Alksndr55/mesh-repeater/audit/s4_12_user_refinements_20261010/README.txt

Результаты финальных проверок S4.12, выполненных в KiCad 10.0.6.
Электрические связи, координаты, измерения и SHA256 сохранены. Абсолютные
пути рабочей машины заменены относительными; путь candidate указывает
на опубликованный идентичный CAD. Историческая baseline S4.11 не входит
в этот пакет. Эти проверки CAD не подтверждают стендовые характеристики.
