Alksndr55/mesh-repeater/docs/WORKFLOW_RU.md

# Единый процесс разработки и выпуска

Ведущая разводка — **v1**. Общая схема содержит электрическую часть обоих
исполнений. Профили сохраняют разъёмы, кнопки, крепёж, распределение по платам
и межплатный интерфейс v2. Геометрия каждой PCB редактируется в её проекте KiCad.

Версии хранятся строками в `project.json`: текущие выпуски —
`v1.26` и `v2.10` от 06.11.2026, следующие номера — `v1.27` и `v2.11`.
Предыдущие опубликованные страницы GitHub: [v1.25](https://github.com/Alksndr55/mesh-repeater/releases/tag/v1.25) и
[v2.09](https://github.com/Alksndr55/mesh-repeater-2.0/releases/tag/v2.09).
Предыдущие v1.22/v2.06 соответствовали S4.22/A6. Следующий выпуск увеличивает число после точки на единицу.
Номера исполнений независимы; общий схемный граф и SHA256 связывают их по содержанию.
Существующие теги S4/A сохраняют историю.

## Изменения

1. Изменить общую схему и ведущую v1, проверить их соответствие.
2. Перенести электрическое изменение в POWER/LOGIC, сохранив UUID существующих
   компонентов. Адаптировать затронутую разводку v2.
3. Согласовать варианты сборки в моделях и нативных полях, сформировать BOM.
   Схемы исполнений сохраняют связь с PCB; синхронизация контролируется проверкой,
   а не скрытой перегенерацией принятых плат.
4. Увеличить версии затронутых исполнений в `project.json`, применить метки,
   повторить проверки и экспорт. PDF/BOM и производственные файлы привязаны к версии.

Разводку изменять по [ROUTING_RULES_RU.md](ROUTING_RULES_RU.md): сначала удалить
все GND-переходы, затем исправить дорожки и убрать дубли, после этого добавить
сетку GND 5 мм с записанными электрическими причинами для исключений.
Расстановку компонентов и критические силовые, Kelvin- и RF-цепи сохранять.

Из корня рабочей папки в PowerShell:

```powershell
$python = 'C:/Program Files/KiCad/10.0/bin/python.exe'
& $python tools/project/set_versions.py --apply
& $python tools/project/build_bom.py
& $python tools/project/verify_circuit.py --out shared/verification
& $python tools/project/release.py build
```

Параметры доступны через `--help`. `set_versions.py` изменяет только метаданные
и надписи версии, включая версию платы и связанный хеш протокола в копиях watchdog.
Без `--apply` команда показывает изменения без записи.
Для `export` и `build` нужен Python из установки KiCad с модулем `pcbnew`,
как в команде выше: он читает исходные площадки для проверки boardview.
`build_bom.py` берёт комплектацию из моделей и координаты из PCB.
`verify_circuit.py` экспортирует свежие netlist и сравнивает их с общей схемой
с учётом явных физических различий. R71 и NT2 не замыкаются ради сравнения.

`release.py` проверяет версии, ERC/DRC, общий граф, BOM, комплект watchdog и разводку,
экспортирует PDF/SVG и два boardview CAD для каждой физической платы, затем собирает
архив с контрольными суммами.
Для watchdog v1.00 проверяются исходник, HEX, версия, fuse-профиль и сохранённый
программный протокол; ISP-профиль плат — 100 мкс, LFUSE=0x73, HFUSE=0xFB.
Эта проверка не программирует устройство и не заменяет стендовые испытания.
Нарушения, неподключения и расхождения схемы с PCB
останавливают выпуск. Для SHIELD проверяется PCB, электросхема неприменима.

## Приёмка разводки

После изменения дорог проверяют целые пути и параллельные группы на обеих
сторонах платы: лишние обходы, возвраты, ступеньки, равномерность зазоров,
сигнальные и земляные дубли, местные возвраты и исключения сетки GND.
Нулевой DRC и уменьшение числа сегментов не подтверждают выполнение этих условий.

В каталоге каждой PCB хранится `routing_review.json`: результат проверки обеих
сторон, текущая версия, SHA256 точного PCB и индивидуальный журнал внесеточных
GND-переходов. Сначала применяют окончательные метки версии, затем фиксируют
результат проверки. После изменения файла старое подтверждение недействительно.
`set_versions.py` не переносит одобрение автоматически на изменённую плату.

Проверка выпуска независимо пересчитывает углы, коллинеарные наложения,
повторные переходы и позиции относительно сетки, сверяет весь журнал и
подтверждение. Эти геометрические нарушения не разрешаются записью PASS.
Полные пути и зазоры групп оцениваются отдельно; геометрическая проверка
не объявляется автоматическим доказательством эстетики или RF/EMI.
Регрессионные проверки: `python -m unittest discover -s tools/project/tests -v`.

В протоколе отдельно подтверждаются заходы на площадки и стыки трасс,
подключения к GND-полигону и фактические термобарьеры. Массив
`retained_ground_tracks` перечисляет все оставшиеся GND-дорожки с точной
геометрией и индивидуальной причиной; `solid_ground_connections` — все
явные сплошные подключения площадок и зон GND. Проверка выпуска сверяет
эти списки с PCB. Настройка thermal сама по себе не доказывает наличие
термобарьера: при визуальной приёмке включают заполненные полигоны.

## Файлы выпуска

- `v1/output/current/`, `v2/output/current/` — актуальные экспорты.
- `v1/audit/current/`, `v2/audit/current/` — проверки с хешами исходников.
- `releases/v1.26/`, `releases/v2.10/` — ZIP текущих выпусков и SHA256 после сборки.
- `history/` — ограниченный снимок до объединения, происхождение и журнал уборки.

Архив включает редактируемые проекты, нужные локальные библиотеки и модели,
общую схему, BOM, инструкции, лицензии и проверки. Gerber/Excellon создаются
отдельно по текущему CAD и требованиям выбранного заказа.

Все 3D-модели, включая используемые стандартные модели KiCad, находятся внутри
нативных проектов. Пути в PCB и используемых посадках относительные, от
`${KIPRJMOD}`. Непоставленная модель или внешний путь `${KICAD...}` блокируют
сборку архива. После распаковки модели должны разрешаться без глобальной
библиотеки 3D на компьютере получателя; исходные лицензии и атрибуция сохраняются.

По решению владельца от 06.11.2026 в каждую следующую сборку v1/v2 входят
по два boardview `.cad` каждой физической платы: MAIN, либо POWER/LOGIC/SHIELD.
Варианты — `NaIon_COLD` (натрий, основная сборка с COLD-защитой) и `LTO_2S`.
Файлы находятся в `<версия>/output/current/<плата>/Mesh_Repeater_<номер>_<плата>_<вариант>.cad`,
рядом — `<плата>_<вариант>_boardview.json` с хешами PCB, модели комплектации, CAD
и результатами проверки.
Путь `<версия>` означает каталог `v1` или `v2`, `<номер>` — например `v1.26`.

Формат — GenCAD, единицы THOU: дюймовая запись INCH некорректно отображается
в NexusBV 0.9. Сохраняются реальные координаты, стороны, повторяющиеся номера
контактов и цепи из текущей PCB. Номиналы/маркировки и признаки установки берутся
из соответствующего варианта `model.json`, сверенного с BOM в проверке выпуска.
Неустановленные детали помечаются `DNP`; их контактные площадки не удаляются.
SHIELD — общая механическая плата, поэтому его геометрия одинакова в обоих вариантах.
Объекты только паяльной пасты не становятся электрическими контактами.
Экспорт проверяется по исходной PCB; ошибка или отсутствие CAD/протокола
останавливает упаковку. При изменении экспортёра или просмотрщика дополнительно
проверяют обе стороны в программе: численная проверка не доказывает отображение.

Для просмотра: NexusBV → File → Open. Номинал виден в Info при наведении
и в карточке выбранного компонента; Top / Bottom переключают стороны.
Для перекрёстного поиска нажмите PDF в NexusBV и откройте `<плата>_schematic.pdf`
из того же каталога. Двойной щелчок по телу символа, позиционному обозначению
или имени цепи в PDF находит объект на плате. Надписи внутри символа сохраняют
собственный поиск: для выбора детали нажимайте по свободной области её тела.
PDF содержит общую схему; номиналы/FIT конкретной
химии берутся из соответствующего CAD и BOM. У механического SHIELD схемы нет.
Обновление процесса не изменяет уже опубликованные архивы и теги.

В комплект v1/v2 также входит portable NexusBV 0.9 для Windows 10/11 x64.
После полной распаковки ZIP запустите корневой `START.cmd` и выберите плату
и химию. Файлы `START_<плата>_<вариант>.cmd` открывают выбранный CAD и PDF
напрямую; у SHIELD открывается только CAD. Установка просмотрщика и KiCad
для этого не нужна. Исходные авторские readme и сведения о программе сохранены.
Программа хранится в `third_party/NexusBV/0.9`, состав зафиксирован в
`bundle_manifest.json`: размер и SHA256 каждого файла проверяются до выпуска.
В поставку не переносятся пользовательские настройки, история, базы и
неиспользуемые для GenCAD/PDF конвертеры Cadence. Все файлы программы и запуска
также входят в общий `RELEASE_MANIFEST.json`.

При экспорте схем `release_pdf.py` добавляет невидимые области выбора по геометрии
символов исходной схемы. Пины и провода в область тела не включаются. Каждый PDF
до и после сравнивается постранично при 144 dpi через PDFium из комплекта NexusBV;
изображение должно совпадать. Проверяются координаты и текст каждого обозначения.
Отчёт `<плата>_pdf_clickmap.json` привязан к хешам PDF и всех листов схемы;
без свежего успешного отчёта архив не собирается. Неизвестная геометрия или
пересечение областей останавливает экспорт. Для сборки этого комплекта требуется
Windows x64; чистая Python-зависимость pypdf поставляется с её лицензией в
`tools/project/vendor`, дополнительная установка библиотек не требуется.

Два Git-репозитория находятся непосредственно в `v1/` и `v2/`; история и адреса
сохранены. Отдельная публикационная копия v1 устранена. Публикация на GitHub —
отдельное явное действие. Обычная сборка не делает push и не размещает заказ.
Стендовые проверки питания, LC, RF, нагрева и конкретных модулей ведутся отдельно.
