Alksndr55/mesh-repeater/design/Meshcore_NaIon/3dmodels/README_RU.txt

АКТУАЛЬНО ДЛЯ S4.15 — 11.10.2026
Добавлена ориентировочная модель TDK_B57861S_Vertical_Approx.step для TH1.
Тело NTC диаметром до 2,41 мм и длиной до 6,5 мм находится внутри SH1.
Высота над платой — до 12,5 мм, внутренняя высота крышки — 14 мм.
Формованные гибкие выводы: шаг площадок 2,54 мм; не менее 4,5 мм прямого
вывода от тела до первого изгиба; радиус изгиба не менее 0,75 мм.
Нижние изгибы модели упрощены; STEP не служит шаблоном формовки выводов.
Проверить высоту и механическую фиксацию реального датчика перед сборкой.
Устанавливать один датчик: на плату ИЛИ выносной на проводах в те же площадки.
Общий отчёт: output/S4_15_COLD_CHARGE_RU.html.

ИСТОРИЯ МОДЕЛЕЙ (сведения о числе деталей ниже относятся к старым ревизиям)
АКТУАЛЬНО ДЛЯ S4.5
В S4.5 добавлены четыре резервных места C52–C55 с библиотечными моделями
1206. Эти позиции DNP: в основной сборке не устанавливаются. Актуальный
вид с пустыми резервами: output/pcb/S4_5_3D_components.png. Всего 110
привязок моделей, включая четыре необязательных конденсатора.
Отчёт: output/S4_5_RESERVE_AND_SCHEMATIC_RU.html.

СВЕДЕНИЯ О ПРЕДЫДУЩЕЙ РЕДАКЦИИ S4.4
Модели, созданные для S4.3, сохранены в S4.4 без изменения корпусов
и положения компонентов. В S4.4 исправлены BUSY/GPS_EN и надписи.
Новые виды: output/pcb/S4_4_3D_components.png, S4_4_3D_frame.png,
S4_4_3D_covered.png. STEP-сборки: output/3d/Meshcore_S4_4_components.step
и Meshcore_S4_4_covered.step. Отчёт: output/S4_4_FAKETEC_COMPATIBILITY_RU.html.
Пути указаны относительно корня рабочей папки Meshcore.

Ниже сохранено описание создания моделей в S4.3 и их допущений.

MESHCORE S4.3 — МОДЕЛИ СОБРАННОЙ ПЛАТЫ
09.10.2026

Созданы и подключены 12 файлов STEP. Модели есть у всех 103 позиций,
имеющих физический корпус. Всего 106 подключений моделей: у держателя
есть батарейка, у J11 — съёмный шунт, у экрана — отдельная крышка.
Отверстия H1–H4 и шесть плоских тестовых площадок дополнительных
корпусов не требуют: они уже отображаются как геометрия самой платы.

Добавлены Nice!Nano-клон, HT-RA62, L1–L4, TPS63802, R40/R41, SW1/SW2,
рама и крышка экрана. Также добавлены CR2032 и шунт J11.
Модели находятся в design/Meshcore_NaIon/3dmodels; ссылки относительные
через KIPRJMOD. Стандартные детали используют установленную библиотеку
KiCad 10. Сохраняйте и переносите папку проекта целиком.

ОТКРЫТИЕ
Откройте актуальную Meshcore_NaIon.kicad_pcb и нажмите Alt+3.
Если она уже была открыта, загрузите файл с диска заново.
По умолчанию рама видна, крышка скрыта. Для показа крышки откройте
свойства SH1 → 3D-модели и включите Shield_Lid_76x43.step.
Для просмотра силовых компонентов можно скрыть обе модели SH1.

ТОЧНОСТЬ И ДОПУЩЕНИЯ
Это упрощённые инженерные модели для визуализации, не сертифицированные
модели производителей. Размеры стандартных недостающих корпусов взяты
из чертежей; мелкие скругления, маркировка и внутренняя конструкция
упрощены. Имеющиеся типовые библиотечные модели также не подтверждают
точную геометрию каждого закупаемого MPN.

Nice!Nano: использован похожий клон ICBbuy 17,78 × 33 мм с 26 выводами.
Точный модуль по ссылке Ozon не измерен. Приняты толщина PCB 1 мм,
высота нижней стороны модуля над основной платой 6,5 мм и условная
геометрия разъёмов. В этой модели USB направлен к краю, но его передняя
плоскость примерно на 1 мм внутри контура основной платы. Доступ кабеля
и размер отверстия корпуса требуют проверки на вашем модуле.

HT-RA62: подтверждены PCB 16 × 17 × 0,8 мм и шаг выводов 2 мм.
Высоты и положение установленных деталей/IPEX приблизительны, взяты
по изображению производителя. Собственного металлического экрана нет.

Экран: проектная рама с расстояниями между средними линиями стенок
76 × 43 мм, стенка 0,2 мм, наружный размер 76,2 × 43,2 мм.
Нижняя поверхность крышки находится на высоте 14 мм; крышка 0,2 мм.
Фиксаторы и технологические допуски пока не разработаны.

Батарейка CR2032 показана плюсом вверх, нижняя плоскость на Z=1,2 мм.
Посадка выбрана по геометрии библиотечного держателя: над пластиковым
дном остаётся 0,1 мм. Небольшое пересечение с недеформированными
пружинными контактами допустимо для этого условного вида. Размер
посадки из даташита не подтверждён. Шунт J11 условный, с открытым верхом.
J11 показана установленной для питания от батареи/солнца. Снять ДО USB.

ПРОВЕРКИ
Все 12 сгенерированных STEP повторно открыты и проверены на корректность
геометрии. Все ссылки на 3D-модели разрешаются. Сравнение CAD до и после
подтвердило совпадение дорожек, переходных отверстий, площадок, цепей,
положений компонентов, контура, надписей и заливок. Кроме узлов model,
содержимое платы не менялось. Изменение контрольной суммы связано с 3D.
Это дополнение не закрывает оставшиеся испытания и замечания аудита.

ФАЙЛЫ
Актуальная плата: design/Meshcore_NaIon/Meshcore_NaIon.kicad_pcb
Модели: design/Meshcore_NaIon/3dmodels/
Вид без экрана: output/pcb/S4_3_3D_components.png
Вид с рамой без крышки: output/pcb/S4_3_3D_frame.png
Вид с экраном: output/pcb/S4_3_3D_covered.png
STEP без экрана: output/3d/Meshcore_S4_3_components.step
STEP с экраном: output/3d/Meshcore_S4_3_covered.step
Подробные источники и допущения: design/Meshcore_NaIon/3dmodels/manifest.json
Доказательства проверки: audit/s4_3_3d_20261009/

SHA256 актуальной платы: c08b333a8556d93baddc21c304ab620b61b488c69631327ef87d604eef049b0f
