Alksndr55/mesh-repeater/docs/LIMITATIONS_RU.md

# Ограничения Mesh Repeater v1.25 / v2.09

Редакция 30.10.2026 для текущих локальных выпусков. Общая электрическая схема находится в
[`shared/schematic`](../shared/schematic/MeshRepeater.kicad_pro); ведущая схема и
разводка - v1. Различия корпусов, крепежа и межплатных соединений заданы в
[`shared/variants.json`](../shared/variants.json). Номиналы и порядок сборки:
[`ASSEMBLY_COMMON_RU.md`](ASSEMBLY_COMMON_RU.md).

Этот документ сохраняет аппаратные ограничения при объединении документации.
Он не сообщает о новых испытаниях. ERC, DRC и сравнение схем подтверждают только
проверенные CAD-файлы с их SHA-256. Устойчивость питания, восстановление после
разряда, температурные режимы, реальные разъёмы, RF/EMI и конкретные модули
требуют проверки собранного образца. Приёмка ограничений не означает их устранение.

## Питание, заряд и аккумуляторы

| Узел | Сохранённое состояние и граница подтверждения |
|---|---|
| CN3722 | R3/R4: 60,4/100 кОм для Na-ion, 118/100 кОм для LTO, 1%. Типовые CV 3,878/5,273 В; верхние расчётные оценки 3,982/5,452 В при принятых допусках CN3722, резисторах 1%, ТКС ±100 ppm/°C и ΔT=65°C. Это установившийся режим; выбросы, старение и отказы в эти оценки не входят. |
| LTO и TPS63802 | Рабочий верхний предел входа TPS63802 - 5,5 В. Независимой OVP нет. Работа LTO без батареи, при её горячем отключении и снятии нагрузки не квалифицирована; расчёт делителя CN3722 не гарантирует ограничение всех этих режимов. |
| Балансиры LTO | LMV431A с R47/R51=2 Ом сохранены. Допустимый ток LMV431A не гарантирован на всех углах напряжений, допусков и температуры. Усилитель балансира и независимая защита ячеек не добавлены. При равномерном заряде до нового CV оба балансира не обязаны включаться; их работа при перекосе требует проверки. |
| Разряд и EN | EN измеряет BAT до R71 и напряжение всего пакета. Типовые пары OFF/ON: около 1,806/1,986 В для Na-ion и 3,606/3,966 В для LTO. Это номиналы, а не гарантированные пределы при 1%. Общий порог LTO не защищает каждую ячейку независимо. |
| Возврат после разряда | R71 снижает BAT_SYS на входе преобразователя; ESR аккумулятора/проводов влияет также на BAT и EN. Однократный пуск с заряженными и разряженными LC-банками, TX/GPS-нагрузкой и холодной батареей не доказан. Возможность циклов EN/UVLO проверяют по фактическим ячейкам, их ESR и пусковому току. |
| Солнечная панель | R7/R8=100/10 кОм, типовая настройка MPPT около 11,44 В при 25°C. Обозначение «панель 12 В» не задаёт её холодный Voc, Vmp и выбросы. Нужны паспорт конкретной панели, проверка полярности и допустимых напряжений входного узла. |
| COLD | Схема снижения тока сохранена. NTC на плате измеряет местную температуру; она может отличаться от температуры ячейки. Нужны фактические пороги, токи и разрешённые изготовителем аккумулятора условия заряда. Один TH1 на плате либо один выносной датчик, а не два параллельных NTC. |

J8 и J12 имеют общую BAT; они не являются двумя независимыми входами батарей.
Фактические пределы заряда/разряда, токи, разбаланс и температуры выбирают по
паспорту конкретных ячеек. Сохранённая схема LTO не является полноценной BMS.

## USB и распределение питания

J11 - единственное съёмное соединение FILTER_OUT с нагрузками. Снять шунт
**до подключения USB**, вернуть **после отключения USB**. Автоматического
переключения источников нет. Клон Nice!Nano должен быть доработан для прямого
питания 3V3/VCC, с отключённой штатной USB-зарядкой; основной аккумулятор к его
RAW/BAT не подключают. Название клона в BOM само по себе не подтверждает доработку.

При снятой J11 USB питает SYS, INA219 и модем через медную звезду NT2; это полная
нагрузка устройства, включая возможные TX/GPS. Выход преобразователя изолирован,
но его вход остаётся связан с зарядником через BAT_SYS. Требуются проверка
реального USB/LDO клона, обратных токов, нагрева, токового бюджета и напряжений
MCU/модема. CR2032 при отсутствии основного питания и USB резервирует только RTC.

Раздельные ветви SYS_3V3 и RADIO_3V3, FB1 и локальные C23/C24 являются мерами
развязки, а не гарантией отсутствия общей просадки. Проверять одновременно VCC
MCU и модема при TX, GPS и USB. Рабочий возврат в v2 обеспечивают земляные контакты
J101/J201; работоспособность не должна зависеть от проводимости стоек.

## LC-фильтр, измерения и программная часть

- C15/C16: по одному Panasonic EEEFK1E471P, 470 мкФ / 25 В / ±20%.
  Начальный минимум по допуску при 20°C - 376 мкФ. Это не гарантирует такую
  ёмкость на морозе или после старения. Паспортный импеданс 80 мОм при 100 кГц
  не равен точному ESR. R40/R41=22 мОм остаются в конденсаторных ветвях.
  Пуск, PFM/PWM, импульсы TX, звон, холодный ESR, нагрев и EMI требуют измерений.
- BAT_ADC: R27/R28=2,2 МОм, C25=100 нФ, деление 1:2, номинальная τ≈0,11 с.
  Нужны время установления, оценка утечек/входа ADC и калибровка конкретного клона;
  у v2 дополнительно влияет падение GND межплатных контактов. Требование 1%
  заменило прежние 0,1%; старые оценки точности ADC/EN/балансиров не являются
  гарантированными пределами текущей схемы.
- INA219AIDR имеет адрес 0x40 и питается от SYS после J11, включая USB-режим.
  Паспортная оценка непрерывного потребления - около 0,7 мА типично, до 1 мА;
  это дополнительная постоянная нагрузка. Управление его питанием и программный
  режим экономии этим аппаратным проектом не подтверждены.
- R71=0,1 Ом ±1%, 1 Вт, 2512, RL2512FK-070R1L выбран для штатной калибровки.
  При 0,8 А расчётные падение/мощность - 80 мВ/64 мВт; при принятой оценке
  1,25 А - 125 мВ/156 мВт. ТКС выбранного шунта ±600 ppm/°C, пайка и Kelvin-отводы
  влияют на точность. Диапазон INA ±320 мВ соответствует примерно ±3,2 А;
  длительные 4 А дали бы 1,6 Вт и не квалифицированы для этого шунта.
- IN+ измеряет BAT_SYS через R72, IN− - BAT через R73: заряд положительный,
  разряд отрицательный. Регистр мощности не даёт подписанную мощность
  заряда/разряда. Балансиры LTO, делитель EN и BAT_ADC подключены до R71;
  INA219 не измеряет полный расход отдельных ячеек и все малые утечки.
  Калибровку и отображение конкретной прошивки проверяют на образце.
- Watchdog ATtiny13A v1.00 считает 1350 периодов настройки WDT «8 s»;
  по типовым графикам при 3,3 В и комнатной температуре это около 3,53 ч,
  импульс настройки «1 s» — около 1,18 с. Сохранён согласованный допуск
  3 ч ±30%; эти ориентиры не являются измерением или гарантией генератора.
  Новый TXEN перезапускает счётчик и фазу WDT; постоянный HIGH без новых
  изменений входа не продлевает отсчёт. Исправлена потеря события после
  отпускания сброса. Штатное молчание MeshCore также может вызвать сброс.
  LFUSE=0x73/HFUSE=0xFB включает постоянный BOD 2,7 В, в том числе во сне;
  он контролирует SYS_3V3 и сбрасывает ATtiny, отпуская PB0, а не удерживая MCU
  в reset. Входной RC-конденсатор 10 нФ из отдельного проекта не установлен;
  C33 — развязка питания. Программный протокол 19/19 относится к совпадающим
  исходнику и HEX, но не подтверждает реальные короткие TXEN, времена,
  восстановление MCU/модема, пуск, просадки и ток сна. WDT работает в режиме
  прерываний и не гарантирует восстановление самого зависшего ATtiny.
- Для GPS сохраняется порядок платы: J4.6=SYS_3V3 для резерва,
  J4.7=управляемое GPS_3V3; RX/TX и направление нумерации сверять по схеме.
  Это не подтверждение распиновки любого аксессуара T114: необходимы точный GPS,
  кабель, ответный PicoBlade и проверка обоих питающих контактов 6/7.
- FL1=S869M000S003 - опция 868–870 МГц с ограничением TX≤+13 dBm; штатно DNP,
  NT1 целая. Установка требует разрезания NT1, проверки обхода и измерения потерь.
  Диапазон HT-RA62, антенна и прошивка должны соответствовать друг другу.
  NT2 - другая, постоянная медная звезда питания; её не разрезают.
- Точная диапазонная версия HT-RA62 и MPN C58/C59=47 нФ X7R 16 В остаются
  не выбранными в исходных полях. Требования к сопротивлению, допуску, ТКС,
  мощности и корпусу нельзя заменять старой ценой или неподтверждённым остатком.

## Механические ограничения v2

Эти условия относятся к POWER/LOGIC/SHIELD, а не к одноплатной v1.

- Рабочие платы и экран - 90×60 мм; LOGIC повёрнута компонентами вниз.
  J201 имеет зеркальную сетку для сопряжения 1:1. Обычная незеркальная розетка
  не является её взаимозаменяемой заменой.
- Выбраны E-SIMPO L35mm A3C6 и MTJ H8.5 2×6P, шаг 2,54 мм. Номинальный ввод
  штырей - 4,48 мм. Сечение/покрытие штыря, допуски розетки и рабочая глубина
  сопряжения требуют контроля купленных деталей. Расчётный бюджет 0,5 А не
  является измеренным профилем; каждый основной контакт должен выдерживать
  соответствующий ток. Рейтинг 3 А одной розетки и параллельные контакты не
  квалифицируют соединение целиком.
- Окно экрана под общую пластиковую планку - 17,2×6,8 мм, R0,6;
  минимальный проектный отступ меди - 0,50 мм. Максимальный габарит реального
  пластика документально не подтверждён. Проверить проход, прямолинейность
  штырей и изоляцию от фольги; не стягивать несовпадающие платы винтами.
- Номинальная цепочка: стойки 18/15 мм, металлические шайбы DIN 433
  3,2×6×0,5 мм; в исходном согласованном стеке 20 шайб. Внутренние промежутки
  18,5/16,0 мм, между рабочими поверхностями 36,02 мм, между наружными
  поверхностями рабочих PCB 39,06 мм без головки винта и нижней гайки.
  Глубина резьбы верхней стойки и часть размеров нижней требуют входного
  контроля: зацепление верхнего соединения ≥3 мм, полное зацепление нижней
  гайки и отсутствие упора в дно резьбы проверяют на фактическом крепеже.
- Для электролитов высотой 10,2 мм требуется 12,8 мм с допусками и местом над
  клапаном; при доступных 18,5 мм номинальный запас 5,7 мм. Для сформованного
  TH1 высотой ≤12,5 мм нижний запас 6,0 мм. Это расчёт номинальных размеров;
  реальная посадка, клапан, пайка, модули и доступ к USB/шунту проверяются на образце.
  У v1 собственный корпус также должен обеспечивать место над электролитами.
- SHIELD имеет медь F.Cu к POWER и единую GND-плоскость вокруг окна;
  буквы в стеклотекстолите не вырезают. SH1 и прежняя крышка отсутствуют.
  Измеренная эквивалентность экранирования после удаления стенок не заявляется.
  J10 сохраняет прежнюю позицию; обслуживание ISP после разборки принято намеренно.

## Какие доказательства относятся к текущей версии

Для нового выпуска используются только свежие ERC/DRC/паритет и отчёт сравнения
общей схемы с соответствующими хешами исходников. Нулевые пересечения старых
сборочных STEP A3/A4 не доказывают геометрию нынешних электролитов. В исторических
STEP фиксировались предупреждения self-interference меди; STEP не заменяет
проверку электрических соединений по native KiCad. Исторические pass-счётчики,
количество деталей и результаты старых ревизий сюда не перенесены.

Старые отчёты сохранены как история в Git/резервном снимке перед объединением;
они не являются протоколами нынешних измерений. Включение, холод, переходные
процессы, RF/EMI, фактическое сопряжение и автономное восстановление считаются
неподтверждёнными до отдельного протокола испытаний конкретной сборки.
