Alksndr55/mesh-repeater/docs/ROUTING_RULES_RU.md

# Правила дорожек и земляных переходов

Приняты владельцем 29 октября 2026 для v1 и v2. Ведущая разводка — v1.
Рабочая основа — текущие нативные платы Meshcore. Перед изменением сохраняются
исходные файлы и контрольные суммы; отдельные локальные правки владелец исключил
из текущего задания.

Порядок обязателен:

1. Удалить все GND-переходы, сохранить промежуточный PCB и подтвердить нулевой счётчик.
2. Обработать дорожки при свободном от земляных переходов пространстве.
   Применять прямые участки и направления 0/45/90 градусов. Убирать лишние
   ступеньки, возвраты, короткие изломы и лишнее дробление связной трассы.
   Параллельные участки одной группы вести с равномерным зазором по правилам
   платы; учитывать неизбежные сужения у выводов и геометрию площадок.
3. Устранить дубли, наложенные коллинеарные сегменты и лишние параллельные
   пути как сигналов, так и GND. Убирать потерявшие назначение подводы к
   удалённым переходам. Целенаправленные силовые пути и локальные возвратные
   токи оцениваются отдельно: сплошная земля не отменяет требований к ним.
4. Перезалить полигоны и разместить GND-переходы по сетке **5×5 мм** с началом
   в координатах **0,0 платы**. Точка сетки используется, если переход допустим
   по зазорам и связывает нужную медь. Недопустимая точка пропускается.
5. Сдвиг от сетки разрешён только по электрической необходимости: подключение
   изолированного участка, короткий возврат быстрого узла, RF-ограждение или
   близкий возврат развязывающего конденсатора. Для каждого такого перехода
   фиксируются координаты, назначение и причина. Простое совпадение со старой
   позицией причиной не является.

Сохраняются расстановка, стороны и повороты деталей, UUID, площадки, контур,
отверстия, маркировка, маска, ширины силовых трасс и действующие правила.
Сохраняются RF CPW и его зазор, Kelvin-подводы R71/R72/R73, обход NT1,
звезда NT2 и раздельные SYS/RADIO, короткие коммутационные контуры преобразователей.
Компоненты не перемещаются ради облегчения маршрутизации.

Приёмка: свежий DRC с перезаливкой, всеми ошибками дорожек и сопоставлением
со схемой; ноль нарушений, неподключений, расхождений и скрытых проверок.
Дополнительно проверяются геометрия и дубли, сетка и её исключения, сохранность
деталей и графики, общая схема, BOM и состав watchdog. Проверка углов допускает
только округление до 1 нм в координатах KiCad. Изображения меди до и после
сохраняются вместе с отчётом.

SHIELD остаётся однослойным экраном без электронной разводки и без новых GND-vias.
Его механика и итоговый DRC также проверяются.

Полные параллельные группы проверяются по перпендикулярному зазору с учётом
ширины дорожек, включая повороты. Короткие выводы от фиксированных площадок
и обходы реальных препятствий фиксируются отдельно от регулярной магистрали.

При сведении дублирующих соседних силовых подводов к одной площадке в один
не уменьшается их суммарное сечение; основные силовые магистрали не сужаются.
Точки и геометрия измерительных Kelvin-подводов сохраняются независимо.

В модели земли учитываются реальные контакты полигон–полигон разных GND-зон.
Причина «соединение островка» проверяется нативной связностью и, где необходимо,
удалением перехода с повторным DRC. Один только транзитивный GetConnected или
пропуск пересечений полигонов не доказывает наличие островка.

Проверяются не только направления отдельных сегментов, но и угол их стыка:
две дорожки с направлениями 0/45/90 могут образовывать острый разворот.
Заходы на площадки делают прямыми и понятными; удаляют короткие возвраты,
выступы за точкой подключения и несколько перекрывающихся подходов.

Обычные GND-контакты подключают к полигону через термобарьеры. Проверяют
фактическую заполненную медь: дорожка поверх зазора может шунтировать
термобарьер даже при правильной настройке зоны. Сплошные подключения RF,
механического экрана или критического силового возврата обосновывают отдельно
для каждой площадки/зоны. Общая пометка «локальный возврат» не является
достаточным обоснованием всех земляных дорожек.

Каждая сохранённая GND-дорожка и каждое явно сплошное подключение записываются
в `routing_review.json` с UUID и индивидуальной причиной. Перед принятием
проверяют контакты площадка–полигон, отсутствие лишних обходов, фактические
термобарьеры и непрерывность необходимых возвратов после перезаливки.
