Alksndr55/mesh-repeater/output/pcb/S4_16_shield_detail.png

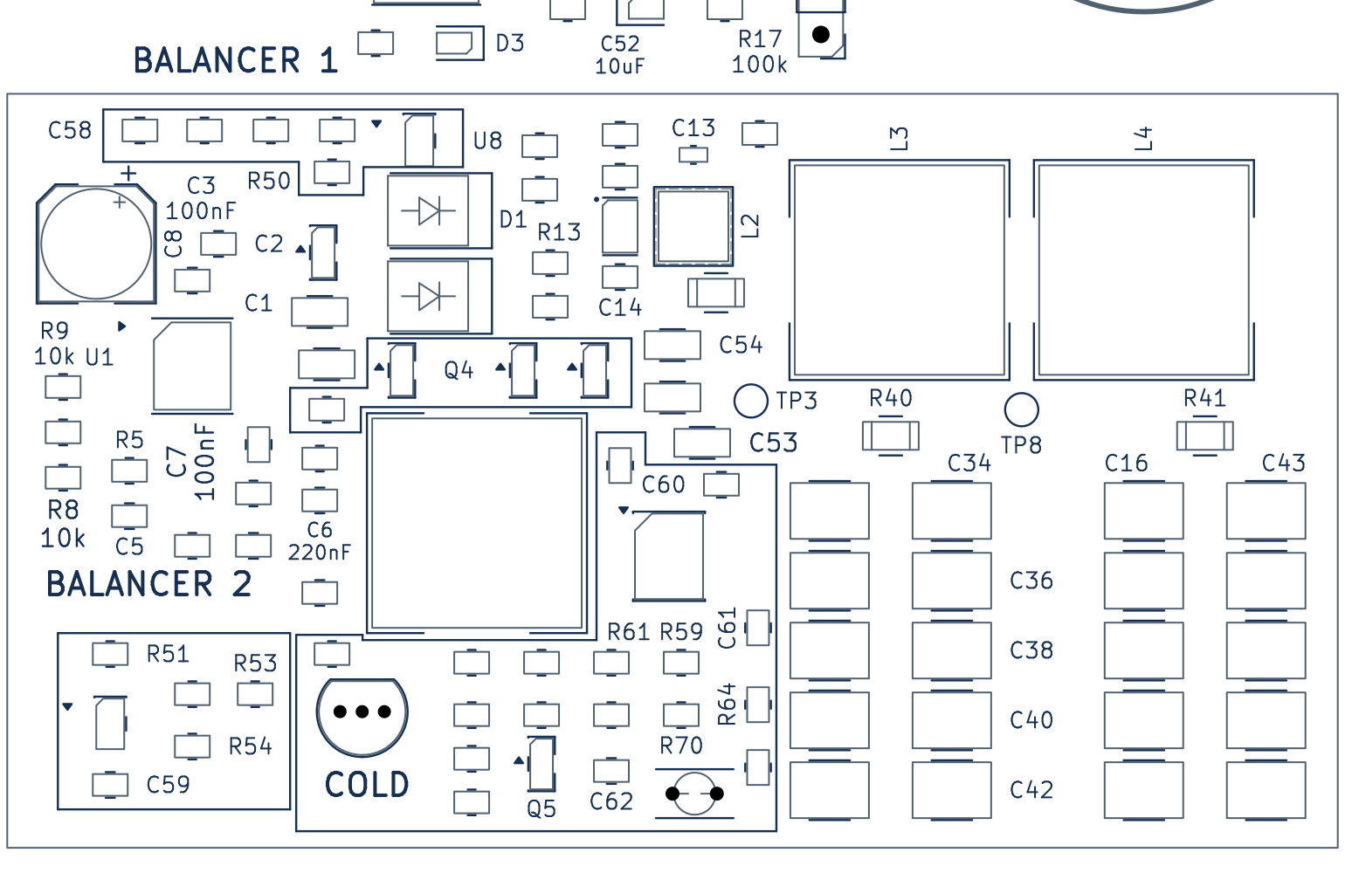
output/pcb/S4_16_shield_detail.png
