Alksndr55/mesh-repeater/output/pcb/S4_16_top_copper.png

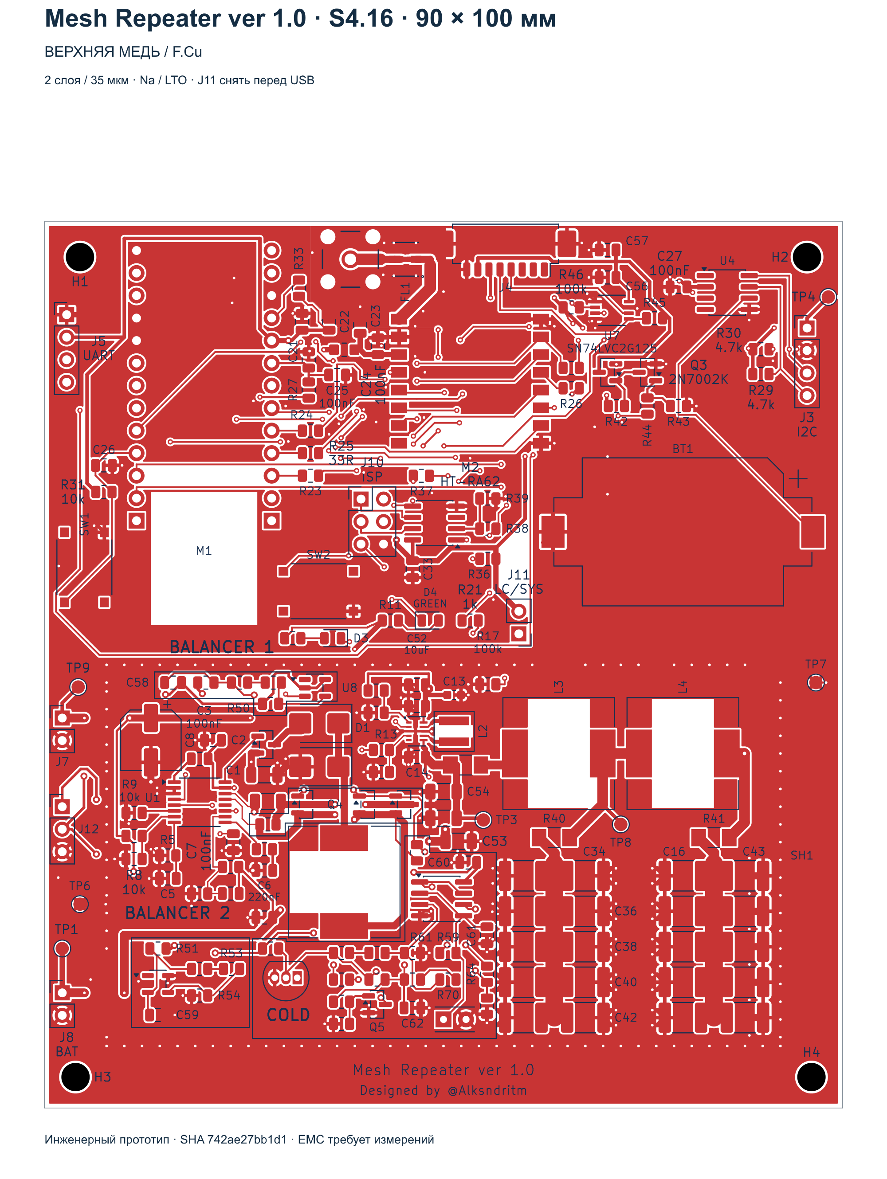
output/pcb/S4_16_top_copper.png
