Alksndr55/mesh-repeater/docs/S4_21_REZONIT_ORDER_RU.txt

Mesh Repeater ver 1.0 — PCB S4.21
Данные для заказа голых плат в «Резонит», 18.10.2026

Загружать файл: Mesh_Repeater_S4_21_Rezonit_Gerber.zip.
Внутри только 9 файлов в корне, без вложенных папок:
  F.Cu / GTL — верхняя медь
  B.Cu / GBL — нижняя медь
  F.Mask / GTS — верхняя паяльная маска
  B.Mask / GBS — нижняя паяльная маска
  F.SilkS / GTO — верхняя маркировка
  B.SilkS / GBO — нижняя маркировка
  Edge.Cuts / GKO — замкнутый контур платы
  PTH.drl — металлизированные отверстия
  NPTH.drl — неметаллизированные отверстия

Формат Gerber: RS-274X. Сверловка: Excellon, миллиметры, десятичный формат.
Оба экспорта используют общий абсолютный ноль (0;0), без зеркалирования Y.
Нижние производственные слои отдельно зеркалировать не нужно.
В заказ не загружать PDF, проект KiCad, чертежи, изображения или Gerber Job.

Ранее согласованные параметры заказа:
  Количество: 5 шт.
  Размер одной платы: 90 x 100 мм, прямоугольник.
  Проводящих слоёв: 2.
  Материал и стандартная готовая толщина: FR4, 1,5 мм.
  Медь: 35 мкм с каждой стороны.
  Паяльная маска и маркировка: с обеих сторон.
  Изготовление: только платы, без монтажа компонентов и трафарета.
  Контур: одиночная плата, без пользовательской панели и V-cut.
  Цвет маски/маркировки и покрытие площадок: выбрать при оформлении заказа.

Исходная плата SHA-256:
  be14cae202912ebb00e5dc758b2eae04cbe6733d4cb73df00044fdb03670fab3
Gerber ZIP SHA-256:
  66ff10019797c06d933701a87469de96b19dc2ca4b960956b7c474ea98466e93

SH1 и TP6 отсутствуют по согласованной редакции S4.21.
Gerber S4.20 и более старые файлы не использовать для этой платы.
Архив сформирован из сохранённого проекта; проект экспортером не изменён.
Заказ и оплата в личном кабинете этим выпуском не выполняются.

Инструкция производителя (проверена в Firefox 18.10.2026):
https://www.rezonit.ru/directory/v-pomoshch-konstruktoru/instrukcii-po-eksportu-gerber-dannyh/eksport-iz-kicad/

Проверки ERC/DRC и геометрии CAM не заменяют измерения прототипа под
нагрузкой, проверку аккумулятора, теплового режима и EMI.

Лицензия и разрешение на изготовление:
Собственные материалы проекта: CC BY-NC-SA 4.0. Правообладатель дополнительно
разрешает заказ и платное изготовление этих плат для личной некоммерческой
сборки, включая оплату услуг изготовителя и передачу заказных плат заказчику.
Коммерческий выпуск и продажа плат, наборов или готовых устройств с использованием наших
лицензируемых материалов — только с предварительного письменного разрешения
Alksndr55. Сторонние лицензии сохраняются. Полный охват и условия: ../LICENSE.md
https://github.com/Alksndr55/mesh-repeater/blob/main/LICENSE.md
Производственный ZIP остаётся прежним: только 9 файлов, без добавления лицензий.
