Alksndr55/mesh-repeater/bom/shopping.csv

Reference | Value_NaIon | Value_LTO_2S | Fit_NaIon | Fit_LTO_2S | MPN_NaIon | MPN_LTO_2S | Value_NaIon_NoCold | Fit_NaIon_NoCold | MPN_NaIon_NoCold | Footprint | Assembly | Vendor_URL | Package | PreferredSource | ProcurementNote
U1 | CN3722 | CN3722 | yes | yes | CN3722 | CN3722 | CN3722 | yes | CN3722 | Meshcore:TSSOP-16_4.4x5mm_P0.65mm | Na-ion: FIT; LTO 2S: FIT |  | TSSOP-16_4.4x5mm_P0.65mm | Supplier not selected; stock not refreshed
Q1 | AO3401A | AO3401A | yes | yes | AO3401A | AO3401A | AO3401A | yes | AO3401A | Meshcore:SOT-23 | Na-ion: FIT; LTO 2S: FIT | https://www.danomsk.ru/shop/4-tranzistory/126-tranzistory-importnye/168774-ao3401a-sot23-p-kanal-30v-4a-1-4vt-a-o/ | SOT-23 | Danomsk | Only AOS-qualified part, not an unreviewed same-name substitute. Cold panel Voc<=24V. Danomsk S4.6 approved substitution. Выбрана именно карточка AOS/A&O, соответствующая исходной детали.
D1 | SS24 | SS24 | yes | yes | SS24 | SS24 | SS24 | yes | SS24 | Meshcore:D_SMB | Na-ion: FIT; LTO 2S: FIT | https://www.danomsk.ru/shop/3-diody-i-tiristory/451-diody-shottki/113168-ss24-smb-do-214aa-diod-shottki-40v-2-a-0-7v-mic/ | D_SMB | Danomsk | Series reverse blocking diode Danomsk S4.6 approved substitution. Доступный местный Schottky 40 В / 2 А. Отличие SMB от текущего SMA не препятствует будущей замене с переразводкой.
D2 | SS24 | SS24 | yes | yes | SS24 | SS24 | SS24 | yes | SS24 | Meshcore:D_SMB | Na-ion: FIT; LTO 2S: FIT | https://www.danomsk.ru/shop/3-diody-i-tiristory/451-diody-shottki/113168-ss24-smb-do-214aa-diod-shottki-40v-2-a-0-7v-mic/ | D_SMB | Danomsk | Danomsk S4.6 approved substitution. Доступный местный Schottky 40 В / 2 А. Отличие SMB от текущего SMA не препятствует будущей замене с переразводкой.
L1 | 100uH | 100uH | yes | yes | CDRH127/LDNP-101MC | CDRH127/LDNP-101MC | 100uH | yes | CDRH127/LDNP-101MC | Meshcore:L_Sumida_CDRH127_LDNP_101MC | Na-ion: FIT; LTO 2S: FIT | https://www.danomsk.ru/shop/8-ustanovochnye/97-induktivnye-komponenty/281-drosseli-induktivnosti/138307-cdrh127-ldnp-101mc-100-mkgn-20-2-1-a-sumida/ | L_Sumida_CDRH127_LDNP_101MC | Danomsk | Sumida CDRH127/LDNP-101MC, shielded100uH +/-20%. Maximum body12.3x12.3x8mm. DCRmax151mohm; table Isat2.1A at25% inductance drop. Verify temperature rise under shield. Approved Danomsk S4.6 substitution.
R1 | 0.28R 1% | 0.28R 1% | yes | yes | PT1206FR-7W0R28L | PT1206FR-7W0R28L | 0.28R 1% | yes | PT1206FR-7W0R28L | Meshcore:R_1206_3216Metric | Na-ion: FIT; LTO 2S: FIT |  | R_1206_3216Metric | Supplier not selected; stock not refreshed | Base 0.28 ohm 1% 0.5W current shunt, unchanged for both batteries. Thermal option adds R56 upstream. CN3722 CSP senses upstream of R56, BAT downstream of R1; Kelvin connections. Cold ~96mA; warm ~665mA with three parallel AO3401A; bypass/no thermal nominal 714mA.
C1 | 10uF 50V X7R | 10uF 50V X7R | yes | yes | CL31B106KBHNNNE | CL31B106KBHNNNE | 10uF 50V X7R | yes | CL31B106KBHNNNE | Meshcore:C_1206_3216Metric | Na-ion: FIT; LTO 2S: FIT | https://www.danomsk.ru/shop/5-kondensatory/89-kondensatory-keramicheskie/733-kondensatory-smd-1206/202927-chip-kond-1206-x7r-10uf-10-50v-cl31b106kbhnnne-cc120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 | C_1206_3216Metric | Danomsk | Danomsk S4.6 approved substitution. Точный текущий MPN найден в местном каталоге; входной керамический конденсатор SOLAR.
C2 | 100nF 50V X7R | 100nF 50V X7R | yes | yes | CL21B104KBCNNNC | CL21B104KBCNNNC | 100nF 50V X7R | yes | CL21B104KBCNNNC | Meshcore:C_0805_2012Metric | Na-ion: FIT; LTO 2S: FIT | https://www.danomsk.ru/shop/5-kondensatory/89-kondensatory-keramicheskie/732-kondensatory-smd-0805/196705-chip-kond-0805-x7r-0-10uf-10-50v-cl21b104kbcnnnc-cc0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 | C_0805_2012Metric | Danomsk | Danomsk S4.6 approved substitution. Точный текущий MPN. C3 остаётся между SOLAR и VG; C25 остаётся в фильтре BAT_ADC.
C3 | 100nF 50V X7R | 100nF 50V X7R | yes | yes | CL21B104KBCNNNC | CL21B104KBCNNNC | 100nF 50V X7R | yes | CL21B104KBCNNNC | Meshcore:C_0805_2012Metric | Na-ion: FIT; LTO 2S: FIT | https://www.danomsk.ru/shop/5-kondensatory/89-kondensatory-keramicheskie/732-kondensatory-smd-0805/196705-chip-kond-0805-x7r-0-10uf-10-50v-cl21b104kbcnnnc-cc0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 | C_0805_2012Metric | Danomsk | VG capacitor returns to VCC, not ground Danomsk S4.6 approved substitution. Точный текущий MPN. C3 остаётся между SOLAR и VG; C25 остаётся в фильтре BAT_ADC.
C4 | 22uF 25V X5R | 22uF 25V X5R | yes | yes | CL21A226MAQNNNE | CL21A226MAQNNNE | 22uF 25V X5R | yes | CL21A226MAQNNNE | Meshcore:C_0805_2012Metric | Na-ion: FIT; LTO 2S: FIT | https://www.danomsk.ru/shop/5-kondensatory/89-kondensatory-keramicheskie/732-kondensatory-smd-0805/196759-chip-kond-0805-x5r-22uf-10-25v-cl21a226maqnnne-cc080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 | C_0805_2012Metric | Danomsk | Danomsk S4.6 approved substitution. Местный кандидат с достаточным типовым запасом: C14 при3,3V около14,90µF, инженерная оценка10,13µF против7µF минимума TPS63802. C4 при4,0V типично12,97µF, оценка8,82µF. Необходимы измерение и согласование снижения верхней температуры.
R3 | 61.9k 0.1% <=25ppm/C | 121k 0.1% <=25ppm/C | yes | yes | RT0805BRD0761K9L | RT0805BRD07121KL | 61.9k 0.1% <=25ppm/C | yes | RT0805BRD0761K9L | Meshcore:R_0805_2012Metric | Na-ion: FIT; LTO 2S: FIT | https://www.digikey.com/en/products/detail/yageo/RT0805BRD0761K9L/1075991 | R_0805_2012Metric | Yageo / distributor | High-impedance CN3722 CV divider. Na-ion: 61.9k; LTO 2S: 121k. Use 0.1%, <=25ppm/C.
R4 | 100k 0.1% <=25ppm/C | 100k 0.1% <=25ppm/C | yes | yes | RT0805BRD07100KL | RT0805BRD07100KL | 100k 0.1% <=25ppm/C | yes | RT0805BRD07100KL | Meshcore:R_0805_2012Metric | Na-ion: FIT; LTO 2S: FIT | https://www.chipdip.ru/product/0.125vt-0805-100-kom-0.1-rt0805brd07100kl-chip-yageo-9000237585 | R_0805_2012Metric | ChipDip / Yageo | 100k lower CN3722 CV resistor for both assembly variants, 0.1%, <=25ppm/C.
C5 | 470pF 50V C0G | 470pF 50V C0G | yes | yes | CC0805JRNPO9BN471 | CC0805JRNPO9BN471 | 470pF 50V C0G | yes | CC0805JRNPO9BN471 | Meshcore:C_0805_2012Metric | Na-ion: FIT; LTO 2S: FIT | https://www.danomsk.ru/shop/5-kondensatory/89-kondensatory-keramicheskie/732-kondensatory-smd-0805/142082-chip-kond-0805-np0-470pf-5-50v-cc0805jrnpo9bn471-cc0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 | C_0805_2012Metric | Danomsk | Danomsk S4.6 approved substitution. Сохраняются ёмкость, допуск, стабильный диэлектрик и напряжение конденсатора компенсации CN3722.
R5 | 1M 0.1% | 1M 0.1% | yes | yes | RT0805BRD071ML | RT0805BRD071ML | 1M 0.1% | yes | RT0805BRD071ML | Meshcore:R_0805_2012Metric | Na-ion: FIT; LTO 2S: FIT | https://www.danomsk.ru/shop/6-rezistory/86-rezistory-postoyannye/268-rezistory-chip-0805/211665-chip-0805-1-0m-0-1-rt0805brd071ml-yageo/ | R_0805_2012Metric | Danomsk | Danomsk S4.6 approved substitution. Точный RT0805BRD071ML для R27/R28: 1 МОм/0.1%/±25 ppm/°C. Такой же ставим в R5 вместо 1%: корпус/номинал сохраняются, отдельный лот обычных 1 МОм покупать не требуется. Из обязательного лота 10 шт. используется 3.
R6 | 120R | 120R | yes | yes | RC0805FR-07120RL | RC0805FR-07120RL | 120R | yes | RC0805FR-07120RL | Meshcore:R_0805_2012Metric | Na-ion: FIT; LTO 2S: FIT | https://www.danomsk.ru/shop/6-rezistory/86-rezistory-postoyannye/268-rezistory-chip-0805/134728-chip-0805-120-1-rc0805fr-07120r-yageo/ | R_0805_2012Metric | Danomsk | Danomsk S4.6 approved substitution. 120Ω, 0805, 1%; Yageo вместо Uni-Ohm. Покупка кратно 10 шт.
C6 | 220nF 50V X7R | 220nF 50V X7R | yes | yes | CC0805KKX7R9BB224 | CC0805KKX7R9BB224 | 220nF 50V X7R | yes | CC0805KKX7R9BB224 | Meshcore:C_0805_2012Metric | Na-ion: FIT; LTO 2S: FIT | https://www.danomsk.ru/shop/5-kondensatory/89-kondensatory-keramicheskie/732-kondensatory-smd-0805/119579-chip-kond-0805-x7r-0-22uf-10-50v-cc0805kkx7r9bb224-c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 | C_0805_2012Metric | Danomsk | Danomsk S4.6 approved substitution. Та же ёмкость и класс X7R, тот же корпус; замена по документу производителя в карточке.
C7 | 100nF 50V X7R | 100nF 50V X7R | yes | yes | CL21B104KBCNNNC | CL21B104KBCNNNC | 100nF 50V X7R | yes | CL21B104KBCNNNC | Meshcore:C_0805_2012Metric | Na-ion: FIT; LTO 2S: FIT | https://www.danomsk.ru/shop/5-kondensatory/89-kondensatory-keramicheskie/732-kondensatory-smd-0805/196705-chip-kond-0805-x7r-0-10uf-10-50v-cl21b104kbcnnnc-cc0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 | C_0805_2012Metric | Danomsk | Danomsk S4.6 approved substitution. Точный текущий MPN. C3 остаётся между SOLAR и VG; C25 остаётся в фильтре BAT_ADC.
R7 | 105k 0.1% | 105k 0.1% | yes | yes | AT0805BRD07105KL | AT0805BRD07105KL | 105k 0.1% | yes | AT0805BRD07105KL | Meshcore:R_0805_2012Metric | Na-ion: FIT; LTO 2S: FIT |  | R_0805_2012Metric | Supplier not selected; stock not refreshed | Provisional Vmp11.96V at25C; populated value must match measured panel Vmp
R8 | 10k 0.1% | 10k 0.1% | yes | yes | RT0805BRE0710KL | RT0805BRE0710KL | 10k 0.1% | yes | RT0805BRE0710KL | Meshcore:R_0805_2012Metric | Na-ion: FIT; LTO 2S: FIT | https://www.danomsk.ru/shop/6-rezistory/86-rezistory-postoyannye/268-rezistory-chip-0805/145796-chip-0805-10-0k-0-1-50ppm-c-rt0805bre0710kl-tonkoplenochnyy-ya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 | R_0805_2012Metric | Danomsk | Danomsk S4.6 approved substitution. Предлагается только для R8 (MPPT) и R14 (обратная связь TPS). Те же 10 кОм/0.1%/0805, TCR ±50 вместо ±25 ppm/°C. При ΔT=65°C расчёт PWM-выхода 3.248…3.358 В вместо 3.252…3.354 В. Вклад допусков и TCR резисторов в MPPT при фиксированном Vref: 11.885…12.035 В; сам Vref/панель сюда не включены. R4 в зарядном делителе сохраняется ±25 ppm/°C: запас до 4.0 В мал.
R9 | 10k | 10k | yes | yes | RC0805FR-0710KL | RC0805FR-0710KL | 10k | yes | RC0805FR-0710KL | Meshcore:R_0805_2012Metric | Na-ion: FIT; LTO 2S: FIT | https://www.danomsk.ru/shop/6-rezistory/86-rezistory-postoyannye/268-rezistory-chip-0805/140222-chip-0805-10k-1-rc0805fr-0710kl-yageo/ | R_0805_2012Metric | Danomsk | Battery temperature monitoring disabled at explicit user request Danomsk S4.6 approved substitution. 10kΩ, 0805, 1%; только непрецизионные позиции, не заменять этим R4/R8/R14. Покупка кратно 10 шт.
C8 | 47uF 35V | 47uF 35V | yes | yes | EEEFK1V470P | EEEFK1V470P | 47uF 35V | yes | EEEFK1V470P | Meshcore:CP_Elec_Panasonic_FK_D_6.3x5.8 | Na-ion: FIT; LTO 2S: FIT | https://www.danomsk.ru/shop/5-kondensatory/88-kondensatory-elektroliticheskie/737-kondensatory-elektroliticheskie-smd/197287-chip-el-lit-eeefk1v470p-35v-47uf-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 | CP_Elec_Panasonic_FK_D_6.3x5.8 | Danomsk | Panasonic FK D, 47uF35V, diameter6.3mm, height5.8mm. Exact recommended pads3.2x1.6mm, gap1.8mm. 240mArms@100kHz105C, Zmax0.36ohm@100kHz20C. Maximum105C; verify C1+C8 ripple sharing and temperature under shield. Danomsk S4.6 approved substitution. Ближайшая качественная местная замена: 240mArms@100kHz/+105°C, Zmax0,36Ω@100kHz/+20°C. Сохраняются47µF/35V/диаметр6,3мм, но это не точный температурный аналог Nichicon.
R10 | 10k | 10k | yes | yes | RC0805FR-0710KL | RC0805FR-0710KL | 10k | yes | RC0805FR-0710KL | Meshcore:R_0805_2012Metric | Na-ion: FIT; LTO 2S: FIT | https://www.danomsk.ru/shop/6-rezistory/86-rezistory-postoyannye/268-rezistory-chip-0805/140222-chip-0805-10k-1-rc0805fr-0710kl-yageo/ | R_0805_2012Metric | Danomsk | Danomsk S4.6 approved substitution. 10kΩ, 0805, 1%; только непрецизионные позиции, не заменять этим R4/R8/R14. Покупка кратно 10 шт.
D3 | RED | RED | yes | yes | FYLS-0805BURC | FYLS-0805BURC | RED | yes | FYLS-0805BURC | Meshcore:LED_0805_2012Metric | Na-ion: FIT; LTO 2S: FIT | https://www.danomsk.ru/shop/20-svetodiodnye-izdeliya-optoelektronika/115-svetodiody/198855-fyls-0805burc-smd-2kh1-25mm-krasnyy-631nm-80mkd-prozrachnyy-130-for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 | LED_0805_2012Metric | Danomsk | Danomsk S4.6 approved substitution. Функциональная замена индикатора: красный, тот же типоразмер. Равная яркость не гарантируется.
R11 | 10k | 10k | yes | yes | RC0805FR-0710KL | RC0805FR-0710KL | 10k | yes | RC0805FR-0710KL | Meshcore:R_0805_2012Metric | Na-ion: FIT; LTO 2S: FIT | https://www.danomsk.ru/shop/6-rezistory/86-rezistory-postoyannye/268-rezistory-chip-0805/140222-chip-0805-10k-1-rc0805fr-0710kl-yageo/ | R_0805_2012Metric | Danomsk | Danomsk S4.6 approved substitution. 10kΩ, 0805, 1%; только непрецизионные позиции, не заменять этим R4/R8/R14. Покупка кратно 10 шт.
D4 | GREEN | GREEN | yes | yes | FYLS-0805BUGC | FYLS-0805BUGC | GREEN | yes | FYLS-0805BUGC | Meshcore:LED_0805_2012Metric | Na-ion: FIT; LTO 2S: FIT | https://www.danomsk.ru/shop/20-svetodiodnye-izdeliya-optoelektronika/115-svetodiody/198856-fyls-0805bugc-smd-2kh1-25mm-zelenyy-570nm-40mkd-prozrachnyy-130-for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 | LED_0805_2012Metric | Danomsk | Danomsk S4.6 approved substitution. Функциональная замена индикатора: зелёный, тот же типоразмер. Равная яркость не гарантируется.
U2 | TPS63802DLAR | TPS63802DLAR | yes | yes | TPS63802DLAR | TPS63802DLAR | TPS63802DLAR | yes | TPS63802DLAR | Meshcore:TPS63802_DLA0010A | Na-ion: FIT; LTO 2S: FIT |  | TPS63802_DLA0010A | Supplier not selected; stock not refreshed
L2 | 0.47uH | 0.47uH | yes | yes | XGL4020-471MEC | XGL4020-471MEC | 0.47uH | yes | XGL4020-471MEC | Meshcore:L_Coilcraft_XGL4020_471MEC | Na-ion: FIT; LTO 2S: FIT |  | L_Coilcraft_XGL4020_471MEC | Supplier not selected; stock not refreshed | Shielded 0.47uH power inductor; body 4.0+/-0.3mm square, maximum height 2.10mm. Official Coilcraft recommended copper lands; mask, paste and F.Cu under-coil keepout are engineering choices.
C12 | 10uF 16V X7R | 10uF 16V X7R | yes | yes | CL21B106KOQNNNE | CL21B106KOQNNNE | 10uF 16V X7R | yes | CL21B106KOQNNNE | Meshcore:C_0805_2012Metric | Na-ion: FIT; LTO 2S: FIT | https://www.danomsk.ru/shop/5-kondensatory/89-kondensatory-keramicheskie/732-kondensatory-smd-0805/194763-chip-kond-0805-x7r-10uf-10-16v-cl21b106koqnnne-cc080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 | C_0805_2012Metric | Danomsk | Danomsk S4.6 approved substitution. Предлагается местный 16V Samsung, но Cin TPS63802 должен быть не менее 4µF эффективных при максимальном BAT=4,0V. Типовая кривая даёт около6,20µF; оценка с допуском/температурой около4,74µF. Это кандидат для квалификации, не гарантированное доказательство запаса.
C13 | 100nF 50V X7R | 100nF 50V X7R | yes | yes | CL10B104KB8NNNC | CL10B104KB8NNNC | 100nF 50V X7R | yes | CL10B104KB8NNNC | Meshcore:C_0603_1608Metric | Na-ion: FIT; LTO 2S: FIT | https://www.danomsk.ru/shop/5-kondensatory/89-kondensatory-keramicheskie/731-kondensatory-smd-0603/142040-chip-kond-0603-x7r-0-1uf-10-50v-cl10b104kb8nnnc-cc06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 | C_0603_1608Metric | Danomsk | Danomsk S4.6 approved substitution. Точный MPN местного каталога; высокочастотная развязка TPS63802.
C14 | 22uF 25V X5R | 22uF 25V X5R | yes | yes | CL21A226MAQNNNE | CL21A226MAQNNNE | 22uF 25V X5R | yes | CL21A226MAQNNNE | Meshcore:C_0805_2012Metric | Na-ion: FIT; LTO 2S: FIT | https://www.danomsk.ru/shop/5-kondensatory/89-kondensatory-keramicheskie/732-kondensatory-smd-0805/196759-chip-kond-0805-x5r-22uf-10-25v-cl21a226maqnnne-cc080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 | C_0805_2012Metric | Danomsk | Local COUT before additional LC filter Danomsk S4.6 approved substitution. Местный кандидат с достаточным типовым запасом: C14 при3,3V около14,90µF, инженерная оценка10,13µF против7µF минимума TPS63802. C4 при4,0V типично12,97µF, оценка8,82µF. Необходимы измерение и согласование снижения верхней температуры.
C52 | 10uF 16V X7R | 10uF 16V X7R | yes | yes | CL21B106KOQNNNE | CL21B106KOQNNNE | 10uF 16V X7R | yes | CL21B106KOQNNNE | Meshcore:C_0805_2012Metric | Na-ion: FIT; LTO 2S: FIT | https://www.danomsk.ru/shop/5-kondensatory/89-kondensatory-keramicheskie/732-kondensatory-smd-0805/194763-chip-kond-0805-x7r-10uf-10-16v-cl21b106koqnnne-cc080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 | C_0805_2012Metric | Danomsk | Second populated10uF16V0805 local input bypass, exactsamepartasC12. C53 remains DNP reserve. DC-bias engineering budget; qualify actual capacitance.
C53 | DNP | DNP | no | no |  |  | DNP | no |  | Meshcore:C_1206_3216Metric | Na-ion: DNP; LTO 2S: DNP |  | C_1206_3216Metric | Supplier not selected; stock not refreshed | DNP reserve 1206 capacitor site directly in parallel with C12, BAT to GND. Capacitance and MPN are not selected; populate only after TPS63802 input transient qualification.
C54 | DNP | DNP | no | no |  |  | DNP | no |  | Meshcore:C_1206_3216Metric | Na-ion: DNP; LTO 2S: DNP |  | C_1206_3216Metric | Supplier not selected; stock not refreshed | DNP reserve 1206 capacitor site directly in parallel with C14, SYS_PRE to GND before L3. Capacitance and MPN are not selected; populate only after TPS63802 output stability qualification.
C55 | DNP | DNP | no | no |  |  | DNP | no |  | Meshcore:C_1206_3216Metric | Na-ion: DNP; LTO 2S: DNP |  | C_1206_3216Metric | Supplier not selected; stock not refreshed | DNP reserve 1206 capacitor site directly in parallel with C14, SYS_PRE to GND before L3. Capacitance and MPN are not selected; populate only after TPS63802 output stability qualification.
R13 | 56k 0.1% | 56k 0.1% | yes | yes | RNCF0805BKE56K0 | RNCF0805BKE56K0 | 56k 0.1% | yes | RNCF0805BKE56K0 | Meshcore:R_0805_2012Metric | Na-ion: FIT; LTO 2S: FIT |  | R_0805_2012Metric | Supplier not selected; stock not refreshed
R14 | 10k 0.1% | 10k 0.1% | yes | yes | RT0805BRE0710KL | RT0805BRE0710KL | 10k 0.1% | yes | RT0805BRE0710KL | Meshcore:R_0805_2012Metric | Na-ion: FIT; LTO 2S: FIT | https://www.danomsk.ru/shop/6-rezistory/86-rezistory-postoyannye/268-rezistory-chip-0805/145796-chip-0805-10-0k-0-1-50ppm-c-rt0805bre0710kl-tonkoplenochnyy-ya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 | R_0805_2012Metric | Danomsk | Danomsk S4.6 approved substitution. Предлагается только для R8 (MPPT) и R14 (обратная связь TPS). Те же 10 кОм/0.1%/0805, TCR ±50 вместо ±25 ppm/°C. При ΔT=65°C расчёт PWM-выхода 3.248…3.358 В вместо 3.252…3.354 В. Вклад допусков и TCR резисторов в MPPT при фиксированном Vref: 11.885…12.035 В; сам Vref/панель сюда не включены. R4 в зарядном делителе сохраняется ±25 ppm/°C: запас до 4.0 В мал.
R15 | 40.2k 0.1% | 130k 0.1% | yes | yes | RT0805BRD0740K2L | MPN not selected | 40.2k 0.1% | yes | RT0805BRD0740K2L | Meshcore:R_0805_2012Metric | Na-ion: FIT; LTO 2S: FIT |  | R_0805_2012Metric | Supplier not selected; stock not refreshed | Na-ion: 40.2k top / 49.9k bottom, OFF typ 1.806V. LTO 2S: 130k top / 49.9k bottom, OFF typ 3.605V; ON typ 3.966V. EN thresholds are not precision per-cell protection.
R16 | 49.9k 0.1% | 49.9k 0.1% | yes | yes | RT0805BRD0749K9L | RT0805BRD0749K9L | 49.9k 0.1% | yes | RT0805BRD0749K9L | Meshcore:R_0805_2012Metric | Na-ion: FIT; LTO 2S: FIT |  | R_0805_2012Metric | Supplier not selected; stock not refreshed
R17 | 100k | 100k | yes | yes | RC0805FR-07100KL | RC0805FR-07100KL | 100k | yes | RC0805FR-07100KL | Meshcore:R_0805_2012Metric | Na-ion: FIT; LTO 2S: FIT | https://www.danomsk.ru/shop/6-rezistory/86-rezistory-postoyannye/268-rezistory-chip-0805/134751-chip-0805-100k-1-rc0805fr-07100k-yageo/ | R_0805_2012Metric | Danomsk | Danomsk S4.6 approved substitution. 100kΩ, 0805, 1%; Yageo вместо Uni-Ohm. Покупка кратно 10 шт.
L3 | 2.4uH | 2.4uH | yes | yes | CDRH127/LDNP-2R4NC | CDRH127/LDNP-2R4NC | 2.4uH | yes | CDRH127/LDNP-2R4NC | Meshcore:L_Sumida_CDRH127_LD | Na-ion: FIT; LTO 2S: FIT |  | L_Sumida_CDRH127_LD | Supplier not selected; stock not refreshed | Requested Sumida CDRH127/LD. Procurement and transient qualification remain open.
L4 | 2.4uH | 2.4uH | yes | yes | CDRH127/LDNP-2R4NC | CDRH127/LDNP-2R4NC | 2.4uH | yes | CDRH127/LDNP-2R4NC | Meshcore:L_Sumida_CDRH127_LD | Na-ion: FIT; LTO 2S: FIT |  | L_Sumida_CDRH127_LD | Supplier not selected; stock not refreshed | Requested Sumida CDRH127/LD. Procurement and transient qualification remain open.
C15 | 100uF | 100uF | yes | yes | C4532X5R1A107M280KC | C4532X5R1A107M280KC | 100uF | yes | C4532X5R1A107M280KC | Meshcore:C_1812_4532Metric | Na-ion: FIT; LTO 2S: FIT |  | C_1812_4532Metric | Supplier not selected; stock not refreshed | TDK100uF10V X5R +/-20%,1812. Ten parallel parts per stage provide1000uF nominal. Ceff>=330uF at3.3V is an acceptance requirement, not verified by a guaranteed bias limit. Procurement through China authorized distribution; no confirmed JLC stock.
C34 | 100uF | 100uF | yes | yes | C4532X5R1A107M280KC | C4532X5R1A107M280KC | 100uF | yes | C4532X5R1A107M280KC | Meshcore:C_1812_4532Metric | Na-ion: FIT; LTO 2S: FIT |  | C_1812_4532Metric | Supplier not selected; stock not refreshed | TDK100uF10V X5R +/-20%,1812. Ten parallel parts per stage provide1000uF nominal. Ceff>=330uF at3.3V is an acceptance requirement, not verified by a guaranteed bias limit. Procurement through China authorized distribution; no confirmed JLC stock.
C35 | 100uF | 100uF | yes | yes | C4532X5R1A107M280KC | C4532X5R1A107M280KC | 100uF | yes | C4532X5R1A107M280KC | Meshcore:C_1812_4532Metric | Na-ion: FIT; LTO 2S: FIT |  | C_1812_4532Metric | Supplier not selected; stock not refreshed | TDK100uF10V X5R +/-20%,1812. Ten parallel parts per stage provide1000uF nominal. Ceff>=330uF at3.3V is an acceptance requirement, not verified by a guaranteed bias limit. Procurement through China authorized distribution; no confirmed JLC stock.
C36 | 100uF | 100uF | yes | yes | C4532X5R1A107M280KC | C4532X5R1A107M280KC | 100uF | yes | C4532X5R1A107M280KC | Meshcore:C_1812_4532Metric | Na-ion: FIT; LTO 2S: FIT |  | C_1812_4532Metric | Supplier not selected; stock not refreshed | TDK100uF10V X5R +/-20%,1812. Ten parallel parts per stage provide1000uF nominal. Ceff>=330uF at3.3V is an acceptance requirement, not verified by a guaranteed bias limit. Procurement through China authorized distribution; no confirmed JLC stock.
C37 | 100uF | 100uF | yes | yes | C4532X5R1A107M280KC | C4532X5R1A107M280KC | 100uF | yes | C4532X5R1A107M280KC | Meshcore:C_1812_4532Metric | Na-ion: FIT; LTO 2S: FIT |  | C_1812_4532Metric | Supplier not selected; stock not refreshed | TDK100uF10V X5R +/-20%,1812. Ten parallel parts per stage provide1000uF nominal. Ceff>=330uF at3.3V is an acceptance requirement, not verified by a guaranteed bias limit. Procurement through China authorized distribution; no confirmed JLC stock.
C38 | 100uF | 100uF | yes | yes | C4532X5R1A107M280KC | C4532X5R1A107M280KC | 100uF | yes | C4532X5R1A107M280KC | Meshcore:C_1812_4532Metric | Na-ion: FIT; LTO 2S: FIT |  | C_1812_4532Metric | Supplier not selected; stock not refreshed | TDK100uF10V X5R +/-20%,1812. Ten parallel parts per stage provide1000uF nominal. Ceff>=330uF at3.3V is an acceptance requirement, not verified by a guaranteed bias limit. Procurement through China authorized distribution; no confirmed JLC stock.
C39 | 100uF | 100uF | yes | yes | C4532X5R1A107M280KC | C4532X5R1A107M280KC | 100uF | yes | C4532X5R1A107M280KC | Meshcore:C_1812_4532Metric | Na-ion: FIT; LTO 2S: FIT |  | C_1812_4532Metric | Supplier not selected; stock not refreshed | TDK100uF10V X5R +/-20%,1812. Ten parallel parts per stage provide1000uF nominal. Ceff>=330uF at3.3V is an acceptance requirement, not verified by a guaranteed bias limit. Procurement through China authorized distribution; no confirmed JLC stock.
C40 | 100uF | 100uF | yes | yes | C4532X5R1A107M280KC | C4532X5R1A107M280KC | 100uF | yes | C4532X5R1A107M280KC | Meshcore:C_1812_4532Metric | Na-ion: FIT; LTO 2S: FIT |  | C_1812_4532Metric | Supplier not selected; stock not refreshed | TDK100uF10V X5R +/-20%,1812. Ten parallel parts per stage provide1000uF nominal. Ceff>=330uF at3.3V is an acceptance requirement, not verified by a guaranteed bias limit. Procurement through China authorized distribution; no confirmed JLC stock.
C41 | 100uF | 100uF | yes | yes | C4532X5R1A107M280KC | C4532X5R1A107M280KC | 100uF | yes | C4532X5R1A107M280KC | Meshcore:C_1812_4532Metric | Na-ion: FIT; LTO 2S: FIT |  | C_1812_4532Metric | Supplier not selected; stock not refreshed | TDK100uF10V X5R +/-20%,1812. Ten parallel parts per stage provide1000uF nominal. Ceff>=330uF at3.3V is an acceptance requirement, not verified by a guaranteed bias limit. Procurement through China authorized distribution; no confirmed JLC stock.
C42 | 100uF | 100uF | yes | yes | C4532X5R1A107M280KC | C4532X5R1A107M280KC | 100uF | yes | C4532X5R1A107M280KC | Meshcore:C_1812_4532Metric | Na-ion: FIT; LTO 2S: FIT |  | C_1812_4532Metric | Supplier not selected; stock not refreshed | TDK100uF10V X5R +/-20%,1812. Ten parallel parts per stage provide1000uF nominal. Ceff>=330uF at3.3V is an acceptance requirement, not verified by a guaranteed bias limit. Procurement through China authorized distribution; no confirmed JLC stock.
C16 | 100uF | 100uF | yes | yes | C4532X5R1A107M280KC | C4532X5R1A107M280KC | 100uF | yes | C4532X5R1A107M280KC | Meshcore:C_1812_4532Metric | Na-ion: FIT; LTO 2S: FIT |  | C_1812_4532Metric | Supplier not selected; stock not refreshed | TDK100uF10V X5R +/-20%,1812. Ten parallel parts per stage provide1000uF nominal. Ceff>=330uF at3.3V is an acceptance requirement, not verified by a guaranteed bias limit. Procurement through China authorized distribution; no confirmed JLC stock.
C43 | 100uF | 100uF | yes | yes | C4532X5R1A107M280KC | C4532X5R1A107M280KC | 100uF | yes | C4532X5R1A107M280KC | Meshcore:C_1812_4532Metric | Na-ion: FIT; LTO 2S: FIT |  | C_1812_4532Metric | Supplier not selected; stock not refreshed | TDK100uF10V X5R +/-20%,1812. Ten parallel parts per stage provide1000uF nominal. Ceff>=330uF at3.3V is an acceptance requirement, not verified by a guaranteed bias limit. Procurement through China authorized distribution; no confirmed JLC stock.
C44 | 100uF | 100uF | yes | yes | C4532X5R1A107M280KC | C4532X5R1A107M280KC | 100uF | yes | C4532X5R1A107M280KC | Meshcore:C_1812_4532Metric | Na-ion: FIT; LTO 2S: FIT |  | C_1812_4532Metric | Supplier not selected; stock not refreshed | TDK100uF10V X5R +/-20%,1812. Ten parallel parts per stage provide1000uF nominal. Ceff>=330uF at3.3V is an acceptance requirement, not verified by a guaranteed bias limit. Procurement through China authorized distribution; no confirmed JLC stock.
C45 | 100uF | 100uF | yes | yes | C4532X5R1A107M280KC | C4532X5R1A107M280KC | 100uF | yes | C4532X5R1A107M280KC | Meshcore:C_1812_4532Metric | Na-ion: FIT; LTO 2S: FIT |  | C_1812_4532Metric | Supplier not selected; stock not refreshed | TDK100uF10V X5R +/-20%,1812. Ten parallel parts per stage provide1000uF nominal. Ceff>=330uF at3.3V is an acceptance requirement, not verified by a guaranteed bias limit. Procurement through China authorized distribution; no confirmed JLC stock.
C46 | 100uF | 100uF | yes | yes | C4532X5R1A107M280KC | C4532X5R1A107M280KC | 100uF | yes | C4532X5R1A107M280KC | Meshcore:C_1812_4532Metric | Na-ion: FIT; LTO 2S: FIT |  | C_1812_4532Metric | Supplier not selected; stock not refreshed | TDK100uF10V X5R +/-20%,1812. Ten parallel parts per stage provide1000uF nominal. Ceff>=330uF at3.3V is an acceptance requirement, not verified by a guaranteed bias limit. Procurement through China authorized distribution; no confirmed JLC stock.
C47 | 100uF | 100uF | yes | yes | C4532X5R1A107M280KC | C4532X5R1A107M280KC | 100uF | yes | C4532X5R1A107M280KC | Meshcore:C_1812_4532Metric | Na-ion: FIT; LTO 2S: FIT |  | C_1812_4532Metric | Supplier not selected; stock not refreshed | TDK100uF10V X5R +/-20%,1812. Ten parallel parts per stage provide1000uF nominal. Ceff>=330uF at3.3V is an acceptance requirement, not verified by a guaranteed bias limit. Procurement through China authorized distribution; no confirmed JLC stock.
C48 | 100uF | 100uF | yes | yes | C4532X5R1A107M280KC | C4532X5R1A107M280KC | 100uF | yes | C4532X5R1A107M280KC | Meshcore:C_1812_4532Metric | Na-ion: FIT; LTO 2S: FIT |  | C_1812_4532Metric | Supplier not selected; stock not refreshed | TDK100uF10V X5R +/-20%,1812. Ten parallel parts per stage provide1000uF nominal. Ceff>=330uF at3.3V is an acceptance requirement, not verified by a guaranteed bias limit. Procurement through China authorized distribution; no confirmed JLC stock.
C49 | 100uF | 100uF | yes | yes | C4532X5R1A107M280KC | C4532X5R1A107M280KC | 100uF | yes | C4532X5R1A107M280KC | Meshcore:C_1812_4532Metric | Na-ion: FIT; LTO 2S: FIT |  | C_1812_4532Metric | Supplier not selected; stock not refreshed | TDK100uF10V X5R +/-20%,1812. Ten parallel parts per stage provide1000uF nominal. Ceff>=330uF at3.3V is an acceptance requirement, not verified by a guaranteed bias limit. Procurement through China authorized distribution; no confirmed JLC stock.
C50 | 100uF | 100uF | yes | yes | C4532X5R1A107M280KC | C4532X5R1A107M280KC | 100uF | yes | C4532X5R1A107M280KC | Meshcore:C_1812_4532Metric | Na-ion: FIT; LTO 2S: FIT |  | C_1812_4532Metric | Supplier not selected; stock not refreshed | TDK100uF10V X5R +/-20%,1812. Ten parallel parts per stage provide1000uF nominal. Ceff>=330uF at3.3V is an acceptance requirement, not verified by a guaranteed bias limit. Procurement through China authorized distribution; no confirmed JLC stock.
C51 | 100uF | 100uF | yes | yes | C4532X5R1A107M280KC | C4532X5R1A107M280KC | 100uF | yes | C4532X5R1A107M280KC | Meshcore:C_1812_4532Metric | Na-ion: FIT; LTO 2S: FIT |  | C_1812_4532Metric | Supplier not selected; stock not refreshed | TDK100uF10V X5R +/-20%,1812. Ten parallel parts per stage provide1000uF nominal. Ceff>=330uF at3.3V is an acceptance requirement, not verified by a guaranteed bias limit. Procurement through China authorized distribution; no confirmed JLC stock.
R40 | 22mR 1% | 22mR 1% | yes | yes | WSL1206R0220FEA | WSL1206R0220FEA | 22mR 1% | yes | WSL1206R0220FEA | Meshcore:R_Vishay_WSL1206_18 | Na-ion: FIT; LTO 2S: FIT |  | R_Vishay_WSL1206_18 | Supplier not selected; stock not refreshed | 22mOhm series with the whole capacitor bank, not with load current.
R41 | 22mR 1% | 22mR 1% | yes | yes | WSL1206R0220FEA | WSL1206R0220FEA | 22mR 1% | yes | WSL1206R0220FEA | Meshcore:R_Vishay_WSL1206_18 | Na-ion: FIT; LTO 2S: FIT |  | R_Vishay_WSL1206_18 | Supplier not selected; stock not refreshed | 22mOhm series with the whole capacitor bank, not with load current.
J11 | LC OUT - SYS 3V3 | LC OUT - SYS 3V3 | yes | yes | DS1021-1X40SF11-B | DS1021-1X40SF11-B | LC OUT - SYS 3V3 | yes | DS1021-1X40SF11-B | Meshcore:PinHeader_1x02_P2.54mm_Vertical | Na-ion: FIT; LTO 2S: FIT | https://www.danomsk.ru/shop/7-kommutatsiya/121-razemy/306-soediniteli-pryamougolnye/195992-pls-40-ds1021-1x40sf11-b-vilka-na-platu-shag-2-54mm-maks-dopust-tok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 | PinHeader_1x02_P2.54mm_Vertical | Danomsk | Pin1=LC FILTER_OUT; pin2=SYS_3V3 for all loads including NiceNano. Shunt fitted for battery/solar operation. Remove BEFORE connecting USB; reinstall only after USB is disconnected. Danomsk S4.6 approved substitution. Одна заготовка на все восемь разъёмов: три отрезка по 4 и пять по 2 контакта, всего 22. Штырь 0,64 мм, 3 A/контакт. J1/J2 в S4.5 отсутствуют.
R21 | 1k | 1k | yes | yes | RC0805FR-071KL | RC0805FR-071KL | 1k | yes | RC0805FR-071KL | Meshcore:R_0805_2012Metric | Na-ion: FIT; LTO 2S: FIT | https://www.danomsk.ru/shop/6-rezistory/86-rezistory-postoyannye/268-rezistory-chip-0805/140165-chip-0805-1-00k-1-rc0805fr-071kl-yageo/ | R_0805_2012Metric | Danomsk | Danomsk S4.6 approved substitution. 1kΩ, 0805, 1%; Yageo вместо Uni-Ohm. Покупка кратно 10 шт.
M1 | NiceNano_CLONE_MODIFIED | NiceNano_CLONE_MODIFIED | yes | yes | User supplied NiceNano clone | User supplied NiceNano clone | NiceNano_CLONE_MODIFIED | yes | User supplied NiceNano clone | Meshcore:NiceNano_13x2_Socket | Na-ion: FIT; LTO 2S: FIT |  | NiceNano_13x2_Socket | Supplier not selected; stock not refreshed | Filtered3.3V through removable J11 shunt directly to VCC, accepted based on user test of actual clone. Remove J11 BEFORE USB; all SYS_3V3 loads remain on the USB-fed side. Battery never connects to RAW/BAT; disable USB charger.
C21 | 10uF 16V X7R | 10uF 16V X7R | yes | yes | CL21B106KOQNNNE | CL21B106KOQNNNE | 10uF 16V X7R | yes | CL21B106KOQNNNE | Meshcore:C_0805_2012Metric | Na-ion: FIT; LTO 2S: FIT | https://www.danomsk.ru/shop/5-kondensatory/89-kondensatory-keramicheskie/732-kondensatory-smd-0805/194763-chip-kond-0805-x7r-10uf-10-16v-cl21b106koqnnne-cc080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 | C_0805_2012Metric | Danomsk | Danomsk S4.6 approved substitution. Объёмная развязка питания модулей при 3,3V; повышение номинального напряжения и сохранение X7R.
C22 | 100nF 50V X7R | 100nF 50V X7R | yes | yes | CL21B104KBCNNNC | CL21B104KBCNNNC | 100nF 50V X7R | yes | CL21B104KBCNNNC | Meshcore:C_0805_2012Metric | Na-ion: FIT; LTO 2S: FIT | https://www.danomsk.ru/shop/5-kondensatory/89-kondensatory-keramicheskie/732-kondensatory-smd-0805/196705-chip-kond-0805-x7r-0-10uf-10-50v-cl21b104kbcnnnc-cc0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 | C_0805_2012Metric | Danomsk | Danomsk S4.6 approved substitution. Точный текущий MPN. C3 остаётся между SOLAR и VG; C25 остаётся в фильтре BAT_ADC.
M2 | HT-RA62 | HT-RA62 | yes | yes | HT-RA62 band variant TBD | HT-RA62 band variant TBD | HT-RA62 | yes | HT-RA62 band variant TBD | Meshcore:HT_RA62 | Na-ion: FIT; LTO 2S: FIT |  | HT_RA62 | Supplier not selected; stock not refreshed | HT-RA62 antenna through pin 1 ANT to J13 SMA. Module RF selector: fit R1=0 ohm for ANT; remove/do not fit R2 for IPEX. HF/LF band variant must match the antenna and firmware.
R23 | 33R | 33R | yes | yes | RC0805FR-0733RL | RC0805FR-0733RL | 33R | yes | RC0805FR-0733RL | Meshcore:R_0805_2012Metric | Na-ion: FIT; LTO 2S: FIT | https://www.danomsk.ru/shop/6-rezistory/86-rezistory-postoyannye/268-rezistory-chip-0805/140098-chip-0805-33-1-rc0805fr-0733rl-yageo/ | R_0805_2012Metric | Danomsk | SPI series resistor near signaldriver; confirm signalintegrity atfirmwareclock Danomsk S4.6 approved substitution. 33 Ом, 0805, ±1%; меняется производитель/серия, допуск исходного 0805W8F330JT5E тоже ±1%. Покупка по 10 шт.
R24 | 33R | 33R | yes | yes | RC0805FR-0733RL | RC0805FR-0733RL | 33R | yes | RC0805FR-0733RL | Meshcore:R_0805_2012Metric | Na-ion: FIT; LTO 2S: FIT | https://www.danomsk.ru/shop/6-rezistory/86-rezistory-postoyannye/268-rezistory-chip-0805/140098-chip-0805-33-1-rc0805fr-0733rl-yageo/ | R_0805_2012Metric | Danomsk | SPI series resistor near signaldriver; confirm signalintegrity atfirmwareclock Danomsk S4.6 approved substitution. 33 Ом, 0805, ±1%; меняется производитель/серия, допуск исходного 0805W8F330JT5E тоже ±1%. Покупка по 10 шт.
R25 | 33R | 33R | yes | yes | RC0805FR-0733RL | RC0805FR-0733RL | 33R | yes | RC0805FR-0733RL | Meshcore:R_0805_2012Metric | Na-ion: FIT; LTO 2S: FIT | https://www.danomsk.ru/shop/6-rezistory/86-rezistory-postoyannye/268-rezistory-chip-0805/140098-chip-0805-33-1-rc0805fr-0733rl-yageo/ | R_0805_2012Metric | Danomsk | SPI series resistor near signaldriver; confirm signalintegrity atfirmwareclock Danomsk S4.6 approved substitution. 33 Ом, 0805, ±1%; меняется производитель/серия, допуск исходного 0805W8F330JT5E тоже ±1%. Покупка по 10 шт.
R26 | 33R | 33R | yes | yes | RC0805FR-0733RL | RC0805FR-0733RL | 33R | yes | RC0805FR-0733RL | Meshcore:R_0805_2012Metric | Na-ion: FIT; LTO 2S: FIT | https://www.danomsk.ru/shop/6-rezistory/86-rezistory-postoyannye/268-rezistory-chip-0805/140098-chip-0805-33-1-rc0805fr-0733rl-yageo/ | R_0805_2012Metric | Danomsk | SPI series resistor near signaldriver; confirm signalintegrity atfirmwareclock Danomsk S4.6 approved substitution. 33 Ом, 0805, ±1%; меняется производитель/серия, допуск исходного 0805W8F330JT5E тоже ±1%. Покупка по 10 шт.
C23 | 22uF 25V X5R | 22uF 25V X5R | yes | yes | CL21A226MAQNNNE | CL21A226MAQNNNE | 22uF 25V X5R | yes | CL21A226MAQNNNE | Meshcore:C_0805_2012Metric | Na-ion: FIT; LTO 2S: FIT | https://www.danomsk.ru/shop/5-kondensatory/89-kondensatory-keramicheskie/732-kondensatory-smd-0805/196759-chip-kond-0805-x5r-22uf-10-25v-cl21a226maqnnne-cc080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 | C_0805_2012Metric | Danomsk | Local22uF25V0805 radio bypass afterFB1; exactsameDanomskpartasC14. DC-biased effective capacitance requires prototype qualification.
C24 | 100nF 50V X7R | 100nF 50V X7R | yes | yes | CL21B104KBCNNNC | CL21B104KBCNNNC | 100nF 50V X7R | yes | CL21B104KBCNNNC | Meshcore:C_0805_2012Metric | Na-ion: FIT; LTO 2S: FIT | https://www.danomsk.ru/shop/5-kondensatory/89-kondensatory-keramicheskie/732-kondensatory-smd-0805/196705-chip-kond-0805-x7r-0-10uf-10-50v-cl21b104kbcnnnc-cc0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 | C_0805_2012Metric | Danomsk | Local100nF radio bypass directly between M2 VCC/GND, afterFB1.
R27 | 2.2M 0.1% | 2.2M 0.1% | yes | yes | RG2012P-225-B-T5 | RG2012P-225-B-T5 | 2.2M 0.1% | yes | RG2012P-225-B-T5 | Meshcore:R_0805_2012Metric | Na-ion: FIT; LTO 2S: FIT | https://www.chipdip.ru/product/rg2012p-225-b-t5-susumu-8003822701 | R_0805_2012Metric | ChipDip / Susumu | BAT/2 divider, 2.2Mohm 0.1%, 25ppm/C, 0805. C25=100nF retained; nominal tau110ms. Stock FakeTec ADC ratio and GPIO retained. Higher impedance requires actual-clone ADC calibration.
R28 | 2.2M 0.1% | 2.2M 0.1% | yes | yes | RG2012P-225-B-T5 | RG2012P-225-B-T5 | 2.2M 0.1% | yes | RG2012P-225-B-T5 | Meshcore:R_0805_2012Metric | Na-ion: FIT; LTO 2S: FIT | https://www.chipdip.ru/product/rg2012p-225-b-t5-susumu-8003822701 | R_0805_2012Metric | ChipDip / Susumu | BAT/2 divider, 2.2Mohm 0.1%, 25ppm/C, 0805. C25=100nF retained; nominal tau110ms. Stock FakeTec ADC ratio and GPIO retained. Higher impedance requires actual-clone ADC calibration.
C25 | 100nF 50V X7R | 100nF 50V X7R | yes | yes | CL21B104KBCNNNC | CL21B104KBCNNNC | 100nF 50V X7R | yes | CL21B104KBCNNNC | Meshcore:C_0805_2012Metric | Na-ion: FIT; LTO 2S: FIT | https://www.danomsk.ru/shop/5-kondensatory/89-kondensatory-keramicheskie/732-kondensatory-smd-0805/196705-chip-kond-0805-x7r-0-10uf-10-50v-cl21b104kbcnnnc-cc0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 | C_0805_2012Metric | Danomsk | 50ms nominalADC RC; firmware must allowsettling and use correct divider2 Danomsk S4.6 approved substitution. Точный текущий MPN. C3 остаётся между SOLAR и VG; C25 остаётся в фильтре BAT_ADC.
R29 | 4.7k | 4.7k | yes | yes | RC0805FR-074K7L | RC0805FR-074K7L | 4.7k | yes | RC0805FR-074K7L | Meshcore:R_0805_2012Metric | Na-ion: FIT; LTO 2S: FIT | https://www.danomsk.ru/shop/6-rezistory/86-rezistory-postoyannye/268-rezistory-chip-0805/140203-chip-0805-4-70k-1-rc0805fr-074k7l-yageo/ | R_0805_2012Metric | Danomsk | Danomsk S4.6 approved substitution. 4.7kΩ, 0805, 1%; Yageo вместо Uni-Ohm. Покупка кратно 10 шт.
R30 | 4.7k | 4.7k | yes | yes | RC0805FR-074K7L | RC0805FR-074K7L | 4.7k | yes | RC0805FR-074K7L | Meshcore:R_0805_2012Metric | Na-ion: FIT; LTO 2S: FIT | https://www.danomsk.ru/shop/6-rezistory/86-rezistory-postoyannye/268-rezistory-chip-0805/140203-chip-0805-4-70k-1-rc0805fr-074k7l-yageo/ | R_0805_2012Metric | Danomsk | Danomsk S4.6 approved substitution. 4.7kΩ, 0805, 1%; Yageo вместо Uni-Ohm. Покупка кратно 10 шт.
J3 | I2C3V3 | I2C3V3 | yes | yes | DS1021-1X40SF11-B | DS1021-1X40SF11-B | I2C3V3 | yes | DS1021-1X40SF11-B | Meshcore:PinHeader_1x04_P2.54mm_Vertical | Na-ion: FIT; LTO 2S: FIT | https://www.danomsk.ru/shop/7-kommutatsiya/121-razemy/306-soediniteli-pryamougolnye/195992-pls-40-ds1021-1x40sf11-b-vilka-na-platu-shag-2-54mm-maks-dopust-tok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 | PinHeader_1x04_P2.54mm_Vertical | Danomsk | I2C header: 1 VIN/SYS_3V3, 2 GND, 3 SCL, 4 SDA; swapped at user request in S4.8.
J4 | GPS / T114 P3 | GPS / T114 P3 | yes | yes | 53261-0871 | 53261-0871 | GPS / T114 P3 | yes | 53261-0871 | Meshcore:Molex_PicoBlade_53261-0871_1x08-1MP_P1.25mm_Horizontal | Na-ion: FIT; LTO 2S: FIT | https://www.molex.com/en-us/products/part-detail/532610871 | Molex_PicoBlade_53261-0871_1x08-1MP_P1.25mm_Horizontal | Other supplier | Heltec T114 V2.1 P3 order: 1 RESET_N, 2 PPS, 3 WAKE_UP, 4 GPS RXD, 5 GPS TXD, 6 backup 3.3V always on, 7 main 3.3V switched, 8 GND. RESET_N/WAKE_UP use L76K internal pullups; PPS unused. Electrical pin order verified; cable housing mating requires actual Heltec cable sample.
J5 | UART3V3 | UART3V3 | yes | yes | DS1021-1X40SF11-B | DS1021-1X40SF11-B | UART3V3 | yes | DS1021-1X40SF11-B | Meshcore:PinHeader_1x04_P2.54mm_Vertical | Na-ion: FIT; LTO 2S: FIT | https://www.danomsk.ru/shop/7-kommutatsiya/121-razemy/306-soediniteli-pryamougolnye/195992-pls-40-ds1021-1x40sf11-b-vilka-na-platu-shag-2-54mm-maks-dopust-tok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 | PinHeader_1x04_P2.54mm_Vertical | Danomsk | Danomsk S4.6 approved substitution. Одна заготовка на все восемь разъёмов: три отрезка по 4 и пять по 2 контакта, всего 22. Штырь 0,64 мм, 3 A/контакт. J1/J2 в S4.5 отсутствуют.
SW1 | USER | USER | yes | yes | KLS7-TS6604-4.3-180 | KLS7-TS6604-4.3-180 | USER | yes | KLS7-TS6604-4.3-180 | Meshcore:SW_Push_KLS7_TS6604_4_3_180 | Na-ion: FIT; LTO 2S: FIT | https://www.danomsk.ru/shop/7-kommutatsiya/120-pereklyuchateli/587-mikroknopki/204565-mikroknopka-it-1102s-kls7-ts6604-4-3-180-smd-taktovaya-6-6-4-3mm-spst-18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 | SW_Push_KLS7_TS6604_4_3_180 | Danomsk | KLS7-TS6604-4.3-180 SPST-NO. Use two diagonal electrical terminals1/2; remaining two isolated mechanical SMT pads. Before assembly verify incoming switch is open released and closed pressed; side-pair commoning is not assumed. Danomsk S4.6 approved substitution. Функциональная местная замена двух нормально разомкнутых кнопок; НЕ прямая замена XKB. Крупнее посадочное место; нужна локальная переразводка. В наличии 49 штук, на плату две.
SW2 | RESET | RESET | yes | yes | KLS7-TS6604-4.3-180 | KLS7-TS6604-4.3-180 | RESET | yes | KLS7-TS6604-4.3-180 | Meshcore:SW_Push_KLS7_TS6604_4_3_180 | Na-ion: FIT; LTO 2S: FIT | https://www.danomsk.ru/shop/7-kommutatsiya/120-pereklyuchateli/587-mikroknopki/204565-mikroknopka-it-1102s-kls7-ts6604-4-3-180-smd-taktovaya-6-6-4-3mm-spst-18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 | SW_Push_KLS7_TS6604_4_3_180 | Danomsk | KLS7-TS6604-4.3-180 SPST-NO. Use two diagonal electrical terminals1/2; remaining two isolated mechanical SMT pads. Before assembly verify incoming switch is open released and closed pressed; side-pair commoning is not assumed. Danomsk S4.6 approved substitution. Функциональная местная замена двух нормально разомкнутых кнопок; НЕ прямая замена XKB. Крупнее посадочное место; нужна локальная переразводка. В наличии 49 штук, на плату две.
R31 | 10k | 10k | yes | yes | RC0805FR-0710KL | RC0805FR-0710KL | 10k | yes | RC0805FR-0710KL | Meshcore:R_0805_2012Metric | Na-ion: FIT; LTO 2S: FIT | https://www.danomsk.ru/shop/6-rezistory/86-rezistory-postoyannye/268-rezistory-chip-0805/140222-chip-0805-10k-1-rc0805fr-0710kl-yageo/ | R_0805_2012Metric | Danomsk | Danomsk S4.6 approved substitution. 10kΩ, 0805, 1%; только непрецизионные позиции, не заменять этим R4/R8/R14. Покупка кратно 10 шт.
C26 | 100nF 50V X7R | 100nF 50V X7R | yes | yes | CL21B104KBCNNNC | CL21B104KBCNNNC | 100nF 50V X7R | yes | CL21B104KBCNNNC | Meshcore:C_0805_2012Metric | Na-ion: FIT; LTO 2S: FIT | https://www.danomsk.ru/shop/5-kondensatory/89-kondensatory-keramicheskie/732-kondensatory-smd-0805/196705-chip-kond-0805-x7r-0-10uf-10-50v-cl21b104kbcnnnc-cc0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 | C_0805_2012Metric | Danomsk | Danomsk S4.6 approved substitution. Точный текущий MPN. C3 остаётся между SOLAR и VG; C25 остаётся в фильтре BAT_ADC.
J7 | SOLAR 12V | SOLAR 12V | yes | yes | DS1021-1X40SF11-B | DS1021-1X40SF11-B | SOLAR 12V | yes | DS1021-1X40SF11-B | Meshcore:PinHeader_1x02_P2.54mm_Vertical | Na-ion: FIT; LTO 2S: FIT | https://www.danomsk.ru/shop/7-kommutatsiya/121-razemy/306-soediniteli-pryamougolnye/195992-pls-40-ds1021-1x40sf11-b-vilka-na-platu-shag-2-54mm-maks-dopust-tok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 | PinHeader_1x02_P2.54mm_Vertical | Danomsk | Danomsk S4.6 approved substitution. Одна заготовка на все восемь разъёмов: три отрезка по 4 и пять по 2 контакта, всего 22. Штырь 0,64 мм, 3 A/контакт. J1/J2 в S4.5 отсутствуют.
J8 | Na-ion 1S | Na-ion 1S | yes | yes | DS1021-1X40SF11-B | DS1021-1X40SF11-B | Na-ion 1S | yes | DS1021-1X40SF11-B | Meshcore:PinHeader_1x02_P2.54mm_Vertical | Na-ion: FIT; LTO 2S: FIT | https://www.danomsk.ru/shop/7-kommutatsiya/121-razemy/306-soediniteli-pryamougolnye/195992-pls-40-ds1021-1x40sf11-b-vilka-na-platu-shag-2-54mm-maks-dopust-tok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 | PinHeader_1x02_P2.54mm_Vertical | Danomsk | Danomsk S4.6 approved substitution. Одна заготовка на все восемь разъёмов: три отрезка по 4 и пять по 2 контакта, всего 22. Штырь 0,64 мм, 3 A/контакт. J1/J2 в S4.5 отсутствуют.
TP1 | BAT | BAT | yes | yes |  |  | BAT | yes |  | Meshcore:TestPoint_Pad_D1.5mm | Na-ion: FIT; LTO 2S: FIT |  | TestPoint_Pad_D1.5mm | Supplier not selected; stock not refreshed | No assemblycomponent
TP3 | SYS_PRE | SYS_PRE | yes | yes |  |  | SYS_PRE | yes |  | Meshcore:TestPoint_Pad_D1.5mm | Na-ion: FIT; LTO 2S: FIT |  | TestPoint_Pad_D1.5mm | Supplier not selected; stock not refreshed | No assemblycomponent
TP4 | SYS_3V3 | SYS_3V3 | yes | yes |  |  | SYS_3V3 | yes |  | Meshcore:TestPoint_Pad_D1.5mm | Na-ion: FIT; LTO 2S: FIT |  | TestPoint_Pad_D1.5mm | Supplier not selected; stock not refreshed | No assemblycomponent
TP6 | GND | GND | yes | yes |  |  | GND | yes |  | Meshcore:TestPoint_Pad_D1.5mm | Na-ion: FIT; LTO 2S: FIT |  | TestPoint_Pad_D1.5mm | Supplier not selected; stock not refreshed | No assemblycomponent
TP7 | GND | GND | yes | yes |  |  | GND | yes |  | Meshcore:TestPoint_Pad_D1.5mm | Na-ion: FIT; LTO 2S: FIT |  | TestPoint_Pad_D1.5mm | Supplier not selected; stock not refreshed | No assemblycomponent
U4 | DS3231MZ+TRL | DS3231MZ+TRL | yes | yes | DS3231MZ+TRL | DS3231MZ+TRL | DS3231MZ+TRL | yes | DS3231MZ+TRL | Meshcore:SOIC-8_3.9x4.9mm_P1.27mm | Na-ion: FIT; LTO 2S: FIT | https://www.danomsk.ru/shop/2-mikroskhemy/754-taymery-taktovye-generatory/176264-ds3231mz-trl-so-8-max-ad/ | SOIC-8_3.9x4.9mm_P1.27mm | Danomsk | DS3231MZ+TRL, SO-8. I2C0x68, timekeeping +/-5ppm. Pin1 32kHz and pin4 RST not connected; pin5 GND,6 VBAT,7 SDA,8 SCL. No battery charging. MEMS variant: SQW1Hz only; 32kHz not precision. Check RTC firmware support; stock radio GPIO unchanged. Approved Danomsk S4.6 substitution, including reduced timekeeping accuracy.
BT1 | CR2032 / holder | CR2032 / holder | yes | yes | 1060 | 1060 | CR2032 / holder | yes | 1060 | Meshcore:BatteryHolder_Keystone_1060_1x2032 | Na-ion: FIT; LTO 2S: FIT |  | BatteryHolder_Keystone_1060_1x2032 | Supplier not selected; stock not refreshed | Primary CR2032; no charging circuit. Holder pad1=positive; confirm assembly polarity.
C27 | 100nF 50V X7R | 100nF 50V X7R | yes | yes | CL21B104KBCNNNC | CL21B104KBCNNNC | 100nF 50V X7R | yes | CL21B104KBCNNNC | Meshcore:C_0805_2012Metric | Na-ion: FIT; LTO 2S: FIT | https://www.danomsk.ru/shop/5-kondensatory/89-kondensatory-keramicheskie/732-kondensatory-smd-0805/196705-chip-kond-0805-x7r-0-10uf-10-50v-cl21b104kbcnnnc-cc0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 | C_0805_2012Metric | Danomsk | Danomsk S4.6 approved substitution. Точный текущий MPN. C3 остаётся между SOLAR и VG; C25 остаётся в фильтре BAT_ADC.
R33 | 10k | 10k | yes | yes | RC0805FR-0710KL | RC0805FR-0710KL | 10k | yes | RC0805FR-0710KL | Meshcore:R_0805_2012Metric | Na-ion: FIT; LTO 2S: FIT | https://www.danomsk.ru/shop/6-rezistory/86-rezistory-postoyannye/268-rezistory-chip-0805/140222-chip-0805-10k-1-rc0805fr-0710kl-yageo/ | R_0805_2012Metric | Danomsk | External reset pullup; ATtiny output is open-drain in firmware. Danomsk S4.6 approved substitution. 10kΩ, 0805, 1%; только непрецизионные позиции, не заменять этим R4/R8/R14. Покупка кратно 10 шт.
C30 | 12pF 50V C0G | 6.8pF 50V C0G | yes | yes | CC0805JRNPO9BN120 | MPN not selected | 12pF 50V C0G | yes | CC0805JRNPO9BN120 | Meshcore:C_0805_2012Metric | Na-ion: FIT; LTO 2S: FIT | https://www.danomsk.ru/shop/5-kondensatory/89-kondensatory-keramicheskie/732-kondensatory-smd-0805/142068-chip-kond-0805-np0-12pf-5-50v-cc0805jrnpo9bn120-cc08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 | C_0805_2012Metric | Danomsk | CN3722 feed-forward capacitor across upperCV resistor, about8*(10k/6.34k)pF. Danomsk S4.6 approved substitution. Сохраняет 12pF в цепи BAT–FB_CN3722; C0G/NP0 без существенной DC-bias потери.
R35 | 100k | 100k | yes | yes | RC0805FR-07100KL | RC0805FR-07100KL | 100k | yes | RC0805FR-07100KL | Meshcore:R_0805_2012Metric | Na-ion: FIT; LTO 2S: FIT | https://www.danomsk.ru/shop/6-rezistory/86-rezistory-postoyannye/268-rezistory-chip-0805/134751-chip-0805-100k-1-rc0805fr-07100k-yageo/ | R_0805_2012Metric | Danomsk | Hold radio NSS high while MCU resets; placed after R25 on radio side. Danomsk S4.6 approved substitution. 100kΩ, 0805, 1%; Yageo вместо Uni-Ohm. Покупка кратно 10 шт.
U6 | ATtiny13A-SSU | ATtiny13A-SSU | yes | yes | ATTINY13A-SSU | ATTINY13A-SSU | ATtiny13A-SSU | yes | ATTINY13A-SSU | Meshcore:SOIC-8_3.9x4.9mm_P1.27mm | Na-ion: FIT; LTO 2S: FIT | https://www.danomsk.ru/shop/2-mikroskhemy/746-mikrokontrollery/155038-attiny13a-ssu-so-8-atmel-mcrch/ | SOIC-8_3.9x4.9mm_P1.27mm | Danomsk | User project watchdog/main.c: PB3 rising-edge heartbeat, PB0 open-drain reset. 1350 WDT ticks (~3h) then1s reset; source firmware unchanged. Danomsk S4.6 approved substitution. Совпадает точный MPN; в наличии две детали.
C33 | 100nF 50V X7R | 100nF 50V X7R | yes | yes | CL21B104KBCNNNC | CL21B104KBCNNNC | 100nF 50V X7R | yes | CL21B104KBCNNNC | Meshcore:C_0805_2012Metric | Na-ion: FIT; LTO 2S: FIT | https://www.danomsk.ru/shop/5-kondensatory/89-kondensatory-keramicheskie/732-kondensatory-smd-0805/196705-chip-kond-0805-x7r-0-10uf-10-50v-cl21b104kbcnnnc-cc0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 | C_0805_2012Metric | Danomsk | Danomsk S4.6 approved substitution. Замена развязки ATtiny на доступный Samsung с теми же ёмкостью, допуском, диэлектриком и напряжением.
R36 | 10k | 10k | yes | yes | RC0805FR-0710KL | RC0805FR-0710KL | 10k | yes | RC0805FR-0710KL | Meshcore:R_0805_2012Metric | Na-ion: FIT; LTO 2S: FIT | https://www.danomsk.ru/shop/6-rezistory/86-rezistory-postoyannye/268-rezistory-chip-0805/140222-chip-0805-10k-1-rc0805fr-0710kl-yageo/ | R_0805_2012Metric | Danomsk | Danomsk S4.6 approved substitution. 10kΩ, 0805, 1%; только непрецизионные позиции, не заменять этим R4/R8/R14. Покупка кратно 10 шт.
R37 | 0R | 0R | yes | yes | RC0805FR-070RL | RC0805FR-070RL | 0R | yes | RC0805FR-070RL | Meshcore:R_0805_2012Metric | Na-ion: FIT; LTO 2S: FIT | https://www.danomsk.ru/shop/6-rezistory/86-rezistory-postoyannye/268-rezistory-chip-0805/89890-chip-0805-0-1-rc0805fr-070rl-yageo/ | R_0805_2012Metric | Danomsk | Removable reset link: remove before ISP, restore after programming. PB0 must only sink or float in normal use. Danomsk S4.6 approved substitution. 0Ω, 0805; замена обычной перемычки по назначению. Покупка кратно 10 шт.
R38 | 1k | 1k | yes | yes | RC0805FR-071KL | RC0805FR-071KL | 1k | yes | RC0805FR-071KL | Meshcore:R_0805_2012Metric | Na-ion: FIT; LTO 2S: FIT | https://www.danomsk.ru/shop/6-rezistory/86-rezistory-postoyannye/268-rezistory-chip-0805/140165-chip-0805-1-00k-1-rc0805fr-071kl-yageo/ | R_0805_2012Metric | Danomsk | Watchdog monitors modem TXEN at user request; no MCU heartbeat GPIO. Danomsk S4.6 approved substitution. 1kΩ, 0805, 1%; Yageo вместо Uni-Ohm. Покупка кратно 10 шт.
R39 | 100k | 100k | yes | yes | RC0805FR-07100KL | RC0805FR-07100KL | 100k | yes | RC0805FR-07100KL | Meshcore:R_0805_2012Metric | Na-ion: FIT; LTO 2S: FIT | https://www.danomsk.ru/shop/6-rezistory/86-rezistory-postoyannye/268-rezistory-chip-0805/134751-chip-0805-100k-1-rc0805fr-07100k-yageo/ | R_0805_2012Metric | Danomsk | Required pulldown from the source watchdog project; idle input is low. Danomsk S4.6 approved substitution. 100kΩ, 0805, 1%; Yageo вместо Uni-Ohm. Покупка кратно 10 шт.
J10 | AVR ISP 3V3 | AVR ISP 3V3 | yes | yes | DS1021-2X5SF11-B | DS1021-2X5SF11-B | AVR ISP 3V3 | yes | DS1021-2X5SF11-B | Meshcore:PinHeader_2x03_P2.54mm_Vertical | Na-ion: FIT; LTO 2S: FIT | https://www.danomsk.ru/shop/7-kommutatsiya/121-razemy/306-soediniteli-pryamougolnye/114059-pld-10-2kh5-ds1021-2x5sf11-b-vilka-na-platu-shag-2-54mm-maks-dopust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 | PinHeader_2x03_P2.54mm_Vertical | Danomsk | Standard AVR ISP;3.3V levels only. Board self-powered: disable programmer target power. PB0=MOSI also asserts MCU reset while programming. Danomsk S4.6 approved substitution. Отрезать три пары от двухрядной гребёнки; электрически и по шагу соответствует ISP.
H1 | M3 NPTH | M3 NPTH | yes | yes |  |  | M3 NPTH | yes |  | Meshcore:MountingHole_3.2mm_M3 | Na-ion: FIT; LTO 2S: FIT |  | MountingHole_3.2mm_M3 | Supplier not selected; stock not refreshed | Non-plated3.2mm hole; use nonconductivewashers ifcase clearance requires
H2 | M3 NPTH | M3 NPTH | yes | yes |  |  | M3 NPTH | yes |  | Meshcore:MountingHole_3.2mm_M3 | Na-ion: FIT; LTO 2S: FIT |  | MountingHole_3.2mm_M3 | Supplier not selected; stock not refreshed | Non-plated3.2mm hole; use nonconductivewashers ifcase clearance requires
H3 | M3 NPTH | M3 NPTH | yes | yes |  |  | M3 NPTH | yes |  | Meshcore:MountingHole_3.2mm_M3 | Na-ion: FIT; LTO 2S: FIT |  | MountingHole_3.2mm_M3 | Supplier not selected; stock not refreshed | Non-plated3.2mm hole; use nonconductivewashers ifcase clearance requires
H4 | M3 NPTH | M3 NPTH | yes | yes |  |  | M3 NPTH | yes |  | Meshcore:MountingHole_3.2mm_M3 | Na-ion: FIT; LTO 2S: FIT |  | MountingHole_3.2mm_M3 | Supplier not selected; stock not refreshed | Non-plated3.2mm hole; use nonconductivewashers ifcase clearance requires
SH1 | CUSTOM_SHIELD_FRAME | CUSTOM_SHIELD_FRAME | yes | yes | CUSTOM76x43x14mm | CUSTOM76x43x14mm | CUSTOM_SHIELD_FRAME | yes | CUSTOM76x43x14mm | Meshcore:Shield_Frame_76x43 | Na-ion: FIT; LTO 2S: FIT |  | Shield_Frame_76x43 | Supplier not selected; stock not refreshed | Grounded solderframe and removable lid. 76x43mm wall centerlines, target14mm internal height,0.2mm wall. No antennas under lid. No F.Paste: separate manual frame assembly. Supplier mechanical drawing and qualification required.
Q2 | AO3401A | AO3401A | yes | yes | AO3401A | AO3401A | AO3401A | yes | AO3401A | Meshcore:SOT-23 | Na-ion: FIT; LTO 2S: FIT | https://www.danomsk.ru/shop/4-tranzistory/126-tranzistory-importnye/168774-ao3401a-sot23-p-kanal-30v-4a-1-4vt-a-o/ | SOT-23 | Danomsk | GPS high-side switch; AO3401A AOS, G1 S2 D3. Default off through R42; driven low by Q3.
Q3 | 2N7002K | 2N7002K | yes | yes | 2N7002K | 2N7002K | 2N7002K | yes | 2N7002K | Meshcore:SOT-23 | Na-ion: FIT; LTO 2S: FIT | https://www.danomsk.ru/shop/4-tranzistory/ | SOT-23 | Danomsk | CJ 2N7002K SOT23, G1 S2 D3. Sink only 33uA from R42. P0.24 HIGH enables GPS.
R42 | 100k | 100k | yes | yes | RC0805FR-07100KL | RC0805FR-07100KL | 100k | yes | RC0805FR-07100KL | Meshcore:R_0805_2012Metric | Na-ion: FIT; LTO 2S: FIT | https://www.danomsk.ru/shop/6-rezistory/86-rezistory-postoyannye/268-rezistory-chip-0805/134751-chip-0805-100k-1-rc0805fr-07100k-yageo/ | R_0805_2012Metric | Danomsk | GPS switch bias / UART input defined when module disconnected.
R43 | 100k | 100k | yes | yes | RC0805FR-07100KL | RC0805FR-07100KL | 100k | yes | RC0805FR-07100KL | Meshcore:R_0805_2012Metric | Na-ion: FIT; LTO 2S: FIT | https://www.danomsk.ru/shop/6-rezistory/86-rezistory-postoyannye/268-rezistory-chip-0805/134751-chip-0805-100k-1-rc0805fr-07100k-yageo/ | R_0805_2012Metric | Danomsk | GPS switch bias / UART input defined when module disconnected.
R44 | 1k | 1k | yes | yes | RC0805FR-071KL | RC0805FR-071KL | 1k | yes | RC0805FR-071KL | Meshcore:R_0805_2012Metric | Na-ion: FIT; LTO 2S: FIT | https://www.danomsk.ru/shop/6-rezistory/86-rezistory-postoyannye/268-rezistory-chip-0805/140165-chip-0805-1-00k-1-rc0805fr-071kl-yageo/ | R_0805_2012Metric | Danomsk | GPS switch bias / UART input defined when module disconnected.
R45 | 100k | 100k | yes | yes | RC0805FR-07100KL | RC0805FR-07100KL | 100k | yes | RC0805FR-07100KL | Meshcore:R_0805_2012Metric | Na-ion: FIT; LTO 2S: FIT | https://www.danomsk.ru/shop/6-rezistory/86-rezistory-postoyannye/268-rezistory-chip-0805/134751-chip-0805-100k-1-rc0805fr-07100k-yageo/ | R_0805_2012Metric | Danomsk | GPS switch bias / UART input defined when module disconnected.
R46 | 100k | 100k | yes | yes | RC0805FR-07100KL | RC0805FR-07100KL | 100k | yes | RC0805FR-07100KL | Meshcore:R_0805_2012Metric | Na-ion: FIT; LTO 2S: FIT | https://www.danomsk.ru/shop/6-rezistory/86-rezistory-postoyannye/268-rezistory-chip-0805/134751-chip-0805-100k-1-rc0805fr-07100k-yageo/ | R_0805_2012Metric | Danomsk | GPS switch bias / UART input defined when module disconnected.
U7 | SN74LVC2G125 | SN74LVC2G125 | yes | yes | SN74LVC2G125DCTR | SN74LVC2G125DCTR | SN74LVC2G125 | yes | SN74LVC2G125DCTR | Meshcore:TI_DCT0008A | Na-ion: FIT; LTO 2S: FIT | https://www.ti.com/product/SN74LVC2G125 | TI_DCT0008A | Other supplier | Both UART directions buffered from switched GPS supply. TI Ioff partial-power-down protection prevents UART back-power; DCT pinout: 1 OE1, 2 A1, 3 Y2, 4 GND, 5 A2, 6 Y1, 7 OE2, 8 VCC.
C56 | 100nF 50V X7R | 100nF 50V X7R | yes | yes | CL21B104KBCNNNC | CL21B104KBCNNNC | 100nF 50V X7R | yes | CL21B104KBCNNNC | Meshcore:C_0805_2012Metric | Na-ion: FIT; LTO 2S: FIT | https://www.danomsk.ru/shop/5-kondensatory/89-kondensatory-keramicheskie/732-kondensatory-smd-0805/196705-chip-kond-0805-x7r-0-10uf-10-50v-cl21b104kbcnnnc-cc0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 | C_0805_2012Metric | Danomsk | Local U7 bypass.
C57 | 10uF 16V X7R | 10uF 16V X7R | yes | yes | CL21B106KOQNNNE | CL21B106KOQNNNE | 10uF 16V X7R | yes | CL21B106KOQNNNE | Meshcore:C_0805_2012Metric | Na-ion: FIT; LTO 2S: FIT | https://www.danomsk.ru/shop/5-kondensatory/89-kondensatory-keramicheskie/732-kondensatory-smd-0805/194763-chip-kond-0805-x7r-10uf-10-16v-cl21b106koqnnne-cc080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 | C_0805_2012Metric | Danomsk | GPS switched rail decoupling; module carries its own local bypass.
R47 | 2R 1% | 2R 1% | no | yes | RC0805FR-072RL | RC0805FR-072RL | 2R 1% | no | RC0805FR-072RL | Meshcore:R_0805_2012Metric | Na-ion: DNP; LTO 2S: FIT |  | R_0805_2012Metric | Danomsk priority; stock not checked | LTO ONLY. User selected2ohm after audit; LMV431A current is not bounded to15mA over full tolerance/temperature corners. Not individual cell protection.
R48 | 120k 0.1% | 120k 0.1% | no | yes | MPN TBD / 120k 0.1% | MPN TBD / 120k 0.1% | 120k 0.1% | no | MPN TBD / 120k 0.1% | Meshcore:R_0805_2012Metric | Na-ion: DNP; LTO 2S: FIT |  | R_0805_2012Metric | Danomsk priority; stock not checked | LTO ONLY; not fitted for Na-ion. User-selected divider 120k+2.49k / 100k, 0.1%.
R49 | 2.49k 0.1% | 2.49k 0.1% | no | yes | MPN TBD / 2.49k 0.1% | MPN TBD / 2.49k 0.1% | 2.49k 0.1% | no | MPN TBD / 2.49k 0.1% | Meshcore:R_0805_2012Metric | Na-ion: DNP; LTO 2S: FIT |  | R_0805_2012Metric | Danomsk priority; stock not checked | LTO ONLY; not fitted for Na-ion. User-selected divider 120k+2.49k / 100k, 0.1%.
R50 | 100k 0.1% | 100k 0.1% | no | yes | MPN TBD / 100k 0.1% | MPN TBD / 100k 0.1% | 100k 0.1% | no | MPN TBD / 100k 0.1% | Meshcore:R_0805_2012Metric | Na-ion: DNP; LTO 2S: FIT |  | R_0805_2012Metric | Danomsk priority; stock not checked | LTO ONLY; not fitted for Na-ion. User-selected divider 120k+2.49k / 100k, 0.1%.
U8 | LMV431A | LMV431A | no | yes | LMV431AIM5/NOPB | LMV431AIM5/NOPB | LMV431A | no | LMV431AIM5/NOPB | Meshcore:SOT-23-5 | Na-ion: DNP; LTO 2S: FIT | https://www.ti.com/product/LMV431 | SOT-23-5 | Other supplier | LTO ONLY; TI M5: 1 NC, 2 A, 3 K, 4 REF, 5 A. Upper channel anodes go to LTO_MID, not GND. Divider changed at user request to 120k+2.49k / 100k, 0.1%.
C58 | 47nF 16V X7R | 47nF 16V X7R | no | yes | MPN TBD / 47nF X7R 16V | MPN TBD / 47nF X7R 16V | 47nF 16V X7R | no | MPN TBD / 47nF X7R 16V | Meshcore:C_0805_2012Metric | Na-ion: DNP; LTO 2S: FIT |  | C_0805_2012Metric | Danomsk priority; stock not checked | LTO ONLY; 47nF across cathode-anode, as supplied.
R51 | 2R 1% | 2R 1% | no | yes | RC0805FR-072RL | RC0805FR-072RL | 2R 1% | no | RC0805FR-072RL | Meshcore:R_0805_2012Metric | Na-ion: DNP; LTO 2S: FIT |  | R_0805_2012Metric | Danomsk priority; stock not checked | LTO ONLY. User selected2ohm after audit; LMV431A current is not bounded to15mA over full tolerance/temperature corners. Not individual cell protection.
R52 | 120k 0.1% | 120k 0.1% | no | yes | MPN TBD / 120k 0.1% | MPN TBD / 120k 0.1% | 120k 0.1% | no | MPN TBD / 120k 0.1% | Meshcore:R_0805_2012Metric | Na-ion: DNP; LTO 2S: FIT |  | R_0805_2012Metric | Danomsk priority; stock not checked | LTO ONLY; not fitted for Na-ion. User-selected divider 120k+2.49k / 100k, 0.1%.
R53 | 2.49k 0.1% | 2.49k 0.1% | no | yes | MPN TBD / 2.49k 0.1% | MPN TBD / 2.49k 0.1% | 2.49k 0.1% | no | MPN TBD / 2.49k 0.1% | Meshcore:R_0805_2012Metric | Na-ion: DNP; LTO 2S: FIT |  | R_0805_2012Metric | Danomsk priority; stock not checked | LTO ONLY; not fitted for Na-ion. User-selected divider 120k+2.49k / 100k, 0.1%.
R54 | 100k 0.1% | 100k 0.1% | no | yes | MPN TBD / 100k 0.1% | MPN TBD / 100k 0.1% | 100k 0.1% | no | MPN TBD / 100k 0.1% | Meshcore:R_0805_2012Metric | Na-ion: DNP; LTO 2S: FIT |  | R_0805_2012Metric | Danomsk priority; stock not checked | LTO ONLY; not fitted for Na-ion. User-selected divider 120k+2.49k / 100k, 0.1%.
U9 | LMV431A | LMV431A | no | yes | LMV431AIM5/NOPB | LMV431AIM5/NOPB | LMV431A | no | LMV431AIM5/NOPB | Meshcore:SOT-23-5 | Na-ion: DNP; LTO 2S: FIT | https://www.ti.com/product/LMV431 | SOT-23-5 | Other supplier | LTO ONLY; TI M5: 1 NC, 2 A, 3 K, 4 REF, 5 A. Upper channel anodes go to LTO_MID, not GND. Divider changed at user request to 120k+2.49k / 100k, 0.1%.
C59 | 47nF 16V X7R | 47nF 16V X7R | no | yes | MPN TBD / 47nF X7R 16V | MPN TBD / 47nF X7R 16V | 47nF 16V X7R | no | MPN TBD / 47nF X7R 16V | Meshcore:C_0805_2012Metric | Na-ion: DNP; LTO 2S: FIT |  | C_0805_2012Metric | Danomsk priority; stock not checked | LTO ONLY; 47nF across cathode-anode, as supplied.
J12 | LTO 2S + MID - | LTO 2S + MID - | no | yes | DS1021-1X40SF11-B | DS1021-1X40SF11-B | LTO 2S + MID - | no | DS1021-1X40SF11-B | Meshcore:PinHeader_1x03_P2.54mm_Vertical | Na-ion: DNP; LTO 2S: FIT | https://www.danomsk.ru/shop/7-kommutatsiya/121-razemy/306-soediniteli-pryamougolnye/195992-pls-40-ds1021-1x40sf11-b-vilka-na-platu-shag-2-54mm-maks-dopust-tok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 | PinHeader_1x03_P2.54mm_Vertical | Danomsk | LTO ONLY. 1 PACK+, 2 CELL MIDPOINT, 3 PACK-. Na-ion uses J8; do not bridge midpoint to ground.
FB1 | 60R@100MHz / 3A | 60R@100MHz / 3A | yes | yes | BLM21PG600SN1D | BLM21PG600SN1D | 60R@100MHz / 3A | yes | BLM21PG600SN1D | Meshcore:Ferrite_Murata_BLM21PG | Na-ion: FIT; LTO 2S: FIT | https://www.murata.com/en-eu/products/productdetail?partno=BLM21PG600SN1%23 | Ferrite_Murata_BLM21PG | Other supplier; Danomsk exact stock not confirmed | Separate radio supply branch. Ferrite60ohm at100MHz, conservative3A rating, DCRmax20mohm specifiedbyMurata. Nominal3mVdropat150mA. CustomCu lands per archivedMurataC31E6; mask/paste engineering choices. Prototype load-step/noise/resonance qualification required.
J13 | SMA 50Ohm | SMA 50Ohm | yes | yes | L-KLS1-SMA002-B | L-KLS1-SMA002-B | SMA 50Ohm | yes | L-KLS1-SMA002-B | Meshcore:SMA_KLS1_SMA002_B_Horizontal | Na-ion: FIT; LTO 2S: FIT | https://www.danomsk.ru/shop/7-kommutatsiya/121-razemy/308-soediniteli-vch/206542-sma-gnezdo-sma-jr-l-kls1-sma002-b-uglovoe-gold-plating-kls/ | SMA / right angle / through hole | Danomsk | Four shield anchors to GND; center contact to ANT_SMA through optional FL1 / permanent NT1 bypass. KLS official drawing V0 2025-07-28, page 1: 5.08 x 5.08 mm anchor centers, RF drill 1.30 mm and four GND drills 1.70 mm. Not the -1.27 variant.
FL1 | S869M000S003 | S869M000S003 | no | no | S869M000S003 | S869M000S003 | S869M000S003 | no | S869M000S003 | Meshcore:SAW_AEL_DCC6C_S869M000S003 | Na-ion: DNP / RF option; LTO 2S: DNP / RF option | https://www.farnell.com/datasheets/1881554.pdf | DCC6C / 3 x 3 x 1.3 mm | AEL / optional | OPTION, not fitted by default. Cut NT1 copper under the filter BEFORE fitting. 868-870MHz, maximum RF input +13dBm: reduce modem transmit power when fitted. Pins2 input,5 output,1/3/4/6 ground. Engineering land pattern from package drawing.
NT1 | Cu link / cut for FL1 | Cu link / cut for FL1 | yes | yes | PCB copper / not purchased | PCB copper / not purchased | Cu link / cut for FL1 | yes | PCB copper / not purchased | Meshcore:RF_Cut_Link_0p6 | Na-ion: PCB copper; LTO 2S: PCB copper |  | PCB copper |  | Permanent RF copper bypass under optional FL1. Not a purchased component. Leave continuous when FL1 is absent; cut central bar before fitting FL1. Inspect complete isolation before soldering the filter.
TP8 | FILTER_MID | FILTER_MID | yes | yes | PCB test pad / not purchased | PCB test pad / not purchased | FILTER_MID | yes | PCB test pad / not purchased | Meshcore:TestPoint_Pad_D1.5mm | Na-ion: PCB copper; LTO 2S: PCB copper |  | PCB test pad |  | Test point between L3/L4.
TP9 | SOLAR | SOLAR | yes | yes | PCB test pad / not purchased | PCB test pad / not purchased | SOLAR | yes | PCB test pad / not purchased | Meshcore:TestPoint_Pad_D1.5mm | Na-ion: PCB copper; LTO 2S: PCB copper |  | PCB test pad |  | Solar VIN test point after J7, before Q1.
R55 | 47mR 1% | 47mR 1% | yes | yes | WSL1206R0470FEA | WSL1206R0470FEA | 47mR 1% | yes | WSL1206R0470FEA | Meshcore:R_Vishay_WSL1206_18 | Na-ion: FIT; LTO 2S: FIT | https://www.chipdip.ru/product/wsl1206r0470fea-current-sense-resistors-smd-1-4watt-vishay-8005236780 | 1206 / 0.25 W | ChipDip / Vishay | 47mOhm series resistor after local TPS63802 C14/FB sense, before L3. Voltage loss I*0.047 ohm, dissipated power I^2*0.047 ohm.
R56 | 1.8 ohm 1% 0.125W | 0R jumper | yes | yes | RC0805FR-071R8L | RC0805JR-070RL | 0R jumper | yes | RC0805JR-070RL | Meshcore:R_0805_2012Metric | Na-ion cold option: FIT; LTO 2S: 0R JUMPER | https://www.danomsk.ru/shop/6-rezistory/86-rezistory-postoyannye/268-rezistory-chip-0805/140061-chip-0805-1-8-1-rc0805fr-071r8l-yageo/ | R_0805_2012Metric | Danomsk / Yageo | Optional cold-current series shunt 1.8 ohm 1%, in series with R1 0.28 ohm. Cold CC approximately96mA, dissipation approximately16.6mW. LTO or no-thermal build: fit0R jumper here; R1 stays0.28ohm.
Q4 | AO3401A | AO3401A | yes | no | AO3401A | AO3401A | AO3401A | no | AO3401A | Meshcore:SOT-23 | Na-ion cold option: FIT; LTO 2S: DNP | https://www.danomsk.ru/shop/4-tranzistory/126-tranzistory-importnye/168774-ao3401a-sot23-p-kanal-30v-4a-1-4vt-a-o/ | SOT-23 | Danomsk / Alpha & Omega Semiconductor | AOS AO3401A parallel warm bypass of R56. G1 common gate, S2 upstream CS_P, D3 intermediate CHG_CS_M. Body diode blocks forward-charge bypass when OFF. Three devices share current; retain symmetric short power branches.
Q6 | AO3401A | AO3401A | yes | no | AO3401A | AO3401A | AO3401A | no | AO3401A | Meshcore:SOT-23 | Na-ion cold option: FIT; LTO 2S: DNP | https://www.danomsk.ru/shop/4-tranzistory/126-tranzistory-importnye/168774-ao3401a-sot23-p-kanal-30v-4a-1-4vt-a-o/ | SOT-23 | Danomsk / Alpha & Omega Semiconductor | AOS AO3401A parallel warm bypass of R56. G1 common gate, S2 upstream CS_P, D3 intermediate CHG_CS_M. Body diode blocks forward-charge bypass when OFF. Three devices share current; retain symmetric short power branches.
Q7 | AO3401A | AO3401A | yes | no | AO3401A | AO3401A | AO3401A | no | AO3401A | Meshcore:SOT-23 | Na-ion cold option: FIT; LTO 2S: DNP | https://www.danomsk.ru/shop/4-tranzistory/126-tranzistory-importnye/168774-ao3401a-sot23-p-kanal-30v-4a-1-4vt-a-o/ | SOT-23 | Danomsk / Alpha & Omega Semiconductor | AOS AO3401A parallel warm bypass of R56. G1 common gate, S2 upstream CS_P, D3 intermediate CHG_CS_M. Body diode blocks forward-charge bypass when OFF. Three devices share current; retain symmetric short power branches.
R58 | 100k 1% | 100k 1% | yes | no | RC0805FR-07100KL | RC0805FR-07100KL | 100k 1% | no | RC0805FR-07100KL | Meshcore:R_0805_2012Metric | Na-ion cold option: FIT; LTO 2S: DNP | https://www.danomsk.ru/shop/6-rezistory/86-rezistory-postoyannye/268-rezistory-chip-0805/134751-chip-0805-100k-1-rc0805fr-07100k-yageo/ | R_0805_2012Metric | Danomsk / Yageo | 100k gate-to-source pullup for Q4/Q6/Q7; selects cold current with gate driver inactive.
U10 | LM393XK | LM393XK | yes | no | LM393XK | LM393XK | LM393XK | no | LM393XK | Meshcore:SOIC-8_3.9x4.9mm_P1.27mm | Na-ion cold option: FIT; LTO 2S: DNP | https://www.danomsk.ru/shop/2-mikroskhemy/756-usiliteli-i-komparatory/122914-lm393xk-so-8-runic/ | SOIC-8_3.9x4.9mm_P1.27mm | Danomsk / Runic | Runic LM393XK dual open-collector comparator, selected Rev A.2 datasheet. Both outputs tied; cold or shorted NTC pulls WARM low. Pin8 SOLAR, pin4 GND.
U11 | LM285Z-2.5G | LM285Z-2.5G | yes | no | LM285Z-2.5G | LM285Z-2.5G | LM285Z-2.5G | no | LM285Z-2.5G | Meshcore:TO-92_Inline | Na-ion cold option: FIT; LTO 2S: DNP | https://www.danomsk.ru/shop/2-mikroskhemy/757-mikroskhemy-upravleniya-pitaniem/760-istochniki-opornogo-napryazheniya-i-toka/75628-lm285z-2-5g-to-92-ons/ | TO-92_Inline | Danomsk / ON Semiconductor | ON LM285Z-2.5G fixed shunt reference. TO-92 pins:1NC,2K,3A. Minimum operating reference current30uA; original T2 conservative worst-case budget35.857uA.
Q5 | BSS138 | BSS138 | yes | no | BSS138 | BSS138 | BSS138 | no | BSS138 | Meshcore:SOT-23 | Na-ion cold option: FIT; LTO 2S: DNP | https://www.danomsk.ru/shop/4-tranzistory/126-tranzistory-importnye/79502-bss138-sot23-n-kanal-50v-0-22a-6om-hottech/ | SOT-23 | Danomsk / Hottech | Hottech BSS138 G1/S2/D3, gate pulldown driver. Original T2 uses a Diodes surrogate model; physical startup to verify.
R57 | 47k 1% 0.125W | 47k 1% 0.125W | yes | no | RC0805FR-0747KL | RC0805FR-0747KL | 47k 1% 0.125W | no | RC0805FR-0747KL | Meshcore:R_0805_2012Metric | Na-ion cold option: FIT; LTO 2S: DNP | https://www.danomsk.ru/shop/6-rezistory/86-rezistory-postoyannye/268-rezistory-chip-0805/140256-chip-0805-47-0k-1-rc0805fr-0747kl-yageo/ | R_0805_2012Metric | Danomsk / Yageo | 47k reference feed from SOLAR. LM285 current budget verified in original T2 at7.5V input, including all reference loads.
R59 | 100k 1% | 100k 1% | yes | no | RC0805FR-07100KL | RC0805FR-07100KL | 100k 1% | no | RC0805FR-07100KL | Meshcore:R_0805_2012Metric | Na-ion cold option: FIT; LTO 2S: DNP | https://www.danomsk.ru/shop/6-rezistory/86-rezistory-postoyannye/268-rezistory-chip-0805/134751-chip-0805-100k-1-rc0805fr-07100k-yageo/ | R_0805_2012Metric | Danomsk / Yageo | 100k pullup of NTC sense node to2.5V reference.
R60 | 100k 1% | 100k 1% | yes | no | RC0805FR-07100KL | RC0805FR-07100KL | 100k 1% | no | RC0805FR-07100KL | Meshcore:R_0805_2012Metric | Na-ion cold option: FIT; LTO 2S: DNP | https://www.danomsk.ru/shop/6-rezistory/86-rezistory-postoyannye/268-rezistory-chip-0805/134751-chip-0805-100k-1-rc0805fr-07100k-yageo/ | R_0805_2012Metric | Danomsk / Yageo | 100k upper threshold leg in series with R69 30k; total130k.
R69 | 30k 1% | 30k 1% | yes | no | RC0805FR-0730KL | RC0805FR-0730KL | 30k 1% | no | RC0805FR-0730KL | Meshcore:R_0805_2012Metric | Na-ion cold option: FIT; LTO 2S: DNP | https://www.danomsk.ru/shop/6-rezistory/86-rezistory-postoyannye/268-rezistory-chip-0805/140246-chip-0805-30-0k-1-rc0805fr-0730kl-yageo/ | R_0805_2012Metric | Danomsk / Yageo | 30k series trim of upper threshold leg R60. Original T2 nominal cold-entry -17.4C at sensor.
R61 | 100k 1% | 100k 1% | yes | no | RC0805FR-07100KL | RC0805FR-07100KL | 100k 1% | no | RC0805FR-07100KL | Meshcore:R_0805_2012Metric | Na-ion cold option: FIT; LTO 2S: DNP | https://www.danomsk.ru/shop/6-rezistory/86-rezistory-postoyannye/268-rezistory-chip-0805/134751-chip-0805-100k-1-rc0805fr-07100k-yageo/ | R_0805_2012Metric | Danomsk / Yageo | 100k lower threshold leg toGND.
R62 | 1M 1% | 1M 1% | yes | no | RC0805FR-071ML | RC0805FR-071ML | 1M 1% | no | RC0805FR-071ML | Meshcore:R_0805_2012Metric | Na-ion cold option: FIT; LTO 2S: DNP | https://www.danomsk.ru/shop/6-rezistory/86-rezistory-postoyannye/268-rezistory-chip-0805/136361-chip-0805-1-0m-1-rc0805fr-071ml-yageo/ | R_0805_2012Metric | Danomsk / Yageo | 1M hysteresis feedback in series with R70 150k; total1.15M.
R70 | 150k 1% | 150k 1% | yes | no | RC0805FR-07150KL | RC0805FR-07150KL | 150k 1% | no | RC0805FR-07150KL | Meshcore:R_0805_2012Metric | Na-ion cold option: FIT; LTO 2S: DNP | https://www.danomsk.ru/shop/6-rezistory/86-rezistory-postoyannye/268-rezistory-chip-0805/134752-chip-0805-150k-1-rc0805fr-07150k-yageo/ | R_0805_2012Metric | Danomsk / Yageo | 150k series trim of hysteresis leg R62. Original T2 nominal warm-return -14.5C at sensor.
R63 | 100k 1% | 100k 1% | yes | no | RC0805FR-07100KL | RC0805FR-07100KL | 100k 1% | no | RC0805FR-07100KL | Meshcore:R_0805_2012Metric | Na-ion cold option: FIT; LTO 2S: DNP | https://www.danomsk.ru/shop/6-rezistory/86-rezistory-postoyannye/268-rezistory-chip-0805/134751-chip-0805-100k-1-rc0805fr-07100k-yageo/ | R_0805_2012Metric | Danomsk / Yageo | 100k pullup of wired open-collector comparator outputs toVREF.
R64 | 1.2M 1% | 1.2M 1% | yes | no | RC0805FR-071M2L | RC0805FR-071M2L | 1.2M 1% | no | RC0805FR-071M2L | Meshcore:R_0805_2012Metric | Na-ion cold option: FIT; LTO 2S: DNP | https://www.danomsk.ru/shop/6-rezistory/86-rezistory-postoyannye/268-rezistory-chip-0805/136362-chip-0805-1-2m-1-rc0805fr-071m2l-yageo/ | R_0805_2012Metric | Danomsk / Yageo | 1.2M upper leg of NTC-short detection threshold.
R65 | 10k 1% | 10k 1% | yes | no | RC0805FR-0710KL | RC0805FR-0710KL | 10k 1% | no | RC0805FR-0710KL | Meshcore:R_0805_2012Metric | Na-ion cold option: FIT; LTO 2S: DNP | https://www.danomsk.ru/shop/6-rezistory/86-rezistory-postoyannye/268-rezistory-chip-0805/140222-chip-0805-10k-1-rc0805fr-0710kl-yageo/ | R_0805_2012Metric | Danomsk / Yageo | 10k lower leg of NTC-short detection threshold.
R66 | 1k 1% | 1k 1% | yes | no | RC0805FR-071KL | RC0805FR-071KL | 1k 1% | no | RC0805FR-071KL | Meshcore:R_0805_2012Metric | Na-ion cold option: FIT; LTO 2S: DNP | https://www.danomsk.ru/shop/6-rezistory/86-rezistory-postoyannye/268-rezistory-chip-0805/140165-chip-0805-1-00k-1-rc0805fr-071kl-yageo/ | R_0805_2012Metric | Danomsk / Yageo | 1k series resistor between comparator WARM output and Q5 gate.
R67 | 1M 1% | 1M 1% | yes | no | RC0805FR-071ML | RC0805FR-071ML | 1M 1% | no | RC0805FR-071ML | Meshcore:R_0805_2012Metric | Na-ion cold option: FIT; LTO 2S: DNP | https://www.danomsk.ru/shop/6-rezistory/86-rezistory-postoyannye/268-rezistory-chip-0805/136361-chip-0805-1-0m-1-rc0805fr-071ml-yageo/ | R_0805_2012Metric | Danomsk / Yageo | 1M gate-to-source pulldown at Q5.
R68 | 1k 1% | 1k 1% | yes | no | RC0805FR-071KL | RC0805FR-071KL | 1k 1% | no | RC0805FR-071KL | Meshcore:R_0805_2012Metric | Na-ion cold option: FIT; LTO 2S: DNP | https://www.danomsk.ru/shop/6-rezistory/86-rezistory-postoyannye/268-rezistory-chip-0805/140165-chip-0805-1-00k-1-rc0805fr-071kl-yageo/ | R_0805_2012Metric | Danomsk / Yageo | 1k series resistor between Q5 drain and common PMOS gate.
C60 | 100nF 100V X7R | 100nF 100V X7R | yes | no | CC0805KKX7R0BB104 | CC0805KKX7R0BB104 | 100nF 100V X7R | no | CC0805KKX7R0BB104 | Meshcore:C_0805_2012Metric | Na-ion cold option: FIT; LTO 2S: DNP | https://www.danomsk.ru/shop/5-kondensatory/89-kondensatory-keramicheskie/732-kondensatory-smd-0805/168995-chip-kond-0805-x7r-0-1uf-10-100v-cc0805kkx7r0bb104-c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 | C_0805_2012Metric | Danomsk / Yageo | Local100nF bypass from U10 SOLAR supply toGND.
C61 | 1nF 100V C0G | 1nF 100V C0G | yes | no | CC0805JRNPO0BN102 | CC0805JRNPO0BN102 | 1nF 100V C0G | no | CC0805JRNPO0BN102 | Meshcore:C_0805_2012Metric | Na-ion cold option: FIT; LTO 2S: DNP | https://www.danomsk.ru/shop/5-kondensatory/89-kondensatory-keramicheskie/732-kondensatory-smd-0805/181581-chip-kond-0805-np0-1000pf-5-100v-cc0805jrnpo0bn102-c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 | C_0805_2012Metric | Danomsk / Yageo | 1nF NTC sense filter toGND, unchanged from original T2 startup analysis.
C62 | 100nF 100V X7R | 100nF 100V X7R | yes | no | CC0805KKX7R0BB104 | CC0805KKX7R0BB104 | 100nF 100V X7R | no | CC0805KKX7R0BB104 | Meshcore:C_0805_2012Metric | Na-ion cold option: FIT; LTO 2S: DNP | https://www.danomsk.ru/shop/5-kondensatory/89-kondensatory-keramicheskie/732-kondensatory-smd-0805/168995-chip-kond-0805-x7r-0-1uf-10-100v-cc0805kkx7r0bb104-c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 | C_0805_2012Metric | Danomsk / Yageo | 100nF comparator-output filter toGND, unchanged from T2.
TH1 | 10k NTC 1% B3988 | 10k NTC 1% B3988 | yes | no | B57861S0103F040 | B57861S0103F040 | 10k NTC 1% B3988 | no | B57861S0103F040 | Meshcore:NTC_TDK_B57861S_Onboard_or_Remote_P2.54mm | Na-ion cold option: FIT; LTO 2S: DNP | https://www.danomsk.ru/shop/6-rezistory/87-rezistory-nelineynye/272-termorezistory/153655-b57861s0103f040-ntc-termistor-10kom-0-06vt-1-2-41mm-epcos/ | NTC_TDK_B57861S_Onboard_or_Remote_P2.54mm | Danomsk / TDK/EPCOS | Fit ONE B57861S0103F040 onboard under SH1 or ONE remote sensor at the cell to these pads. No parallel sensors. Body diameter<=2.41mm and length<=6.5mm. Form/cut flexible leads toP2.54; keep>=4.5mm straight near body and bend radius>=0.75mm. Vertical assembly height<=12.5mm, check formed sample against14mm cover. Onboard measures shield interior, not cell temperature.
