Alksndr55/mesh-repeater/bom/NOTES_RU.txt

Mesh Repeater ver 1.0 — BOM S4.21, 18.10.2026

Текущий список: S4_21_COMPONENT_BOM.csv, 172 позиции.
Выбрать один вариант NaIon / NaIon_NoCold / LTO_2S и совместно использовать
столбцы Fit_*, Value_* и MPN_* этого варианта. Значения и партномера перенесены
из проверенного проекта без автоматических замен.

SH1 и TP6 удалены. Рамка/крышка экрана не входят в текущую сборку.
Старые shopping.csv и таблицы S4.16 больше не являются текущим списком закупки.
Сохранённые ссылки поставщиков не подтверждают текущие наличие и цену.
Пустой MPN, «MPN not selected» и иные пометки неопределённости остаются
невыбранными позициями; необходимо выбрать точную деталь перед покупкой.
Nice!Nano и HT-RA62 заказываются как модули. NT1/NT2 и монтажные позиции
не следует автоматически считать отдельными покупными электронными деталями.

Перед сборкой прочитать ../docs/S4_21_ASSEMBLY_GUIDE_RU.md и
../docs/S4_21_ASSEMBLY_DELTA_RU.txt. J11 снимается перед подключением USB.
