Alksndr55/mesh-repeater/design/Meshcore_NaIon/3dmodels/Shield_Frame_76x49_3_Chamfer.step

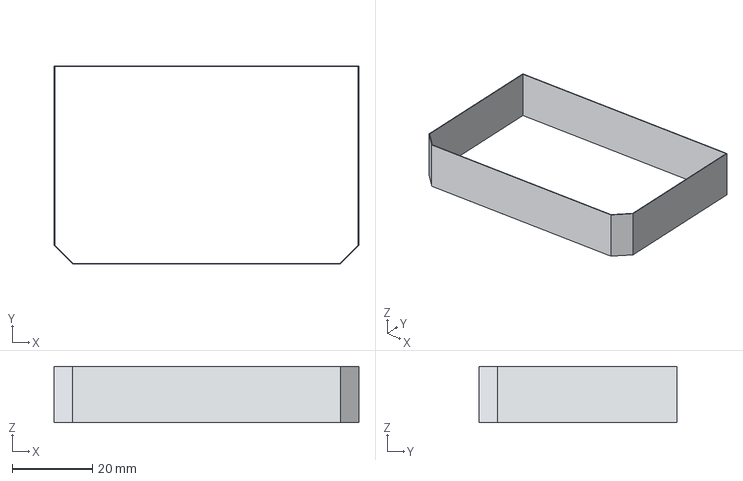
[picture p5: CAD file, 2026-10-18]
design/Meshcore_NaIon/3dmodels/Shield_Frame_76x49_3_Chamfer.step
76.2 x 49.5 x 14.0 mm
