Alksndr55/mesh-repeater/shared/schematic/3dmodels/Heltec_HT_RA62_Approx.step

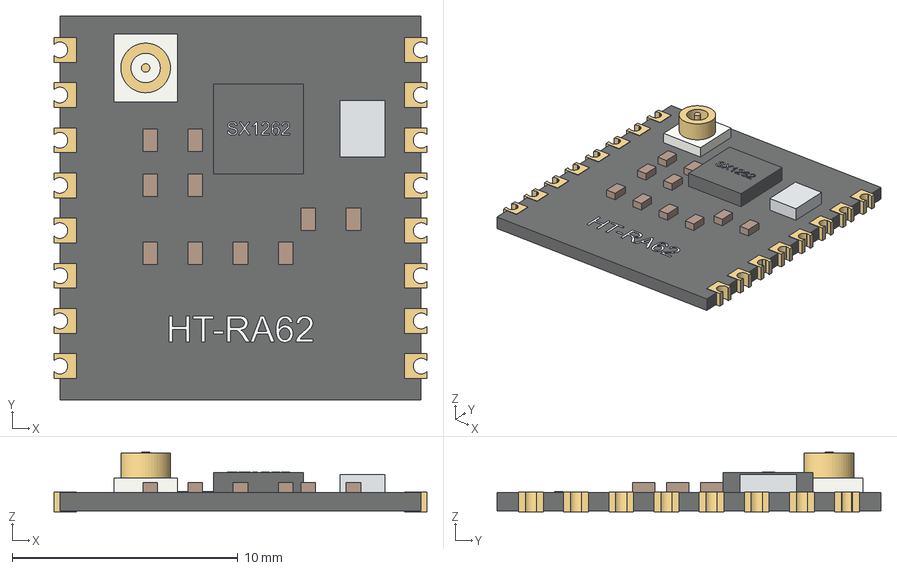
[picture p6: CAD file, 2026-10-24]
shared/schematic/3dmodels/Heltec_HT_RA62_Approx.step
16.5 x 17.0 x 2.65 mm
PCB
castellation0_0
castellation0_1
castellation0_2
castellation0_3
castellation0_4
castellation0_5
castellation0_6
castellation0_7
castellation1_0
castellation1_1
castellation1_2
castellation1_3
castellation1_4
castellation1_5
castellation1_6
castellation1_7
SX1262
mark_18
crystal
IPEX_base
IPEX_shell
IPEX_contact
passive0
passive1
passive2
passive3
passive4
passive5
passive6
passive7
passive8
passive9
mark_33
