Alksndr55/mesh-repeater/design/Meshcore_NaIon/3dmodels/Jumper_2p54_Shunt.step

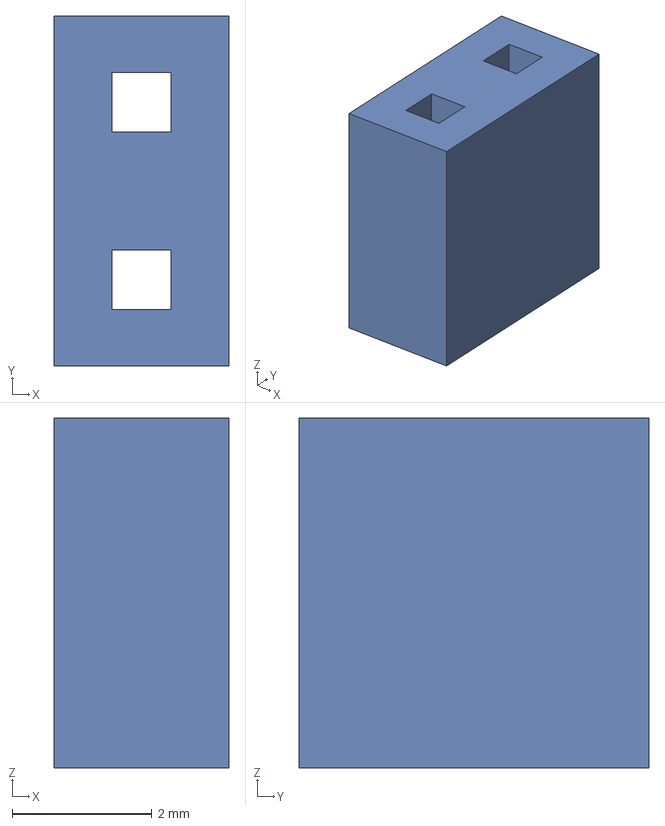
[picture p7: CAD file, 2026-10-18]
design/Meshcore_NaIon/3dmodels/Jumper_2p54_Shunt.step
2.50 x 5.00 x 5.00 mm
