Alksndr55/mesh-repeater/shared/schematic/3dmodels/Panasonic_EEEFK1E471P.step

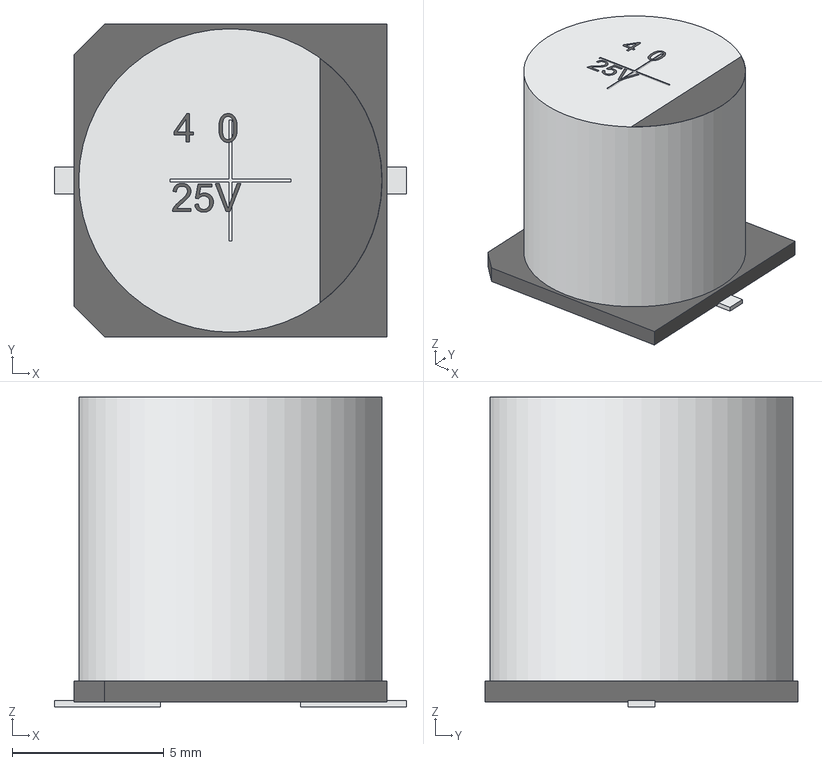
[picture p8: CAD file, 2026-10-24]
shared/schematic/3dmodels/Panasonic_EEEFK1E471P.step
11.6 x 10.3 x 10.2 mm
insulating_base
terminal_1
terminal_2
aluminum_can
negative_polarity_mark
mark_470
mark_25V
