Alksndr55/mesh-repeater/design/Meshcore_NaIon/3dmodels/XKB_TS1187A.step

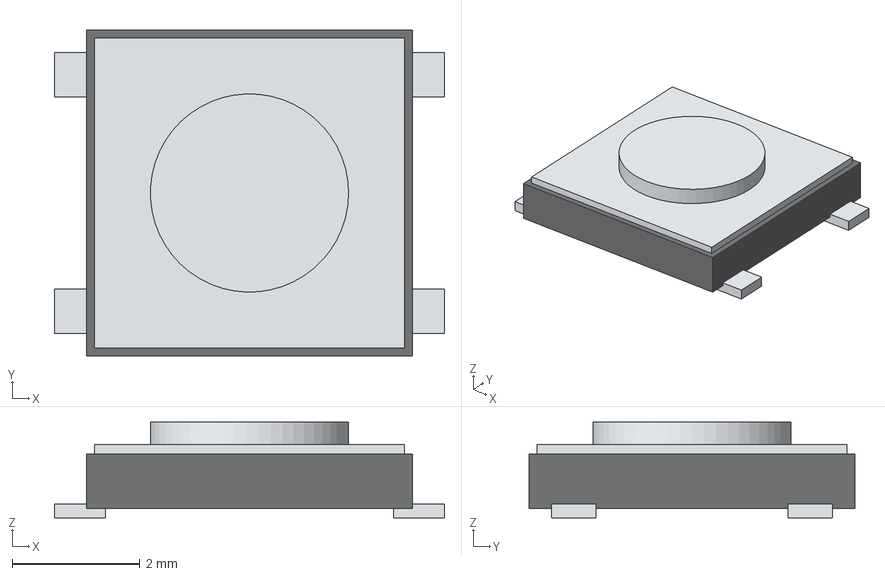
[picture p9: CAD file, 2026-10-18]
design/Meshcore_NaIon/3dmodels/XKB_TS1187A.step
6.10 x 5.10 x 1.50 mm
base
cap
actuator
lead00
lead01
lead10
lead11
