Alksndr55/mesh-repeater/shared/schematic/3dmodels/TI_DCT0008A.step

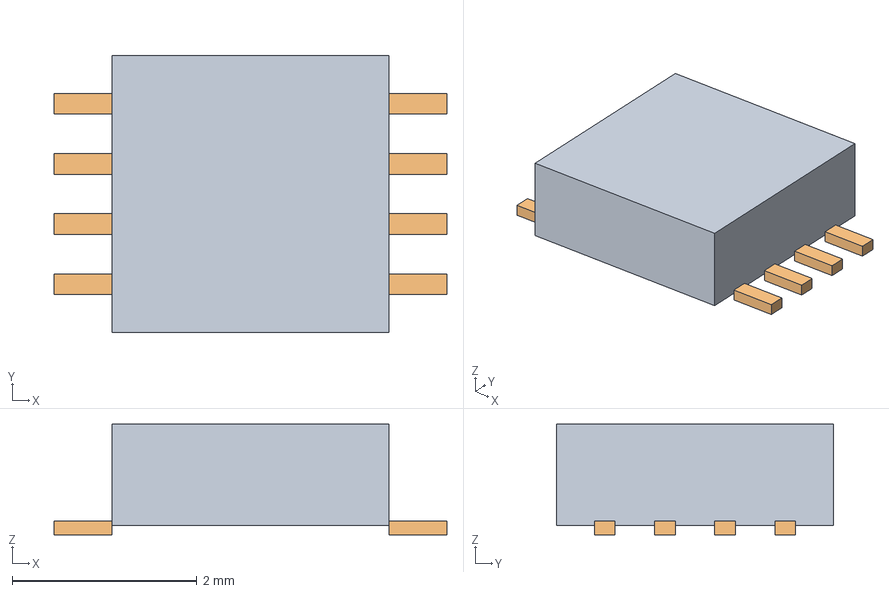
[picture p10: CAD file, 2026-10-24]
shared/schematic/3dmodels/TI_DCT0008A.step
4.25 x 3.00 x 1.20 mm
