Alksndr55/mesh-repeater/design/Meshcore_NaIon/3dmodels/Shield_Lid_76x49_3_Chamfer.step

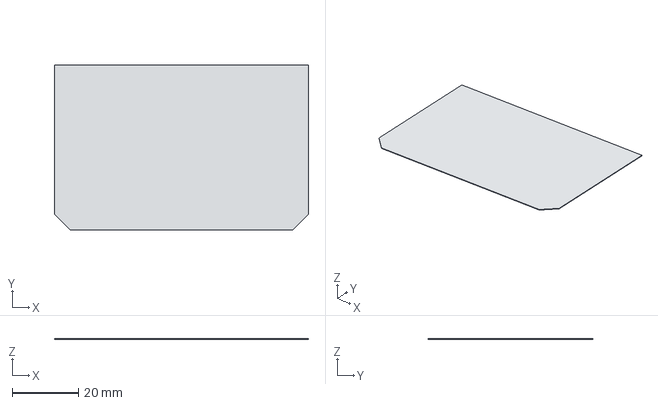
[picture p11: CAD file, 2026-10-18]
design/Meshcore_NaIon/3dmodels/Shield_Lid_76x49_3_Chamfer.step
76.4 x 49.7 x 0.2 mm
