Alksndr55/mesh-repeater/design/Meshcore_NaIon/3dmodels/Sunltech_SLW8040S.step

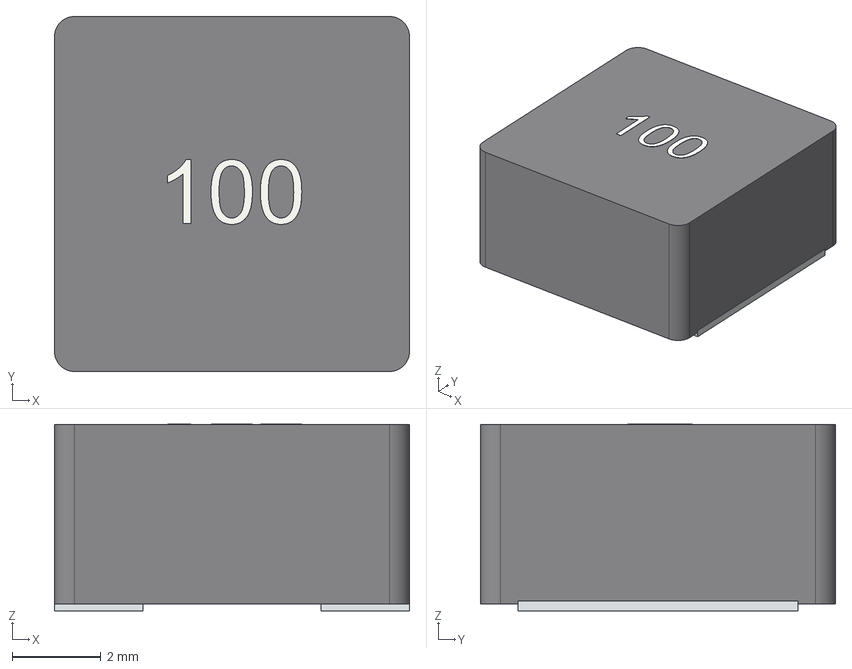
[picture p12: CAD file, 2026-10-18]
design/Meshcore_NaIon/3dmodels/Sunltech_SLW8040S.step
8.00 x 8.00 x 4.21 mm
ferrite
terminal0
terminal1
mark_3
