Alksndr55/mesh-repeater/design/Meshcore_NaIon/3dmodels/Coilcraft_XGL4020.step

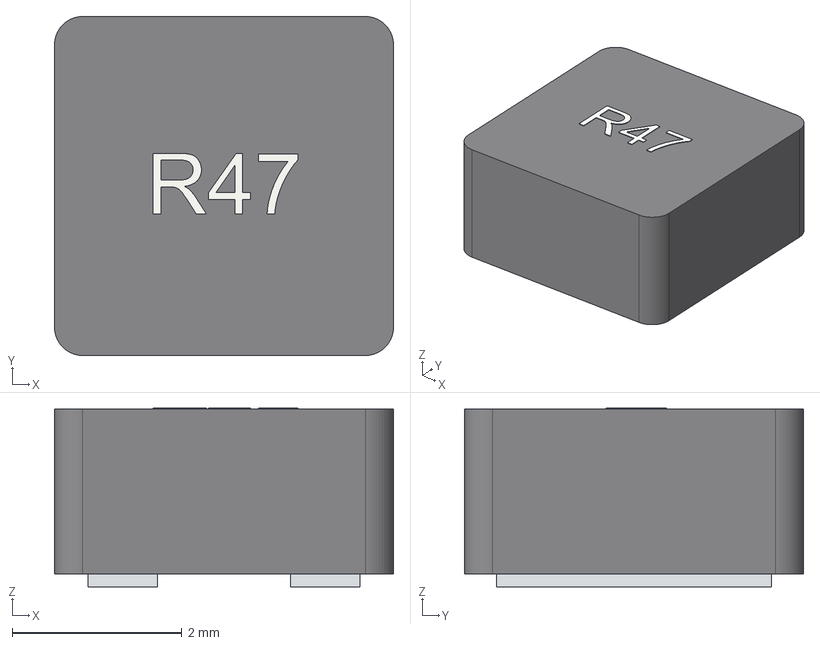
[picture p13: CAD file, 2026-10-10]
design/Meshcore_NaIon/3dmodels/Coilcraft_XGL4020.step
4.00 x 4.00 x 2.11 mm
ferrite
terminal0
terminal1
mark_3
