Alksndr55/mesh-repeater/design/Meshcore_NaIon/3dmodels/CR2032_Cell.step

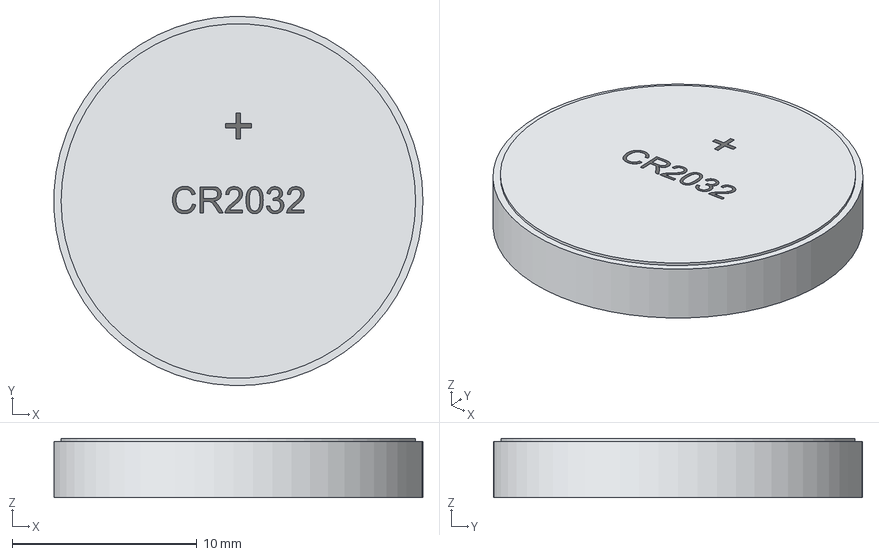
[picture p14: CAD file, 2026-10-10]
design/Meshcore_NaIon/3dmodels/CR2032_Cell.step
20.0 x 20.0 x 3.21 mm
case
positivecap
mark_2
mark_3
