Alksndr55/mesh-repeater/docs/S4_21_ASSEMBLY_DELTA_RU.txt

Mesh Repeater ver 1.0 — S4.21, 18.10.2026

Текущие исходники: design/Meshcore_NaIon.
Использовать BOM S4_21_COMPONENT_BOM.csv и её три варианта NaIon / NaIon_NoCold / LTO_2S. Электрические номиналы и выбор вариантов не менялись.
SH1 и TP6 исключены; рамки и крышки в текущей плате нет. Прежние инструкции S4.19 по установке рамки больше не действуют.
Маркировка компонентов остаётся лицевой, а где она не помещается — в точной проекции сзади.
TH1: один датчик, на плате либо выносной у ячейки; датчик на плате измеряет её локальную температуру. Не подключать два датчика параллельно.
Перед подключением USB снять шунт J11. Доработка Nice!Nano для прямого питания 3,3 В остаётся обязательной по выбранному варианту модуля.
Использовать только output/Mesh_Repeater_S4_21_Rezonit_Gerber.zip и docs/S4_21_REZONIT_ORDER_RU.txt. Gerber S4.20 не соответствует текущей плате.
Статические CAD-проверки не заменяют проверку прототипа под нагрузкой и измерение EMI.
