Alksndr55/mesh-repeater/v1/docs/ASSEMBLY_RU.md

# Mesh Repeater v1.22 — одноплатное исполнение

Ведущая разводка. Одна плата 90×100 мм, два слоя, толщина в CAD 1,52 мм.
Прежнее обозначение — S4.22. Компоненты спереди; NT2 сзади — медь PCB.
SH1 и TP6 исключены. Крепёж H1–H4 — NPTH M3.

[Общие номиналы, сборка и ограничения](../../docs/ASSEMBLY_COMMON_RU.md) ·
[BOM](../bom/COMPONENT_BOM.csv).

| Разъём | Контакты |
|---|---|
| J7 SOLAR | 1 SOLAR+, 2 GND |
| J8 Na-ion | 1 BAT+, 2 GND |
| J12 LTO | 1 BAT/PACK+, 2 LTO_MID, 3 GND/PACK− |
| J3 I²C | 1 SYS_3V3, 2 GND, 3 SCL, 4 SDA |
| J5 UART | 1 GND, 2 SYS_3V3, 3 TX платы, 4 RX платы |
| J10 ISP | 1 MISO, 2 SYS_3V3, 3 SCK, 4 MOSI, 5 RESET, 6 GND |
| J11 | 1 FILTER_OUT, 2 SYS_3V3; съёмная перемычка |
| J13 SMA | 1 RF, 2 GND |

J4 GPS: 1/2/3 NC, 4 RX GPS, 5 TX GPS, 6 резервное SYS_3V3,
7 управляемое GPS_3V3, 8 GND. Вид снизу зеркален; сверять номера площадок.
J12 трёхконтактный. Межплатных J101/J201 и отдельного экрана нет.
Корпуса разъёмов/кнопок задаются своей PCB и BOM. Над C15/C16 оставить ≥12,8 мм.

Watchdog U6 использует каноническую прошивку v1.00: PB3/вывод 2 — TXEN
через R38 с подтяжкой R39 к GND; PB0/вывод 5 — MCU_RESET через R37.
Перед ISP J10 снять R37, после вернуть; LFUSE=0x73, HFUSE=0xFB, SCK 100 мкс.
C33 развязывает питание; входной конденсатор 10 нФ на PB3 не установлен.
[Подключение, обновлённый алгоритм и программная проверка](../design/watchdog_reference/INTEGRATION_RU.txt).
