Alksndr55/mesh-repeater/docs/ASSEMBLY_COMMON_RU.md

# Общая электрическая часть Mesh Repeater

Основа обоих исполнений — ведущая v1 и общая схема
`shared/schematic/MeshRepeater.kicad_pro`: 150 функциональных позиций.
Состав выбирается по текущей BOM исполнения; механические детали различаются.

| Позиция/узел | Na-ion с COLD | Na-ion без COLD | LTO 2S |
|---|---|---|---|
| R3 | 60,4 кОм, 1% | 60,4 кОм, 1% | 118 кОм, 1% |
| R4 | 100 кОм, 1% | 100 кОм, 1% | 100 кОм, 1% |
| C30 | 12 пФ | 12 пФ | 6,8 пФ |
| R15 | 40,2 кОм | 40,2 кОм | 130 кОм |
| R56 | 1,8 Ом / 2512 | 0 Ом / 2512 | 0 Ом / 2512 |
| COLD A/B | Установить | DNP | DNP |
| BAL1/BAL2 | DNP | DNP | Установить |
| INA219 и R71–R73/C63–C64 | Установить | Установить | Установить |

R56 обязателен во всех вариантах. Для остальных деталей действуют поля Fit в BOM.
N/L означают Na-ion/LTO. TH1 — один NTC на плате либо один выносной датчик.
J8 и J12 относятся к общей BAT; независимые батареи одновременно не подключаются.

В ревизиях v1.26/v2.10 R31 унифицирован до 100 кОм. Это подтяжка USER,
а не цепь задания напряжения: с C26=100 нФ постоянная времени составляет
10 мс вместо 1 мс. Проверить отпускание кнопки и debounce на используемой прошивке;
внутренняя подтяжка MCU меняет эту постоянную времени. Номиналы точных делителей,
токозадающих резисторов, силовых шунтов и входных R72/R73 INA219 не унифицировались.
R72/R73 остаются по 10 Ом: увеличение до 1 кОм меняет фильтр и ошибки измерения.

Все обычные резисторы — 0805. C13 также переведён на 0805; C13/C60/C62 используют
общий CL21B104KBCNNNC, 100 нФ / 50 В / X7R. Силовые 2512, C1 1206,
электролиты и специальные посадки сохраняются. Число уникальных артикулов R/C
во всех вариантах сборки уменьшено с 44 до 42; комплектация каждого варианта
остаётся заданной BOM, включая DNP.

L2 должен иметь 0,47 мкГн; исходная модель — Coilcraft XGL4020-471MEC.
В новой посадке наружные края площадок расширены на 0,5 мм каждый, суммарно
на 1 мм. Внутренний зазор и исходные окна пасты сохранены. Это дополнительное
место для ручной пайки, а не подтверждение совместимости неизвестного дросселя:
для детали с донорской платы ещё нужны индуктивность, допустимый ток и DCR.
У U7 (SN74LVC2G125DCTR, SSOP DCT, 8 выводов) ключ первого вывода обозначен
треугольником на верхней шелкографии. R37 выделен рамкой и надписью W_RESET;
на время ISP его по-прежнему снимают.

R7=100 кОм, R8=10 кОм; типовая настройка MPPT около 11,44 В при 25°C.
R1=0,28 Ом. INA219AIDR: адрес 0x40, R71=0,1 Ом / 1% / 1 Вт;
заряд положительный, разряд отрицательный. BAT относится к аккумулятору,
BAT_SYS — к заряднику/преобразователю. Kelvin-подключения и отсутствие обхода
R71 сохраняются. Токи балансиров, EN и BAT_ADC обходят главный шунт R71.

Фильтр: SYS_PRE → R55=47 мОм → L3=2,4 мкГн → FILTER_MID → L4=2,4 мкГн
→ FILTER_OUT → J11 → звезда NT2. R40/R41=22 мОм остаются в ветвях C15/C16.
C15/C16 — по одному Panasonic EEEFK1E471P, 470 мкФ / 25 В / ±20%.
Площадка 1 — плюс, 2 — минус/GND. C34–C51 отсутствуют. Обратная связь TPS63802
и C14 остаются до внешнего фильтра. Номинальная высота электролита 10,2 мм;
до крышки или экрана требуется не менее 12,8 мм с учётом клапана и допуска.

SYS_3V3 питает Nice!Nano, периферию и INA219. RADIO_3V3 идёт через FB1 к
RADIO_LOCAL_3V3 модема. NT2 — медь PCB: деталь не устанавливается, связь не разрезается.
Перед USB снять J11; вернуть после отключения USB. При снятой J11 USB питает
процессор, INA219 и модем, FILTER_OUT изолирован. Сохраняется доработка клона:
основной аккумулятор не подключать к RAW/BAT, штатная USB-зарядка отключена,
питание платы поступает на 3V3/VCC.

FL1 по умолчанию DNP, RF проходит через NT1. При установке FL1 разрезается
предусмотренная связь NT1 и проверяется отсутствие обхода. Звезду NT2 не разрезают.
HT-RA62 подключается к SMA J13 через ANT: внутренний R1=0 Ом, R2 снят.
Это обозначения резисторов внутри модуля. CR2032 резервирует RTC.

Оба исполнения используют watchdog **v1.00**: одинаковые `main.c` и `watchdog.hex`
из канонического проекта `watchdog/`. Подключение U6: PB3/вывод 2 принимает TXEN
через R38=1 кОм, R39=100 кОм задаёт ноль; PB0/вывод 5 сбрасывает MCU через
R37=0 Ом в режиме LOW/Hi-Z. C33=100 нФ — развязка VCC/GND; рекомендованный
для отдельного watchdog входной конденсатор 10 нФ на PB3 в этих платах не установлен.
Перед ISP снять R37, после вернуть. Flash и fuse записываются отдельно:
**LFUSE=0x73, HFUSE=0xFB**, BOD 2,7 В постоянно включён, включая сон.
Профиль плат сохраняет ISP SCK 100 мкс; он отличается только этой настройкой
от канонических 50 мкс. Проверить поддержку скорости программатором и прочитать
fuse обратно. Обновление файлов не означает, что микроконтроллер уже прошит.
Подробности, исходники и программный протокол находятся в каталоге
`design/watchdog_reference/` выбранного исполнения; начните с `INTEGRATION_RU.txt`.

Расчётные типовые CV: Na-ion 3,878 В, LTO 5,273 В. Верхние оценки с принятыми
допусками CN3722, резисторов 1%, ТКС ±100 ppm/°C и ΔT=65°C — 3,982/5,452 В.
Это установившийся режим, без переходных выбросов и отказов. Балансиры сохраняют
LMV431A и R47/R51=2 Ом; дополнительная OVP и усилитель балансира не вводились.
Устойчивость LC, холод, переходные процессы TX и конкретный клон проверяют на образце.

[Полный перечень принятых ограничений](LIMITATIONS_RU.md).
