Alksndr55/mesh-repeater/docs/ROUTING_RESULT_RU.md

# Разводка и монтаж — v1.26 / v2.10

Редакция от 06.11.2026 сохраняет принятую основу и добавляет монтажные правки
в MAIN, POWER и LOGIC. GPS J4 перенесён внутрь на 2 мм и вправо на 0,5 мм;
RF-проводник и его геометрия сохранены. Подводы GPS и SYS_3V3 адаптированы,
подключение возле U7 выполнено обычным T-стыком. L4 сдвинут вправо на 1,5 мм.
Изменённые цепи проверены целиком с обеих сторон, включая заходы на площадки.

При независимом просмотре найдены и исправлены ещё пять острых стыков ветвей
на сигнальных переходах: SYS_3V3, SOLAR и BAT_SYS у MAIN; SOLAR и CHG_G_SHUNT
у POWER. Ширины силовых проводников сохранены. Земляные переходы перед этими
изменениями удалялись полностью, затем возвращались по правилам сетки и
электрических исключений. Точки сетки, ставшие недопустимыми после изменения
посадки L2, сдвига L4 и исправления подводов, пропущены.

У C22/C23 MAIN и LOGIC явные локальные термобарьеры имеют приоритет над
сплошной RF-зоной. Фактическая медь C59 и C1 также проверена: термоспицы есть,
земляного дублирующего подвода нет. Три коротких GND-сегмента TPS63802 на
MAIN/POWER сохраняют индивидуальные электрические обоснования.

Кнопки USER/RESET получили внешние подписи увеличенной толщины; маркировка
R9/R7/R8, R4, R10, J12 и верхнего балансира переставлена к деталям.
У R37 добавлена рамка W_RESET, у U7 — видимый ключ первого вывода. R56 имеет
отдельные значения под тремя вариантами сборки; общая расшифровка N/L сохранена.
Изменения номиналов и корпусов описаны в [общей инструкции сборки](ASSEMBLY_COMMON_RU.md).

Точные результаты относятся к PCB из соответствующего `routing_review.json`
и свежим отчётам `audit/current/`. Старые данные ниже сохранены как описание
предыдущей редакции; они не заменяют проверку новых файлов.

## Предыдущая редакция v1.25 / v2.09

Редакция от 30.10.2026. Основание — конкретные замечания владельца к v1.24/v2.08 и повторный просмотр всех плат с обеих сторон. Предыдущий вывод о завершённости стиля был слишком широким: нулевой DRC не обнаруживал неудачные подводы, лишнюю землю поверх заливки и шунтирование термобарьеров. Старые отчёты сохраняются как история, но не являются приёмкой этой редакции.

Три электронные платы исправлялись в отдельных копиях Astra 6 Ultra. Основной агент независимо сравнил геометрию, проанализировал стыки и зазоры, просмотрел обе стороны и крупные фрагменты нативной заливки. MAIN и POWER дополнительно прошли перекрёстную проверку другого агента. Ведущая разводка — v1; v2 сохраняет собственную трассировку.

## Указанные замечания

| Плата / узел | Выполненное изменение |
|---|---|
| MAIN, R36 → via | Лишний прямоугольный поворот WDT_RESET заменён переходом 45°. |
| MAIN, питание модема | У C24 и M2.9 удалены земляные накладки; питание и связь с заливкой сохранены. |
| MAIN, CN3722.2/.3 | Удалены отдельные GND-дорожки поверх полигона. Оставшаяся медь формируется заливкой и её термоспицами. |
| MAIN, R1 ↔ R56 | Сделан нормальный выход из площадки R1 и последовательный подвод 45°. |
| MAIN, Net-(M2-NSS) | Острый разворот устранён. Обход соседних GPS_TX_MCU и MOSI сохранён: прямые варианты пересекают их дорожки/vias; препятствия проверены нативной геометрией. |
| v2, земляные площадки | На LOGIC включены термобарьеры общих зон; сняты необоснованные прямые подключения обычных деталей. На POWER исправлены местные overrides и vias в зазорах термобарьеров. RF и механические контакты имеют отдельные причины сохранения. |
| LOGIC, SYS_3V3 около M1 | Путь сокращён с 38,507 до 32,180 мм при ширине 0,4 мм. Прямой проход между фиксированными площадками не выдерживает заданного зазора. |
| LOGIC, конденсаторы модема | Удалена лишняя GND-дорожка C23; соединение C23/C24 с землёй выполняется заливкой через термобарьеры. |
| LOGIC, R25 | Упорядочен выход NSS, убраны ненужные изломы. |
| LOGIC, M2.15 | Вход через площадку выровнен по горизонтали; V-образный подвод и лишний хвост на B.Cu удалены. Аналогичный подвод исправлен на MAIN. |
| LOGIC, R29/R30 | Удалены выступающие хвосты и короткий широкий отрезок у ответвления. |
| LOGIC, U4.7/.8 | Прямоугольные обходы заменены диагоналями. Зазор основной пары — 1,07 мм на горизонтали, диагонали и вертикали. |
| LOGIC, R21 → J201 | MODE перенесён к краю платы по Y=57,8 мм вне тела разъёма. Этот путь намеренно длиннее прежнего. |
| POWER, EN и силовые цепи TPS | Исправлены R15/R16, U2.1, подводы входных/выходных конденсаторов; удалены земляной ствол, старые хвосты и лишние силовые сегменты. Основные силовые ширины сохранены. |
| POWER, U10.5 | Выполнен осевой вход и аккуратное ответвление к C61; похожий дефект исправлен на MAIN. |
| POWER, C1 / D2 | Удалены лишние GND-дорожки. Проверено реальное соединение площадок с полигоном после перезаливки. Аналогичный узел исправлен на MAIN. |

## Дополнительные находки

На MAIN удалены земляные накладки C13/C63, C15/C16 и M2.9, исправлены термобарьеры U7/U9/U11, подводы M2.15, U10 и COM2. Острый стык короткого ответвления CS_P у R58 исправлен без изменения Kelvin-разводки R71–R73.

На POWER убраны оставшиеся хвосты к прежнему GND-via, исправлены подвод R1/R56 и переходы ширины у BAT_SYS/SYS_PRE. Дорожка у U9 перенесена для полноценного термобарьера; C14 и правый PGND-via TPS выведены из тепловых зазоров.

На LOGIC дополнительно исправлены WDT_RESET, GPS/MCU_RESET, стыки SCL/SDA, ответвления SYS и питание M1.9–C21. У U7.7 проверены реальные горизонтальные термоспицы 0,2 мм, а не только значение настройки в файле.

Проверялись полные пути и группы параллельных дорожек. Осмысленные T-ветвления, выводы из фиксированных площадок и обходы физических препятствий сохраняются. Требование 0/45/90° относится к направлениям отрезков; оно само по себе не разрешает острые стыки. Расстановка деталей, корпуса, UUID, площадки, контуры, RF-геометрия и звезда NT2 сохранены. Изменения thermal-метаданных перечислены отдельно.

## Измеренный результат

| Плата | Сегменты до → после | Длина до → после, мм | GND-дорожки до → после | GND на сетке / вне сетки |
|---|---:|---:|---:|---:|
| MAIN | 802 → 809 | 2791.865 → 2762.407 | 19 → 3 | 143 / 27 |
| POWER | 493 → 486 | 1341.649 → 1312.283 | 17 → 3 | 95 / 11 |
| LOGIC | 417 → 414 | 1753.763 → 1758.583 | 1 → 0 | 79 / 28 |

Количество сегментов не используется как самостоятельная оценка качества: фаска вместо одного угла может добавить сегмент. На LOGIC удлинение обхода разъёма перекрывает сокращение других путей.

## Земля и термобарьеры

Сохранены промежуточные платы без всех GND-vias. После правки дорожек заново проверена сетка 5×5 мм от (0; 0); точки, нарушающие зазор, keepout или термобарьер, пропущены. Каждое внесеточное отверстие имеет индивидуальную причину в `routing_review.json` рядом с соответствующей PCB.

На MAIN и POWER оставлены по три GND-сегмента: короткое соединение контрольной и силовой земли у U2 и два местных подвода к переходам. Земляные магистрали поверх заливки удалены. На LOGIC GND-дорожек нет. Сохранённые три сегмента являются явным локальным исключением, а не обещанием полностью свободного термобарьера на этих выводах TPS.

Проверены реальные контакты площадок, дорожек, vias и заполненных полигонов, включая касания между разными GND-зонами. На каждой электронной плате земля образует одну связную компоненту. Для пяти необходимых островковых vias MAIN и двух POWER проведено отдельное удаление с перезаливкой: каждый раз появлялось одно неподключение. Локальные возвраты LOGIC не выдаются за обязательные DC-мосты: её проверенные удаления такого обрыва не дали.

Сплошное соединение RF-площадок и RF-зон сохранено для непрерывной обратной цепи. Прямое подключение крепежа и тестовой земли также перечислено отдельно. SHIELD не содержит дорожек/vias; его сплошная экранная медь и контакт GF1 сохранены.

## Проверки и границы результата

Нативные проверки KiCad 10.0.7 выполняются заново для точных файлов выпуска: общий граф, BOM, ERC, DRC с перезаливкой, все уровни нарушений, соответствие схемы PCB, watchdog и зависимости. Свежие результаты выбранного исполнения находятся в `audit/current/`. Нельзя переносить PASS на изменённую PCB: `routing_review.json` привязан к SHA256.

Приёмка разводки дополнена тремя обязательными пунктами: подводы/стыки, соединения земли с полигоном и термобарьеры. Проверка выпуска требует полного журнала оставленных GND-дорожек и сплошных подключений; режим `thru_hole_only` также учитывается как прямое подключение SMT. Сам код проверки прошёл 45 тестов и независимые контрольные пробы.

Watchdog в обоих исполнениях остаётся v1.00; исходник, HEX и его проверочные материалы включены. Эта работа не означает перепрошивку микросхем. CAD-проверки не заменяют измерения собранной платы, устойчивости преобразователя и RF/EMI. Сохраняются [аппаратные ограничения](LIMITATIONS_RU.md).

Правила: [ROUTING_RULES_RU.md](ROUTING_RULES_RU.md). Выпуск: [WORKFLOW_RU.md](WORKFLOW_RU.md).
