Alksndr55/mesh-repeater/audit/s4_21_manual_routing_review_20261017/final_checks/independent_verification_ru.txt

Независимая финальная проверка S4.21 — 18.10.2026

Плата SHA-256: be14cae202912ebb00e5dc758b2eae04cbe6733d4cb73df00044fdb03670fab3
Исходная ручная редакция: 5c211a0fb528bb8553bd018f4250e5f867945308a4edae45bc9d9cd1282bd787
Результат: 29 из 29 проверок пройдены.

Свежие native ERC, DRC, неподключённые элементы, соответствие схеме и проигнорированные проверки: 0. Сохранённые заливки на обеих сторонах точно совпадают со свежим расчётом; симметрическая разность меди 0 мм².

Нет совпадающих/коллинеарно наложенных дорожек, совпадающих переходных отверстий и нулевых сегментов. Углы дорожек и обычных поворотов соответствуют 0/45/90°. Дополнительная независимая проверка маски не обнаружила зазоров менее 0,1 мм между отверстиями via и окнами площадок либо между окнами различных цепей.

Сохранены 172 посадочных места. SH1 и TP6 отсутствуют и в плате, и в схеме согласно решению пользователя. Все остальные ручные позиции и параметры площадок сохранены; единственное разрешённое изменение положения — M2 возвращён из (47,5;18) в (48;18), угол 0°, сторона F. Модель размещения совпадает с нативной платой. Нижний полигон GND восстановлен. Элементы схемы и полный электрический граф изменены только удалением SH1/TP6 и их выводов; остальные значения, корпуса и соединения сохранены. Настройки правил и пользовательские DRC-правила не ослаблялись.

Первый финальный прогон (26/29) сохранён в round1_checks. Он выявил смещение конца GND-дорожки относительно центра via и заход отверстия RADIO_RST на масочное окно M2.4. После двух локальных исправлений тот же валидатор прошёл 29/29 без изменения критериев.

Проверка выполнялась только чтением CAD; исходные файлы не изменялись. Gerber ZIP S4.20 относится к предыдущей плате и не является производственным пакетом этой редакции. Настоящий результат — статическое подтверждение CAD/DFM, а не измерение помех, сертификация ЭМС или испытание физического прототипа.
