Alksndr55/mesh-repeater/audit/s4_16_layout_fixes_20261011/README.txt

Final S4.16 CAD proofs. Numeric data and source hashes preserved. Publication-only paths made relative. Historical baseline and donor work directories are excluded. Bench qualification and manufacturing release remain incomplete.
