Alksndr55/mesh-repeater/output/pdf/S4_21_schematic.pdf

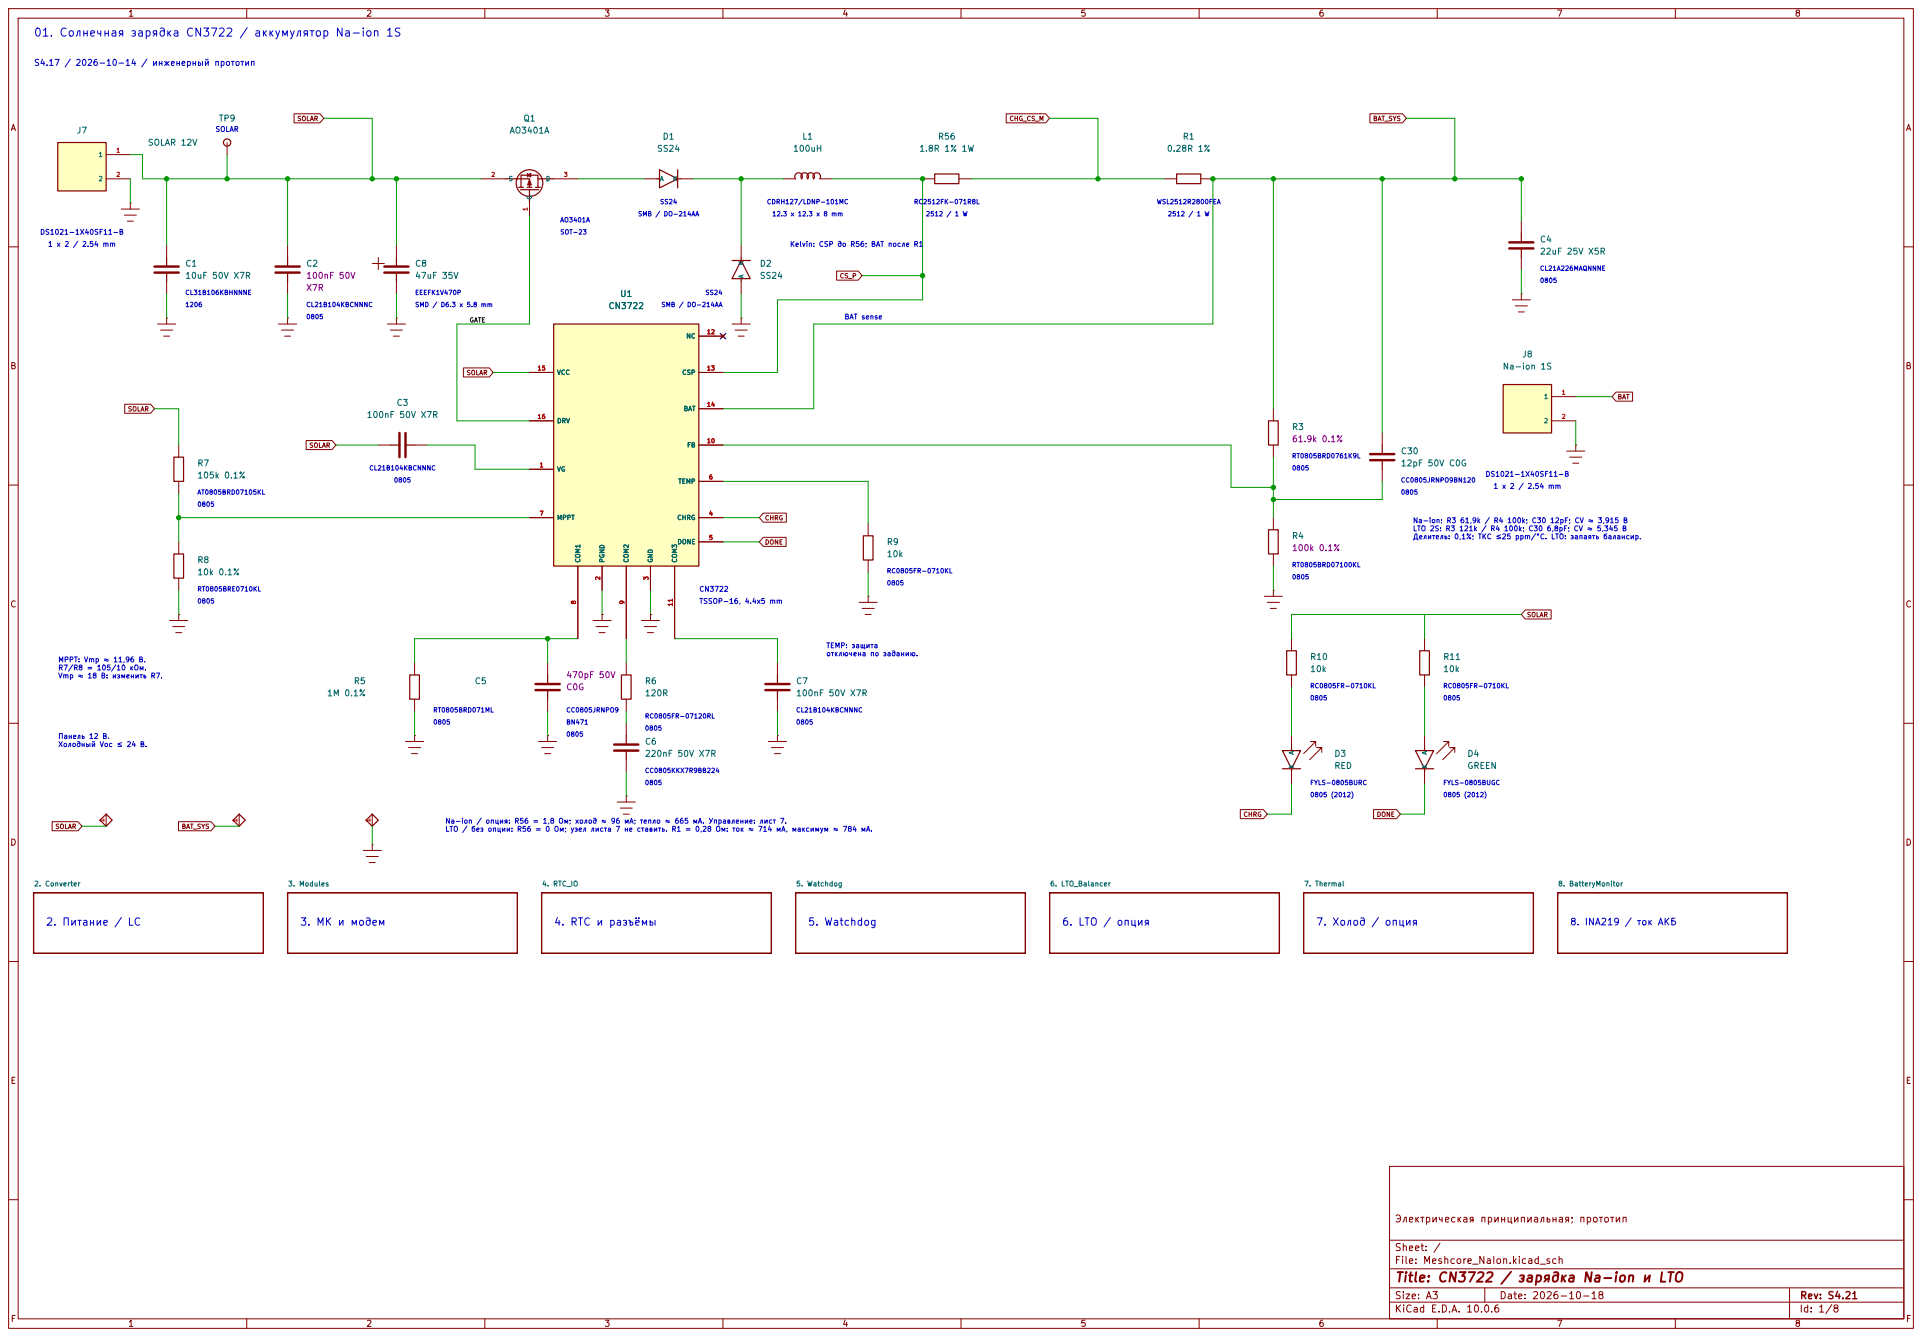
[picture p22: page 1]

01. Солнечная зарядка CN3722 / аккумулятор Na-ion 1S

Kelvin: CSP до R56; BAT после R1

LTO 2S: R3 121k / R4 100k; C30 6,8pF; CV ≈ 5,345 В Делитель: 0,1%; ТКС ≤25 ppm/°C. LTO: запаять балансир. RC0805FR-07120RL 2. Питание / LC

Na-ion / опция: R56 = 1,8 Ом; холод ≈ 96 мА; тепло ≈ 665 мА. Управление: лист 7. LTO / без опции: R56 = 0 Ом; узел листа 7 не ставить. R1 = 0,28 Ом: ток ≈ 714 мА, максимум ≈ 784 мА. CC0805KKX7R9BB224 4. RTC и разъёмы

Sheet: /
File: Meshcore_NaIon.kicad_sch
Title: CN3722 / зарядка Na-ion и LTO

Size: A3 | Rev: S4.21 | F Date: 2026-10-18
KiCad E.D.A. 10.0.6 | Id: 1/8

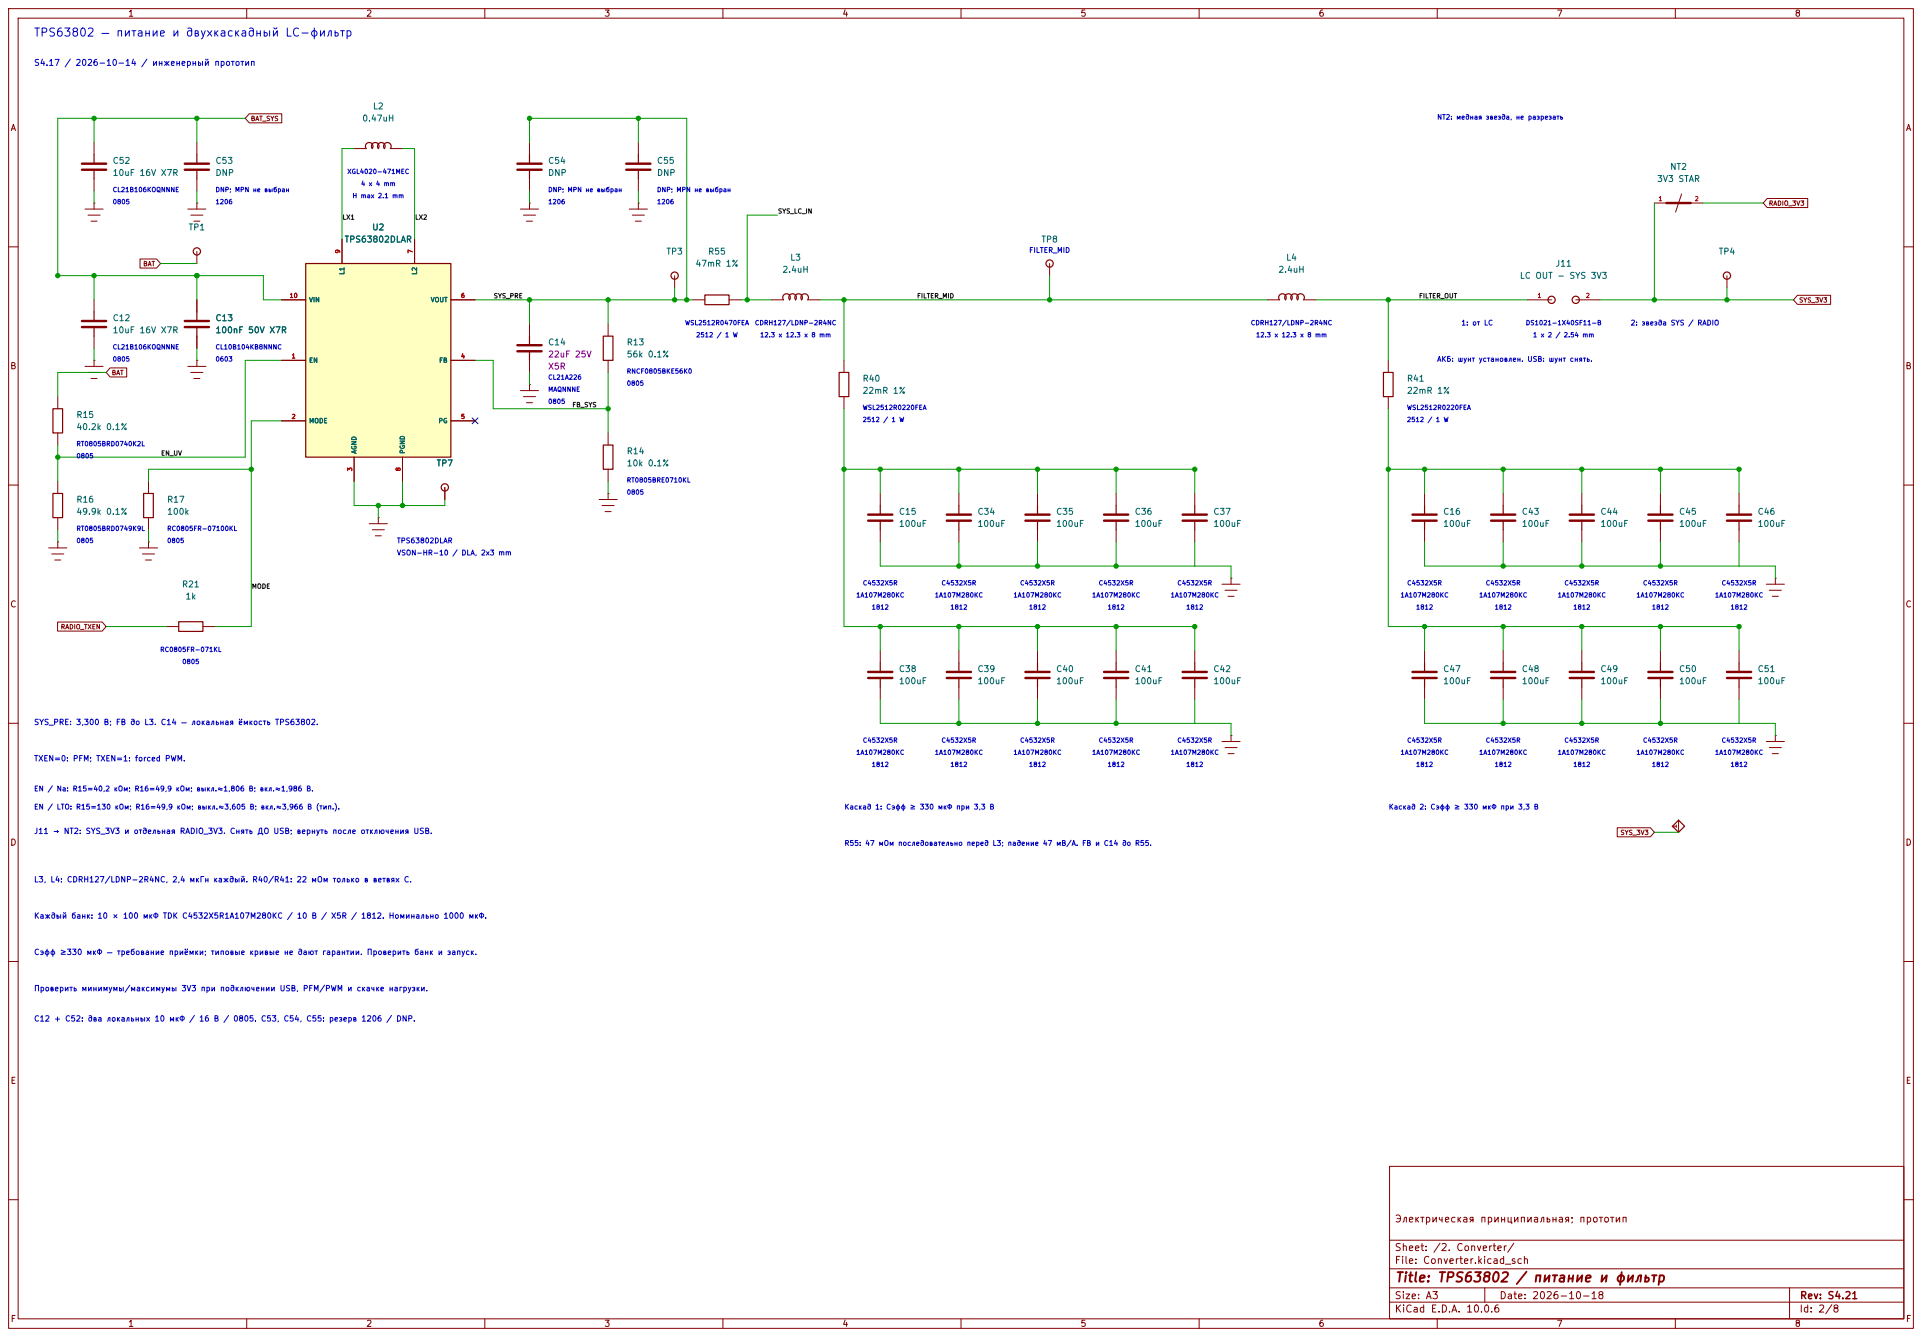
[picture p23: page 2]

TPS63802 — питание и двухкаскадный LC-фильтр

TPS63802DLAR
VSON-HR-10 / DLA, 2x3 mm

C4532X5R R55: 47 мОм последовательно перед L3; падение 47 мВ/А. FB и C14 до R55. C4532X5R

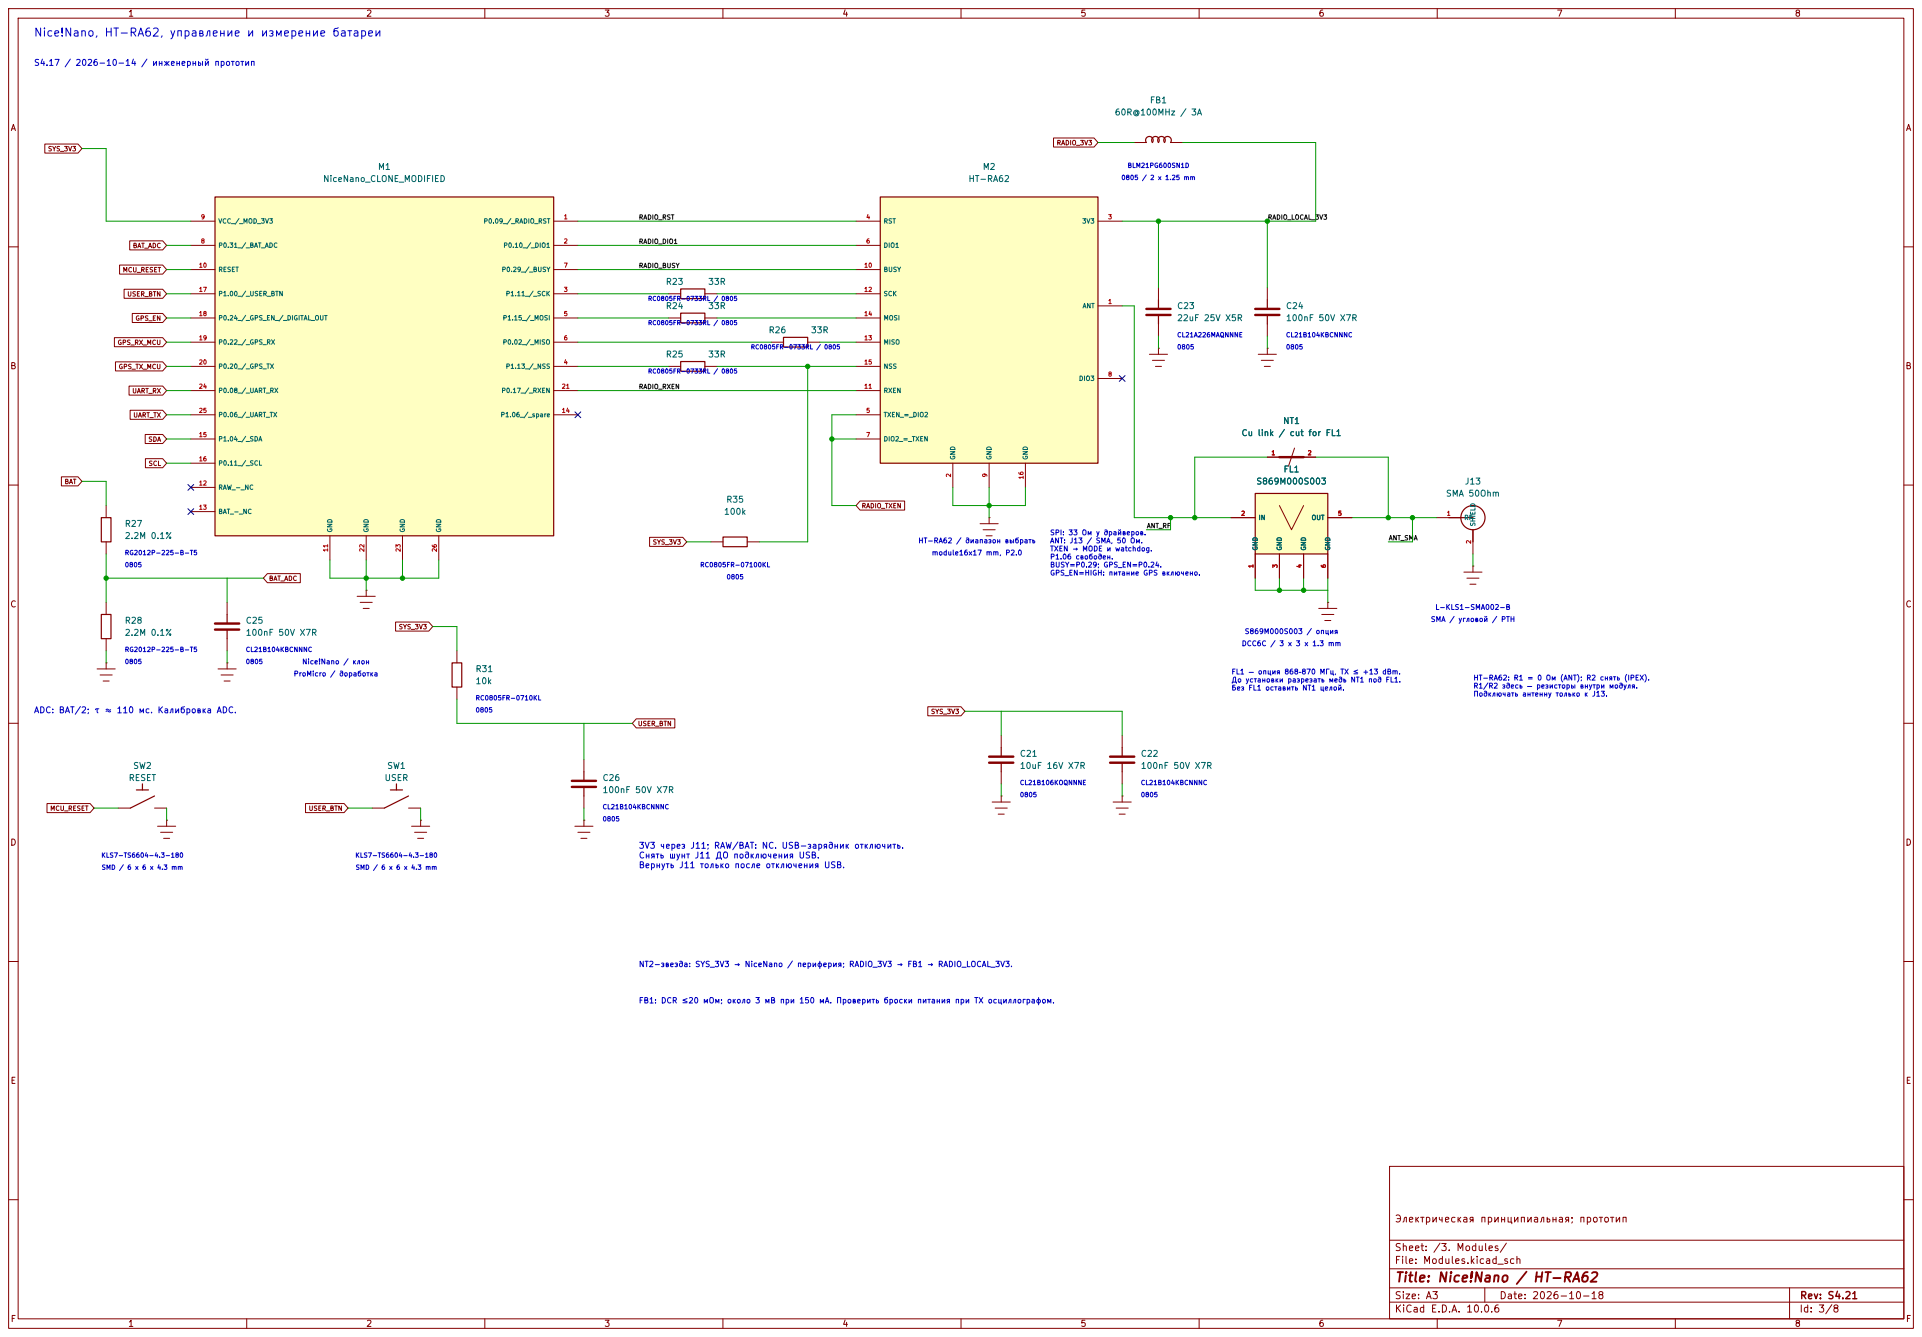
[picture p24: page 3]

9 BUSY 10 RXEN 11 SCK 12 MISO 13 MOSI 14 NSS 15 GND 16 M2 HT-RA62

CL21A226MAQNNNE FL1 — опция 868–870 МГц, TX ≤ +13 dBm. До установки разрезать медь NT1 под FL1. Без FL1 оставить NT1 целой. S869M000S003 / опция DCC6C / 3 x 3 x 1.3 mm

Sheet: /3. Modules/
File: Modules.kicad_sch
Title: Nice!Nano / HT-RA62

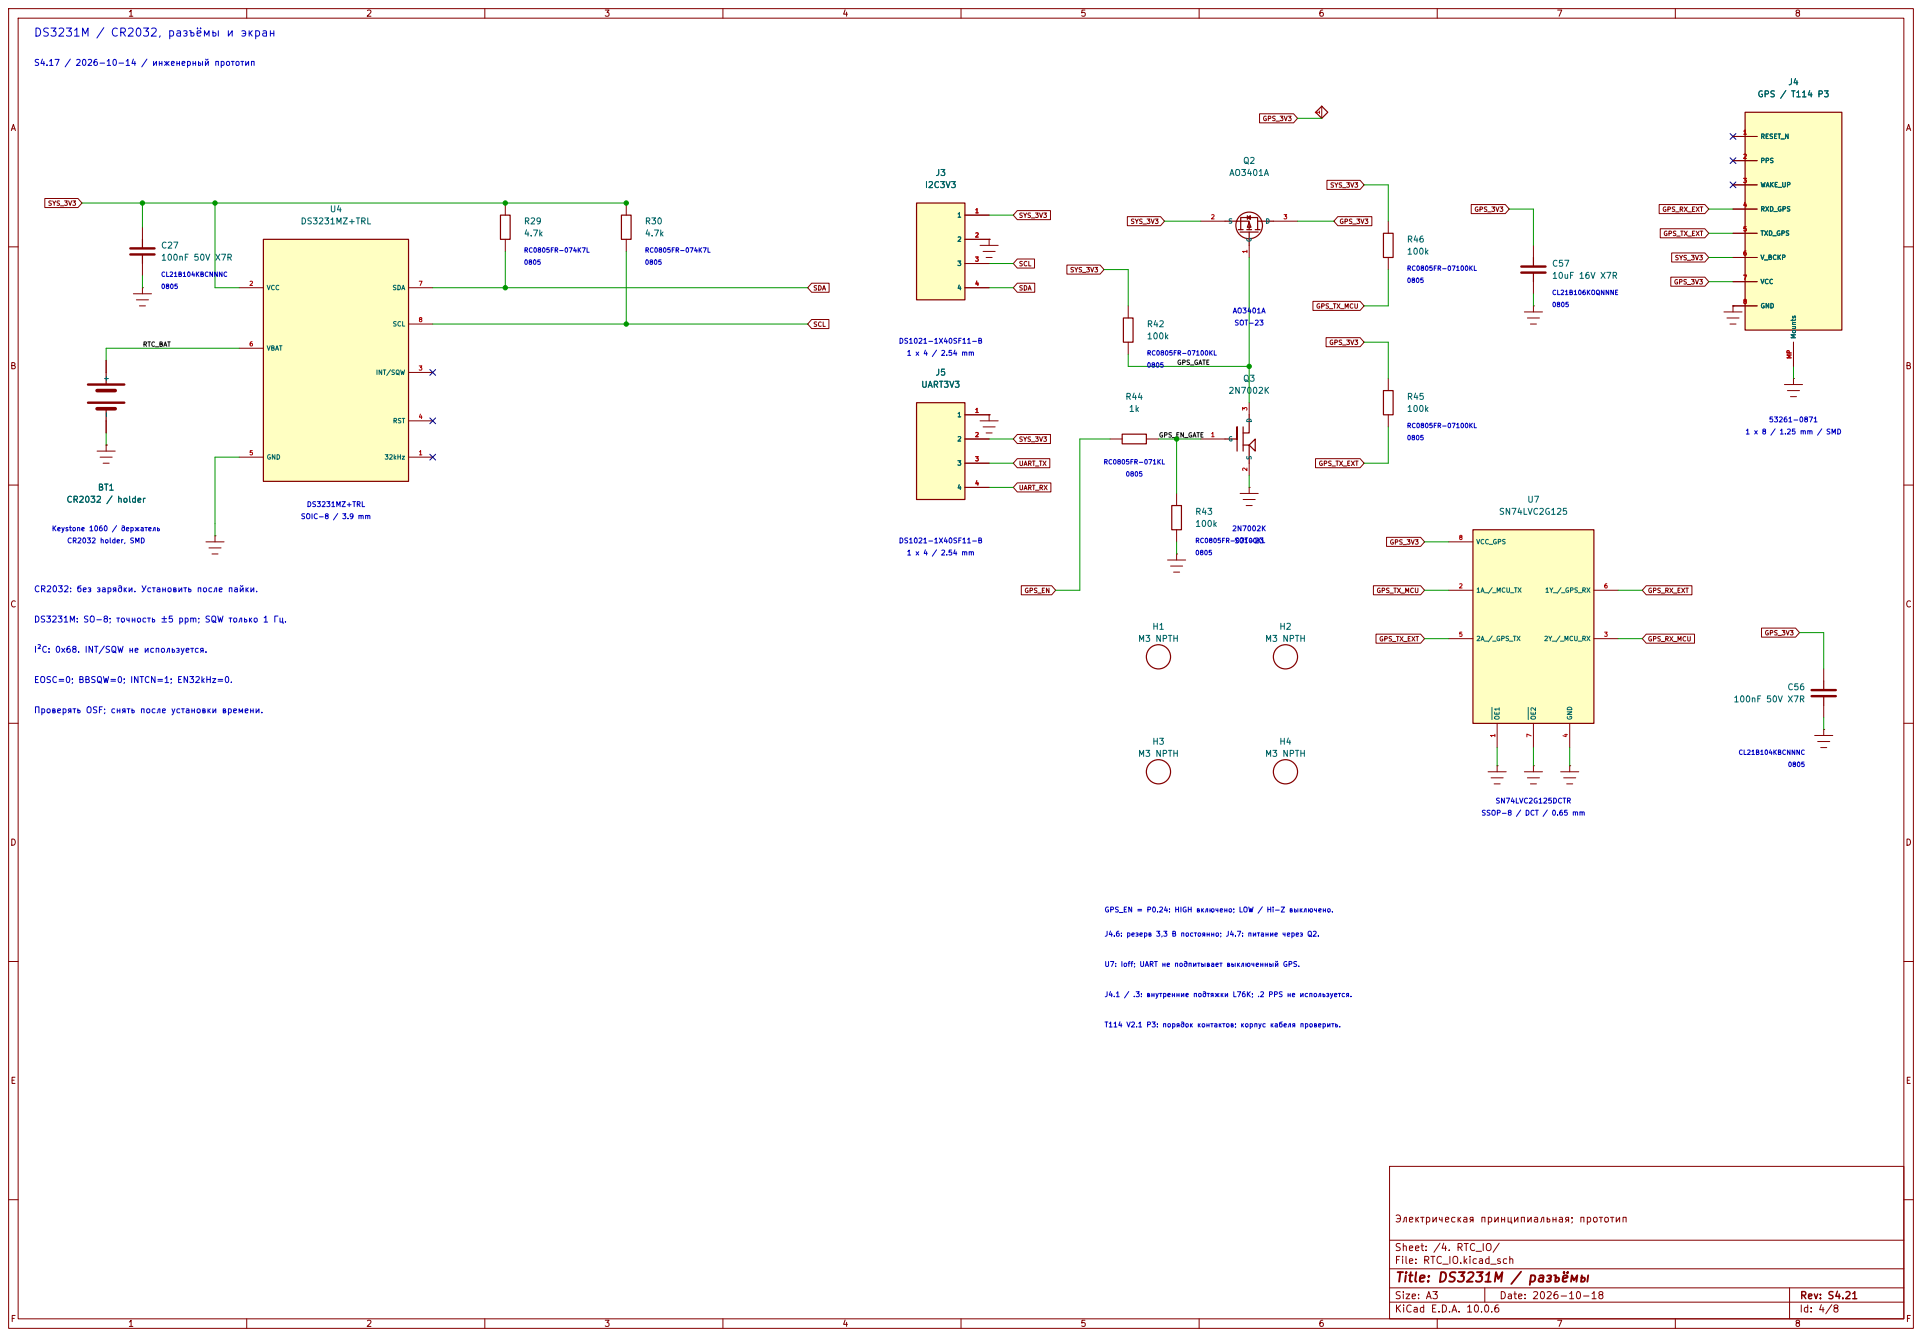
[picture p25: page 4]

DS1021-1X40SF11-B DS3231M: SO-8; точность ±5 ppm; SQW только 1 Гц.

Keystone 1060 / держатель CR2032 holder, SMD

I²C: 0x68. INT/SQW не используется.

T114 V2.1 P3: порядок контактов; корпус кабеля проверить. U7: Ioff; UART не подпитывает выключенный GPS. J4.1 / .3: внутренние подтяжки L76K; .2 PPS не используется. GPS_EN = P0.24: HIGH включено; LOW / Hi-Z выключено.

J4.6: резерв 3,3 В постоянно; J4.7: питание через Q2.

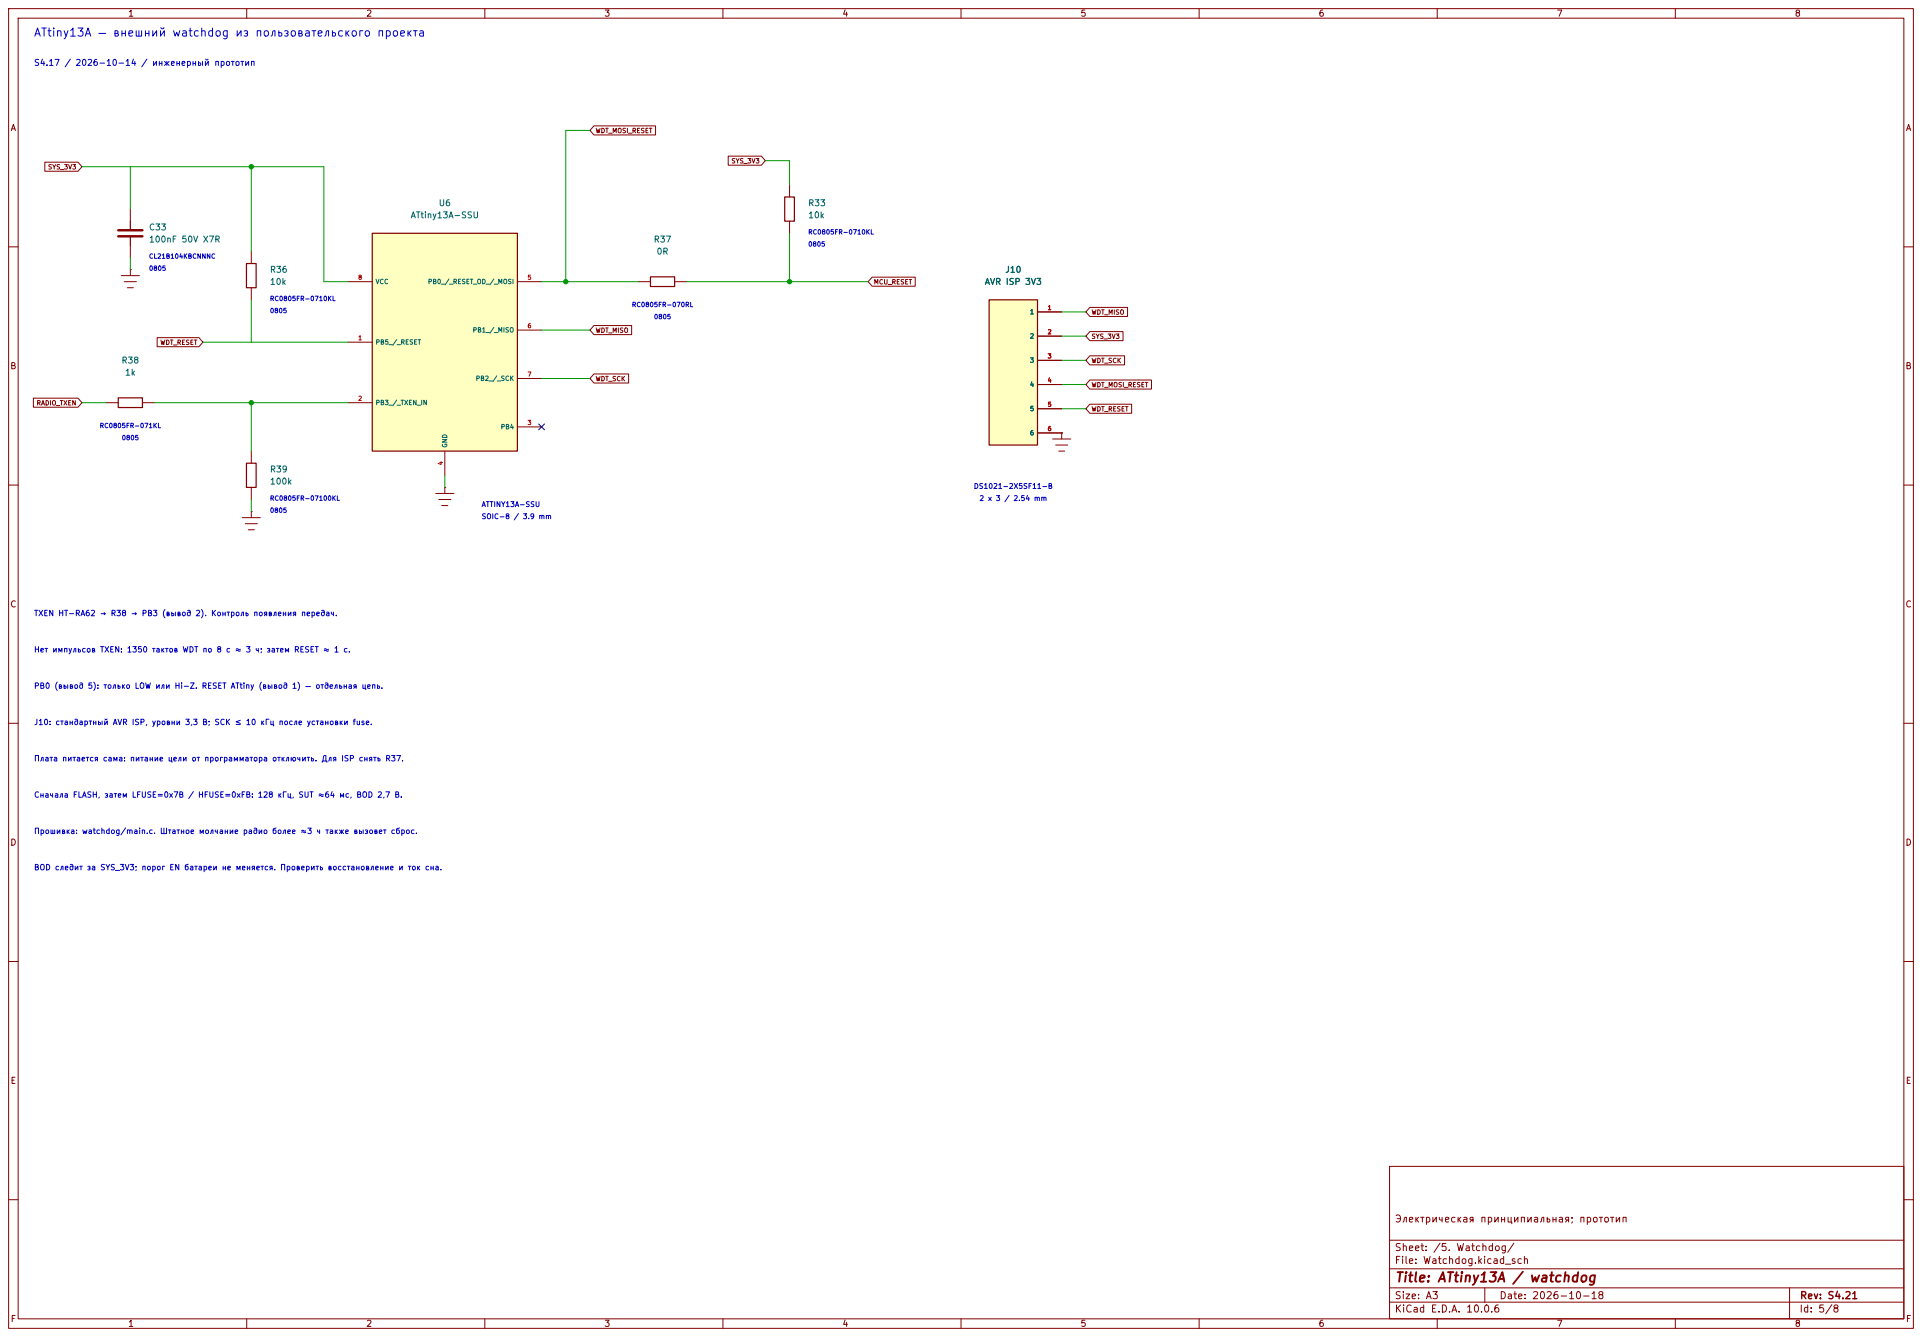
[picture p26: page 5]

RC0805FR-0710KL ATtiny13A — внешний watchdog из пользовательского проекта

RC0805FR-07100KL Нет импульсов TXEN: 1350 тактов WDT по 8 с ≈ 3 ч; затем RESET ≈ 1 с. Прошивка: watchdog/main.c. Штатное молчание радио более ≈3 ч также вызовет сброс. Сначала FLASH, затем LFUSE=0x7B / HFUSE=0xFB: 128 кГц, SUT ≈64 мс, BOD 2,7 В.

AB

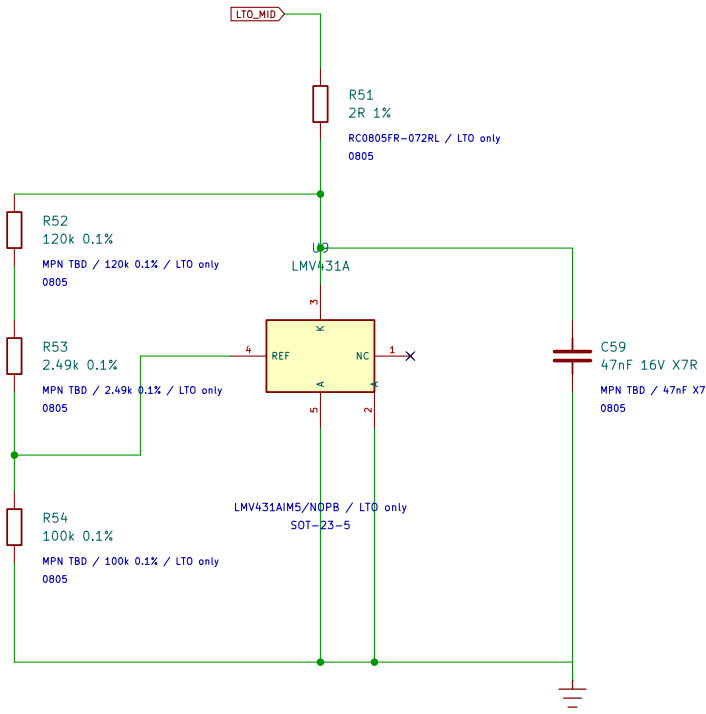
[picture p27: figure]

C

D

E

AB

C

D

E

# Title: LMV431A / LTO 2S опция

## File: LTO_Balancer.kicad_sch

## Sheet: /6. LTO_Balancer/

## Электрическая принципиальная; прототип

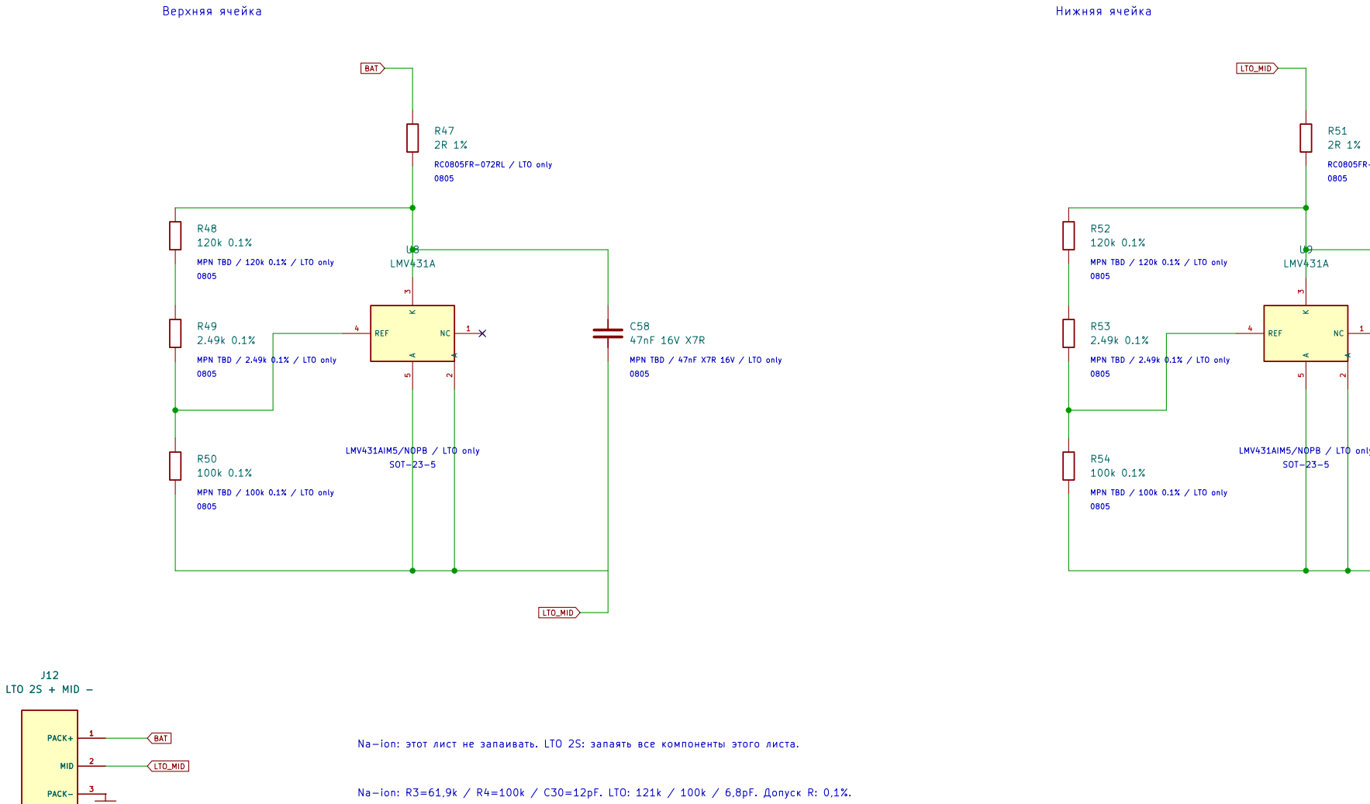
[picture p28: figure]
PACK+; 1 MID; 2 PACK-; LTO 2S + MID -; 3 REF 4; LMV431A R53; LMV431A; BAT; LTO_MID; SOT-23-5; 0805 Нижняя ячейка; MPN TBD / 120k 0.1% / LTO only J12

LMV431AIM5/NOPB / LTO only 0805 RC0805FR-072RL / LTO only Верхняя ячейка

# S4.17 / 2026-10-14 / инженерный прототип 06. Балансир 2S LTO / опциональная сборка

Плата: балансир под общей крышкой. Отдельные линии к J12: 1 PACK+ / 2 MID / 3 PACK-. 1 x 3 / 2.54 mm

RC0805FR-072RL / LTO only | 0805 MPN TBD / 47nF X7R 16V / LTO only 0805 | 0805 SOT-23-5 | MPN TBD / 47nF X7R 16V / LTO only LTO: номинал 5,345 В; максимум 5,445 В при ТКС ≤25 ppm/°C, -40…85°C. Выбросы не учтены. 0805 | MPN TBD / 2.49k | 0.1% / LTO only MPN TBD / 100k 0.1% / LTO only MPN TBD / 120k 0.1% / LTO only 0805

Балласт R47/R51 = 2R по выбору пользователя; ток LMV431 на углах допусков не ограничен до 15 мА. S4.15: отдельной защиты ячеек и защиты от перенапряжения нет.

LMV431AIM5/NOPB / LTO only MPN TBD / 2.49k 0.1% / LTO only | 0805 MPN TBD / 100k 0.1% / LTO only Балансир: 2R, 120k+2,49k / 100k (0,1%), LMV431A, 47nF. Na-ion: R3=61,9k / R4=100k / C30=12pF. LTO: 121k / 100k / 6,8pF. Допуск R: 0,1%. Na-ion: этот лист не запаивать. LTO 2S: запаять все компоненты этого листа. DS1021-1X40SF11-B / LTO only

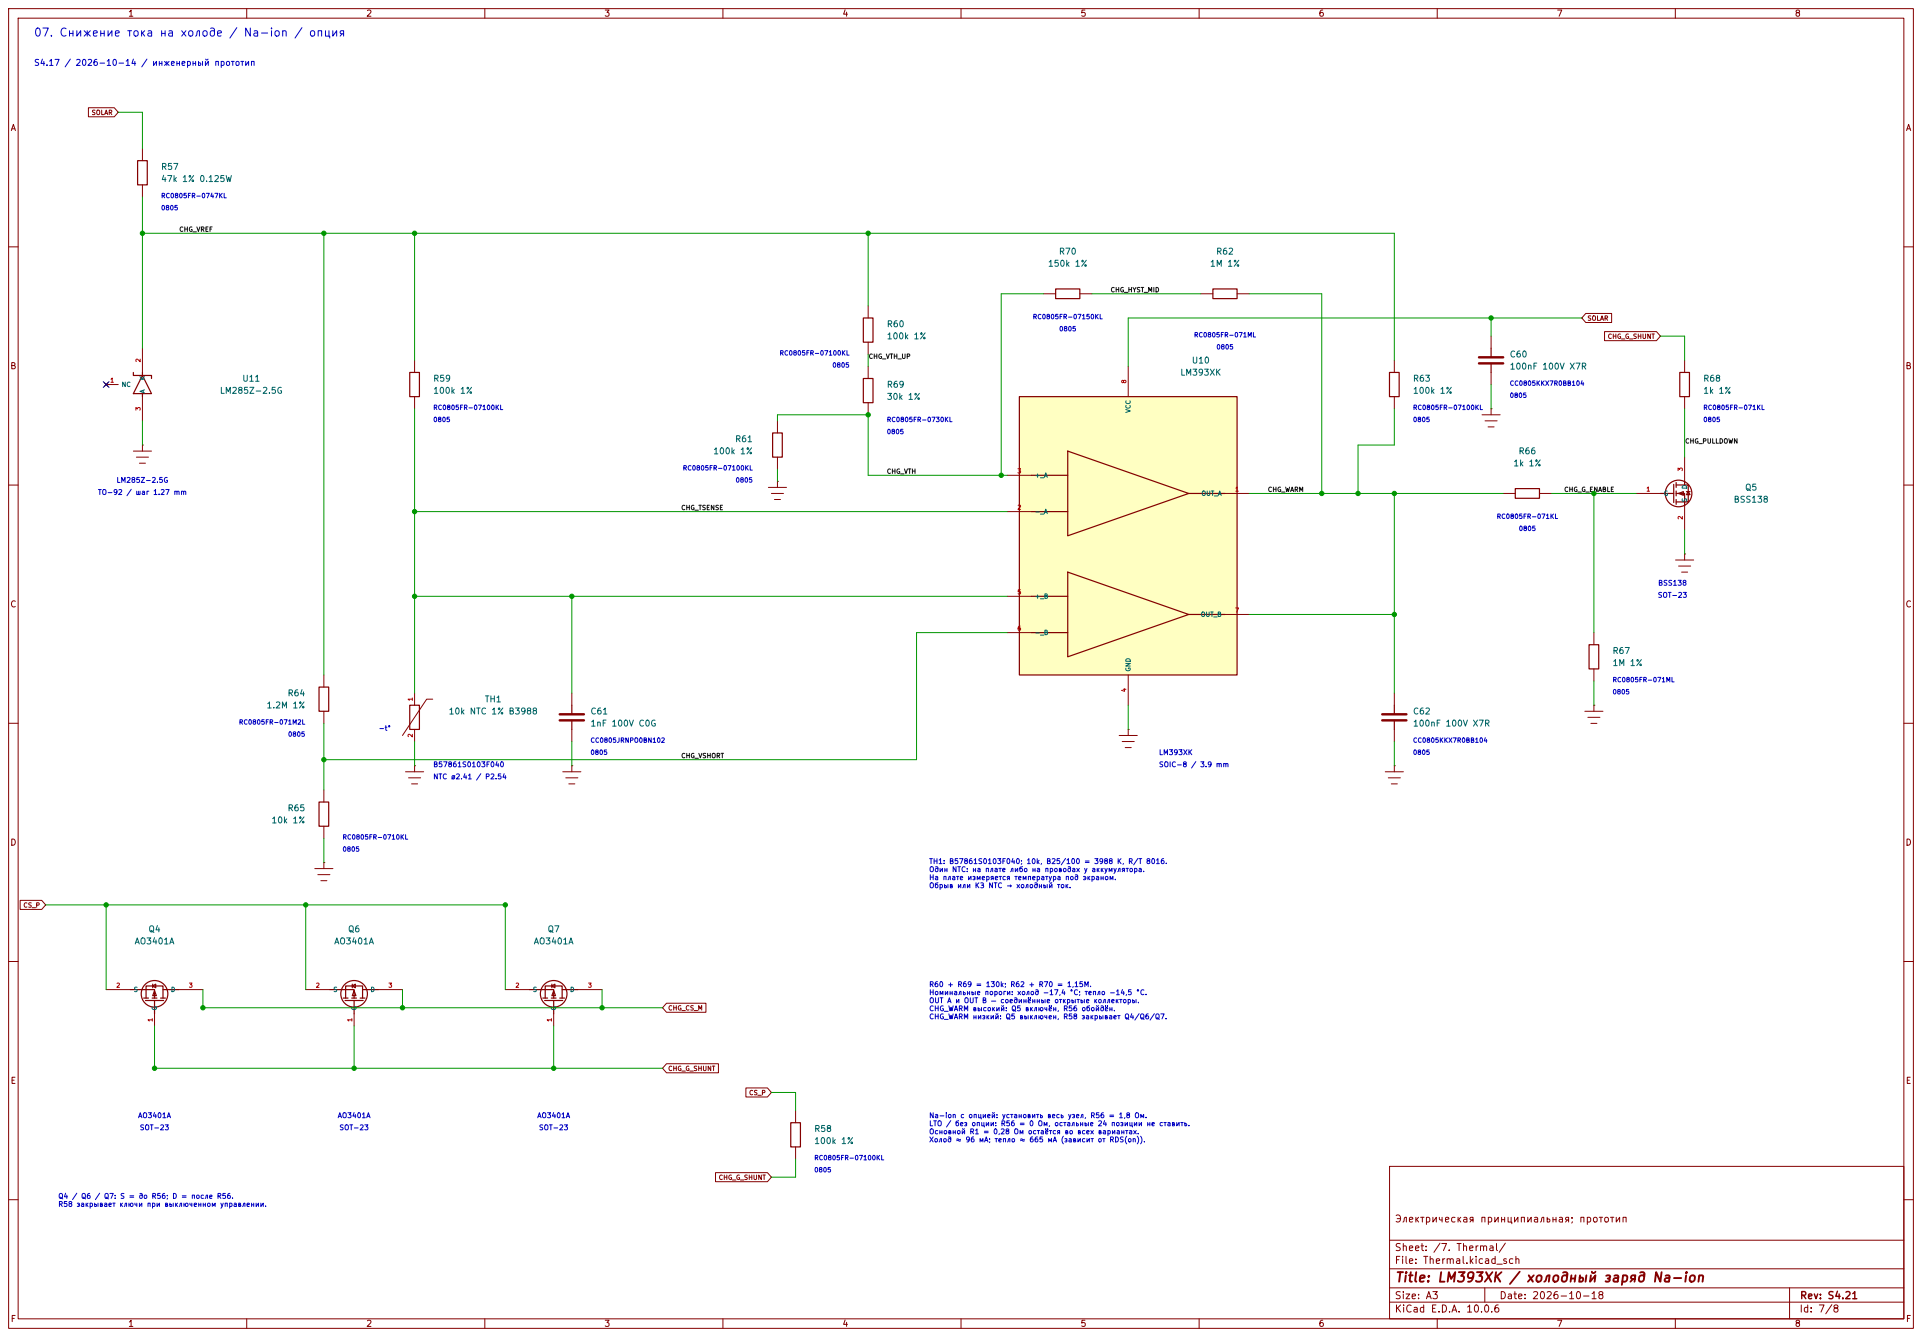
[picture p29: page 7]

07. Снижение тока на холоде / Na-ion / опция

0805 Q4 / Q6 / Q7: S = до R56; D = после R56. R58 закрывает ключи при выключенном управлении.

R60 + R69 = 130k; R62 + R70 = 1,15M. Номинальные пороги: холод −17,4 °C; тепло −14,5 °C. OUT A и OUT B — соединённые открытые коллекторы. CHG_WARM высокий: Q5 включён, R56 обойдён. CHG_WARM низкий: Q5 выключен, R58 закрывает Q4/Q6/Q7.

Sheet: /7. Thermal/
File: Thermal.kicad_sch
Title: LM393XK / холодный заряд Na-ion

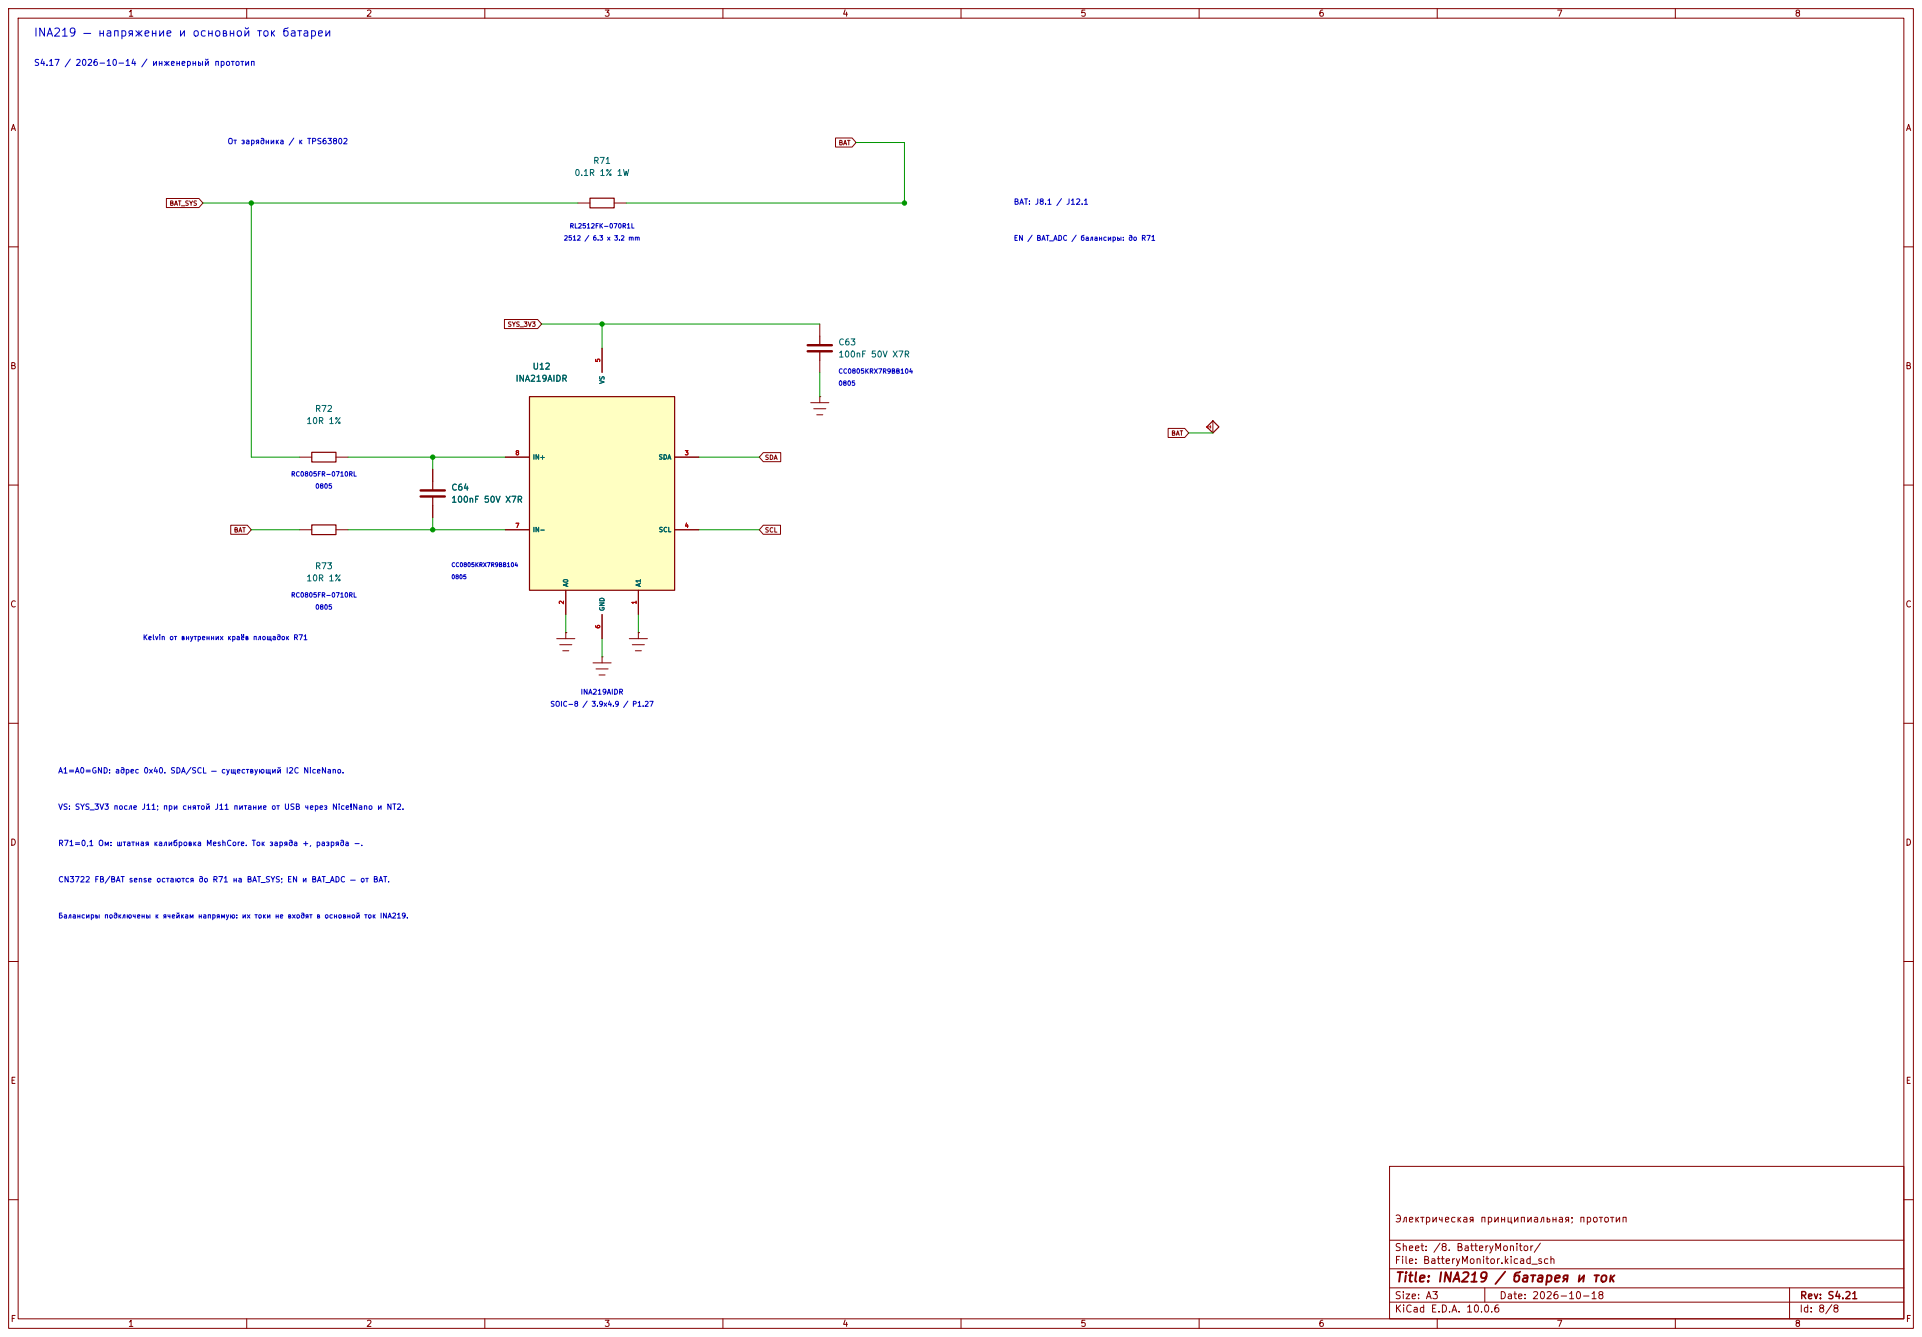
[picture p30: page 8]

INA219 — напряжение и основной ток батареи

0805 0805 RC0805FR-0710RL A1=A0=GND: адрес 0x40. SDA/SCL — существующий I2C NiceNano. Балансиры подключены к ячейкам напрямую: их токи не входят в основной ток INA219.

VS: SYS_3V3 после J11; при снятой J11 питание от USB через Nice!Nano и NT2.
