Alksndr55/mesh-repeater/output/pdf/S4_12_schematic.pdf

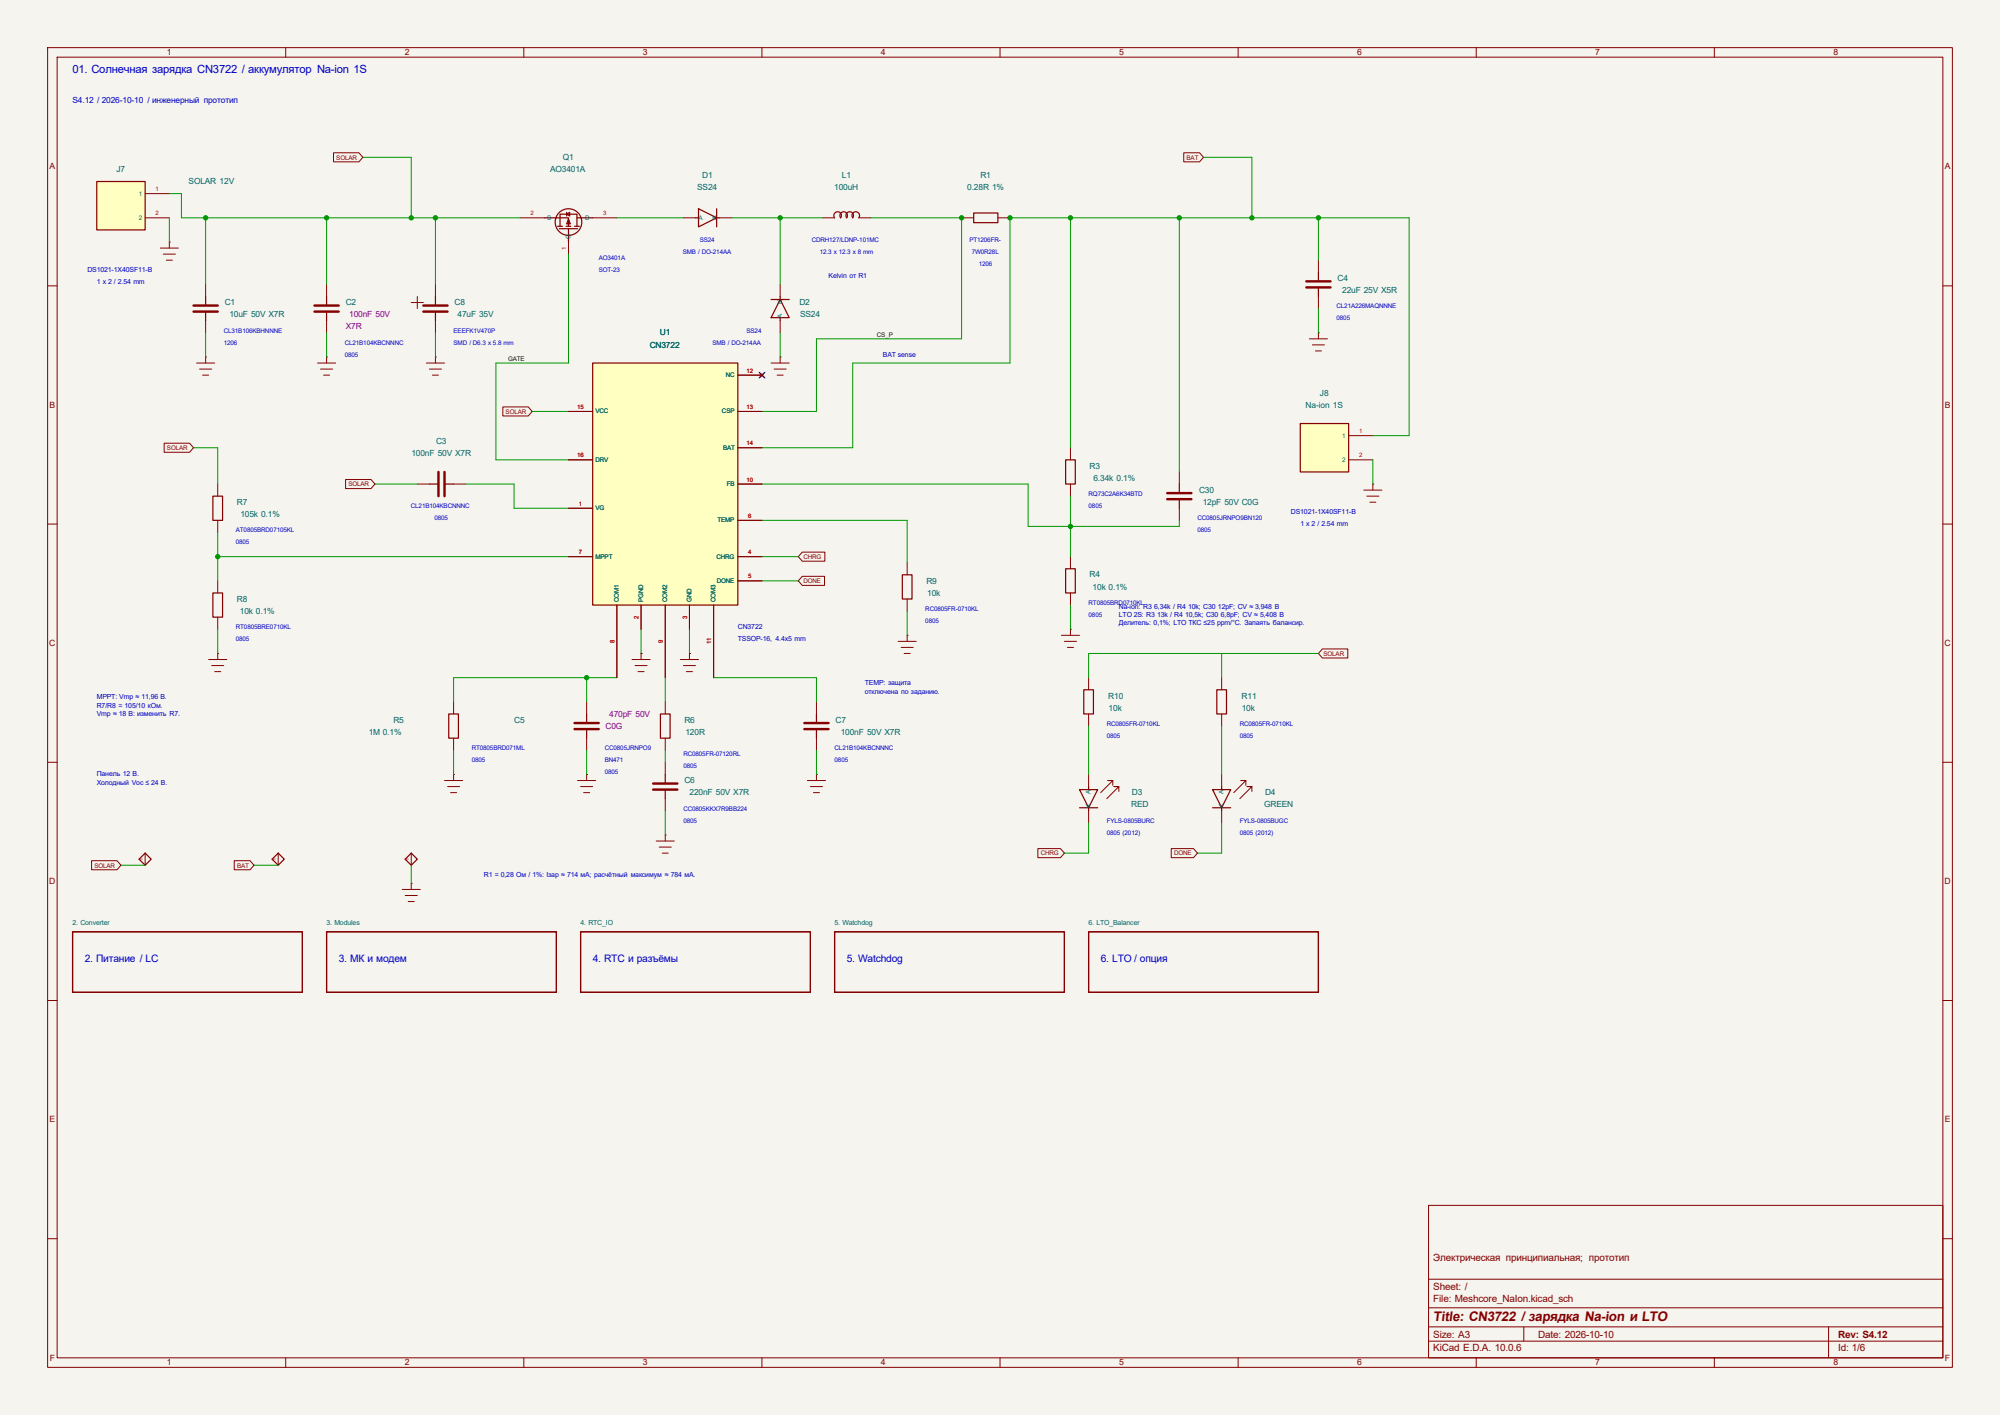
[picture p31: page 1]

CL21A226MAQNNNE 01. Солнечная зарядка CN3722 / аккумулятор Na-ion 1S

9 FB 10 COM3 11 NC 12 CSP 13 BAT 14 VCC 15 DRV 16 U1 CN3722 C1

LTO 2S: R3 13k / R4 10,5k; C30 6,8pF; CV ≈ 5,408 В Делитель: 0,1%; LTO ТКС ≤25 ppm/°C. Запаять балансир. 0805 CL31B106KBHNNNE

9 FB 10 COM3 11 NC 12 CSP 13 BAT 14 VCC 15 DRV 16

3 CHRG 4 DONE 5 TEMP 6 MPPT 7 COM1

0805 R1 = 0,28 Ом / 1%: Iзар ≈ 714 мА; расчётный максимум ≈ 784 мА. CC0805JRNPO9 2. Питание / LC

File: Meshcore_NaIon.kicad_sch Sheet: / Электрическая принципиальная; прототип

Id: 1/6 Title: CN3722 / зарядка Na-ion и LTO

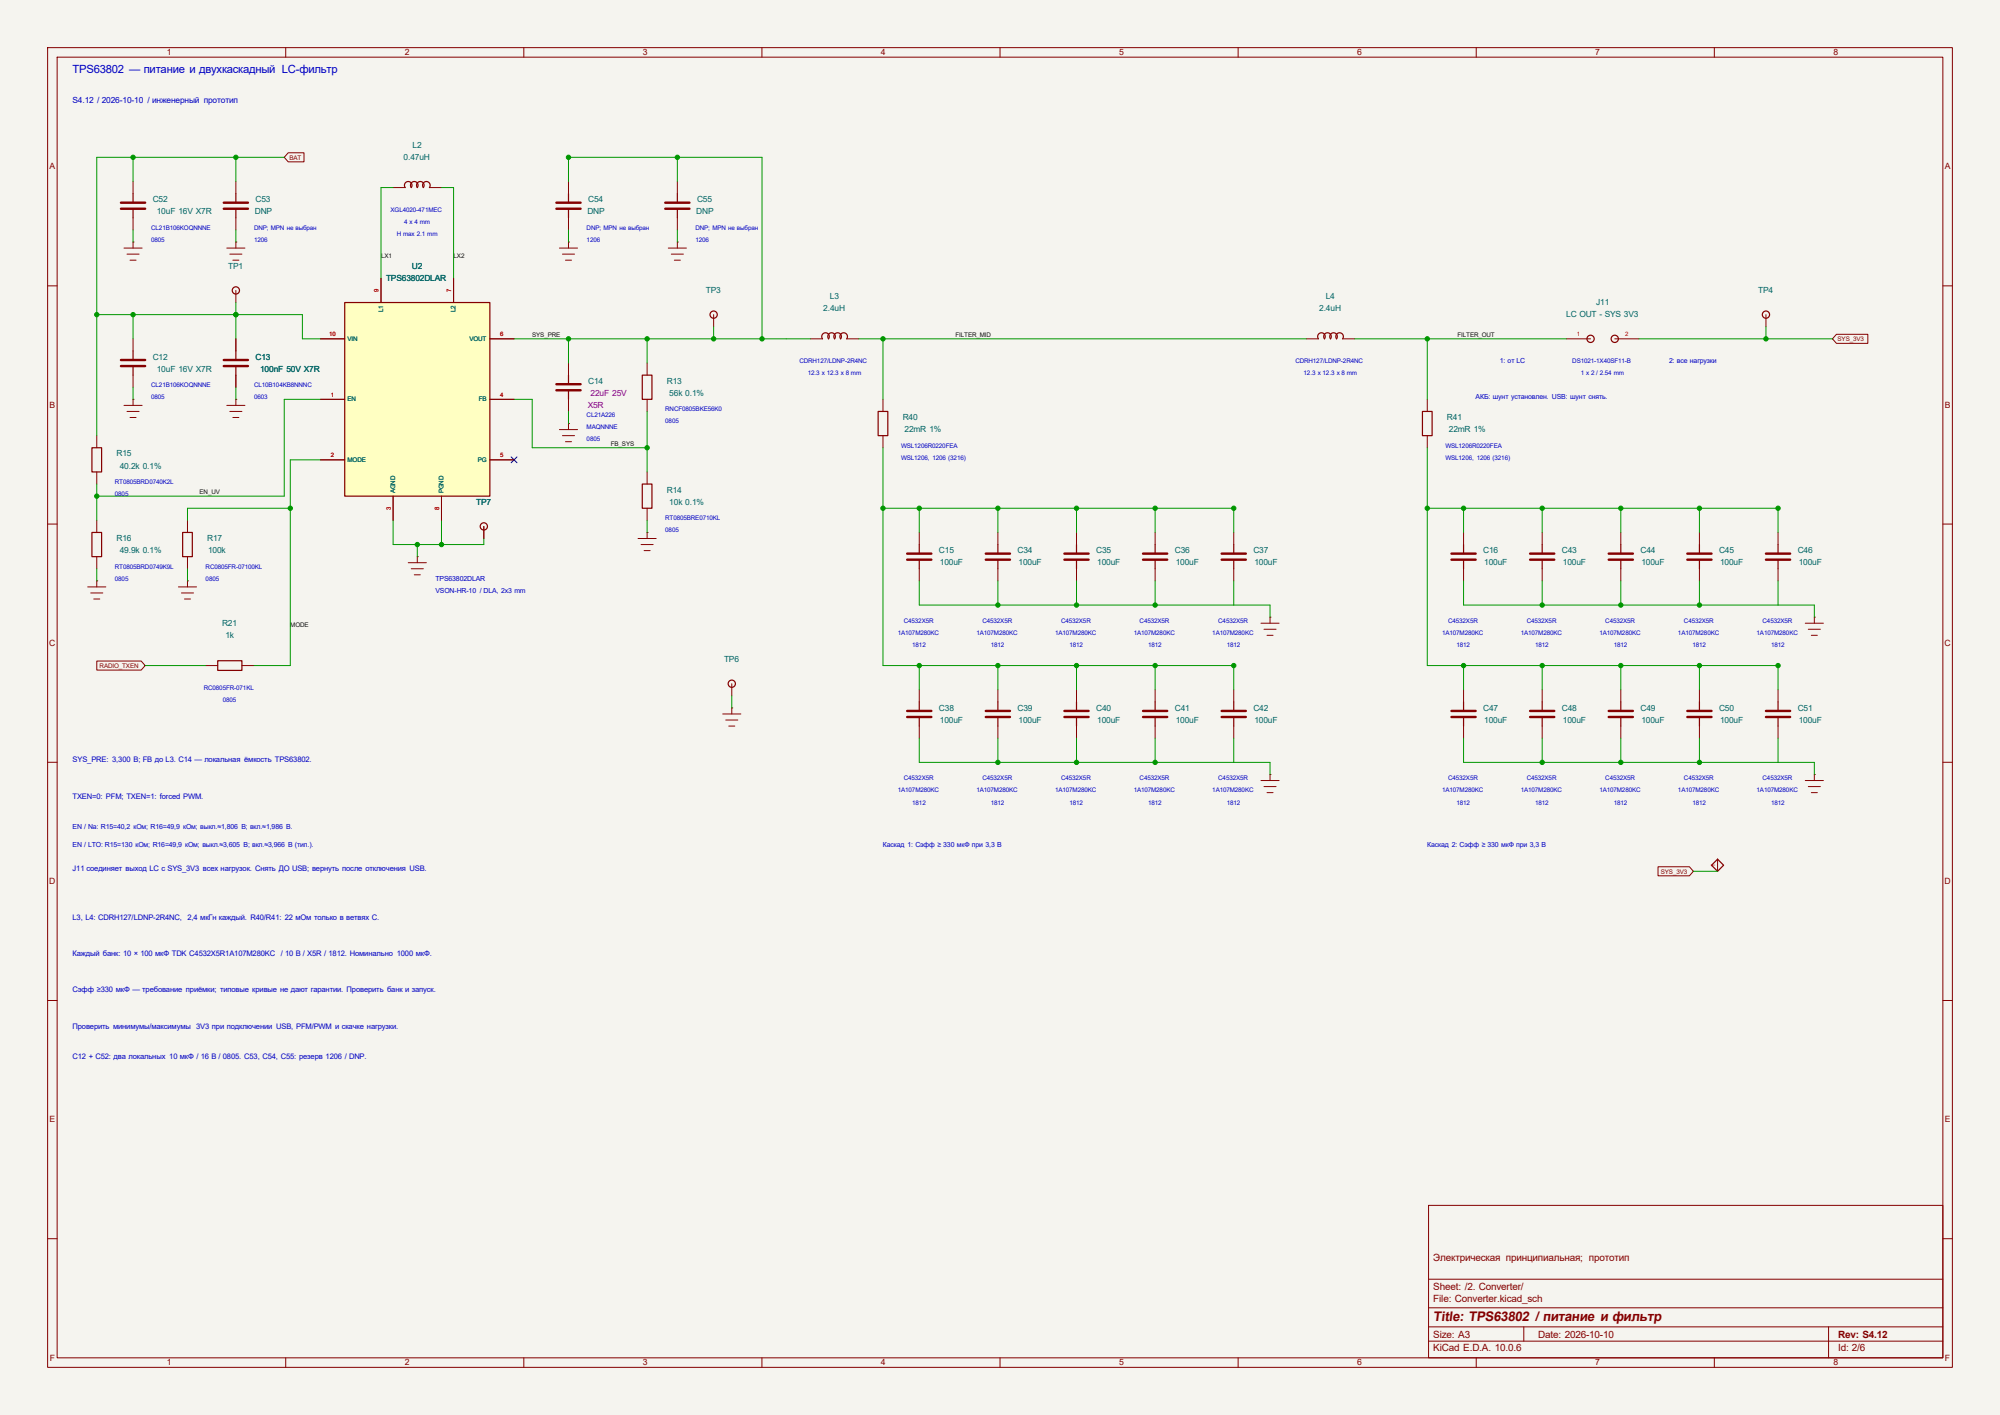
[picture p32: page 2]

S4.12 / 2026-10-10 / инженерный прототип TPS63802 — питание и двухкаскадный LC-фильтр
TP7 U2 TPS63802DLAR

DNP; MPN не выбран CL10B104KB8NNNC

1206 DNP; MPN не выбран

АКБ: шунт установлен. USB: шунт снять. RC0805FR-07100KL

0805 EN / Na: R15=40,2 кОм; R16=49,9 кОм; выкл.≈1,806 В; вкл.≈1,986 В. SYS_PRE: 3,300 В; FB до L3. C14 — локальная ёмкость TPS63802. EN / LTO: R15=130 кОм; R16=49,9 кОм; выкл.≈3,605 В; вкл.≈3,966 В (тип.). TXEN=0: PFM; TXEN=1: forced PWM.RC0805FR-071KL RT0805BRD0749K9L

Каскад 1: Cэфф ≥ 330 мкФ при 3,3 В

Каскад 2: Cэфф ≥ 330 мкФ при 3,3 В

L3, L4: CDRH127/LDNP-2R4NC, 2,4 мкГн каждый. R40/R41: 22 мОм только в ветвях C. Проверить минимумы/максимумы 3V3 при подключении USB, PFM/PWM и скачке нагрузки. J11 соединяет выход LC с SYS_3V3 всех нагрузок. Снять ДО USB; вернуть после отключения USB. Cэфф ≥330 мкФ — требование приёмки; типовые кривые не дают гарантии. Проверить банк и запуск. C12 + C52: два локальных 10 мкФ / 16 В / 0805. C53, C54, C55: резерв 1206 / DNP. Каждый банк: 10 × 100 мкФ TDK C4532X5R1A107M280KC / 10 В / X5R / 1812. Номинально 1000 мкФ.

File: Converter.kicad_sch Sheet: /2. Converter/ Электрическая принципиальная; прототип

Id: 2/6 Title: TPS63802 / питание и фильтр

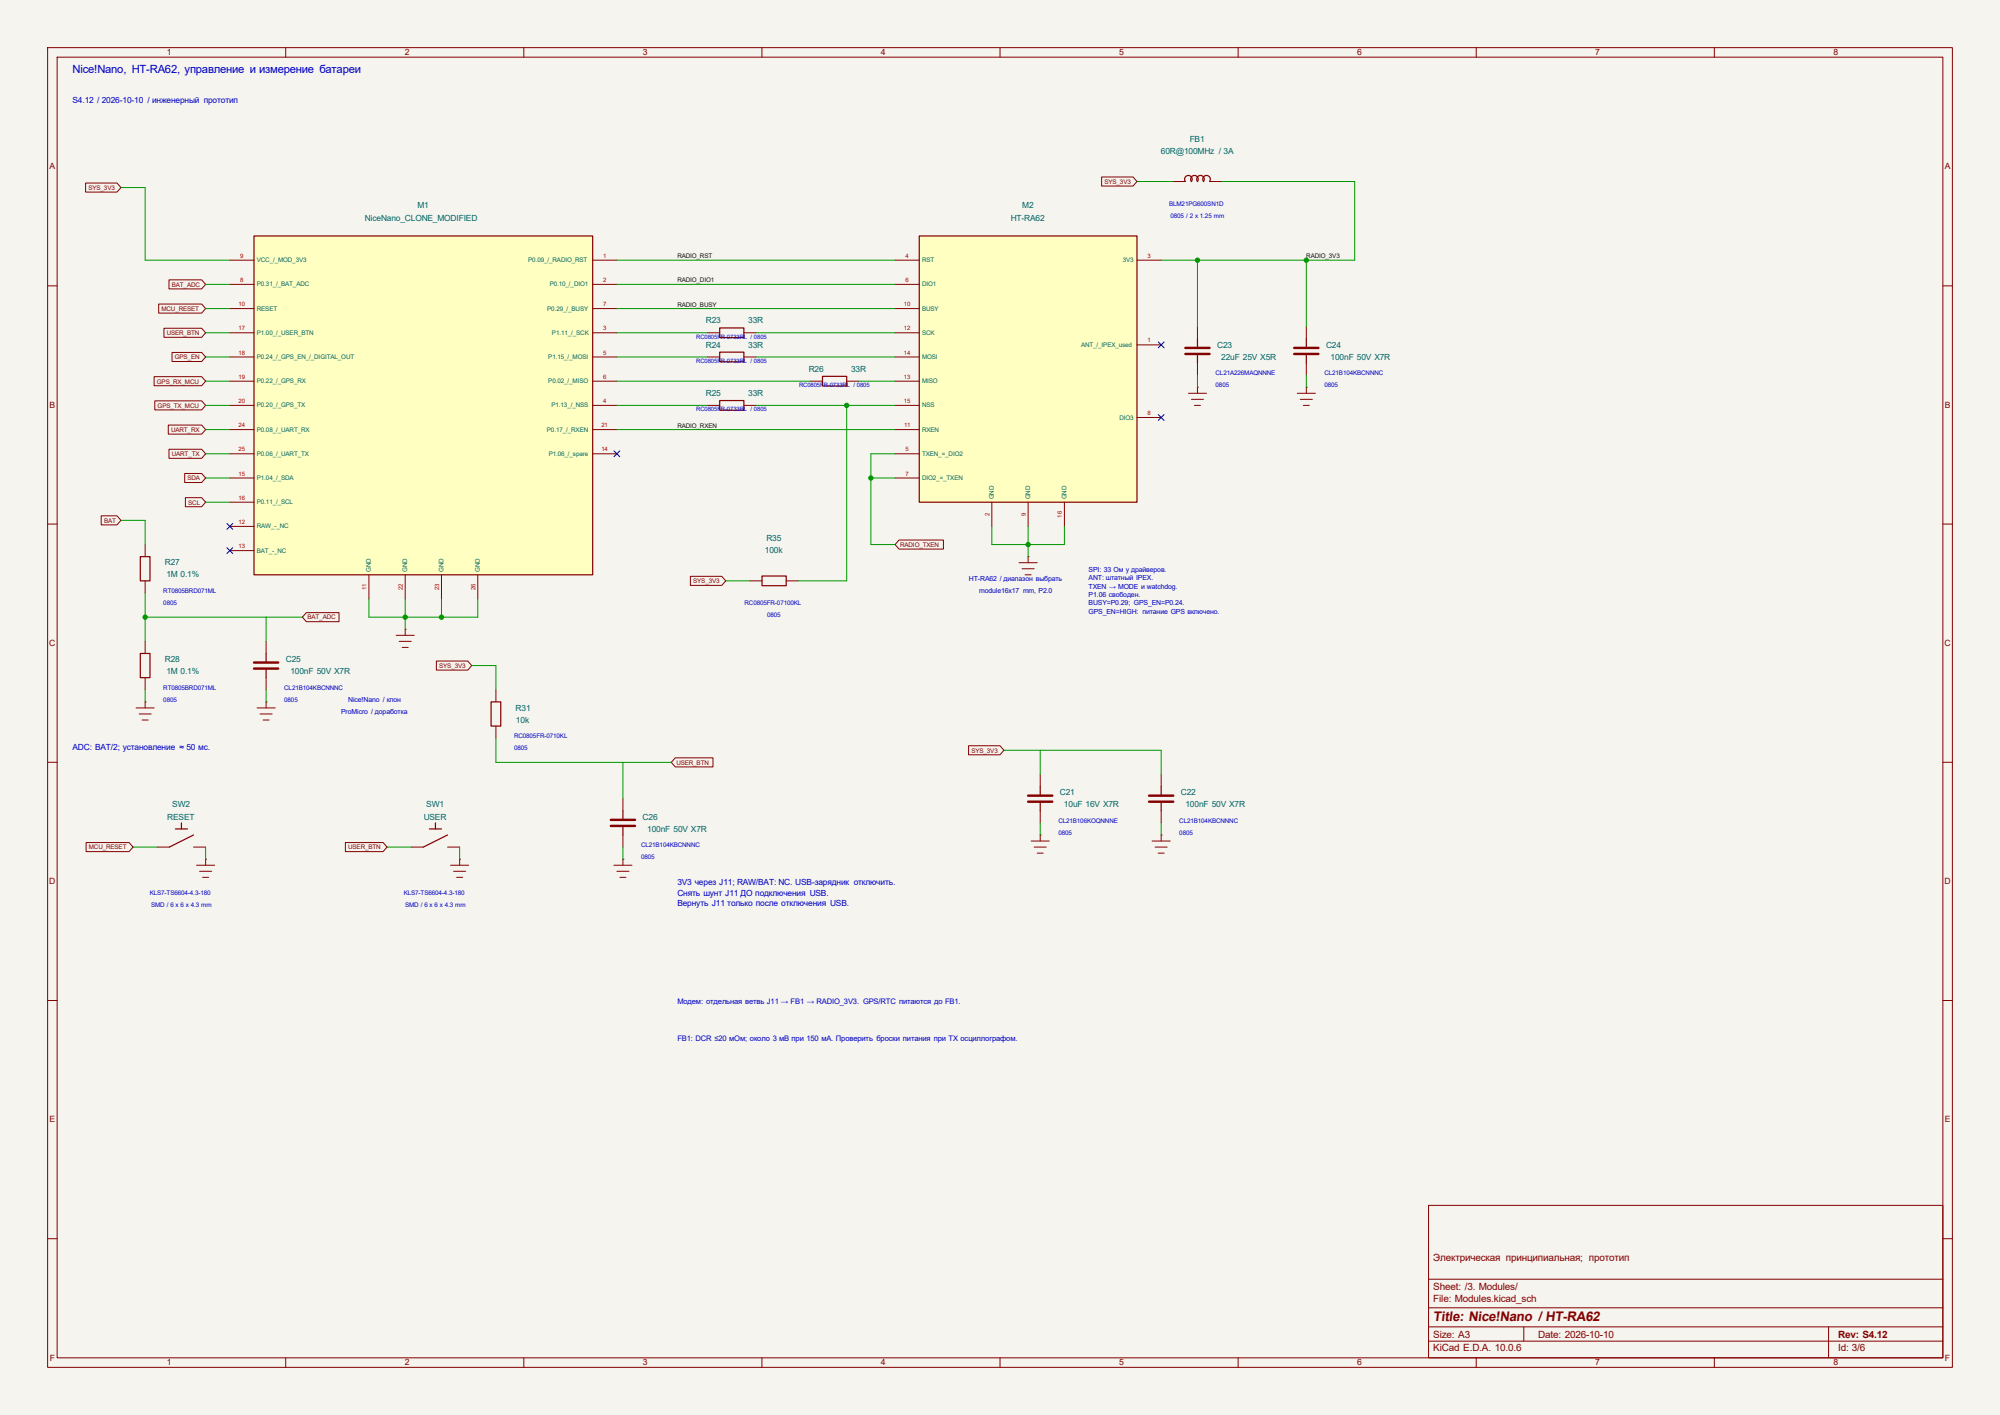
[picture p33: page 3]

9 BUSY 10 RXEN 11 SCK 12 MISO 13 MOSI 14 NSS 15 GND 16 M2 HT-RA62 R31

SCL GPS_EN
0805 KLS7-TS6604-4.3-180 ADC: BAT/2; установление ≈ 50 мс. SMD / 6 x 6 x 4.3 mm

0805 Nice!Nano / клон ProMicro / доработка

File: Modules.kicad_sch Sheet: /3. Modules/ Электрическая принципиальная; прототип

Id: 3/6 Title: Nice!Nano / HT-RA62

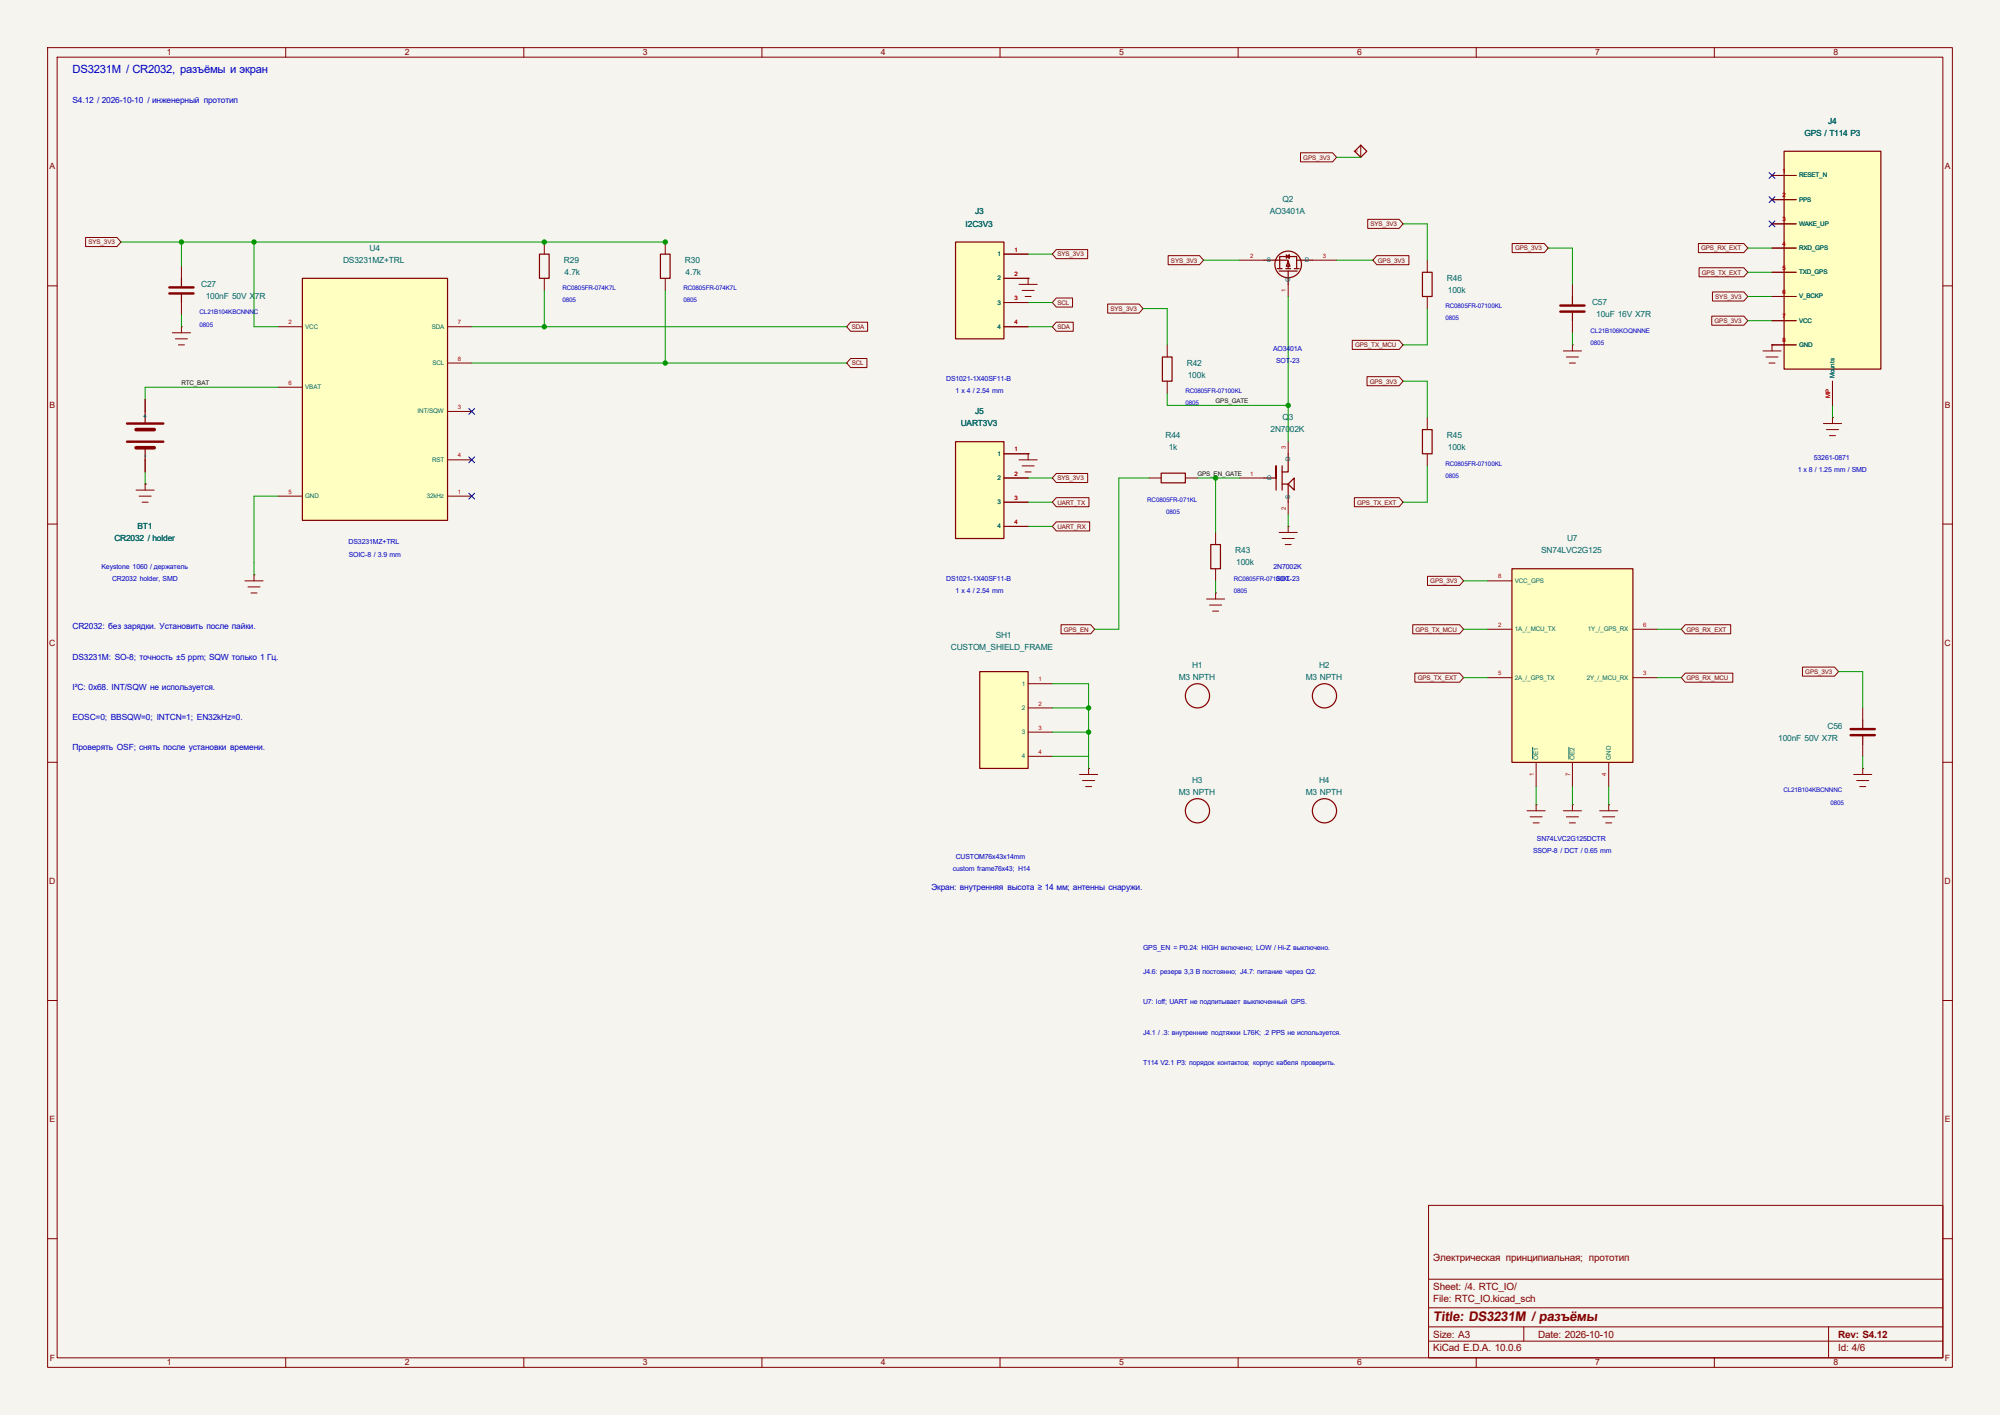
[picture p34: page 4]

0805 DS3231M: SO-8; точность ±5 ppm; SQW только 1 Гц.

1 x 8 / 1.25 mm / SMD Проверять OSF; снять после установки времени. EOSC=0; BBSQW=0; INTCN=1; EN32kHz=0.

0805 GPS_EN = P0.24: HIGH включено; LOW / Hi-Z выключено.

Экран: внутренняя высота ≥ 14 мм; антенны снаружи.

J4.6: резерв 3,3 В постоянно; J4.7: питание через Q2. T114 V2.1 P3: порядок контактов; корпус кабеля проверить.

U7: Ioff; UART не подпитывает выключенный GPS. J4.1 / .3: внутренние подтяжки L76K; .2 PPS не используется.

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
# Id: 5/6 Title: ATtiny13A / watchdog

## File: Watchdog.kicad_sch Sheet: /5. Watchdog/

## Электрическая принципиальная; прототип

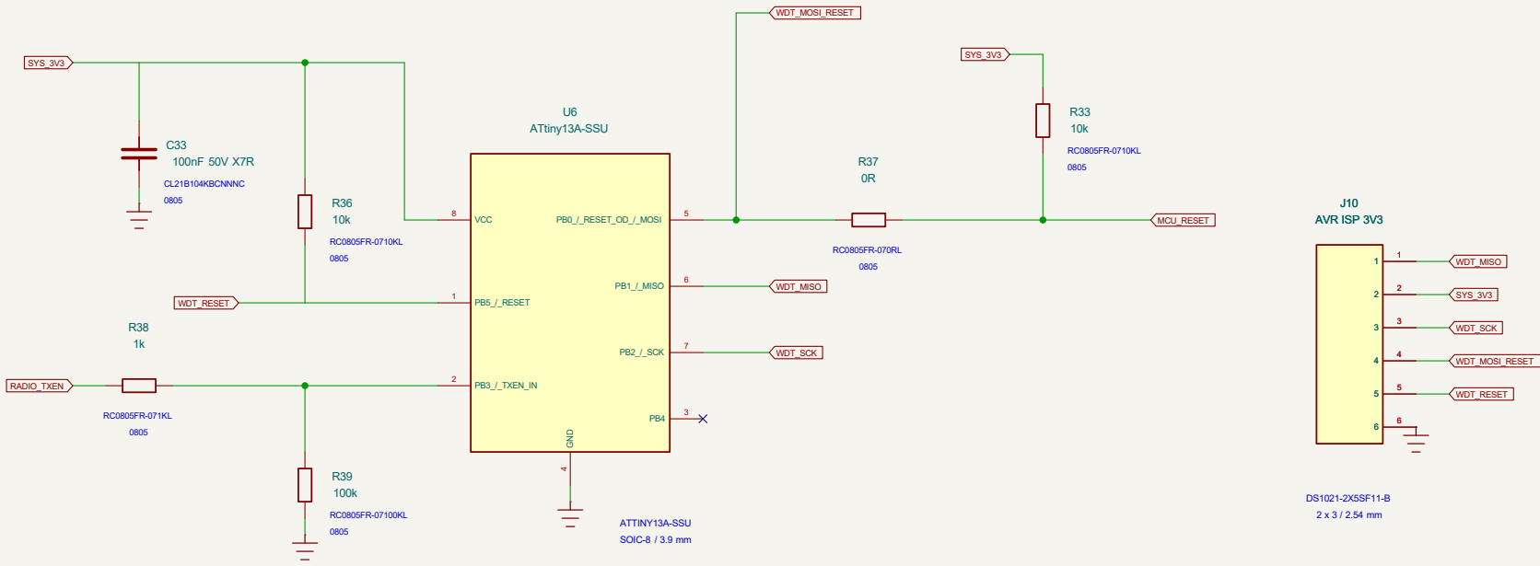
[picture p35: figure]
PB5_/_RESET 1; PB3_/_TXEN_IN 2; 3 GND; 6 J10 AVR ISP 3V3 WDT_SCK; SYS_3V3; WDT_MISO WDT_RESET RADIO_TXEN; WDT_MOSI_RESET SYS_3V3; WDT_RESET WDT_MISO WDT_SCK; CL21B104KBCNNNC; ATTINY13A-SSU; J10 AVR ISP 3V3

4 PB0_/_RESET_OD_/_MOSI 5 PB1_/_MISO 6 PB2_/_SCK 7 VCC 8 U6 ATtiny13A-SSU

SYS_3V3 MCU_RESET WDT_MOSI_RESET RC0805FR-07100KL TXEN HT-RA62 → R38 → PB3 (вывод 2). Контроль появления передач. 0805 ATtiny13A — внешний watchdog из пользовательского проекта

S4.12 / 2026-10-10 / инженерный прототип | SOIC-8 / 3.9 mm

0805 Сначала FLASH, затем LFUSE=0x7B / HFUSE=0xFB: 128 кГц, SUT ≈64 мс, BOD 2,7 В. J10: стандартный AVR ISP, уровни 3,3 В; SCK ≤ 10 кГц после установки fuse. BOD следит за SYS_3V3; порог EN батареи не меняется. Проверить восстановление и ток сна. PB0 (вывод 5): только LOW или Hi-Z. RESET ATtiny (вывод 1) — отдельная цепь. Плата питается сама: питание цели от программатора отключить. Для ISP снять R37.

0805 RC0805FR-0710KL Прошивка: watchdog/main.c. Штатное молчание радио более ≈3 ч также вызовет сброс. Нет импульсов TXEN: 1350 тактов WDT по 8 с ≈ 3 ч; затем RESET ≈ 1 с. 0805 RC0805FR-071KL

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
# Id: 6/6 Title: LMV431A / LTO 2S опция

## File: LTO_Balancer.kicad_sch Sheet: /6. LTO_Balancer/

## Электрическая принципиальная; прототип

C59

## 47nF 16V X7R

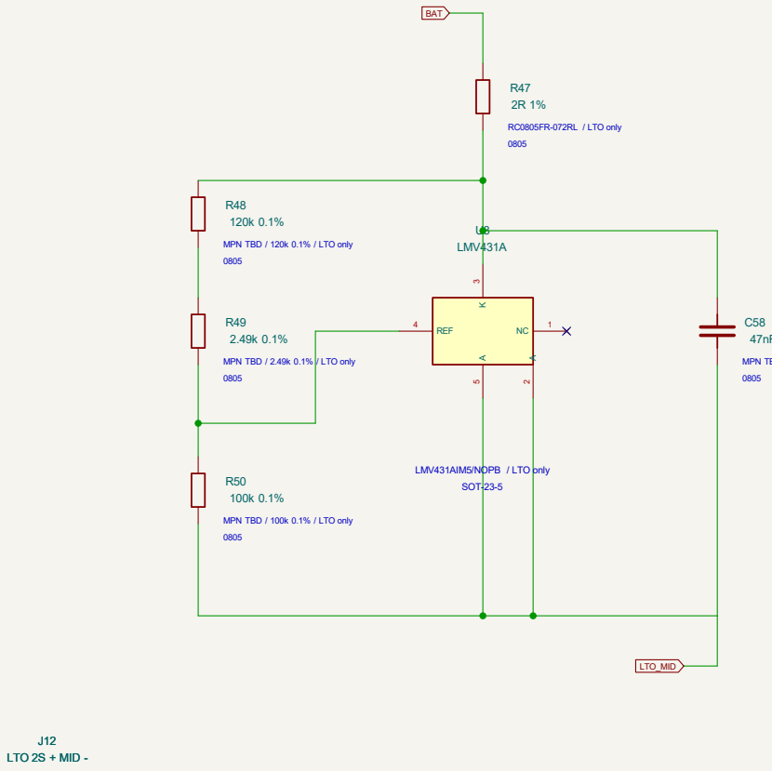
[picture p36: figure]
LTO 2S + MID -; 3 REF 4 A; 5 U8 LMV431A R50; LTO_MID; BAT; 0805 RC0805FR-072RL / LTO only

PACK+ | 1 MID | 2 PACK- | 3 J12

## 47nF 16V X7R

BAT

LTO_MID

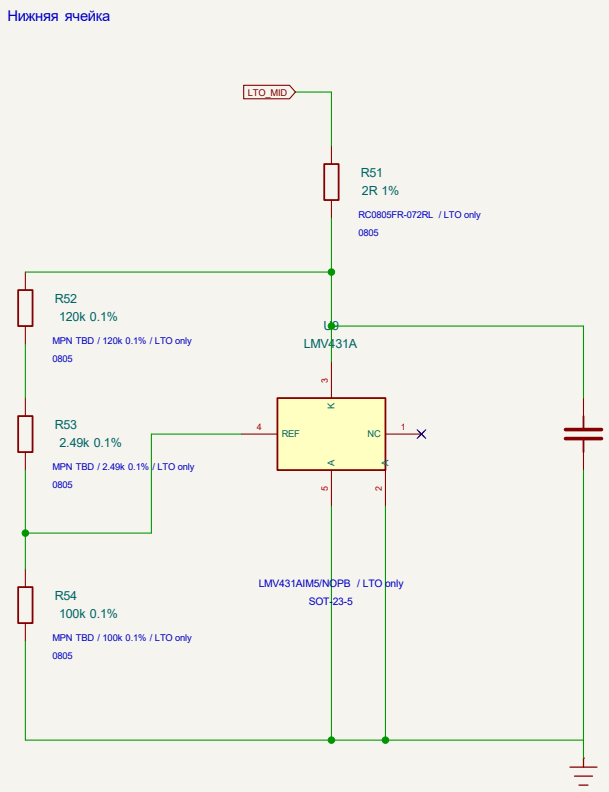
[picture p37: figure]
3 REF 4 A; LMV431A R52 120k 0.1%; LTO_MID; SOT-23-5 Нижняя ячейка

0805 MPN TBD / 2.49k 0.1% | / LTO only MPN TBD / 100k 0.1% / LTO only | MPN TBD / 100k 0.1% / LTO only SOT-23-5 Na-ion: R3=6,34k / R4=10k / C30=12pF. LTO: 13k / 10,5k / 6,8pF. Допуск R: 0,1%. Плата: балансир под общей крышкой. Отдельные линии к J12: 1 PACK+ / 2 MID / 3 PACK-. Балласт R47/R51 = 2R по выбору пользователя; ток LMV431 на углах допусков не ограничен до 15 мА. LTO: номинал 5,408 В; угол до 5,481 В при ТКС ≤25 ppm/°C, -40…85°C. Выбросы не учтены. S4.12: отдельной защиты ячеек и защиты от перенапряжения нет. Балансир: 2R, 120k+2,49k / 100k (0,1%), LMV431A, 47nF.

0805 MPN TBD / 120k 0.1% / LTO only Верхняя ячейка S4.12 / 2026-10-10 / инженерный прототип 06. Балансир 2S LTO / опциональная сборка

RC0805FR-072RL / LTO only LMV431AIM5/NOPB / LTO only MPN TBD / 2.49k 0.1% | / LTO only 0805 | 0805
0805 | MPN TBD / 47nF X7R 16V / LTO only Na-ion: этот лист не запаивать. LTO 2S: запаять все компоненты этого листа. | LMV431AIM5/NOPB / LTO only 1 x 3 / 2.54 mm

DS1021-1X40SF11-B / LTO only

MPN TBD / 120k 0.1% / LTO only 0805 | 0805
0805 | 0805 MPN TBD / 47nF X7R 16V / LTO only J12
LTO 2S + MID - PACK+ | 1 MID | 2 PACK- | 3
