Alksndr55/mesh-repeater/(list of files, drawings)

Other design files:
design/Meshcore_NaIon/schematic_manifest.json
