Alksndr55/mesh-repeater/v1/design/Meshcore_NaIon/Meshcore_NaIon.kicad_pcb

## KiCad design v1/design/Meshcore_NaIon/Meshcore_NaIon.kicad_pcb (2026-11-06)

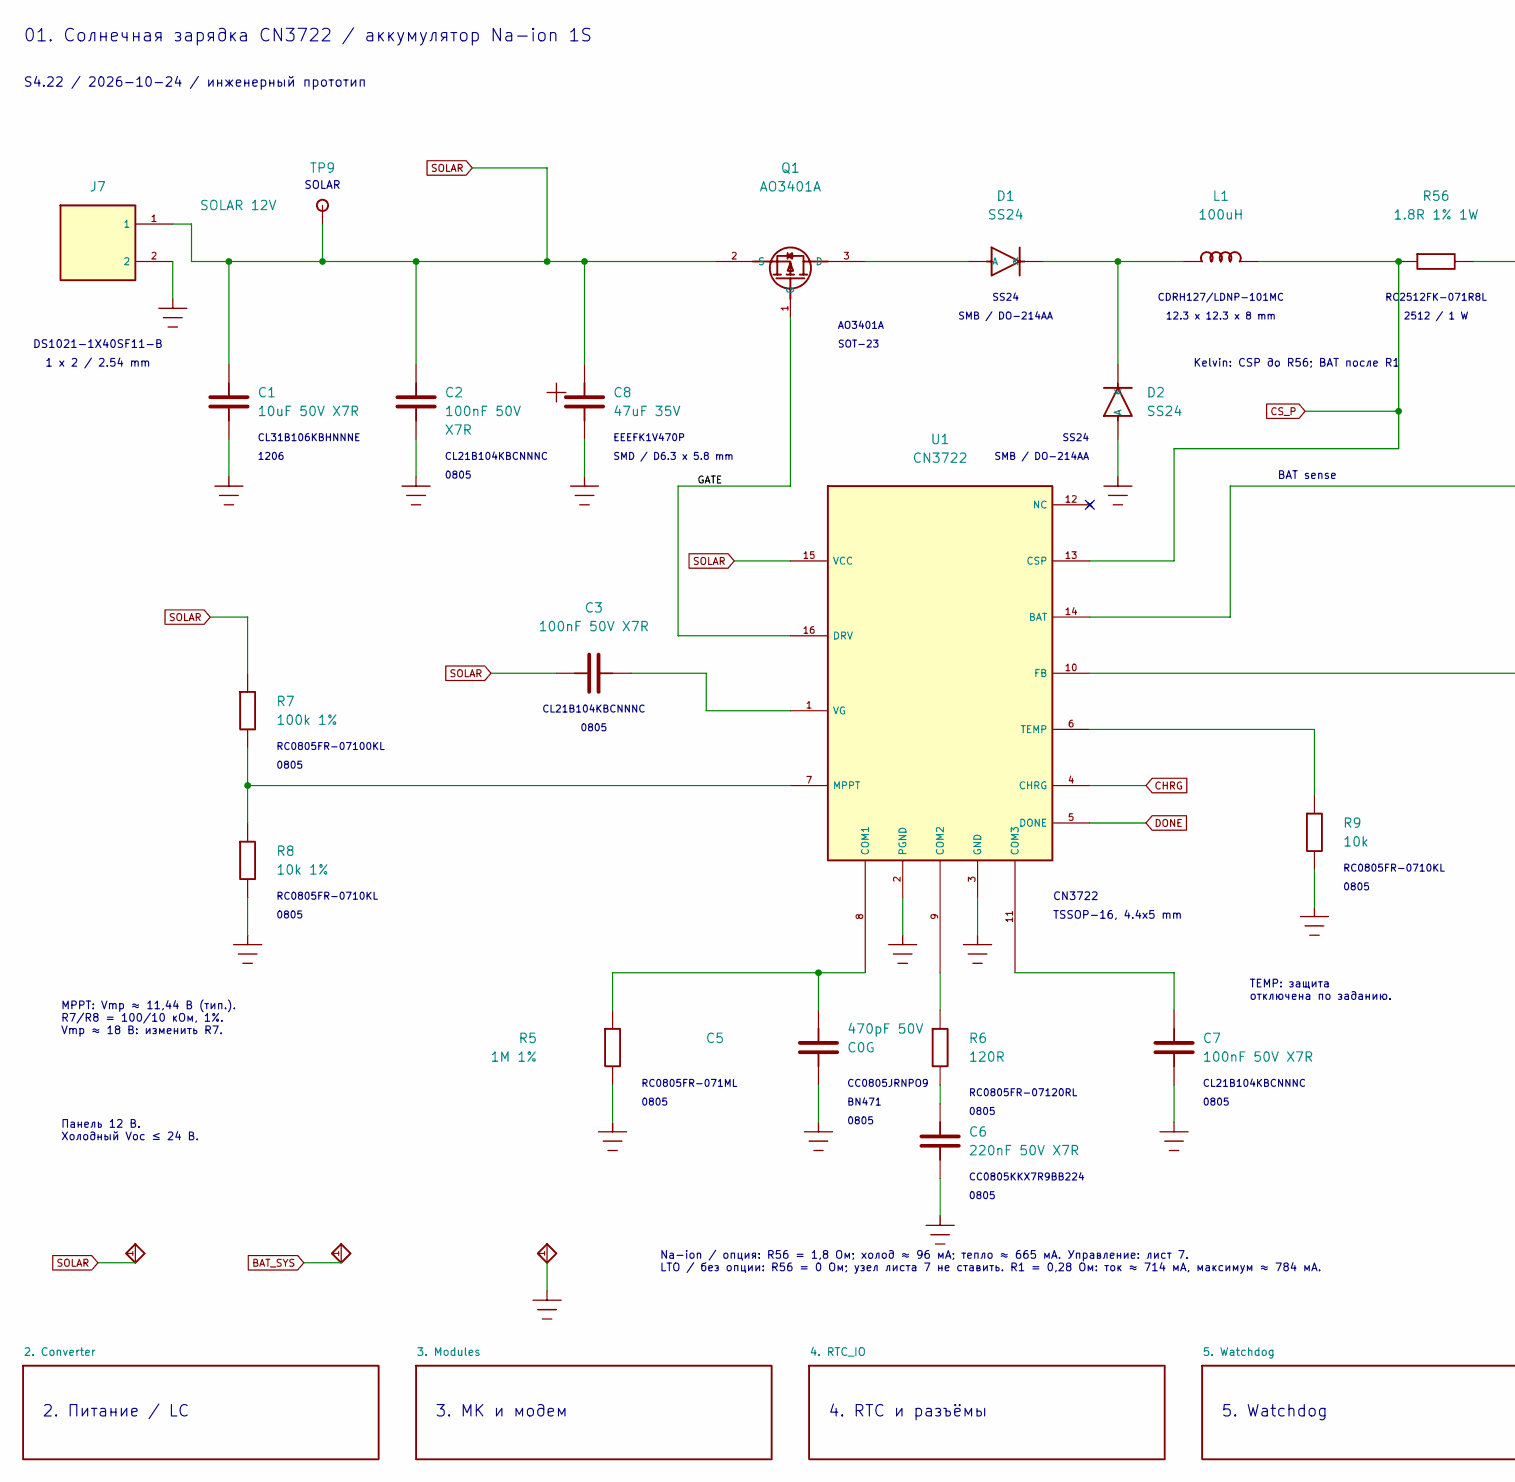
[picture p54: schematic Meshcore_NaIon.kicad_sch, CN3722 / зарядка Na-ion и LTO, part in row 1, column 1]

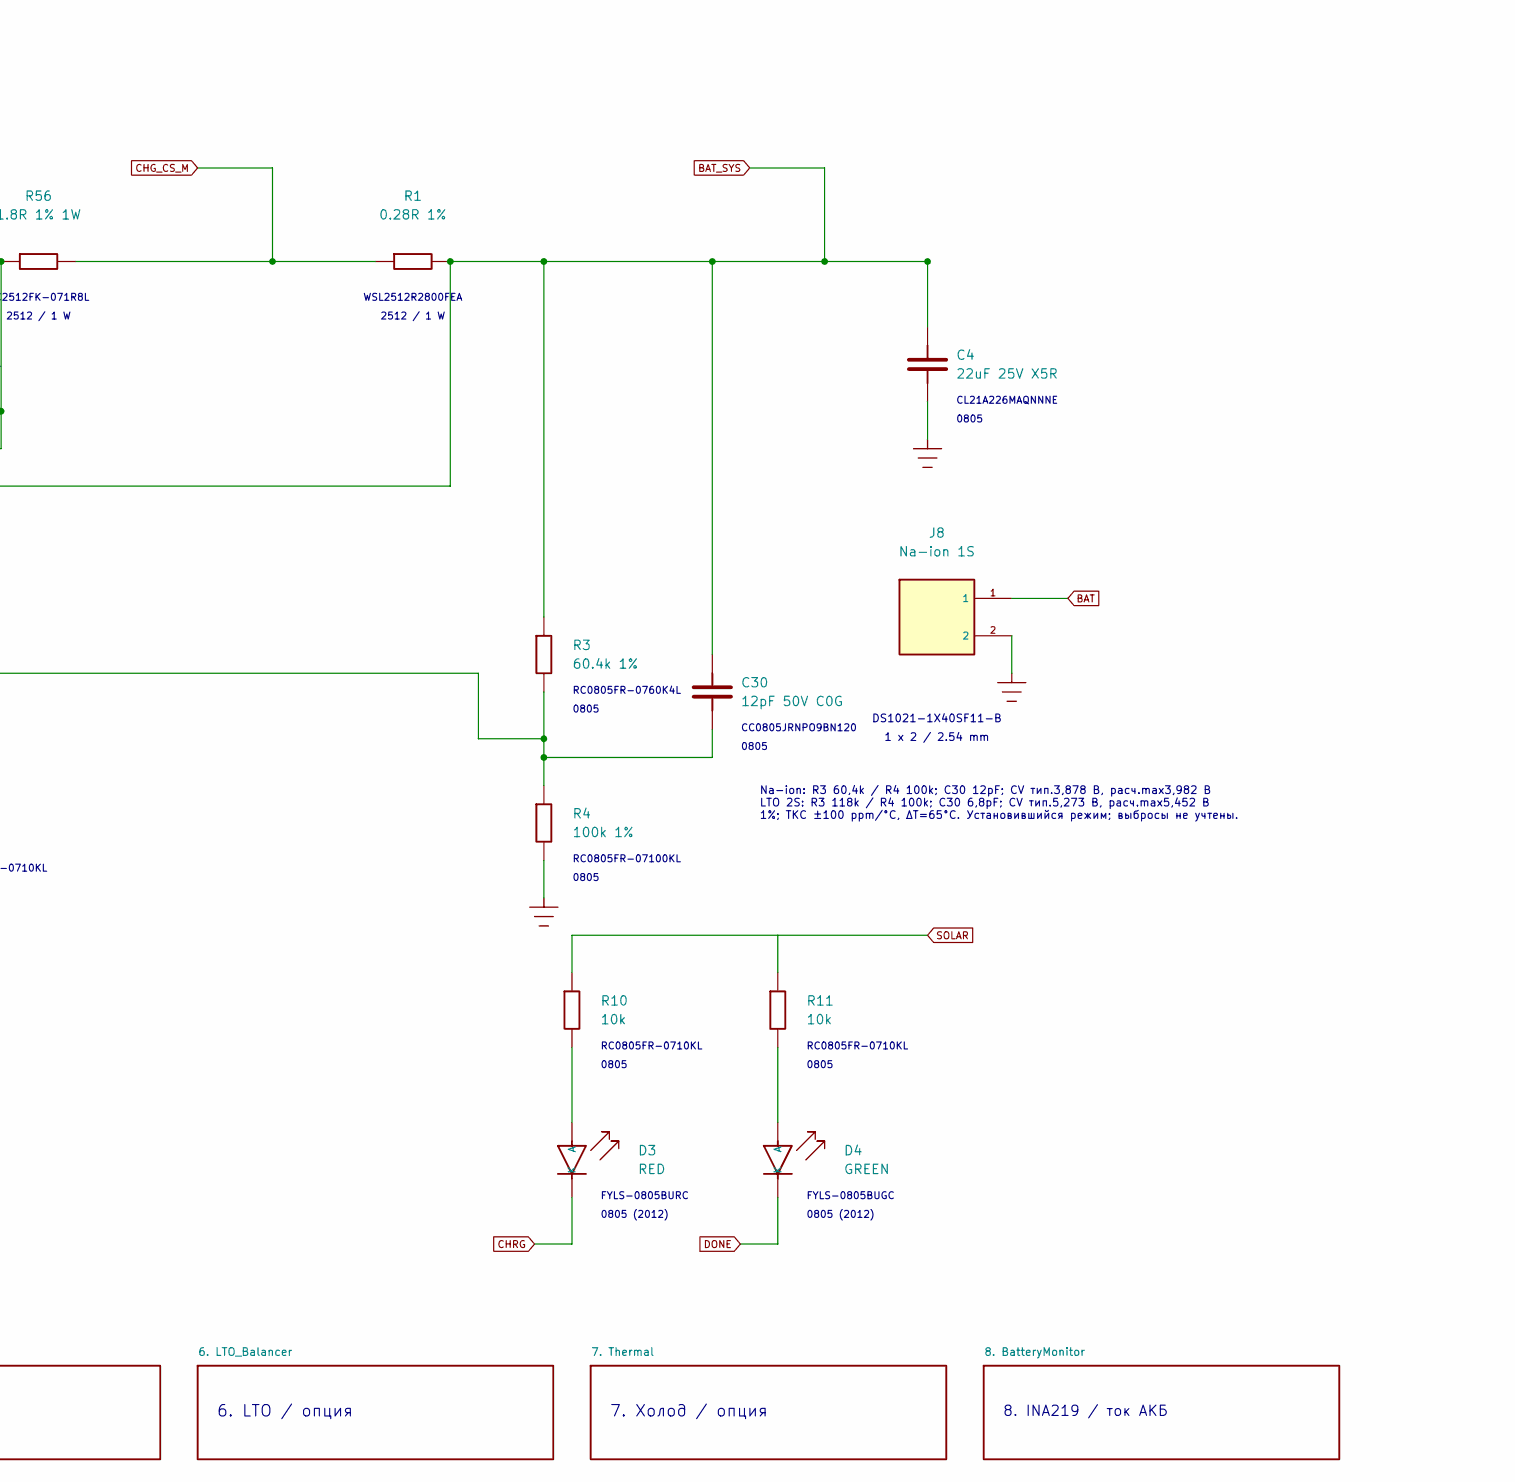
[picture p55: schematic Meshcore_NaIon.kicad_sch, CN3722 / зарядка Na-ion и LTO, part in row 1, column 2]

Parts:
C1: 10uF 50V X7R; C_1206_3216Metric; MPN CL31B106KBHNNNE
C2, C3, C7: 100nF 50V X7R; C_0805_2012Metric; MPN CL21B104KBCNNNC
C4: 22uF 25V X5R; C_0805_2012Metric; MPN CL21A226MAQNNNE
C5: 470pF 50V C0G; C_0805_2012Metric; MPN CC0805JRNPO9BN471
C6: 220nF 50V X7R; C_0805_2012Metric; MPN CC0805KKX7R9BB224
C8: 47uF 35V; CP_Elec_Panasonic_FK_D_6.3x5.8; MPN EEEFK1V470P
C30: 12pF 50V C0G; C_0805_2012Metric; MPN CC0805JRNPO9BN120
D1, D2: SS24; D_SMB; MPN SS24
D3: RED; LED_0805_2012Metric; MPN FYLS-0805BURC
D4: GREEN; LED_0805_2012Metric; MPN FYLS-0805BUGC
J7: SOLAR 12V; PinHeader_1x02_P2.54mm_Vertical; MPN DS1021-1X40SF11-B
J8: Na-ion 1S; PinHeader_1x02_P2.54mm_Vertical; MPN DS1021-1X40SF11-B
L1: 100uH; L_Sumida_CDRH127_LDNP_101MC; MPN CDRH127/LDNP-101MC
Q1: AO3401A; SOT-23; MPN AO3401A
R1: 0.28R 1%; R_Vishay_WSL2512_A3__A3_R1; MPN WSL2512R2800FEA
R3: 60.4k 1%; R_0805_2012Metric; MPN RC0805FR-0760K4L; LCSC C2084414
R4: 100k 1%; R_0805_2012Metric; MPN RC0805FR-07100KL; LCSC C110775
R5: 1M 1%; R_0805_2012Metric; MPN RC0805FR-071ML
R6: 120R; R_0805_2012Metric; MPN RC0805FR-07120RL
R7: 100k 1%; R_0805_2012Metric; MPN RC0805FR-07100KL; LCSC C856623
R8: 10k 1%; R_0805_2012Metric; MPN RC0805FR-0710KL
R9, R10, R11: 10k; R_0805_2012Metric; MPN RC0805FR-0710KL
R56: 1.8R 1% 1W; R_2512_6332Metric__A3_R56; MPN RC2512FK-071R8L
TP9: SOLAR; TestPoint_Pad_D1.5mm; MPN PCB test pad / not purchased
U1: CN3722; TSSOP-16_4.4x5mm_P0.65mm; MPN CN3722; LCSC C77905

Connections:
/GATE: Q1.1 (G), U1.16 (DRV)
BAT: J8.1; also elsewhere on the board
BAT_SYS: C4.1, C30.1, R1.2, R3.1, U1.14 (BAT); also elsewhere on the board
CHG_CS_M: R1.1, R56.2; also elsewhere on the board
CHRG: D3.1 (K), U1.4 (CHRG)
CS_P: L1.2, R56.1, U1.13 (CSP); also elsewhere on the board
DONE: D4.1 (K), U1.5 (DONE)
GND: C1.2, C2.2, C4.2, C5.2, C6.2, C7.2, C8.2, D2.2 (A), J7.2, J8.2, R4.2, R5.2, R8.2, R9.2, U1.2 (PGND), U1.3 (GND); also elsewhere on the board
unnamed: C6.1, R6.2
unnamed: D1.2 (A), Q1.3 (D)
unnamed: D1.1 (K), D2.1 (K), L1.1
unnamed: D3.2 (A), R10.2
unnamed: D4.2 (A), R11.2
unnamed: C5.1, R5.1, U1.8 (COM1)
unnamed: R6.1, U1.9 (COM2)
unnamed: C7.1, U1.11 (COM3)
unnamed: C30.2, R3.2, R4.1, U1.10 (FB)
unnamed: R7.2, R8.1, U1.7 (MPPT)
unnamed: R9.1, U1.6 (TEMP)
unnamed: C3.2, U1.1 (VG)
SOLAR: C1.1, C2.1, C3.1, C8.1, J7.1, Q1.2 (S), R7.1, R10.1, R11.1, TP9.1, U1.15 (VCC); also elsewhere on the board

Notes on the sheet:
0805
RC0805FR-07120RL
Kelvin: CSP до R56; BAT после R1
EEEFK1V470P
WSL2512R2800FEA
3. МК и модем
2512 / 1 W
TEMP: защита отключена по заданию.
8. INA219 / ток АКБ
0805 (2012)
1206
SMB / DO-214AA
RC0805FR-07100KL
DS1021-1X40SF11-B
SOT-23
CL21A226MAQNNNE
6. LTO / опция
CL21B104KBCNNNC
1 x 2 / 2.54 mm
Na-ion: R3 60,4k / R4 100k; C30 12pF; CV тип.3,878 В, расч.max3,982 В LTO 2S: R3 118k / R4 100k; C30 6,8pF; CV тип.5,273 В, расч.max5,452 В 1%; ТКС ±100 ppm/°C, ΔT=65°C. Установившийся режим; выбросы не учтены.
4. RTC и разъёмы
FYLS-0805BURC
TSSOP-16, 4.4x5 mm
FYLS-0805BUGC
RC2512FK-071R8L
RC0805FR-0710KL
SS24
AO3401A
RC0805FR-0760K4L
CC0805KKX7R9BB224
CC0805JRNPO9BN120
S4.22 / 2026-10-24 / инженерный прототип
Панель 12 В. Холодный Voc ≤ 24 В.
CL31B106KBHNNNE
SMD / D6.3 x 5.8 mm
SOLAR
BAT sense
01. Солнечная зарядка CN3722 / аккумулятор Na-ion 1S
MPPT: Vmp ≈ 11,44 В (тип.). R7/R8 = 100/10 кОм, 1%. Vmp ≈ 18 В: изменить R7.
5. Watchdog
2. Питание / LC
12.3 x 12.3 x 8 mm
RC0805FR-071ML
CDRH127/LDNP-101MC
Na-ion / опция: R56 = 1,8 Ом; холод ≈ 96 мА; тепло ≈ 665 мА. Управление: лист 7. LTO / без опции: R56 = 0 Ом; узел листа 7 не ставить. R1 = 0,28 Ом: ток ≈ 714 мА, максимум ≈ 784 мА.
CC0805JRNPO9
CN3722
7. Холод / опция
BN471

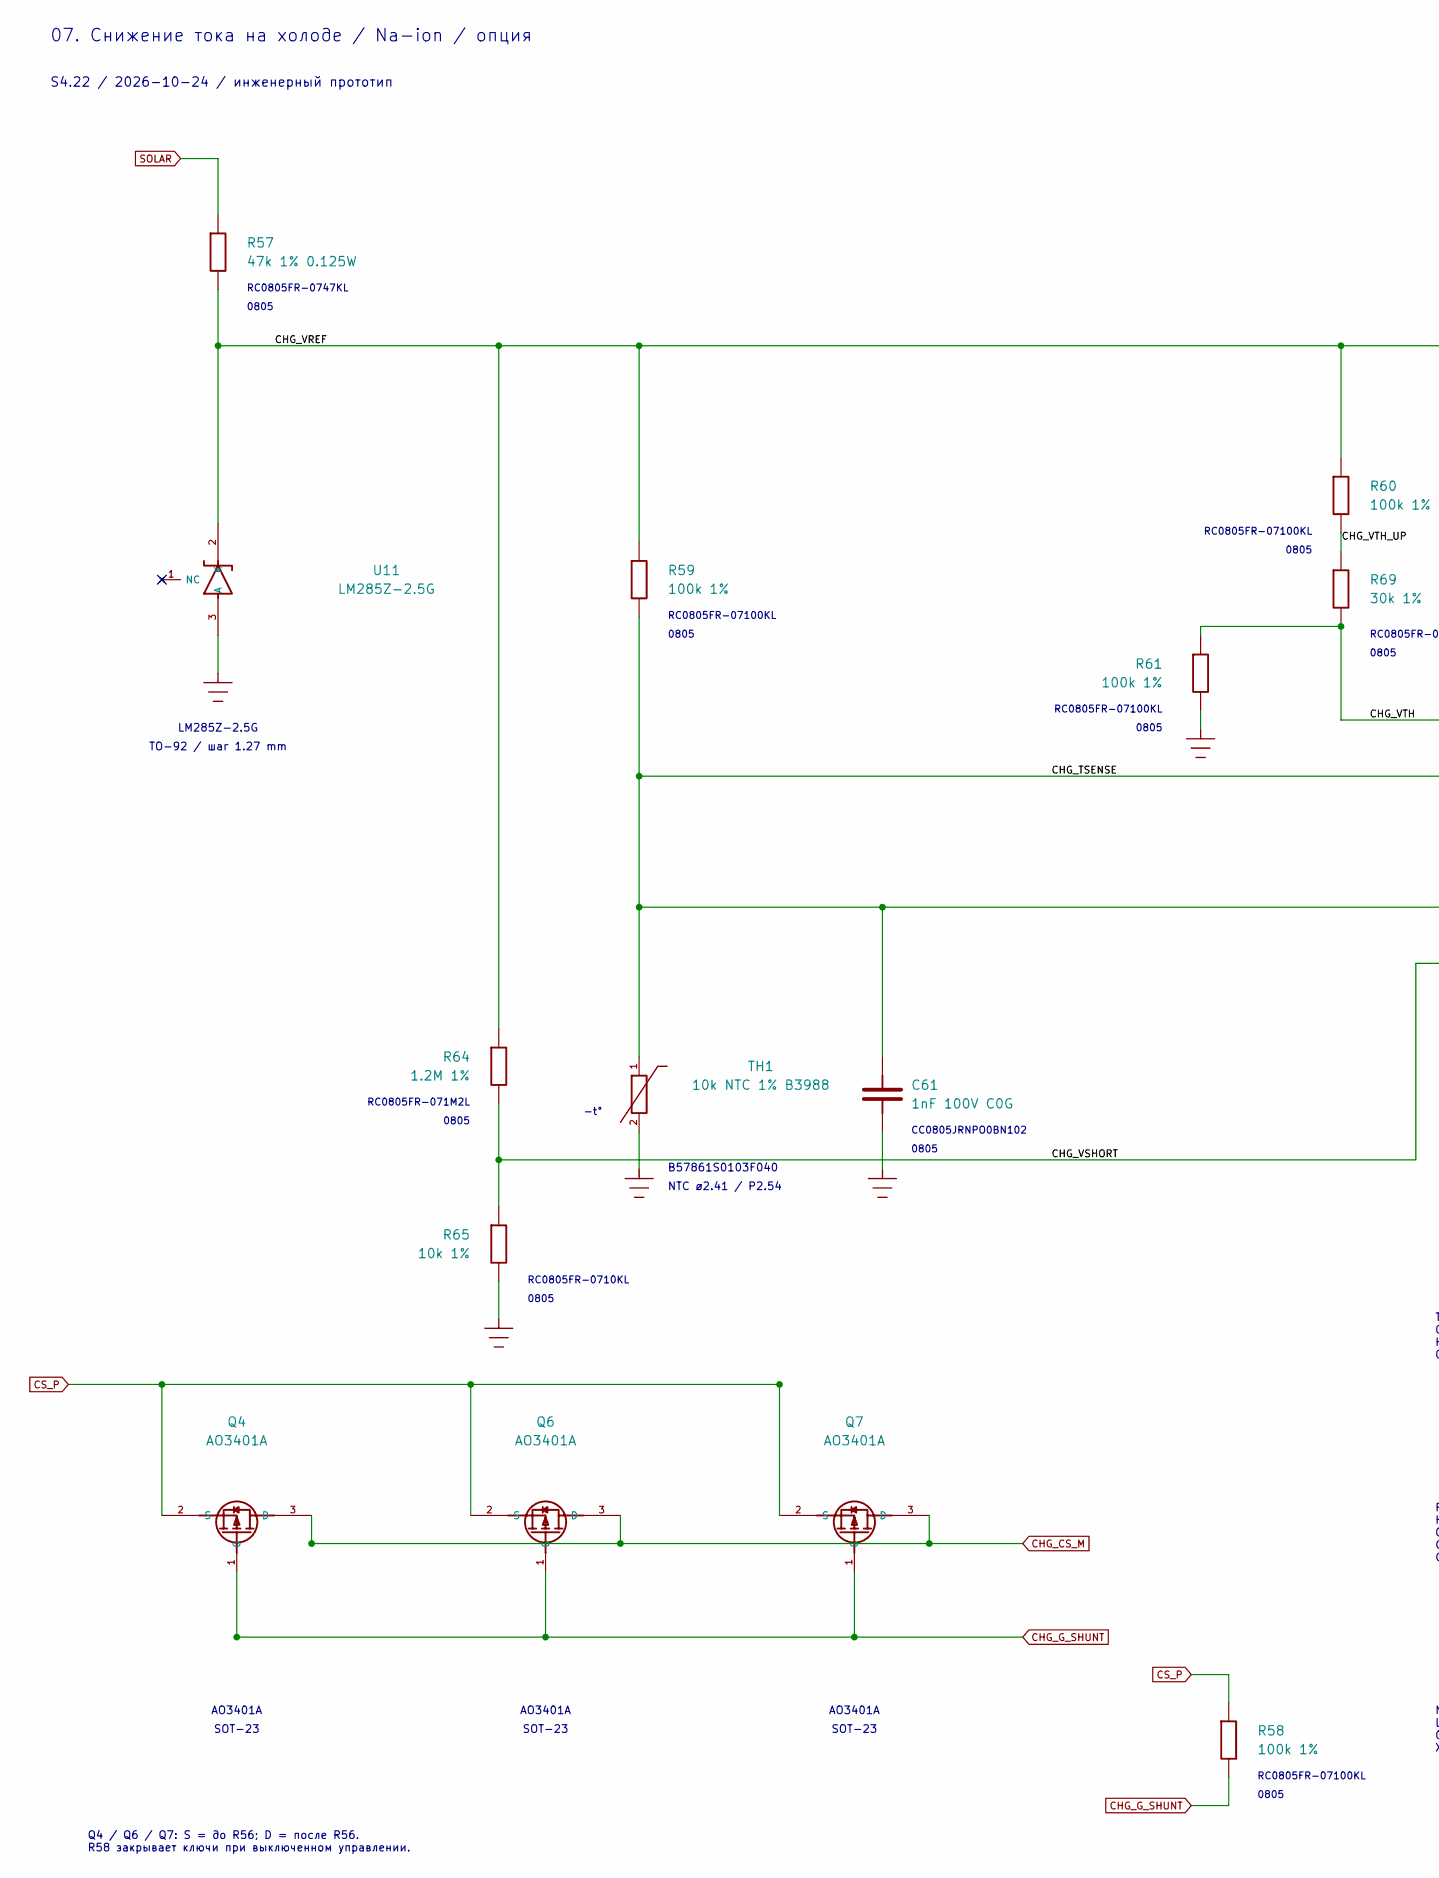
[picture p56: schematic Thermal.kicad_sch, LM393XK / холодный заряд Na-ion, part in row 1, column 1]

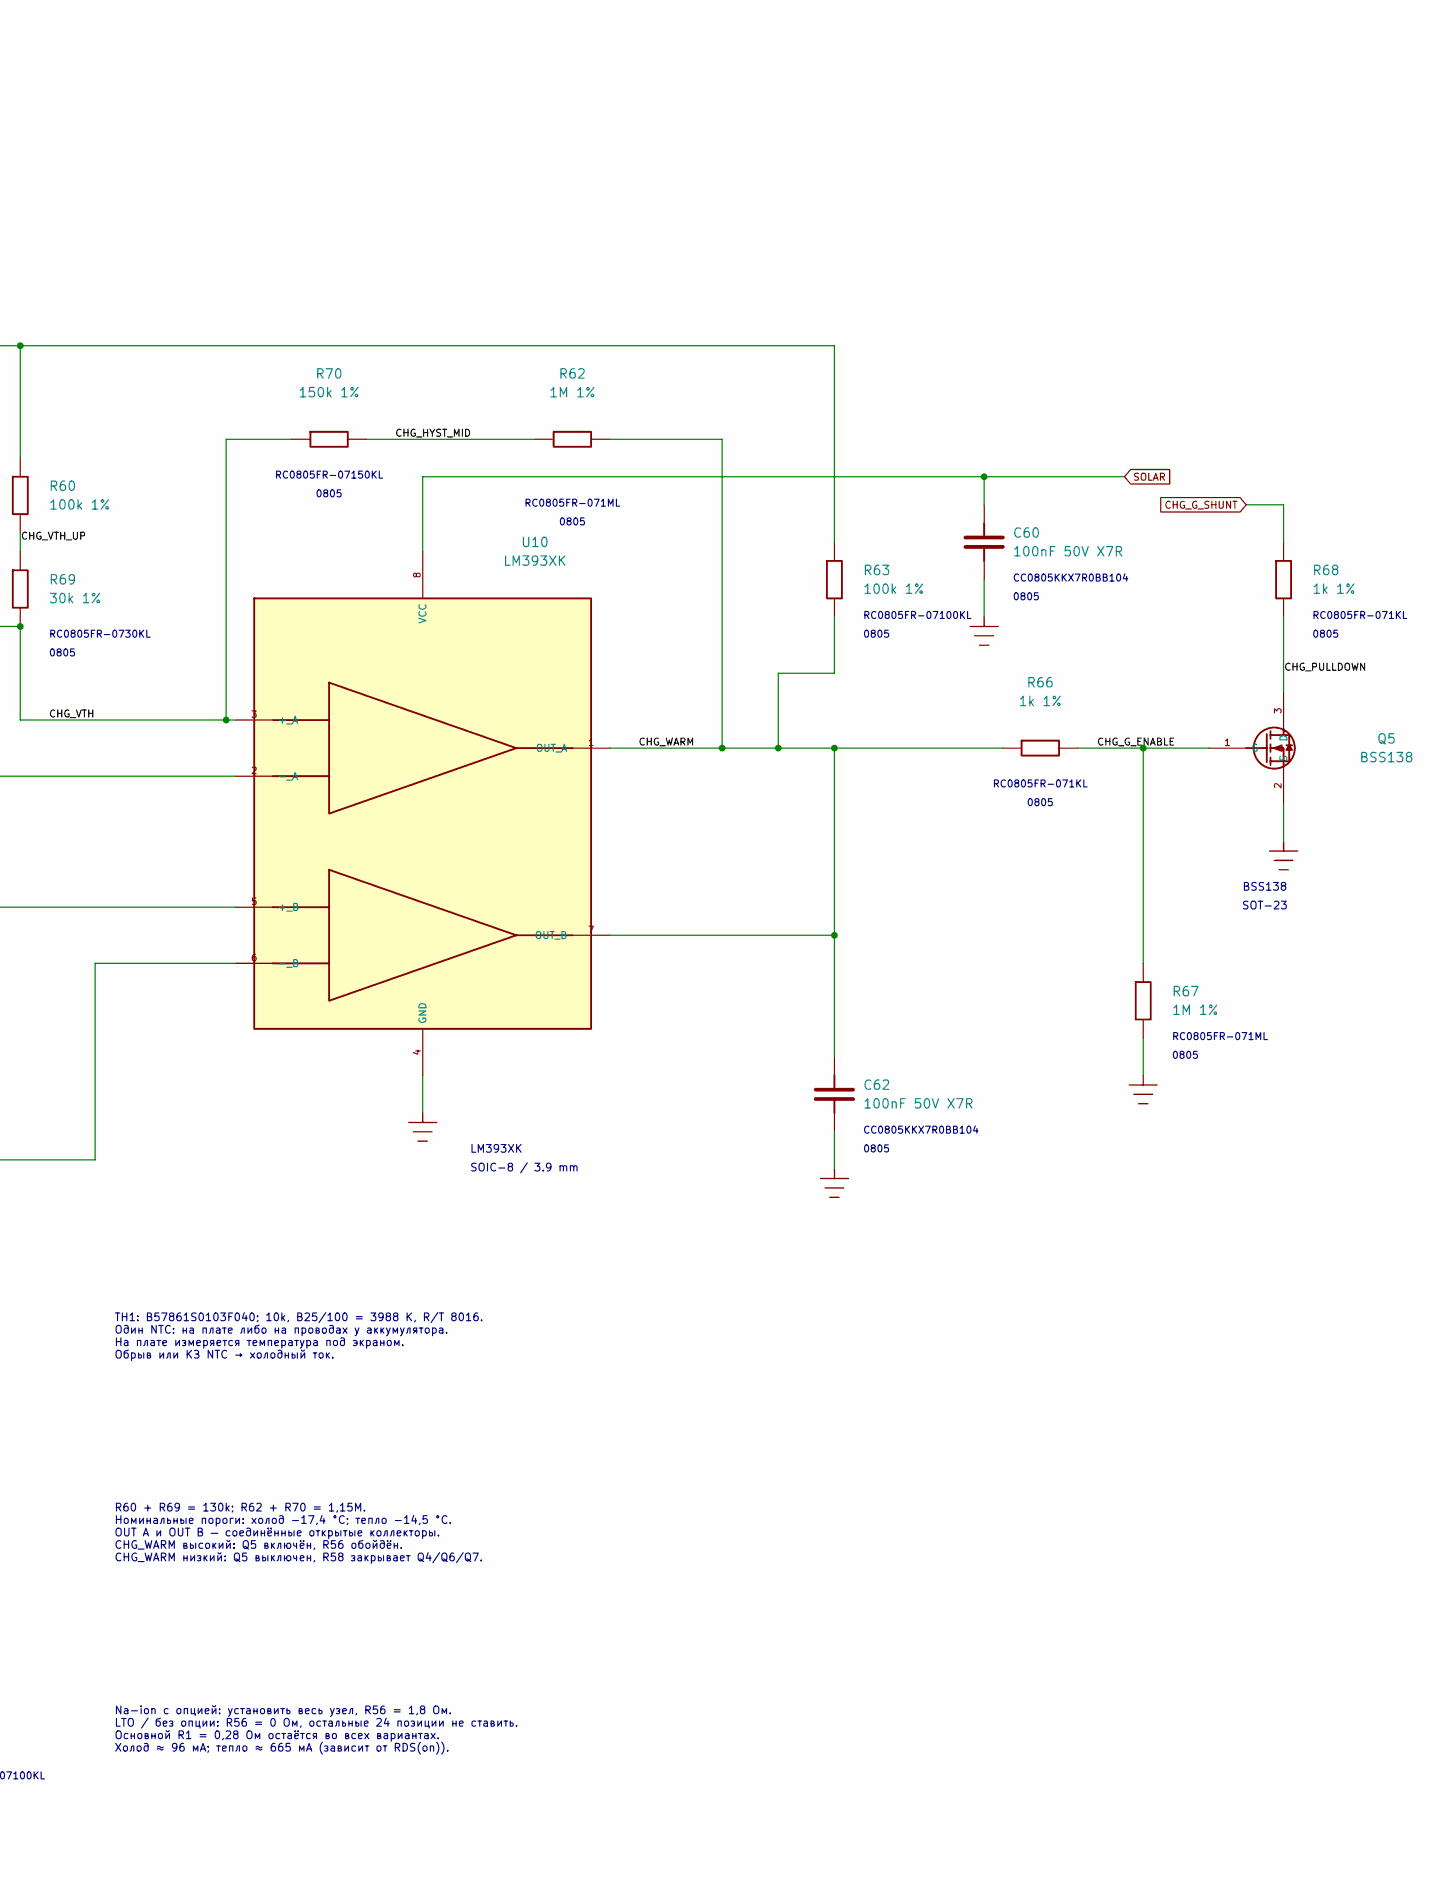
[picture p57: schematic Thermal.kicad_sch, LM393XK / холодный заряд Na-ion, part in row 1, column 2]

Parts:
C60, C62: 100nF 50V X7R; C_0805_2012Metric; MPN CL21B104KBCNNNC
C61: 1nF 100V C0G; C_0805_2012Metric; MPN CC0805JRNPO0BN102
Q4, Q6, Q7: AO3401A; SOT-23; MPN AO3401A
Q5: BSS138; SOT-23; MPN BSS138
R57: 47k 1% 0.125W; R_0805_2012Metric; MPN RC0805FR-0747KL
R58, R59, R60, R61, R63: 100k 1%; R_0805_2012Metric; MPN RC0805FR-07100KL
R62, R67: 1M 1%; R_0805_2012Metric; MPN RC0805FR-071ML
R64: 1.2M 1%; R_0805_2012Metric; MPN RC0805FR-071M2L
R65: 10k 1%; R_0805_2012Metric; MPN RC0805FR-0710KL
R66, R68: 1k 1%; R_0805_2012Metric; MPN RC0805FR-071KL
R69: 30k 1%; R_0805_2012Metric; MPN RC0805FR-0730KL
R70: 150k 1%; R_0805_2012Metric; MPN RC0805FR-07150KL
TH1: 10k NTC 1% B3988; NTC_TDK_B57861S_Onboard_or_Remote_P2.54mm; MPN B57861S0103F040
U10: LM393XK; SOIC-8_3.9x4.9mm_P1.27mm; MPN LM393XK
U11: LM285Z-2.5G; TO-92_Inline; MPN LM285Z-2.5G

Connections:
/7. Thermal/CHG_G_ENABLE: Q5.1, R66.2, R67.1
/7. Thermal/CHG_HYST_MID: R62.2, R70.1
/7. Thermal/CHG_PULLDOWN: Q5.3, R68.2
/7. Thermal/CHG_TSENSE: C61.1, R59.2, TH1.1, U10.2, U10.5
/7. Thermal/CHG_VREF: R57.2, R59.1, R60.1, R63.1, R64.1, U11.2
/7. Thermal/CHG_VSHORT: R64.2, R65.1, U10.6
/7. Thermal/CHG_VTH: R61.1, R69.2, R70.2, U10.3
/7. Thermal/CHG_VTH_UP: R60.2, R69.1
/7. Thermal/CHG_WARM: C62.1, R62.1, R63.2, R66.1, U10.1, U10.7
CHG_CS_M: Q4.3, Q6.3, Q7.3; also elsewhere on the board
CHG_G_SHUNT: Q4.1, Q6.1, Q7.1, R58.2, R68.1
CS_P: Q4.2, Q6.2, Q7.2, R58.1; also elsewhere on the board
GND: C60.2, C61.2, C62.2, Q5.2, R61.2, R65.2, R67.2, TH1.2, U10.4, U11.3; also elsewhere on the board
SOLAR: C60.1, R57.1, U10.8; also elsewhere on the board

Notes on the sheet:
R60 + R69 = 130k; R62 + R70 = 1,15M. Номинальные пороги: холод −17,4 °C; тепло −14,5 °C. OUT A и OUT B — соединённые открытые коллекторы. CHG_WARM высокий: Q5 включён, R56 обойдён. CHG_WARM низкий: Q5 выключен, R58 закрывает Q4/Q6/Q7.
Q4 / Q6 / Q7: S = до R56; D = после R56. R58 закрывает ключи при выключенном управлении.
SOT-23
RC0805FR-0730KL
Na-ion с опцией: установить весь узел, R56 = 1,8 Ом. LTO / без опции: R56 = 0 Ом, остальные 24 позиции не ставить. Основной R1 = 0,28 Ом остаётся во всех вариантах. Холод ≈ 96 мА; тепло ≈ 665 мА (зависит от RDS(on)).
CC0805JRNPO0BN102
0805
NTC ø2.41 / P2.54
07. Снижение тока на холоде / Na-ion / опция
RC0805FR-07100KL
RC0805FR-071KL
RC0805FR-071ML
AO3401A
TH1: B57861S0103F040; 10k, B25/100 = 3988 K, R/T 8016. Один NTC: на плате либо на проводах у аккумулятора. На плате измеряется температура под экраном. Обрыв или КЗ NTC → холодный ток.
LM393XK
RC0805FR-0710KL
BSS138
-t°
RC0805FR-07150KL
S4.22 / 2026-10-24 / инженерный прототип
RC0805FR-071M2L
B57861S0103F040
RC0805FR-0747KL
SOIC-8 / 3.9 mm
TO-92 / шаг 1.27 mm
CC0805KKX7R0BB104
LM285Z-2.5G

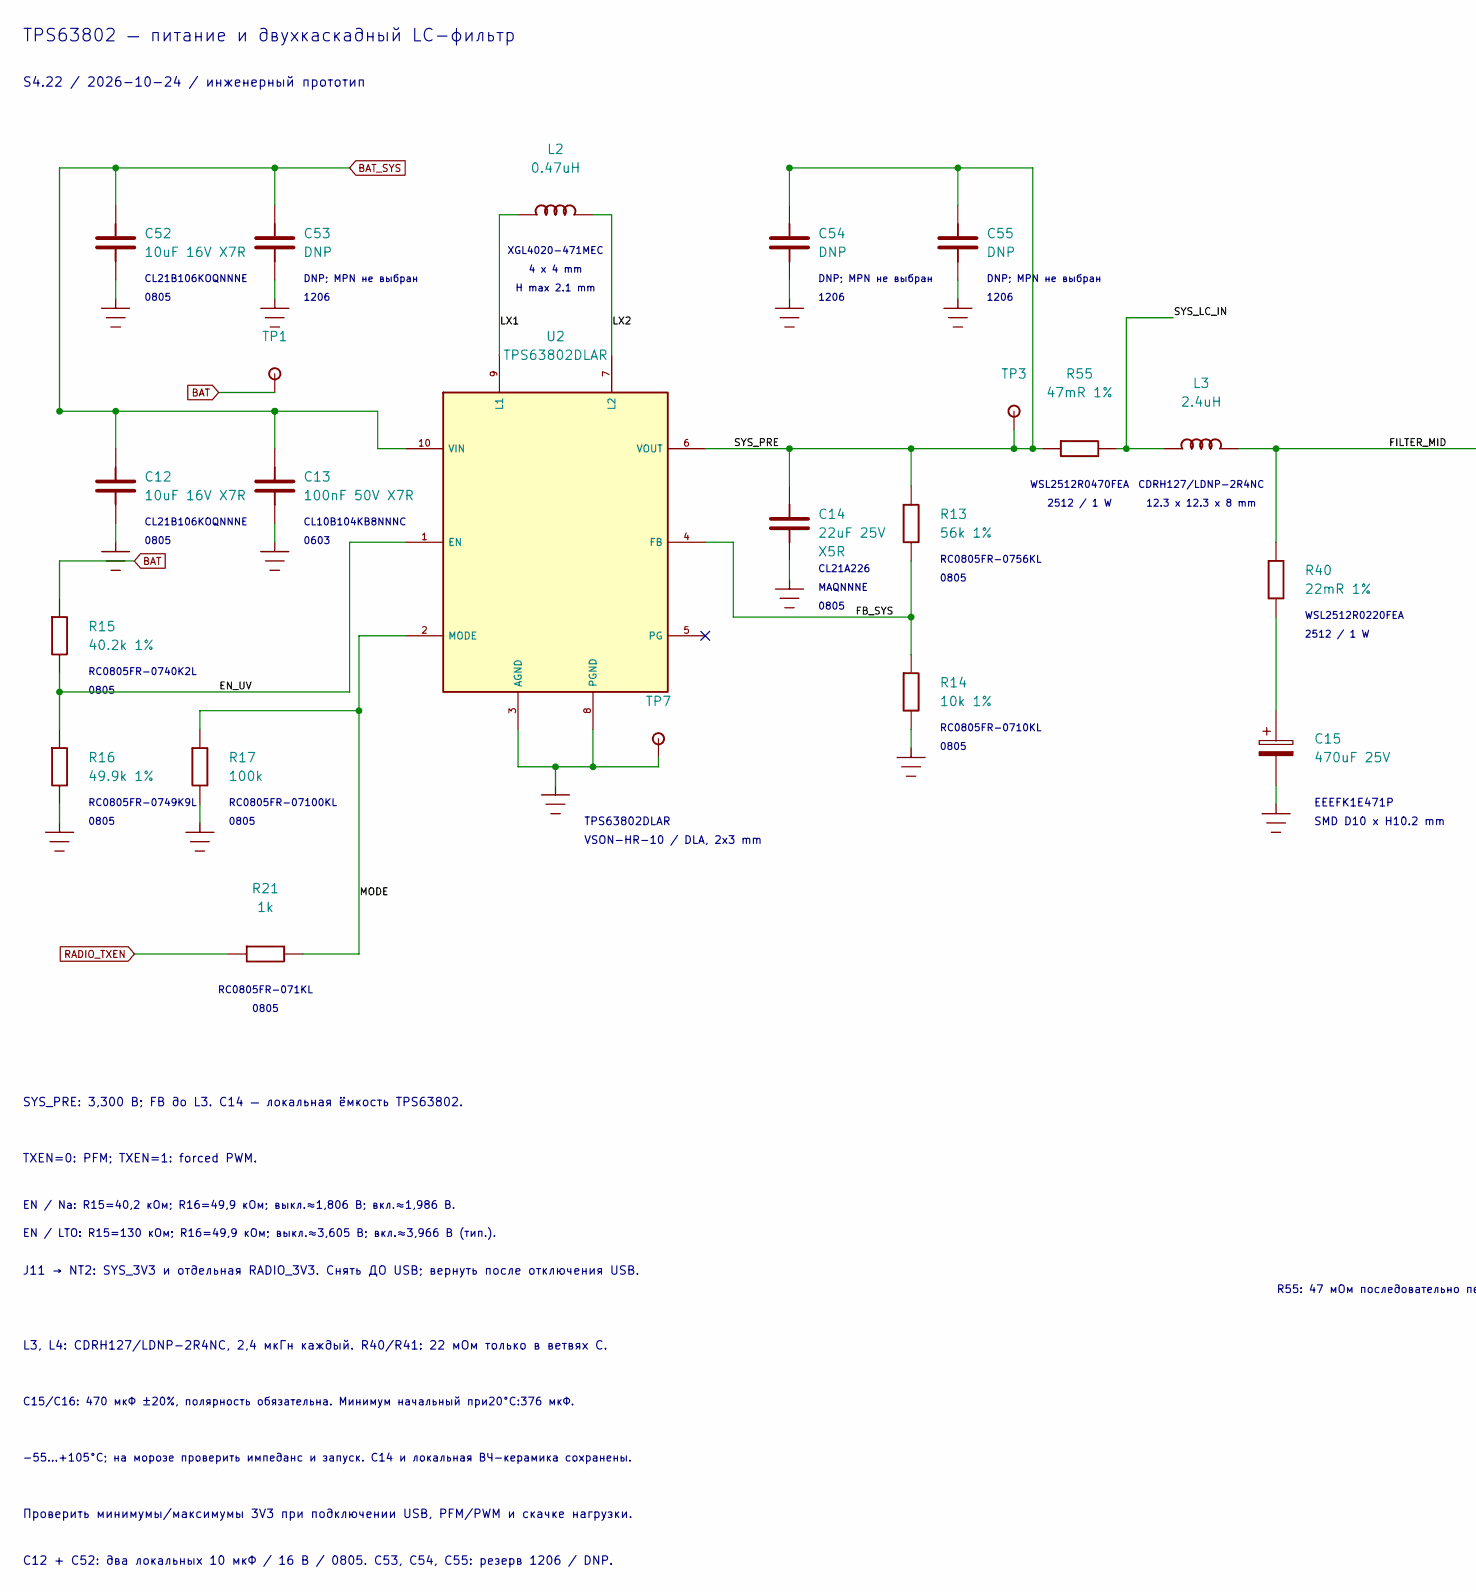
[picture p58: schematic Converter.kicad_sch, TPS63802 / питание и фильтр, part in row 1, column 1]

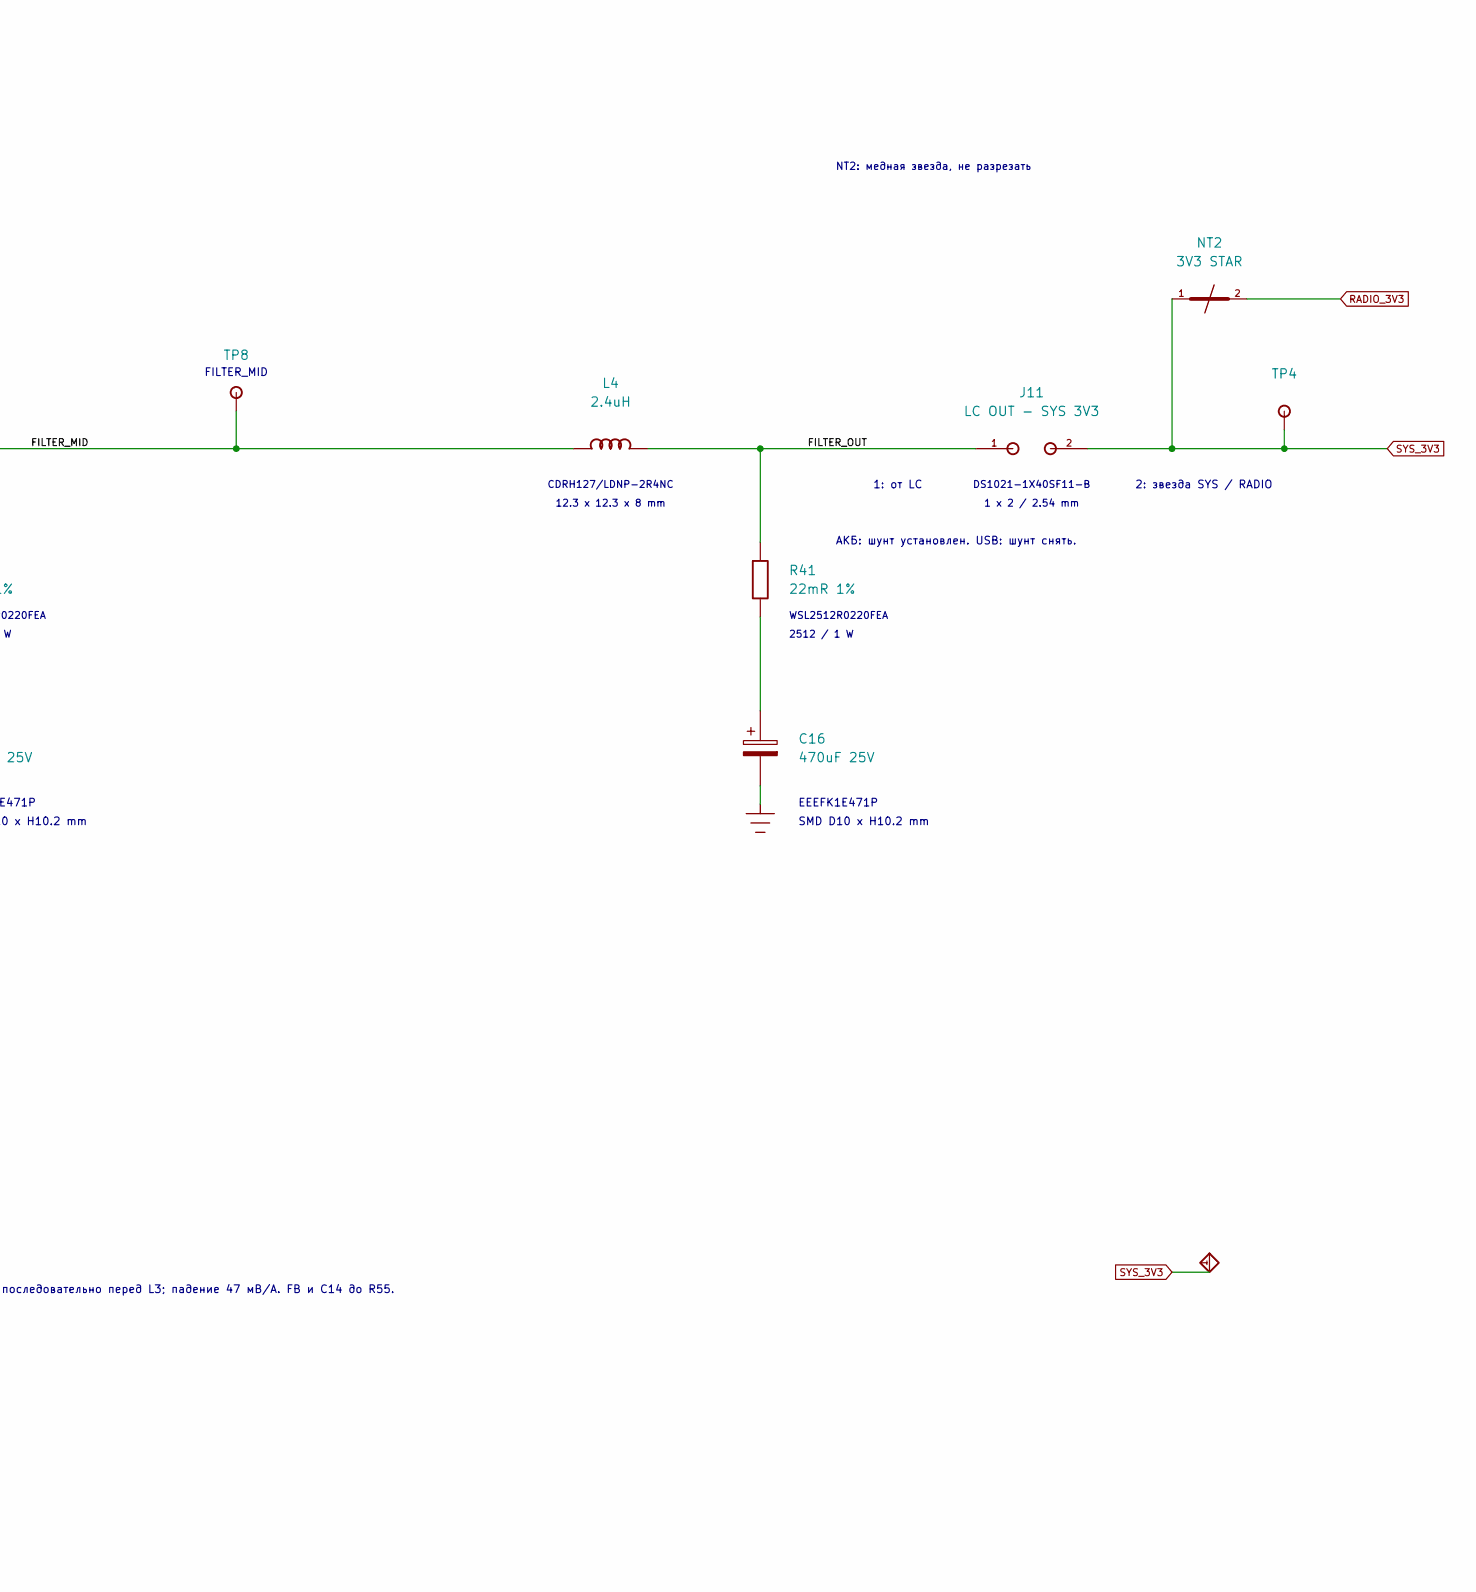
[picture p59: schematic Converter.kicad_sch, TPS63802 / питание и фильтр, part in row 1, column 2]

Parts:
C12, C52: 10uF 16V X7R; C_0805_2012Metric; MPN CL21B106KOQNNNE
C13: 100nF 50V X7R; C_0805_2012Metric; MPN CL21B104KBCNNNC
C14: 22uF 25V X5R; C_0805_2012Metric; MPN CL21A226MAQNNNE
C15, C16: 470uF 25V; CP_Elec_10x10.2; MPN EEEFK1E471P
C53, C54, C55: DNP; C_1206_3216Metric
J11: LC OUT - SYS 3V3; PinHeader_1x02_P2.54mm_Vertical; MPN DS1021-1X40SF11-B
L2: 0.47uH; L_Coilcraft_XGL4020_471MEC_HandSolderUniversal; MPN XGL4020-471MEC; LCSC C5837785
L3, L4: 2.4uH; L_Sumida_CDRH127_LD; MPN CDRH127/LDNP-2R4NC
NT2: 3V3 STAR; NetTie_2_SMD_Power_Star_A3
R13: 56k 1%; R_0805_2012Metric; MPN RC0805FR-0756KL; LCSC C2523584
R14: 10k 1%; R_0805_2012Metric; MPN RC0805FR-0710KL
R15: 40.2k 1%; R_0805_2012Metric; MPN RC0805FR-0740K2L; LCSC C865475
R16: 49.9k 1%; R_0805_2012Metric; MPN RC0805FR-0749K9L; LCSC C469661
R17: 100k; R_0805_2012Metric; MPN RC0805FR-07100KL
R21: 1k; R_0805_2012Metric; MPN RC0805FR-071KL
R40: 22mR 1%; R_Vishay_WSL2512_A3__A3_R40; MPN WSL2512R0220FEA
R41: 22mR 1%; R_Vishay_WSL2512_A3__A3_R41; MPN WSL2512R0220FEA
R55: 47mR 1%; R_Vishay_WSL2512_A3__A3_R55; MPN WSL2512R0470FEA
TP1: BAT; TestPoint_Pad_D1.5mm
TP3: SYS_PRE; TestPoint_Pad_D1.5mm
TP4: SYS_3V3; TestPoint_Pad_D1.5mm
TP7: GND; TestPoint_Pad_D1.5mm
TP8: FILTER_MID; TestPoint_Pad_D1.5mm; MPN PCB test pad / not purchased
U2: TPS63802DLAR; TPS63802_DLA0010A; MPN TPS63802DLAR; LCSC C2845237

Connections:
/2. Converter/EN_UV: R15.2, R16.1, U2.1 (EN)
/2. Converter/FB_SYS: R13.2, R14.1, U2.4 (FB)
/2. Converter/FILTER_MID: L3.2, L4.1, R40.1, TP8.1
/2. Converter/FILTER_OUT: J11.1, L4.2, R41.1
/2. Converter/LX1: L2.1, U2.9 (L1)
/2. Converter/LX2: L2.2, U2.7 (L2)
/2. Converter/MODE: R17.1, R21.2, U2.2 (MODE)
/2. Converter/SYS_LC_IN: L3.1, R55.2
/2. Converter/SYS_PRE: C14.1, C54.1, C55.1, R13.1, R55.1, TP3.1, U2.6 (VOUT)
BAT: R15.1, TP1.1; also elsewhere on the board
BAT_SYS: C12.1, C13.1, C52.1, C53.1, U2.10 (VIN); also elsewhere on the board
GND: C12.2, C13.2, C14.2, C15.2, C16.2, C52.2, C53.2, C54.2, C55.2, R14.2, R16.2, R17.2, TP7.1, U2.3 (AGND), U2.8 (PGND); also elsewhere on the board
unnamed: C15.1, R40.2
unnamed: C16.1, R41.2
RADIO_3V3: NT2.2; also elsewhere on the board
RADIO_TXEN: R21.1; also elsewhere on the board
SYS_3V3: J11.2, NT2.1, TP4.1; also elsewhere on the board

Notes on the sheet:
EN / Na: R15=40,2 кОм; R16=49,9 кОм; выкл.≈1,806 В; вкл.≈1,986 В.
CDRH127/LDNP-2R4NC
0805
TXEN=0: PFM; TXEN=1: forced PWM.
TPS63802 — питание и двухкаскадный LC-фильтр
CL10B104KB8NNNC
WSL2512R0470FEA
1206
WSL2512R0220FEA
RC0805FR-07100KL
Проверить минимумы/максимумы 3V3 при подключении USB, PFM/PWM и скачке нагрузки.
DNP; MPN не выбран
MAQNNNE
АКБ: шунт установлен. USB: шунт снять.
CL21B106KOQNNNE
RC0805FR-071KL
TPS63802DLAR
1: от LC
4 x 4 mm
0603
C12 + C52: два локальных 10 мкФ / 16 В / 0805. C53, C54, C55: резерв 1206 / DNP.
1 x 2 / 2.54 mm
2: звезда SYS / RADIO
EN / LTO: R15=130 кОм; R16=49,9 кОм; выкл.≈3,605 В; вкл.≈3,966 В (тип.).
RC0805FR-0749K9L
12.3 x 12.3 x 8 mm
RC0805FR-0756KL
2512 / 1 W
J11 → NT2: SYS_3V3 и отдельная RADIO_3V3. Снять ДО USB; вернуть после отключения USB.
H max 2.1 mm
RC0805FR-0710KL
CL21A226
DS1021-1X40SF11-B
RC0805FR-0740K2L
NT2: медная звезда, не разрезать
SYS_PRE: 3,300 В; FB до L3. C14 — локальная ёмкость TPS63802.
XGL4020-471MEC
L3, L4: CDRH127/LDNP-2R4NC, 2,4 мкГн каждый. R40/R41: 22 мОм только в ветвях C.
FILTER_MID
VSON-HR-10 / DLA, 2x3 mm
R55: 47 мОм последовательно перед L3; падение 47 мВ/А. FB и C14 до R55.
S4.22 / 2026-10-24 / инженерный прототип
EEEFK1E471P
SMD D10 x H10.2 mm
C15/C16: 470 мкФ ±20%, полярность обязательна. Минимум начальный при20°C:376 мкФ.
−55…+105°C; на морозе проверить импеданс и запуск. C14 и локальная ВЧ-керамика сохранены.
