Alksndr55/mesh-repeater/v1/design/Meshcore_NaIon/Meshcore_NaIon.kicad_pcb

## KiCad design v1/design/Meshcore_NaIon/Meshcore_NaIon.kicad_pcb (continued)

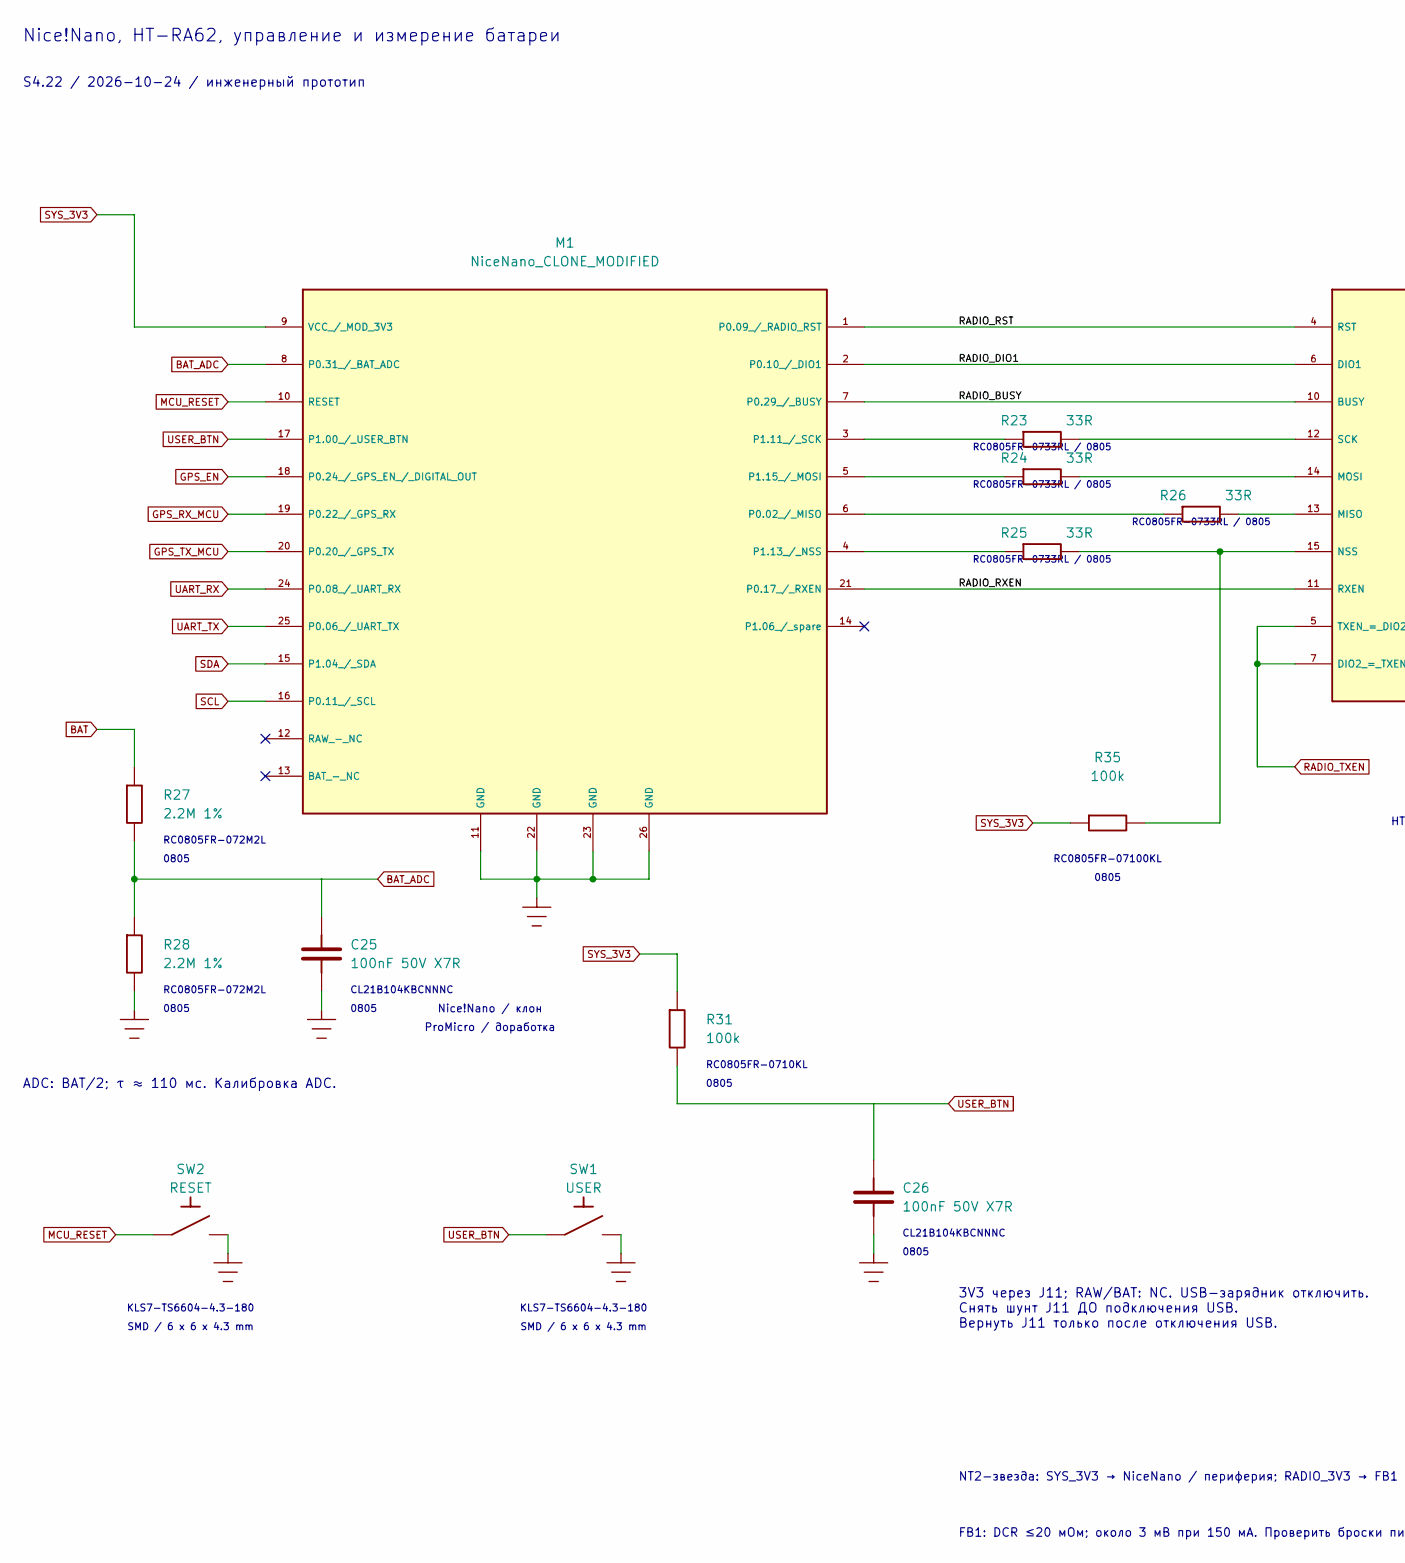
[picture p60: schematic Modules.kicad_sch, Nice!Nano / HT-RA62, part in row 1, column 1]

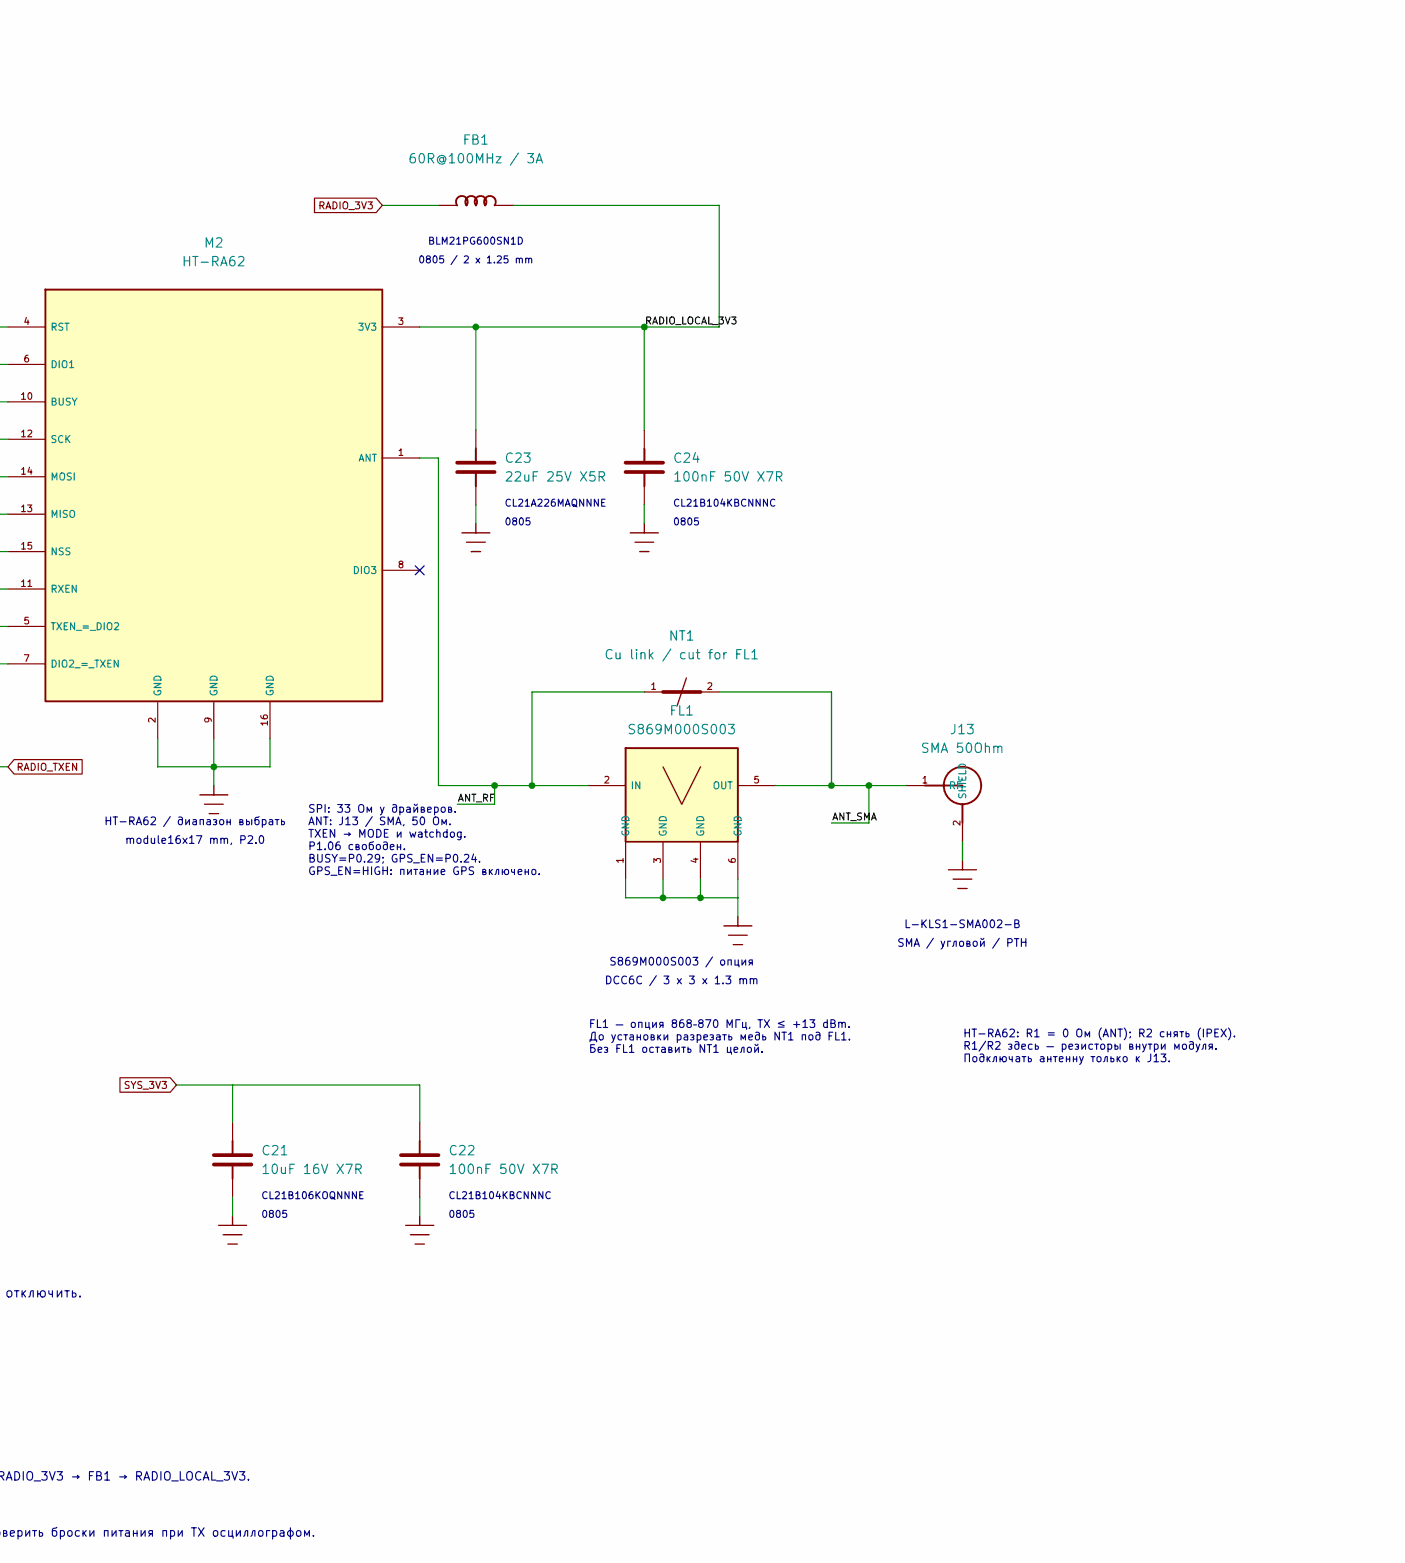
[picture p61: schematic Modules.kicad_sch, Nice!Nano / HT-RA62, part in row 1, column 2]

Parts:
C21: 10uF 16V X7R; C_0805_2012Metric; MPN CL21B106KOQNNNE
C22, C24, C25, C26: 100nF 50V X7R; C_0805_2012Metric; MPN CL21B104KBCNNNC
C23: 22uF 25V X5R; C_0805_2012Metric; MPN CL21A226MAQNNNE
FB1: 60R@100MHz / 3A; Ferrite_Murata_BLM21PG; MPN BLM21PG600SN1D
FL1: S869M000S003; SAW_AEL_DCC6C_S869M000S003; MPN S869M000S003
J13: SMA 50Ohm; SMA_KLS1_SMA002_B_Horizontal; MPN L-KLS1-SMA002-B
M1: NiceNano_CLONE_MODIFIED; NiceNano_13x2_Socket; MPN User supplied NiceNano clone
M2: HT-RA62; HT_RA62; MPN HT-RA62 band variant TBD
NT1: Cu link / cut for FL1; RF_Cut_Link_0p6; MPN PCB copper / not purchased
R23, R24, R25, R26: 33R; R_0805_2012Metric; MPN RC0805FR-0733RL
R27, R28: 2.2M 1%; R_0805_2012Metric; MPN RC0805FR-072M2L
R31, R35: 100k; R_0805_2012Metric; MPN RC0805FR-07100KL
SW1: USER; SW_Push_KLS7_TS6604_4_3_180; MPN KLS7-TS6604-4.3-180
SW2: RESET; SW_Push_KLS7_TS6604_4_3_180; MPN KLS7-TS6604-4.3-180

Connections:
/3. Modules/ANT_RF: FL1.2 (IN), M2.1 (ANT), NT1.1 (A)
/3. Modules/ANT_SMA: FL1.5 (OUT), J13.1 (SIGNAL), NT1.2 (B)
/3. Modules/RADIO_BUSY: M1.7 (P0.29_/_BUSY), M2.10 (BUSY_10)
/3. Modules/RADIO_DIO1: M1.2 (P0.10_/_DIO1), M2.6 (DIO1_6)
/3. Modules/RADIO_LOCAL_3V3: C23.1, C24.1, FB1.2, M2.3 (3V3_3)
/3. Modules/RADIO_RST: M1.1 (P0.09_/_RADIO_RST), M2.4 (RST_4)
/3. Modules/RADIO_RXEN: M1.21 (P0.17_/_RXEN), M2.11 (RXEN_11)
BAT: R27.1; also elsewhere on the board
BAT_ADC: C25.1, M1.8 (P0.31_/_BAT_ADC), R27.2, R28.1
GND: C21.2, C22.2, C23.2, C24.2, C25.2, C26.2, FL1.1 (GND), FL1.3 (GND), FL1.4 (GND), FL1.6 (GND), J13.2 (GND), M1.11 (GND), M1.22 (GND), M1.23 (GND), M1.26 (GND), M2.2 (GND_2), M2.9 (GND_9), M2.16 (GND_16), R28.2, SW1.2, SW2.2; also elsewhere on the board
GPS_EN: M1.18 (P0.24_/_GPS_EN_/_DIGITAL_OUT); also elsewhere on the board
GPS_RX_MCU: M1.19 (P0.22_/_GPS_RX); also elsewhere on the board
GPS_TX_MCU: M1.20 (P0.20_/_GPS_TX); also elsewhere on the board
MCU_RESET: M1.10 (RESET), SW2.1; also elsewhere on the board
unnamed: M1.6 (P0.02_/_MISO), R26.2
unnamed: M1.3 (P1.11_/_SCK), R23.1
unnamed: M1.4 (P1.13_/_NSS), R25.1
unnamed: M1.5 (P1.15_/_MOSI), R24.1
unnamed: M2.13 (MISO_13), R26.1
unnamed: M2.14 (MOSI_14), R24.2
unnamed: M2.15 (NSS_15), R25.2, R35.2
unnamed: M2.12 (SCK_12), R23.2
RADIO_3V3: FB1.1; also elsewhere on the board
RADIO_TXEN: M2.5 (TXEN_=_DIO2_5), M2.7 (DIO2_=_TXEN_7); also elsewhere on the board
SCL: M1.16 (P0.11_/_SCL); also elsewhere on the board
SDA: M1.15 (P1.04_/_SDA); also elsewhere on the board
SYS_3V3: C21.1, C22.1, M1.9 (VCC_/_MOD_3V3), R31.1, R35.1; also elsewhere on the board
UART_RX: M1.24 (P0.08_/_UART_RX); also elsewhere on the board
UART_TX: M1.25 (P0.06_/_UART_TX); also elsewhere on the board
USER_BTN: C26.1, M1.17 (P1.00_/_USER_BTN), R31.2, SW1.1

Notes on the sheet:
FB1: DCR ≤20 мОм; около 3 мВ при 150 мА. Проверить броски питания при TX осциллографом.
HT-RA62: R1 = 0 Ом (ANT); R2 снять (IPEX). R1/R2 здесь — резисторы внутри модуля. Подключать антенну только к J13.
SMA / угловой / PTH
FL1 — опция 868–870 МГц, TX ≤ +13 dBm. До установки разрезать медь NT1 под FL1. Без FL1 оставить NT1 целой.
KLS7-TS6604-4.3-180
BLM21PG600SN1D
0805
RC0805FR-0733RL / 0805
SMD / 6 x 6 x 4.3 mm
module16x17 mm, P2.0
S869M000S003 / опция
CL21B104KBCNNNC
CL21B106KOQNNNE
SPI: 33 Ом у драйверов. ANT: J13 / SMA, 50 Ом. TXEN → MODE и watchdog. P1.06 свободен. BUSY=P0.29; GPS_EN=P0.24. GPS_EN=HIGH: питание GPS включено.
DCC6C / 3 x 3 x 1.3 mm
3V3 через J11; RAW/BAT: NC. USB-зарядник отключить. Снять шунт J11 ДО подключения USB. Вернуть J11 только после отключения USB.
L-KLS1-SMA002-B
ADC: BAT/2; τ ≈ 110 мс. Калибровка ADC.
Nice!Nano, HT-RA62, управление и измерение батареи
S4.22 / 2026-10-24 / инженерный прототип
CL21A226MAQNNNE
RC0805FR-072M2L
HT-RA62 / диапазон выбрать
NT2-звезда: SYS_3V3 → NiceNano / периферия; RADIO_3V3 → FB1 → RADIO_LOCAL_3V3.
RC0805FR-0710KL
Nice!Nano / клон
RC0805FR-07100KL
ProMicro / доработка
0805 / 2 x 1.25 mm

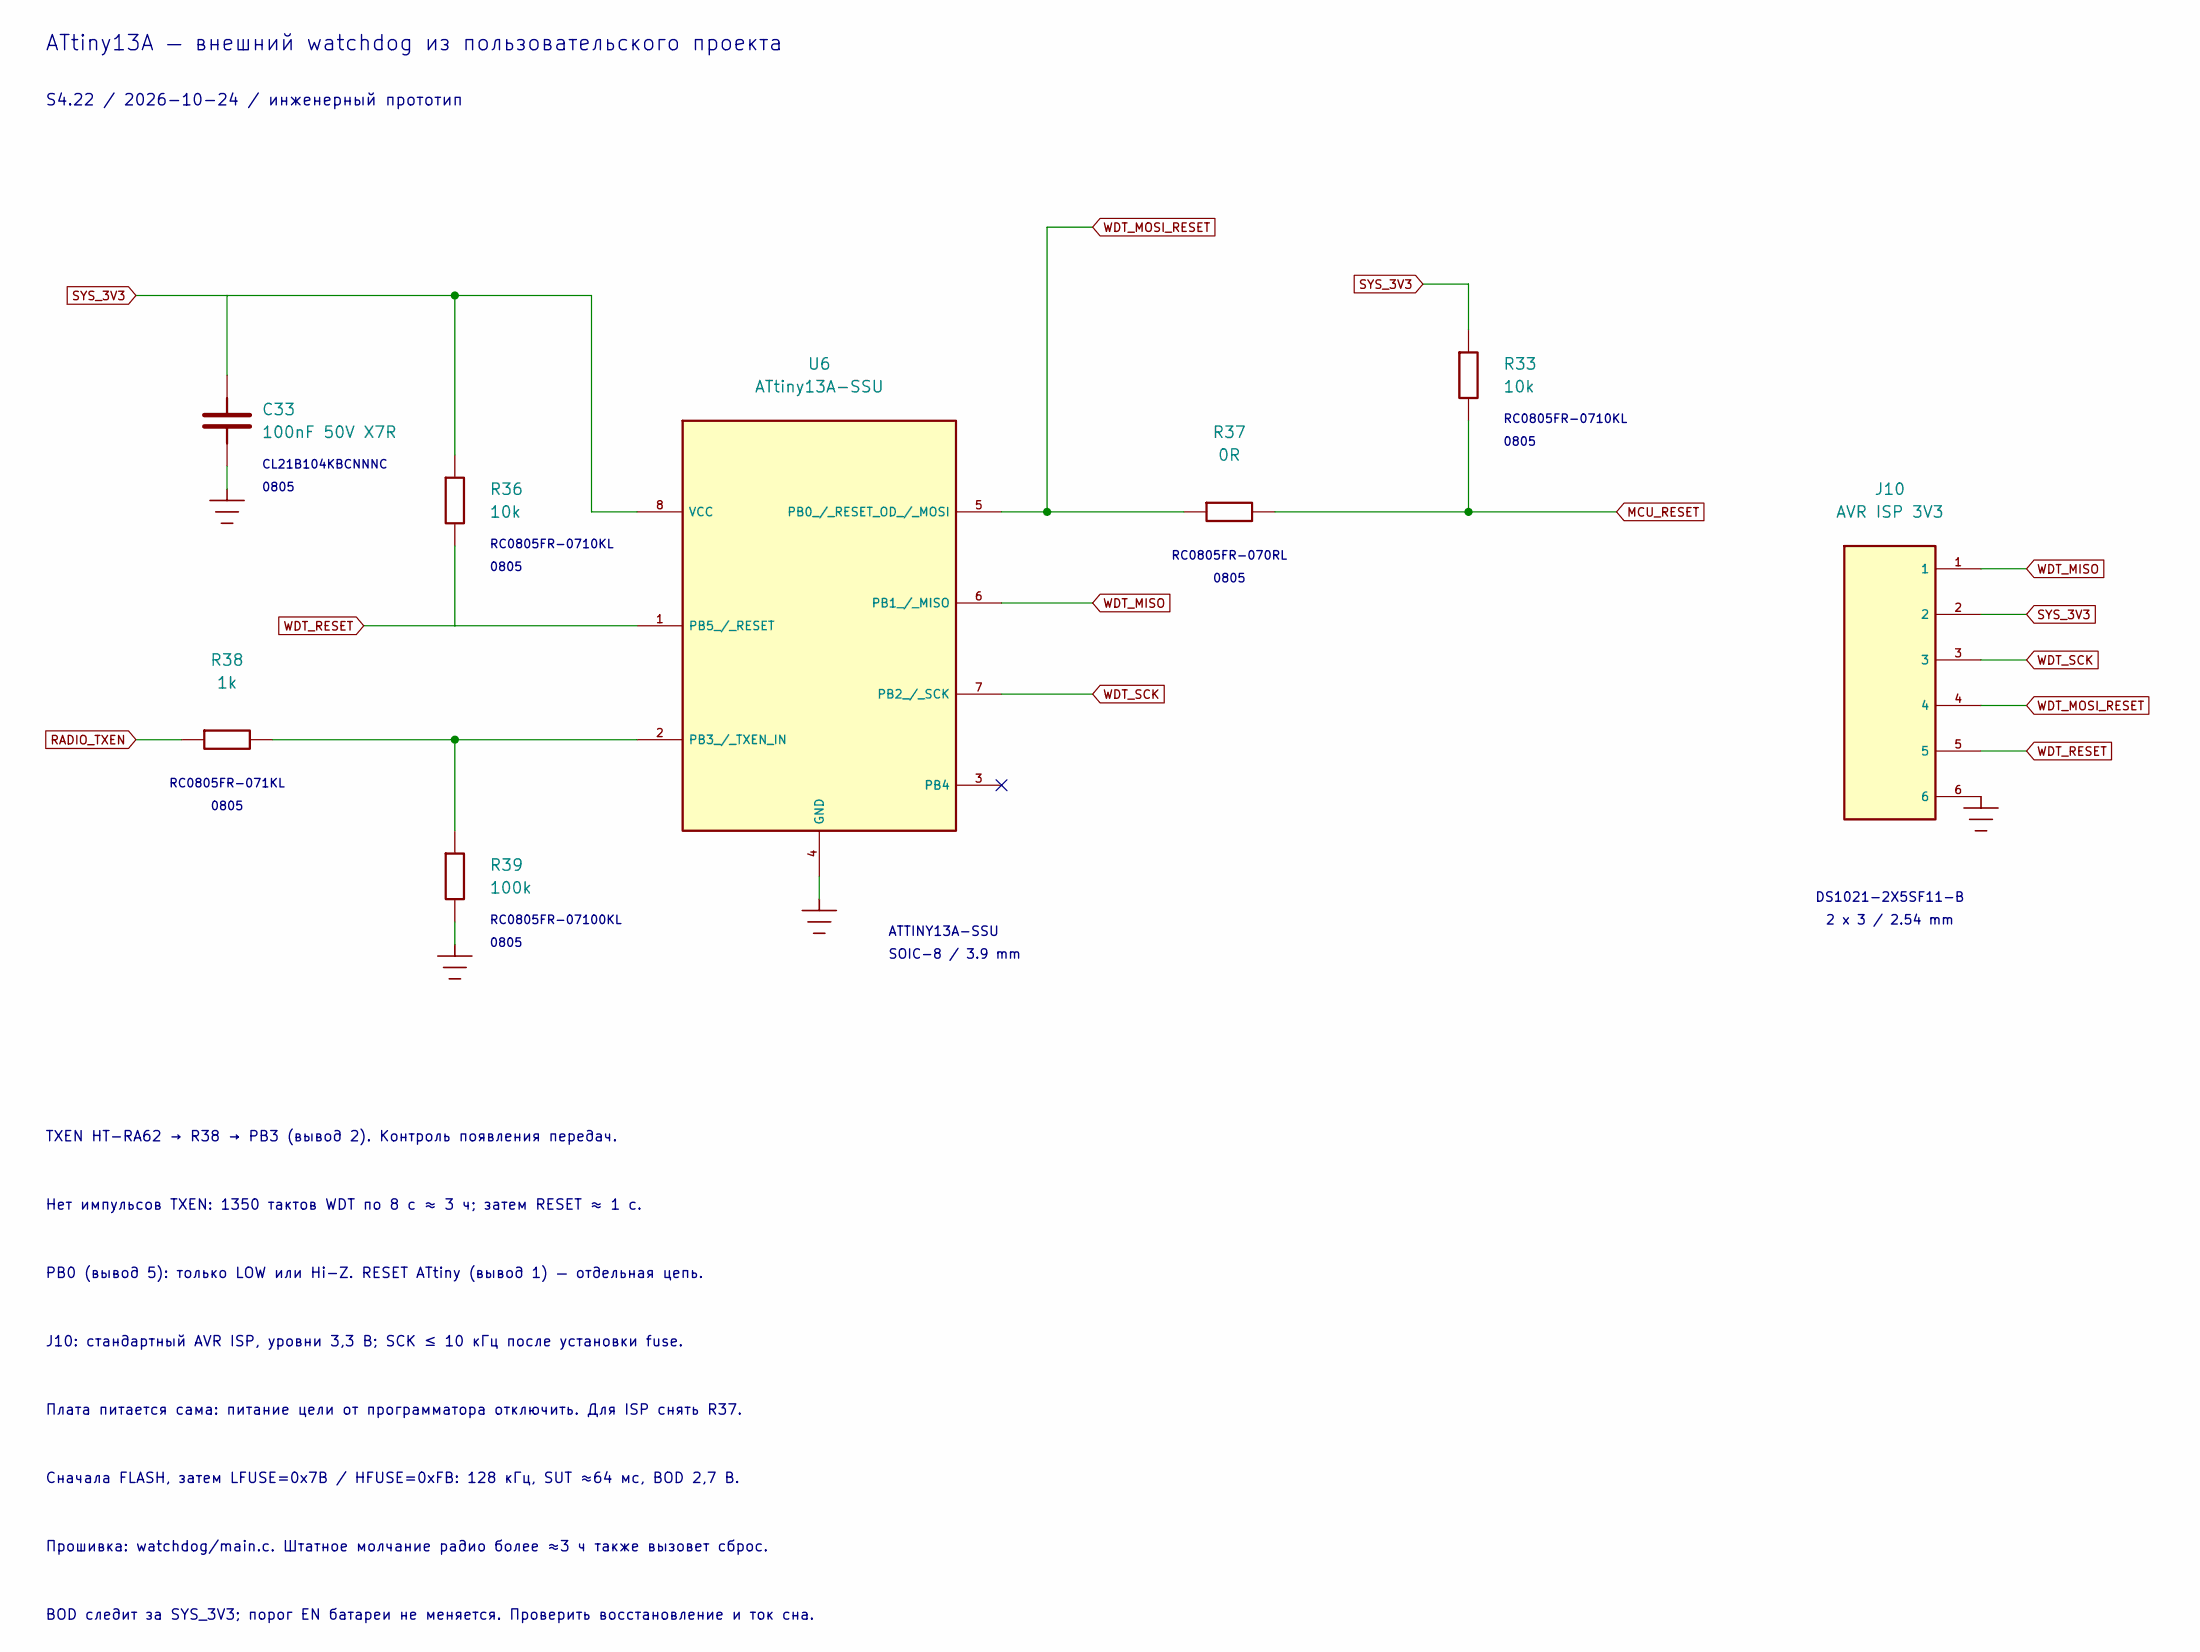
[picture p62: schematic Watchdog.kicad_sch, ATtiny13A / watchdog]

Parts:
C33: 100nF 50V X7R; C_0805_2012Metric; MPN CL21B104KBCNNNC
J10: AVR ISP 3V3; PinHeader_2x03_P2.54mm_Vertical; MPN DS1021-2X5SF11-B
R33, R36: 10k; R_0805_2012Metric; MPN RC0805FR-0710KL
R37: 0R; R_0805_2012Metric; MPN RC0805FR-070RL
R38: 1k; R_0805_2012Metric; MPN RC0805FR-071KL
R39: 100k; R_0805_2012Metric; MPN RC0805FR-07100KL
U6: ATtiny13A-SSU; SOIC-8_3.9x4.9mm_P1.27mm; MPN ATTINY13A-SSU

Connections:
GND: C33.2, J10.6, R39.2, U6.4 (GND); also elsewhere on the board
MCU_RESET: R33.2, R37.2; also elsewhere on the board
unnamed: R38.2, R39.1, U6.2 (PB3_/_TXEN_IN)
RADIO_TXEN: R38.1; also elsewhere on the board
SYS_3V3: C33.1, J10.2, R33.1, R36.1, U6.8 (VCC); also elsewhere on the board
WDT_MISO: J10.1, U6.6 (PB1_/_MISO)
WDT_MOSI_RESET: J10.4, R37.1, U6.5 (PB0_/_RESET_OD_/_MOSI)
WDT_RESET: J10.5, R36.2, U6.1 (PB5_/_RESET)
WDT_SCK: J10.3, U6.7 (PB2_/_SCK)

Notes on the sheet:
PB0 (вывод 5): только LOW или Hi-Z. RESET ATtiny (вывод 1) — отдельная цепь.
ATtiny13A — внешний watchdog из пользовательского проекта
0805
RC0805FR-07100KL
Плата питается сама: питание цели от программатора отключить. Для ISP снять R37.
RC0805FR-070RL
SOIC-8 / 3.9 mm
TXEN HT-RA62 → R38 → PB3 (вывод 2). Контроль появления передач.
ATTINY13A-SSU
J10: стандартный AVR ISP, уровни 3,3 В; SCK ≤ 10 кГц после установки fuse.
DS1021-2X5SF11-B
BOD следит за SYS_3V3; порог EN батареи не меняется. Проверить восстановление и ток сна.
CL21B104KBCNNNC
RC0805FR-071KL
RC0805FR-0710KL
Сначала FLASH, затем LFUSE=0x7B / HFUSE=0xFB: 128 кГц, SUT ≈64 мс, BOD 2,7 В.
S4.22 / 2026-10-24 / инженерный прототип
2 x 3 / 2.54 mm
Прошивка: watchdog/main.c. Штатное молчание радио более ≈3 ч также вызовет сброс.
Нет импульсов TXEN: 1350 тактов WDT по 8 с ≈ 3 ч; затем RESET ≈ 1 с.

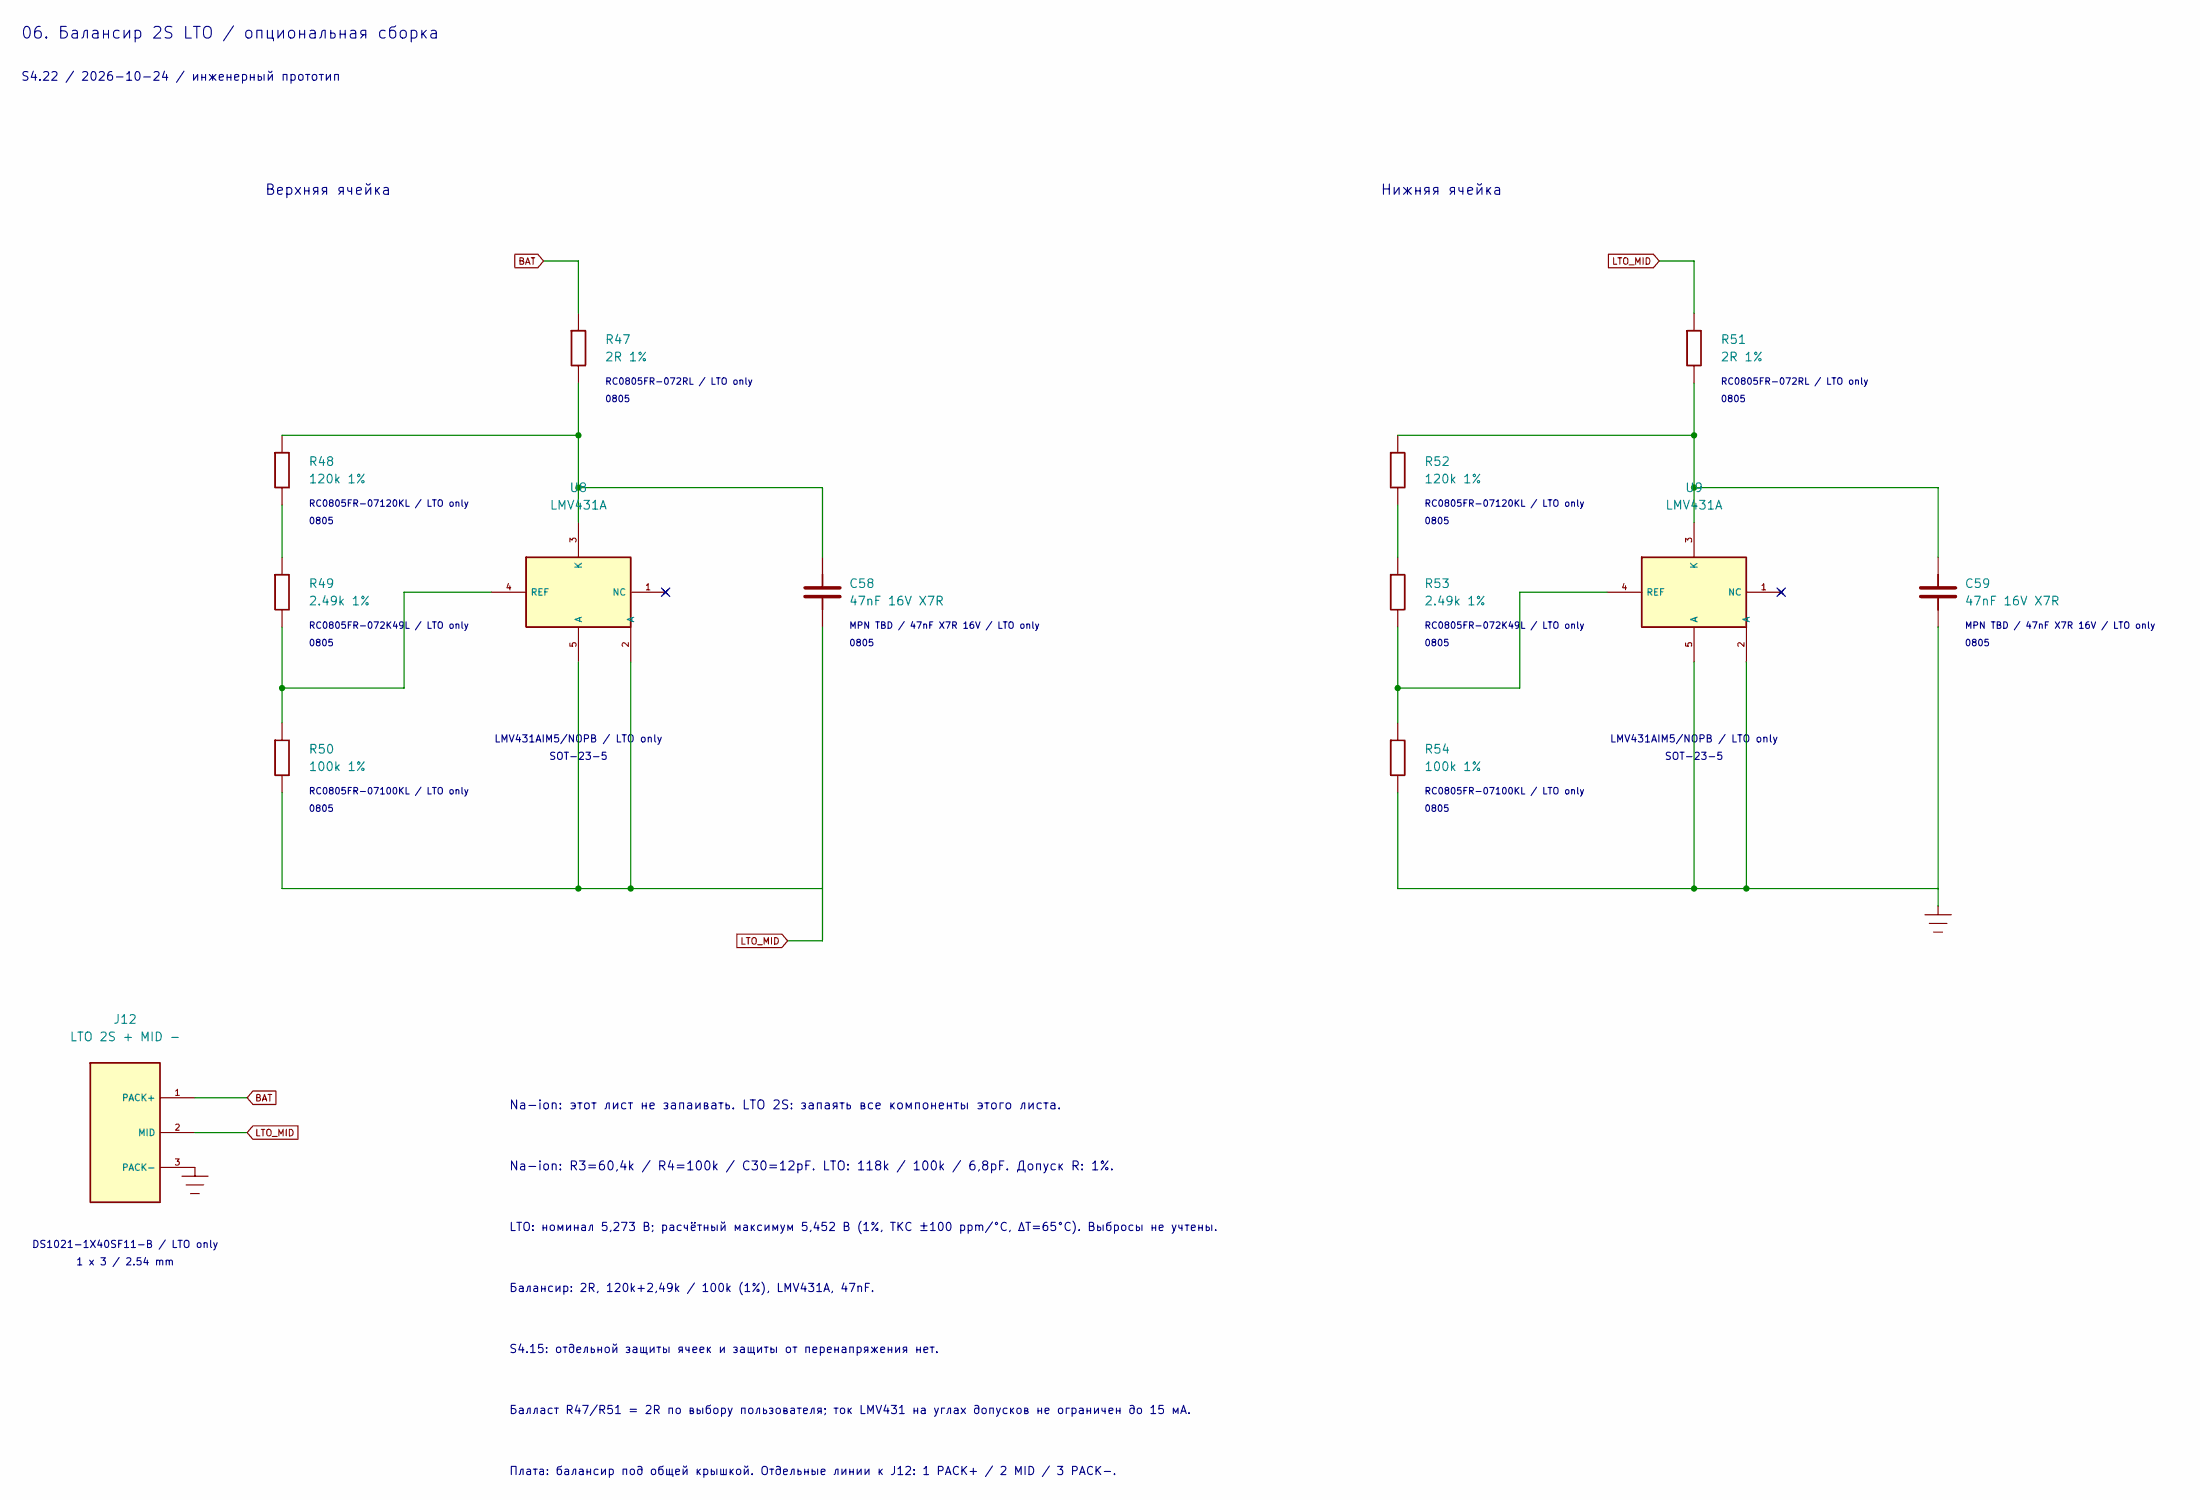
[picture p63: schematic LTO_Balancer.kicad_sch, LMV431A / LTO 2S опция]

Parts:
C58, C59: 47nF 16V X7R; C_0805_2012Metric; MPN MPN TBD / 47nF X7R 16V
J12: LTO 2S + MID -; PinHeader_1x03_P2.54mm_Vertical; MPN DS1021-1X40SF11-B
R47, R51: 2R 1%; R_0805_2012Metric; MPN RC0805FR-072RL; LCSC C110775
R48, R52: 120k 1%; R_0805_2012Metric; MPN RC0805FR-07120KL; LCSC C110775
R49, R53: 2.49k 1%; R_0805_2012Metric; MPN RC0805FR-072K49L; LCSC C110775
R50, R54: 100k 1%; R_0805_2012Metric; MPN RC0805FR-07100KL; LCSC C110775
U8, U9: LMV431A; SOT-23-5; MPN LMV431AIM5/NOPB

Connections:
BAT: J12.1 (PACK+), R47.1; also elsewhere on the board
GND: C59.2, J12.3 (PACK-), R54.2, U9.2 (A), U9.5 (A); also elsewhere on the board
LTO_MID: C58.2, J12.2 (MID), R50.2, R51.1, U8.2 (A), U8.5 (A)
unnamed: R48.2, R49.1
unnamed: R52.2, R53.1
unnamed: C58.1, R47.2, R48.1, U8.3 (K)
unnamed: R49.2, R50.1, U8.4 (REF)
unnamed: C59.1, R51.2, R52.1, U9.3 (K)
unnamed: R53.2, R54.1, U9.4 (REF)

Notes on the sheet:
0805
LMV431AIM5/NOPB / LTO only
MPN TBD / 47nF X7R 16V / LTO only
RC0805FR-07120KL / LTO only
RC0805FR-072K49L / LTO only
SOT-23-5
RC0805FR-07100KL / LTO only
1 x 3 / 2.54 mm
Верхняя ячейка
S4.15: отдельной защиты ячеек и защиты от перенапряжения нет.
S4.22 / 2026-10-24 / инженерный прототип
06. Балансир 2S LTO / опциональная сборка
Балансир: 2R, 120k+2,49k / 100k (1%), LMV431A, 47nF.
RC0805FR-072RL / LTO only
Плата: балансир под общей крышкой. Отдельные линии к J12: 1 PACK+ / 2 MID / 3 PACK-.
LTO: номинал 5,273 В; расчётный максимум 5,452 В (1%, ТКС ±100 ppm/°C, ΔT=65°C). Выбросы не учтены.
Нижняя ячейка
DS1021-1X40SF11-B / LTO only
Балласт R47/R51 = 2R по выбору пользователя; ток LMV431 на углах допусков не ограничен до 15 мА.
Na-ion: R3=60,4k / R4=100k / C30=12pF. LTO: 118k / 100k / 6,8pF. Допуск R: 1%.
Na-ion: этот лист не запаивать. LTO 2S: запаять все компоненты этого листа.

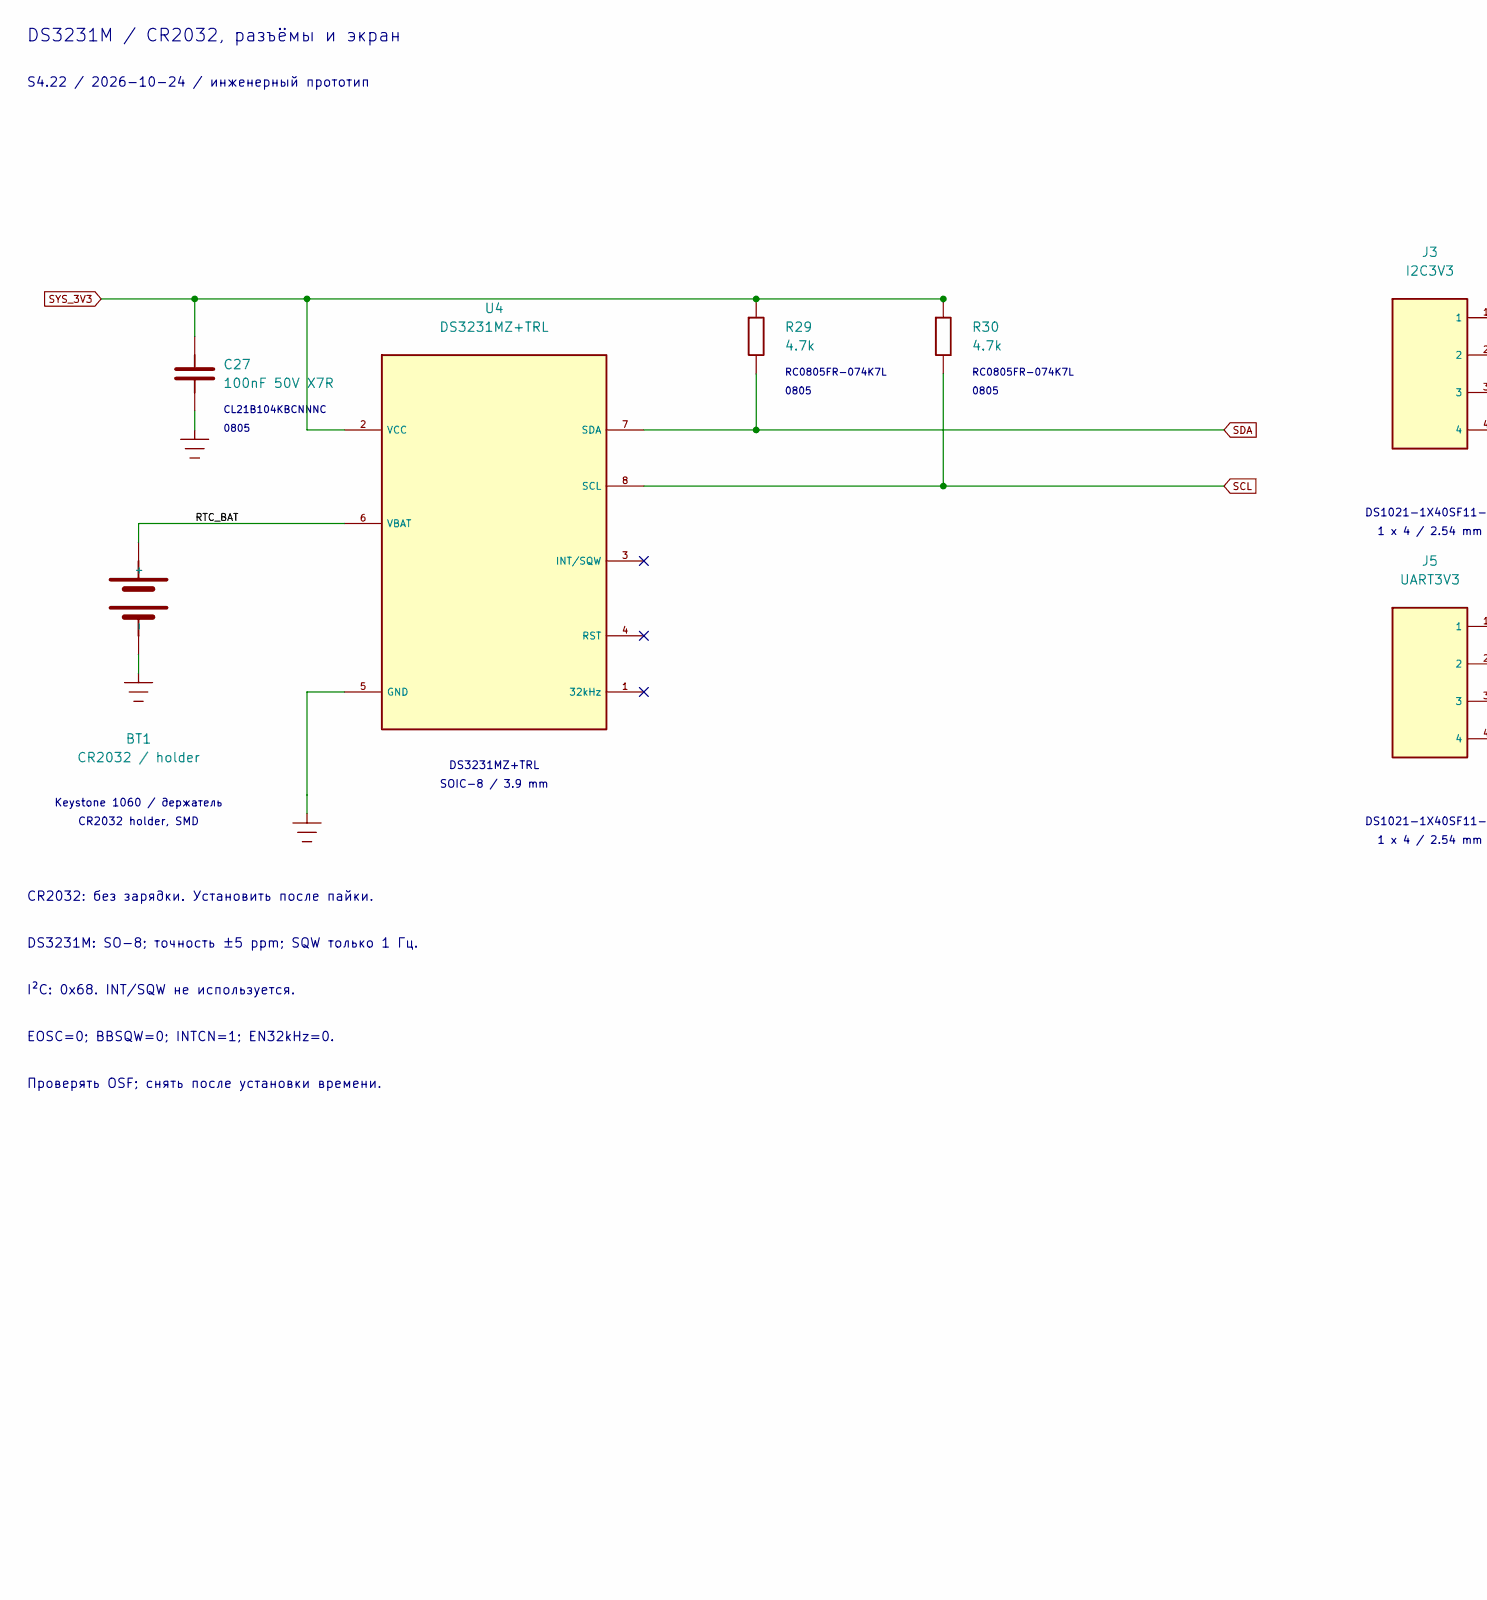
[picture p64: schematic RTC_IO.kicad_sch, DS3231M / разъёмы, part in row 1, column 1]

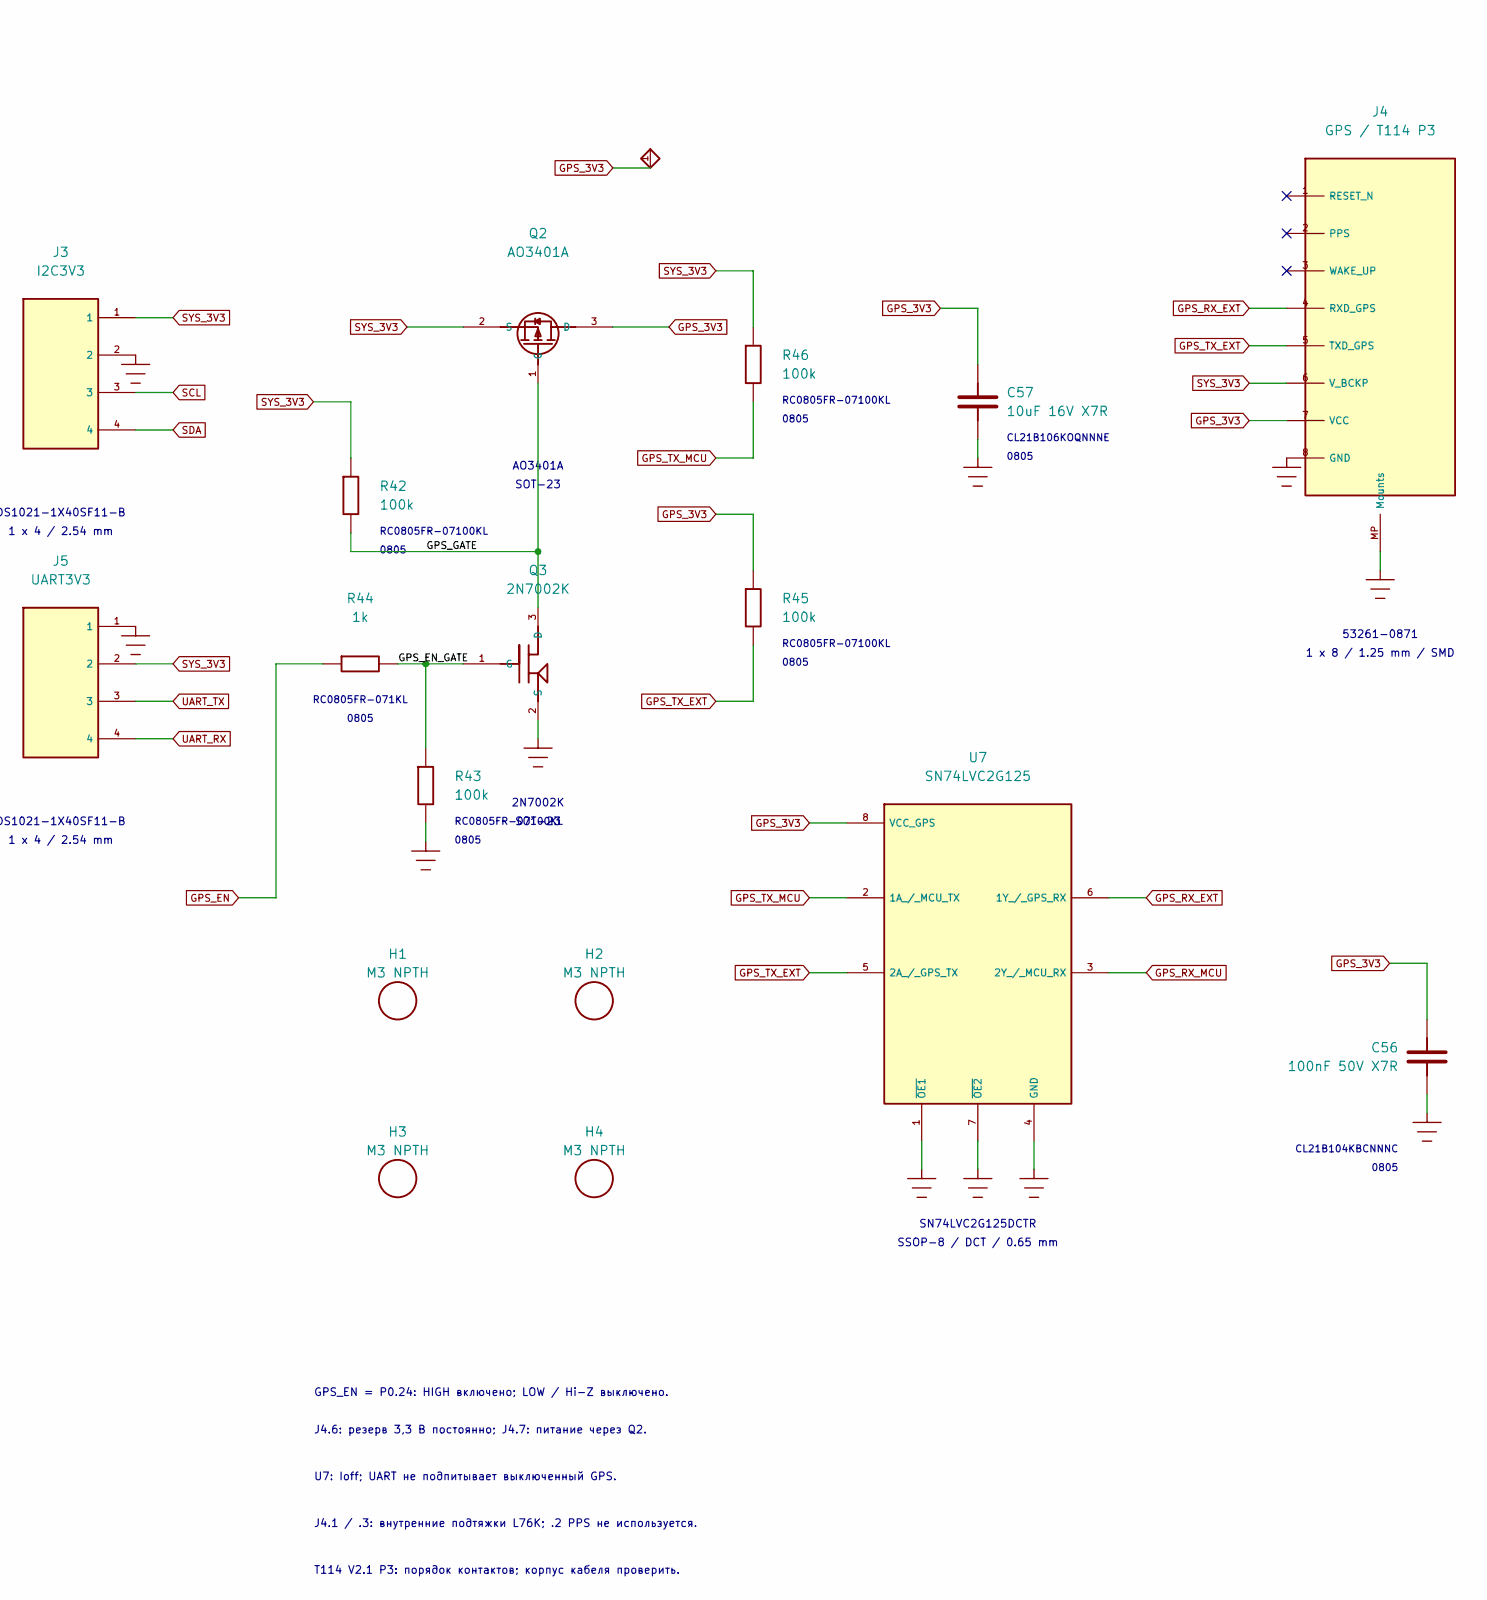
[picture p65: schematic RTC_IO.kicad_sch, DS3231M / разъёмы, part in row 1, column 2]

Parts:
BT1: CR2032 / holder; BatteryHolder_Keystone_1060_1x2032; MPN 1060; LCSC C5370859
C27, C56: 100nF 50V X7R; C_0805_2012Metric; MPN CL21B104KBCNNNC
C57: 10uF 16V X7R; C_0805_2012Metric; MPN CL21B106KOQNNNE
H1, H2, H3, H4: M3 NPTH; MountingHole_3.2mm_M3
J3: I2C3V3; PinHeader_1x04_P2.54mm_Vertical; MPN DS1021-1X40SF11-B
J4: GPS / T114 P3; Molex_PicoBlade_53261-0871_1x08-1MP_P1.25mm_Horizontal; MPN 53261-0871
J5: UART3V3; PinHeader_1x04_P2.54mm_Vertical; MPN DS1021-1X40SF11-B
Q2: AO3401A; SOT-23; MPN AO3401A
Q3: 2N7002K; SOT-23; MPN 2N7002K
R29, R30: 4.7k; R_0805_2012Metric; MPN RC0805FR-074K7L
R42, R43, R45, R46: 100k; R_0805_2012Metric; MPN RC0805FR-07100KL
R44: 1k; R_0805_2012Metric; MPN RC0805FR-071KL
U4: DS3231MZ+TRL; SOIC-8_3.9x4.9mm_P1.27mm; MPN DS3231MZ+TRL
U7: SN74LVC2G125; TI_DCT0008A; MPN SN74LVC2G125DCTR

Connections:
/4. RTC_IO/GPS_EN_GATE: Q3.1 (G), R43.1, R44.2
/4. RTC_IO/GPS_GATE: Q2.1 (G), Q3.3 (D), R42.2
/4. RTC_IO/RTC_BAT: BT1.1 (+), U4.6 (VBAT)
GND: BT1.2 (-), C27.2, C56.2, C57.2, J3.2, J4.8 (GND), J4.MP (Mounts), J5.1, Q3.2 (S), R43.2, U4.5 (GND), U7.1 (~OE1), U7.4 (GND), U7.7 (~OE2); also elsewhere on the board
GPS_3V3: C56.1, C57.1, J4.7 (VCC), Q2.3 (D), R45.1, U7.8 (VCC_GPS)
GPS_EN: R44.1; also elsewhere on the board
GPS_RX_EXT: J4.4 (RXD_GPS), U7.6 (1Y_/_GPS_RX)
GPS_RX_MCU: U7.3 (2Y_/_MCU_RX); also elsewhere on the board
GPS_TX_EXT: J4.5 (TXD_GPS), R45.2, U7.5 (2A_/_GPS_TX)
GPS_TX_MCU: R46.2, U7.2 (1A_/_MCU_TX); also elsewhere on the board
SCL: J3.3, R30.2, U4.8 (SCL); also elsewhere on the board
SDA: J3.4, R29.2, U4.7 (SDA); also elsewhere on the board
SYS_3V3: C27.1, J3.1, J4.6 (V_BCKP), J5.2, Q2.2 (S), R29.1, R30.1, R42.1, R46.1, U4.2 (VCC); also elsewhere on the board
UART_RX: J5.4; also elsewhere on the board
UART_TX: J5.3; also elsewhere on the board

Notes on the sheet:
Проверять OSF; снять после установки времени.
J4.6: резерв 3,3 В постоянно; J4.7: питание через Q2.
SOT-23
T114 V2.1 P3: порядок контактов; корпус кабеля проверить.
U7: Ioff; UART не подпитывает выключенный GPS.
AO3401A
0805
1 x 4 / 2.54 mm
CL21B104KBCNNNC
RC0805FR-07100KL
DS3231M / CR2032, разъёмы и экран
S4.22 / 2026-10-24 / инженерный прототип
CR2032: без зарядки. Установить после пайки.
RC0805FR-074K7L
J4.1 / .3: внутренние подтяжки L76K; .2 PPS не используется.
1 x 8 / 1.25 mm / SMD
Keystone 1060 / держатель
CR2032 holder, SMD
DS1021-1X40SF11-B
DS3231M: SO-8; точность ±5 ppm; SQW только 1 Гц.
SSOP-8 / DCT / 0.65 mm
SN74LVC2G125DCTR
EOSC=0; BBSQW=0; INTCN=1; EN32kHz=0.
53261-0871
GPS_EN = P0.24: HIGH включено; LOW / Hi-Z выключено.
RC0805FR-071KL
CL21B106KOQNNNE
2N7002K
I²C: 0x68. INT/SQW не используется.
DS3231MZ+TRL
SOIC-8 / 3.9 mm
