Alksndr55/mesh-repeater/shared/schematic/BatteryMonitor.kicad_sch

## KiCad design shared/schematic/BatteryMonitor.kicad_sch (2026-11-06)

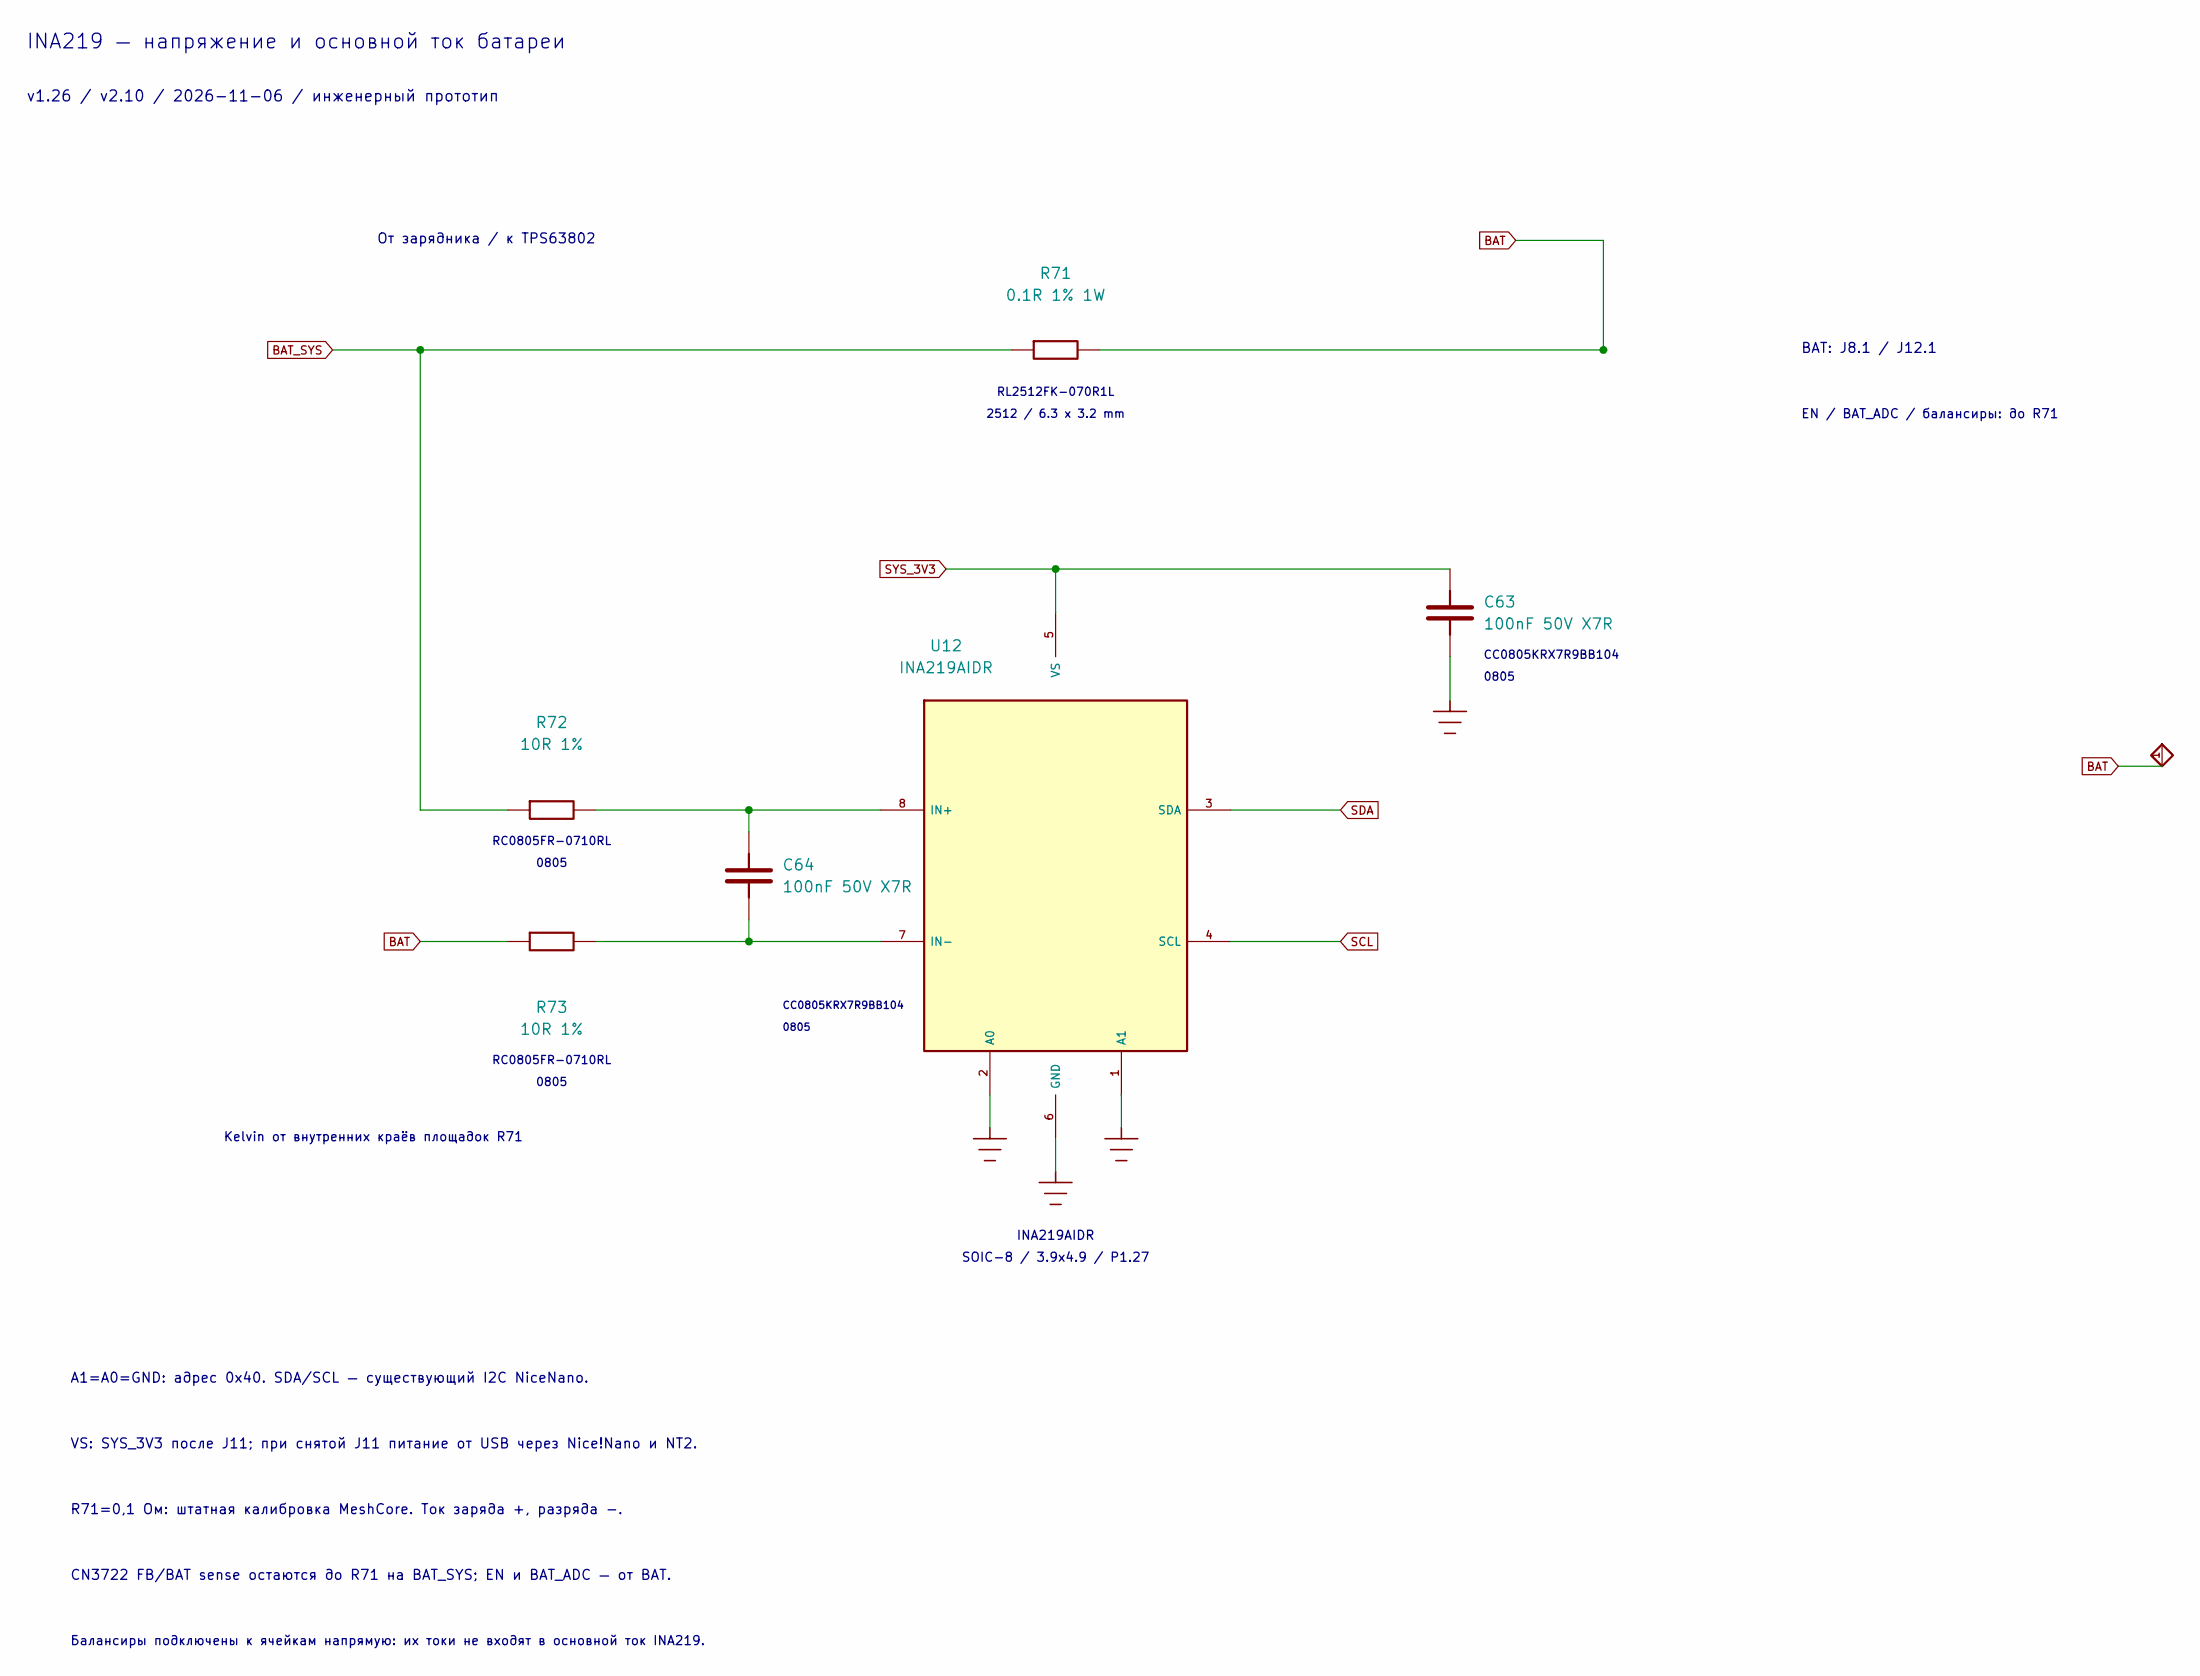
[picture p68: schematic BatteryMonitor.kicad_sch]

Parts:
C63, C64: 100nF 50V X7R; C_0805_2012Metric; MPN CC0805KRX7R9BB104
R71: 0.1R 1% 1W; R_2512_6332Metric__A3_R71; MPN RL2512FK-070R1L
R72, R73: 10R 1%; R_0805_2012Metric; MPN RC0805FR-0710RL
U12: INA219AIDR; SOIC-8_3.9x4.9mm_P1.27mm; MPN INA219AIDR

Connections:
BAT: R71.2, R73.1
BAT_SYS: R71.1, R72.1
GND: C63.2, U12.1 (A1), U12.2 (A0), U12.6 (GND)
unnamed: C64.1, R72.2, U12.8 (IN+)
unnamed: C64.2, R73.2, U12.7 (IN-)
SCL: U12.4 (SCL)
SDA: U12.3 (SDA)
SYS_3V3: C63.1, U12.5 (VS)

Notes on the sheet:
2512 / 6.3 x 3.2 mm
CN3722 FB/BAT sense остаются до R71 на BAT_SYS; EN и BAT_ADC — от BAT.
SOIC-8 / 3.9x4.9 / P1.27
R71=0,1 Ом: штатная калибровка MeshCore. Ток заряда +, разряда −.
CC0805KRX7R9BB104
INA219 — напряжение и основной ток батареи
Kelvin от внутренних краёв площадок R71
RL2512FK-070R1L
0805
RC0805FR-0710RL
От зарядника / к TPS63802
INA219AIDR
v1.26 / v2.10 / 2026-11-06 / инженерный прототип
VS: SYS_3V3 после J11; при снятой J11 питание от USB через Nice!Nano и NT2.
BAT: J8.1 / J12.1
Балансиры подключены к ячейкам напрямую: их токи не входят в основной ток INA219.
A1=A0=GND: адрес 0x40. SDA/SCL — существующий I2C NiceNano.
EN / BAT_ADC / балансиры: до R71
