Alksndr55/mesh-repeater/shared/schematic/Converter.kicad_sch

## KiCad design shared/schematic/Converter.kicad_sch (2026-11-06)

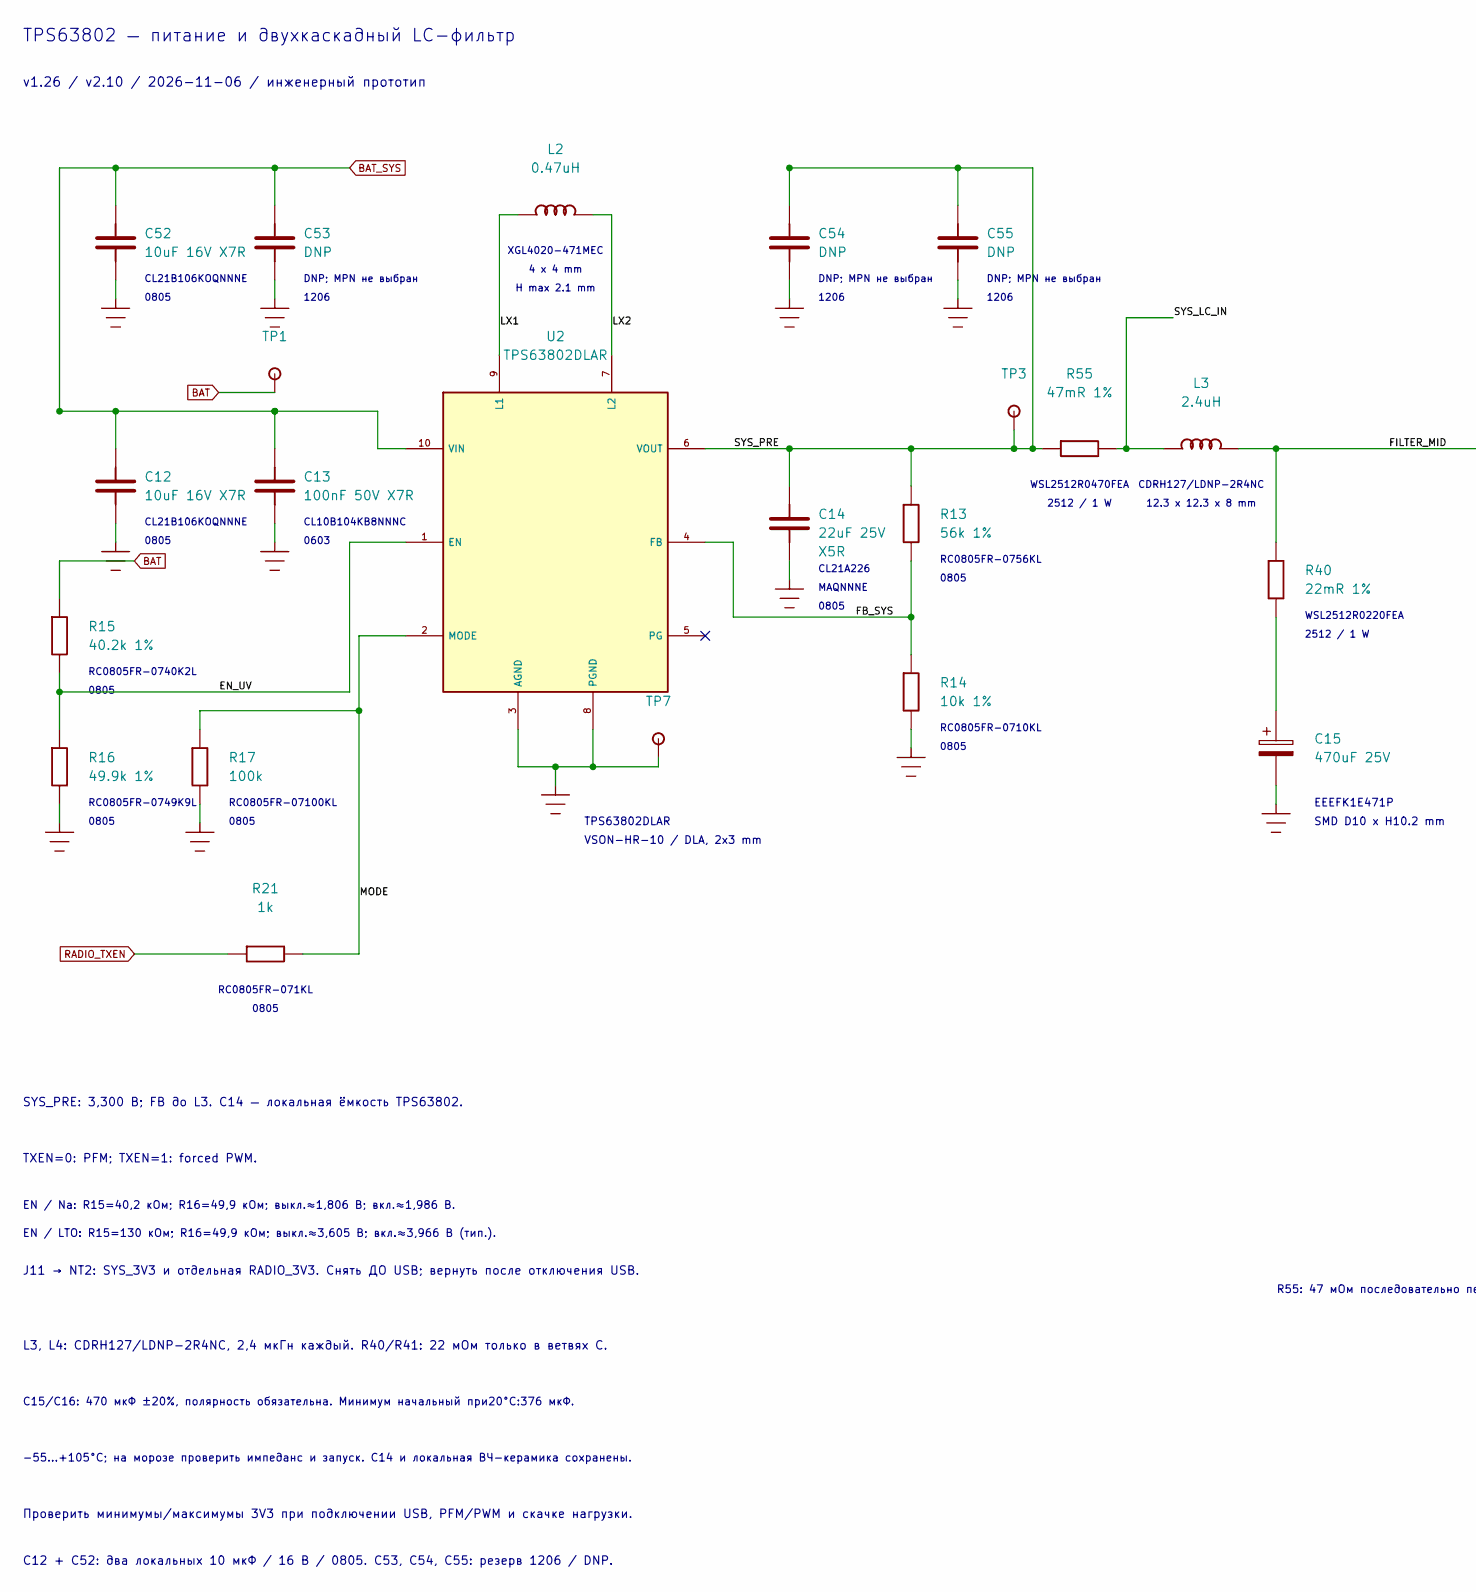
[picture p69: schematic Converter.kicad_sch, part in row 1, column 1]


Parts:
C12, C52: 10uF 16V X7R; C_0805_2012Metric; MPN CL21B106KOQNNNE
C13: 100nF 50V X7R; C_0805_2012Metric; MPN CL21B104KBCNNNC
C14: 22uF 25V X5R; C_0805_2012Metric; MPN CL21A226MAQNNNE
C15, C16: 470uF 25V; CP_Elec_10x10.2; MPN EEEFK1E471P
C53, C54, C55: DNP; C_1206_3216Metric
J11: LC OUT - SYS 3V3; PinHeader_1x02_P2.54mm_Vertical; MPN DS1021-1X40SF11-B
L2: 0.47uH; L_Coilcraft_XGL4020_471MEC_HandSolderUniversal; MPN XGL4020-471MEC; LCSC C5837785
L3, L4: 2.4uH; L_Sumida_CDRH127_LD; MPN CDRH127/LDNP-2R4NC
NT2: 3V3 STAR; NetTie_2_SMD_Power_Star_A3
R13: 56k 1%; R_0805_2012Metric; MPN RC0805FR-0756KL; LCSC C2523584
R14: 10k 1%; R_0805_2012Metric; MPN RC0805FR-0710KL
R15: 40.2k 1%; R_0805_2012Metric; MPN RC0805FR-0740K2L; LCSC C865475
R16: 49.9k 1%; R_0805_2012Metric; MPN RC0805FR-0749K9L; LCSC C469661
R17: 100k; R_0805_2012Metric; MPN RC0805FR-07100KL
R21: 1k; R_0805_2012Metric; MPN RC0805FR-071KL
R40: 22mR 1%; R_Vishay_WSL2512_A3__A3_R40; MPN WSL2512R0220FEA
R41: 22mR 1%; R_Vishay_WSL2512_A3__A3_R41; MPN WSL2512R0220FEA
R55: 47mR 1%; R_Vishay_WSL2512_A3__A3_R55; MPN WSL2512R0470FEA
TP1: BAT; TestPoint_Pad_D1.5mm
TP3: SYS_PRE; TestPoint_Pad_D1.5mm
TP4: SYS_3V3; TestPoint_Pad_D1.5mm
TP7: GND; TestPoint_Pad_D1.5mm
TP8: FILTER_MID; TestPoint_Pad_D1.5mm; MPN PCB test pad / not purchased
U2: TPS63802DLAR; TPS63802_DLA0010A; MPN TPS63802DLAR; LCSC C2845237

Connections:
BAT: R15.1, TP1.1
BAT_SYS: C12.1, C13.1, C52.1, C53.1, U2.10 (VIN)
EN_UV: R15.2, R16.1, U2.1 (EN)
FB_SYS: R13.2, R14.1, U2.4 (FB)
FILTER_MID: L3.2, L4.1, R40.1, TP8.1
FILTER_OUT: J11.1, L4.2, R41.1
GND: C12.2, C13.2, C14.2, C15.2, C16.2, C52.2, C53.2, C54.2, C55.2, R14.2, R16.2, R17.2, TP7.1, U2.3 (AGND), U2.8 (PGND)
LX1: L2.1, U2.9 (L1)
LX2: L2.2, U2.7 (L2)
MODE: R17.1, R21.2, U2.2 (MODE)
unnamed: C15.1, R40.2
unnamed: C16.1, R41.2
RADIO_3V3: NT2.2
RADIO_TXEN: R21.1
SYS_3V3: J11.2, NT2.1, TP4.1
SYS_LC_IN: L3.1, R55.2
SYS_PRE: C14.1, C54.1, C55.1, R13.1, R55.1, TP3.1, U2.6 (VOUT)

Notes on the sheet:
EN / Na: R15=40,2 кОм; R16=49,9 кОм; выкл.≈1,806 В; вкл.≈1,986 В.
CDRH127/LDNP-2R4NC
0805
TXEN=0: PFM; TXEN=1: forced PWM.
TPS63802 — питание и двухкаскадный LC-фильтр
CL10B104KB8NNNC
WSL2512R0470FEA
1206
WSL2512R0220FEA
RC0805FR-07100KL
Проверить минимумы/максимумы 3V3 при подключении USB, PFM/PWM и скачке нагрузки.
DNP; MPN не выбран
MAQNNNE
АКБ: шунт установлен. USB: шунт снять.
CL21B106KOQNNNE
RC0805FR-071KL
TPS63802DLAR
1: от LC
4 x 4 mm
0603
C12 + C52: два локальных 10 мкФ / 16 В / 0805. C53, C54, C55: резерв 1206 / DNP.
1 x 2 / 2.54 mm
2: звезда SYS / RADIO
EN / LTO: R15=130 кОм; R16=49,9 кОм; выкл.≈3,605 В; вкл.≈3,966 В (тип.).
RC0805FR-0749K9L
12.3 x 12.3 x 8 mm
RC0805FR-0756KL
2512 / 1 W
J11 → NT2: SYS_3V3 и отдельная RADIO_3V3. Снять ДО USB; вернуть после отключения USB.
H max 2.1 mm
RC0805FR-0710KL
CL21A226
DS1021-1X40SF11-B
RC0805FR-0740K2L
NT2: медная звезда, не разрезать
SYS_PRE: 3,300 В; FB до L3. C14 — локальная ёмкость TPS63802.
XGL4020-471MEC
L3, L4: CDRH127/LDNP-2R4NC, 2,4 мкГн каждый. R40/R41: 22 мОм только в ветвях C.
FILTER_MID
VSON-HR-10 / DLA, 2x3 mm
R55: 47 мОм последовательно перед L3; падение 47 мВ/А. FB и C14 до R55.
v1.26 / v2.10 / 2026-11-06 / инженерный прототип
EEEFK1E471P
SMD D10 x H10.2 mm
C15/C16: 470 мкФ ±20%, полярность обязательна. Минимум начальный при20°C:376 мкФ.
−55…+105°C; на морозе проверить импеданс и запуск. C14 и локальная ВЧ-керамика сохранены.
