Alksndr55/mesh-repeater/shared/schematic/LTO_Balancer.kicad_sch

## KiCad design shared/schematic/LTO_Balancer.kicad_sch (2026-11-06)

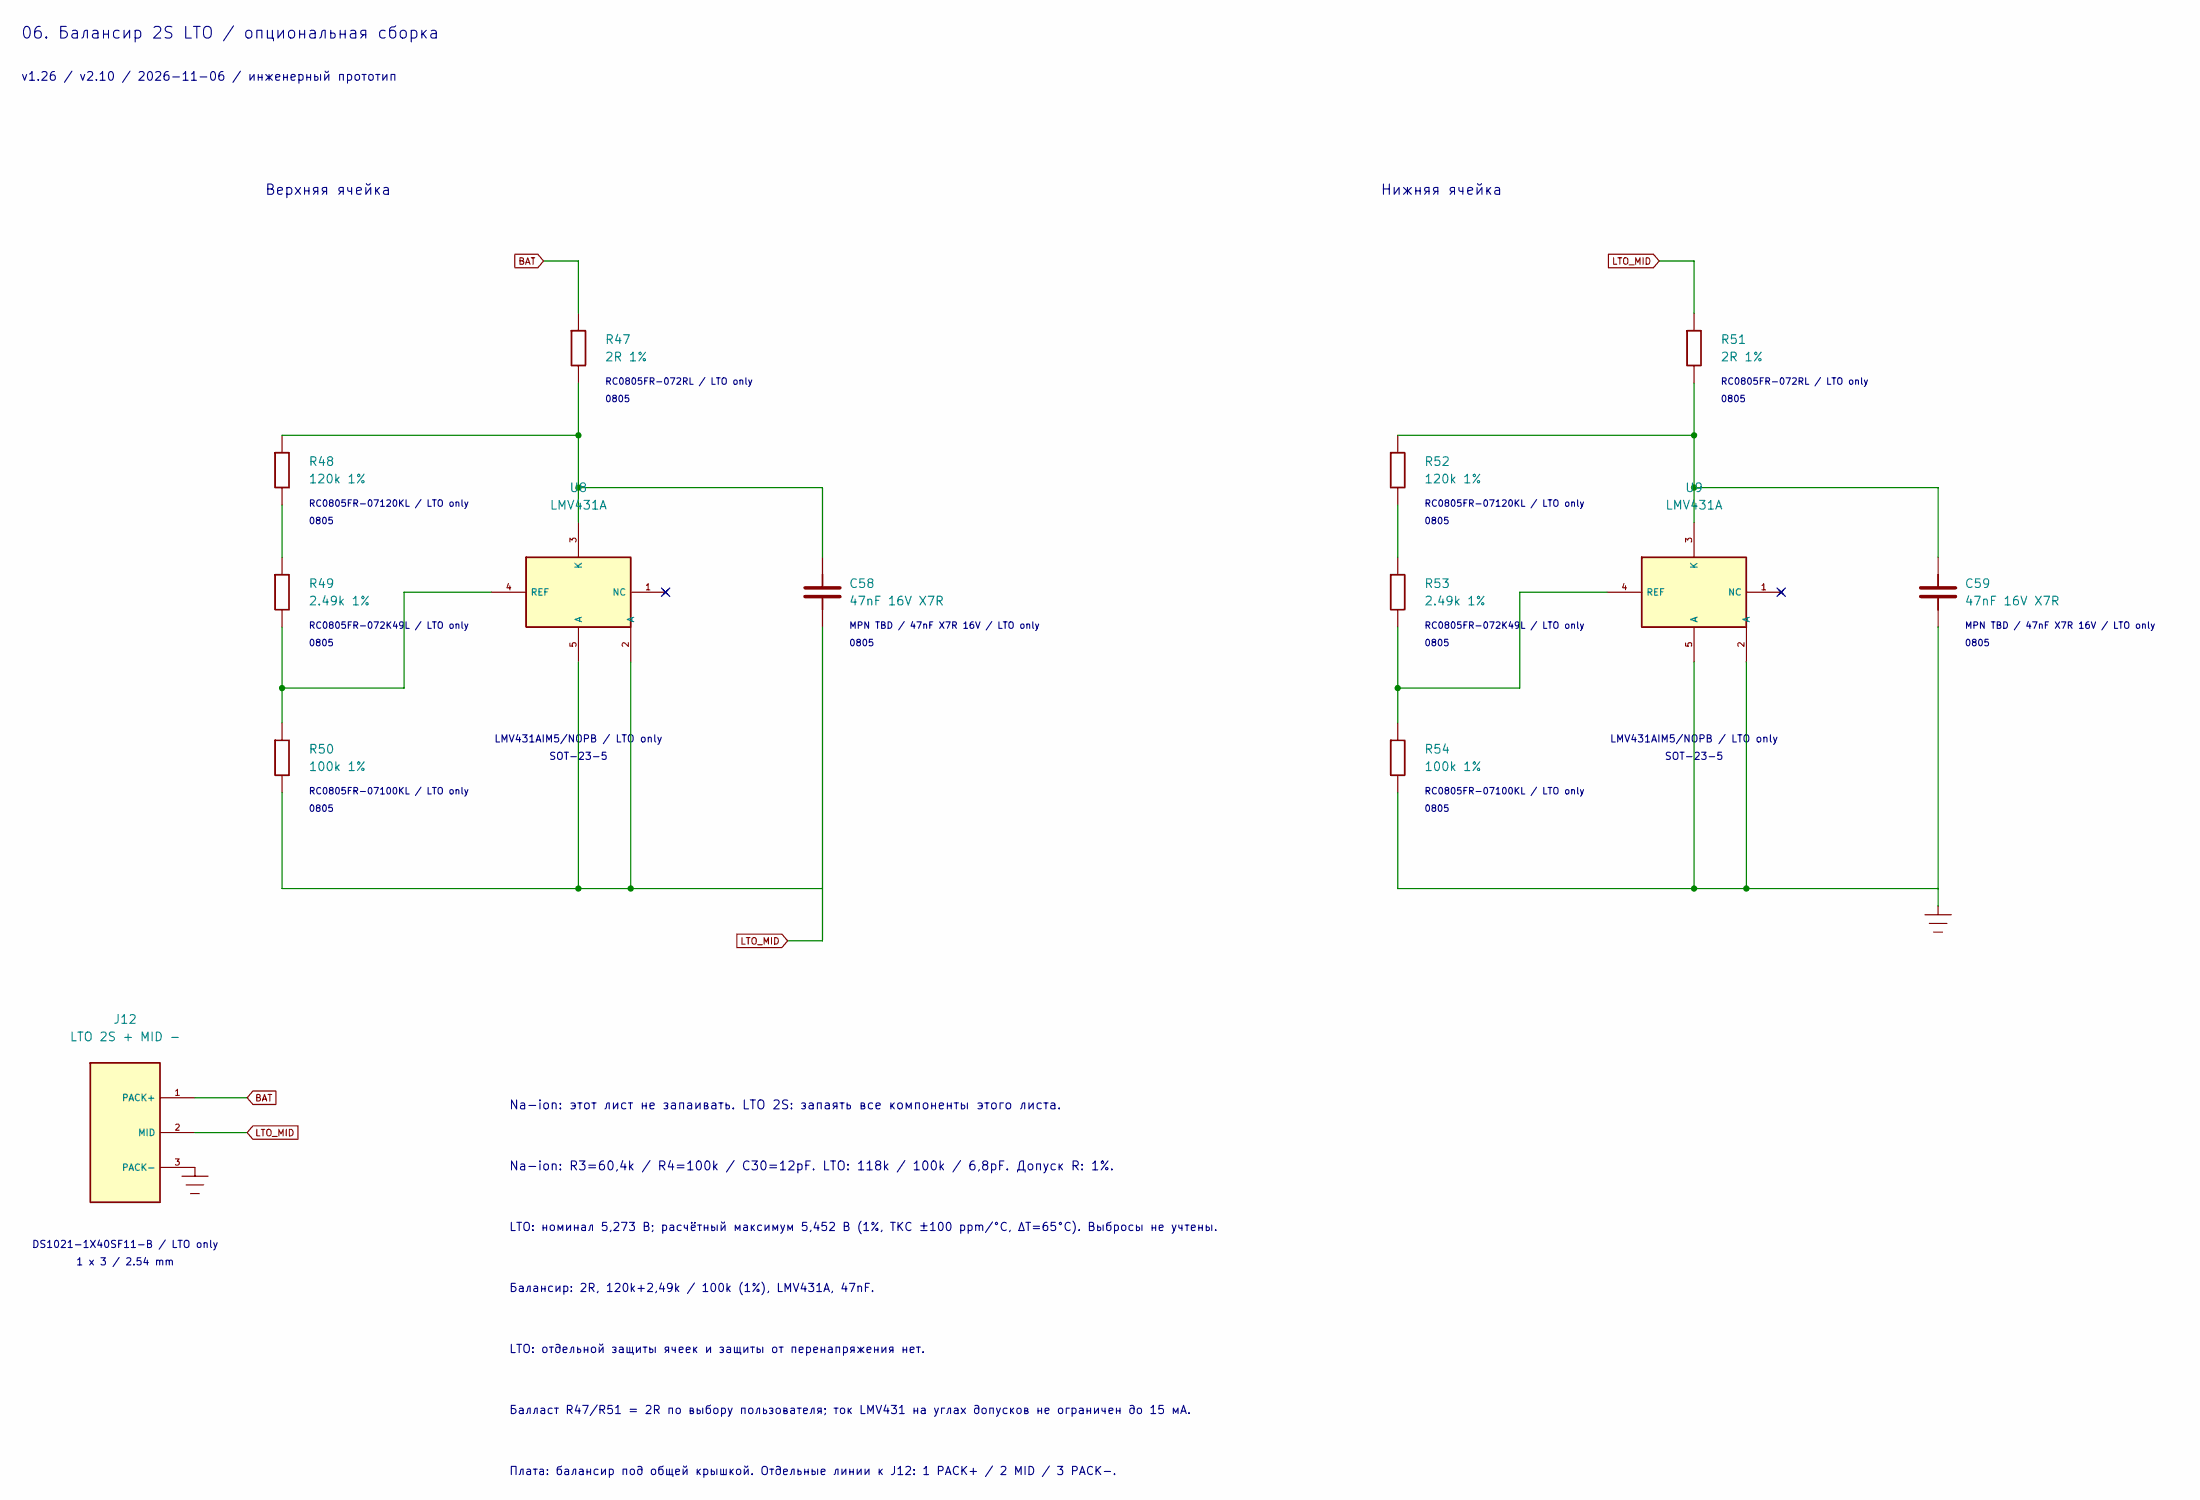
[picture p70: schematic LTO_Balancer.kicad_sch]

Parts:
C58, C59: 47nF 16V X7R; C_0805_2012Metric; MPN MPN TBD / 47nF X7R 16V
J12: LTO 2S + MID -; PinHeader_1x03_P2.54mm_Vertical; MPN DS1021-1X40SF11-B
R47, R51: 2R 1%; R_0805_2012Metric; MPN RC0805FR-072RL; LCSC C110775
R48, R52: 120k 1%; R_0805_2012Metric; MPN RC0805FR-07120KL; LCSC C110775
R49, R53: 2.49k 1%; R_0805_2012Metric; MPN RC0805FR-072K49L; LCSC C110775
R50, R54: 100k 1%; R_0805_2012Metric; MPN RC0805FR-07100KL; LCSC C110775
U8, U9: LMV431A; SOT-23-5; MPN LMV431AIM5/NOPB

Connections:
BAT: J12.1 (PACK+), R47.1
GND: C59.2, J12.3 (PACK-), R54.2, U9.2 (A), U9.5 (A)
LTO_MID: C58.2, J12.2 (MID), R50.2, R51.1, U8.2 (A), U8.5 (A)
unnamed: C58.1, R47.2, R48.1, U8.3 (K)
unnamed: C59.1, R51.2, R52.1, U9.3 (K)
unnamed: R48.2, R49.1
unnamed: R49.2, R50.1, U8.4 (REF)
unnamed: R52.2, R53.1
unnamed: R53.2, R54.1, U9.4 (REF)

Notes on the sheet:
0805
LMV431AIM5/NOPB / LTO only
MPN TBD / 47nF X7R 16V / LTO only
RC0805FR-07120KL / LTO only
RC0805FR-072K49L / LTO only
SOT-23-5
RC0805FR-07100KL / LTO only
1 x 3 / 2.54 mm
Верхняя ячейка
LTO: отдельной защиты ячеек и защиты от перенапряжения нет.
v1.26 / v2.10 / 2026-11-06 / инженерный прототип
06. Балансир 2S LTO / опциональная сборка
Балансир: 2R, 120k+2,49k / 100k (1%), LMV431A, 47nF.
RC0805FR-072RL / LTO only
Плата: балансир под общей крышкой. Отдельные линии к J12: 1 PACK+ / 2 MID / 3 PACK-.
LTO: номинал 5,273 В; расчётный максимум 5,452 В (1%, ТКС ±100 ppm/°C, ΔT=65°C). Выбросы не учтены.
Нижняя ячейка
DS1021-1X40SF11-B / LTO only
Балласт R47/R51 = 2R по выбору пользователя; ток LMV431 на углах допусков не ограничен до 15 мА.
Na-ion: R3=60,4k / R4=100k / C30=12pF. LTO: 118k / 100k / 6,8pF. Допуск R: 1%.
Na-ion: этот лист не запаивать. LTO 2S: запаять все компоненты этого листа.
