Alksndr55/mesh-repeater/shared/schematic/MeshRepeater.kicad_sch

## KiCad design shared/schematic/MeshRepeater.kicad_sch (2026-11-06)

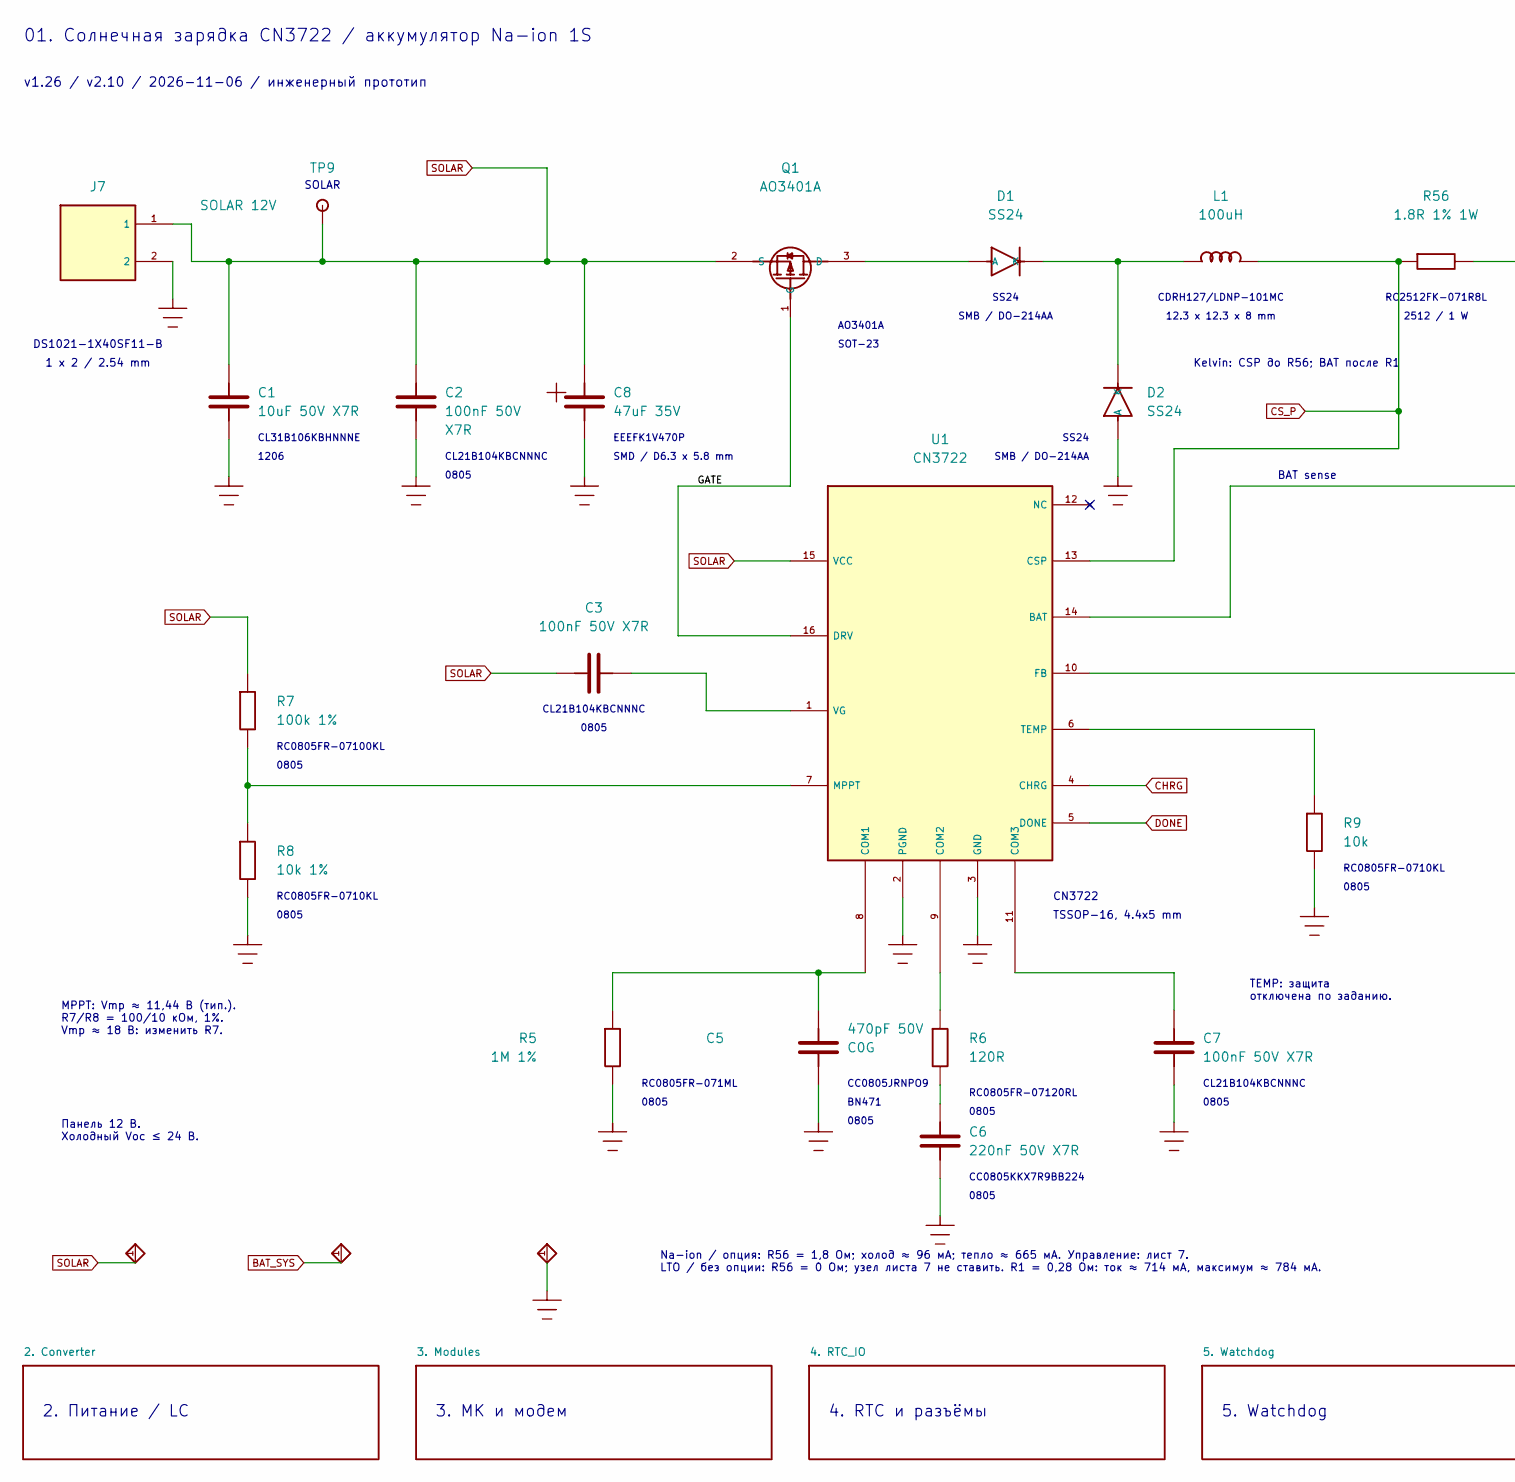
[picture p71: schematic MeshRepeater.kicad_sch, part in row 1, column 1]


Parts:
C1: 10uF 50V X7R; C_1206_3216Metric; MPN CL31B106KBHNNNE
C2, C3, C7: 100nF 50V X7R; C_0805_2012Metric; MPN CL21B104KBCNNNC
C4: 22uF 25V X5R; C_0805_2012Metric; MPN CL21A226MAQNNNE
C5: 470pF 50V C0G; C_0805_2012Metric; MPN CC0805JRNPO9BN471
C6: 220nF 50V X7R; C_0805_2012Metric; MPN CC0805KKX7R9BB224
C8: 47uF 35V; CP_Elec_Panasonic_FK_D_6.3x5.8; MPN EEEFK1V470P
C30: 12pF 50V C0G; C_0805_2012Metric; MPN CC0805JRNPO9BN120
D1, D2: SS24; D_SMB; MPN SS24
D3: RED; LED_0805_2012Metric; MPN FYLS-0805BURC
D4: GREEN; LED_0805_2012Metric; MPN FYLS-0805BUGC
J7: SOLAR 12V; PinHeader_1x02_P2.54mm_Vertical; MPN DS1021-1X40SF11-B
J8: Na-ion 1S; PinHeader_1x02_P2.54mm_Vertical; MPN DS1021-1X40SF11-B
L1: 100uH; L_Sumida_CDRH127_LDNP_101MC; MPN CDRH127/LDNP-101MC
Q1: AO3401A; SOT-23; MPN AO3401A
R1: 0.28R 1%; R_Vishay_WSL2512_A3__A3_R1; MPN WSL2512R2800FEA
R3: 60.4k 1%; R_0805_2012Metric; MPN RC0805FR-0760K4L; LCSC C2084414
R4: 100k 1%; R_0805_2012Metric; MPN RC0805FR-07100KL; LCSC C110775
R5: 1M 1%; R_0805_2012Metric; MPN RC0805FR-071ML
R6: 120R; R_0805_2012Metric; MPN RC0805FR-07120RL
R7: 100k 1%; R_0805_2012Metric; MPN RC0805FR-07100KL; LCSC C856623
R8: 10k 1%; R_0805_2012Metric; MPN RC0805FR-0710KL
R9, R10, R11: 10k; R_0805_2012Metric; MPN RC0805FR-0710KL
R56: 1.8R 1% 1W; R_2512_6332Metric__A3_R56; MPN RC2512FK-071R8L
TP9: SOLAR; TestPoint_Pad_D1.5mm; MPN PCB test pad / not purchased
U1: CN3722; TSSOP-16_4.4x5mm_P0.65mm; MPN CN3722; LCSC C77905

Connections:
BAT: J8.1
BAT_SYS: C4.1, C30.1, R1.2, R3.1, U1.14 (BAT)
CHG_CS_M: R1.1, R56.2
CHRG: D3.1 (K), U1.4 (CHRG)
CS_P: L1.2, R56.1, U1.13 (CSP)
DONE: D4.1 (K), U1.5 (DONE)
GATE: Q1.1 (G), U1.16 (DRV)
GND: C1.2, C2.2, C4.2, C5.2, C6.2, C7.2, C8.2, D2.2 (A), J7.2, J8.2, R4.2, R5.2, R8.2, R9.2, U1.2 (PGND), U1.3 (GND)
unnamed: C3.2, U1.1 (VG)
unnamed: C5.1, R5.1, U1.8 (COM1)
unnamed: C6.1, R6.2
unnamed: C7.1, U1.11 (COM3)
unnamed: C30.2, R3.2, R4.1, U1.10 (FB)
unnamed: D1.1 (K), D2.1 (K), L1.1
unnamed: D1.2 (A), Q1.3 (D)
unnamed: D3.2 (A), R10.2
unnamed: D4.2 (A), R11.2
unnamed: R6.1, U1.9 (COM2)
unnamed: R7.2, R8.1, U1.7 (MPPT)
unnamed: R9.1, U1.6 (TEMP)
SOLAR: C1.1, C2.1, C3.1, C8.1, J7.1, Q1.2 (S), R7.1, R10.1, R11.1, TP9.1, U1.15 (VCC)

Notes on the sheet:
0805
RC0805FR-07120RL
Kelvin: CSP до R56; BAT после R1
EEEFK1V470P
WSL2512R2800FEA
3. МК и модем
2512 / 1 W
TEMP: защита отключена по заданию.
8. INA219 / ток АКБ
0805 (2012)
1206
SMB / DO-214AA
RC0805FR-07100KL
DS1021-1X40SF11-B
SOT-23
CL21A226MAQNNNE
6. LTO / опция
CL21B104KBCNNNC
1 x 2 / 2.54 mm
Na-ion: R3 60,4k / R4 100k; C30 12pF; CV тип.3,878 В, расч.max3,982 В LTO 2S: R3 118k / R4 100k; C30 6,8pF; CV тип.5,273 В, расч.max5,452 В 1%; ТКС ±100 ppm/°C, ΔT=65°C. Установившийся режим; выбросы не учтены.
4. RTC и разъёмы
FYLS-0805BURC
TSSOP-16, 4.4x5 mm
FYLS-0805BUGC
RC2512FK-071R8L
RC0805FR-0710KL
SS24
AO3401A
RC0805FR-0760K4L
CC0805KKX7R9BB224
CC0805JRNPO9BN120
v1.26 / v2.10 / 2026-11-06 / инженерный прототип
Панель 12 В. Холодный Voc ≤ 24 В.
CL31B106KBHNNNE
SMD / D6.3 x 5.8 mm
SOLAR
BAT sense
01. Солнечная зарядка CN3722 / аккумулятор Na-ion 1S
MPPT: Vmp ≈ 11,44 В (тип.). R7/R8 = 100/10 кОм, 1%. Vmp ≈ 18 В: изменить R7.
5. Watchdog
2. Питание / LC
12.3 x 12.3 x 8 mm
RC0805FR-071ML
CDRH127/LDNP-101MC
Na-ion / опция: R56 = 1,8 Ом; холод ≈ 96 мА; тепло ≈ 665 мА. Управление: лист 7. LTO / без опции: R56 = 0 Ом; узел листа 7 не ставить. R1 = 0,28 Ом: ток ≈ 714 мА, максимум ≈ 784 мА.
CC0805JRNPO9
CN3722
7. Холод / опция
BN471
