Alksndr55/mesh-repeater/shared/schematic/Modules.kicad_sch

## KiCad design shared/schematic/Modules.kicad_sch (2026-11-06)

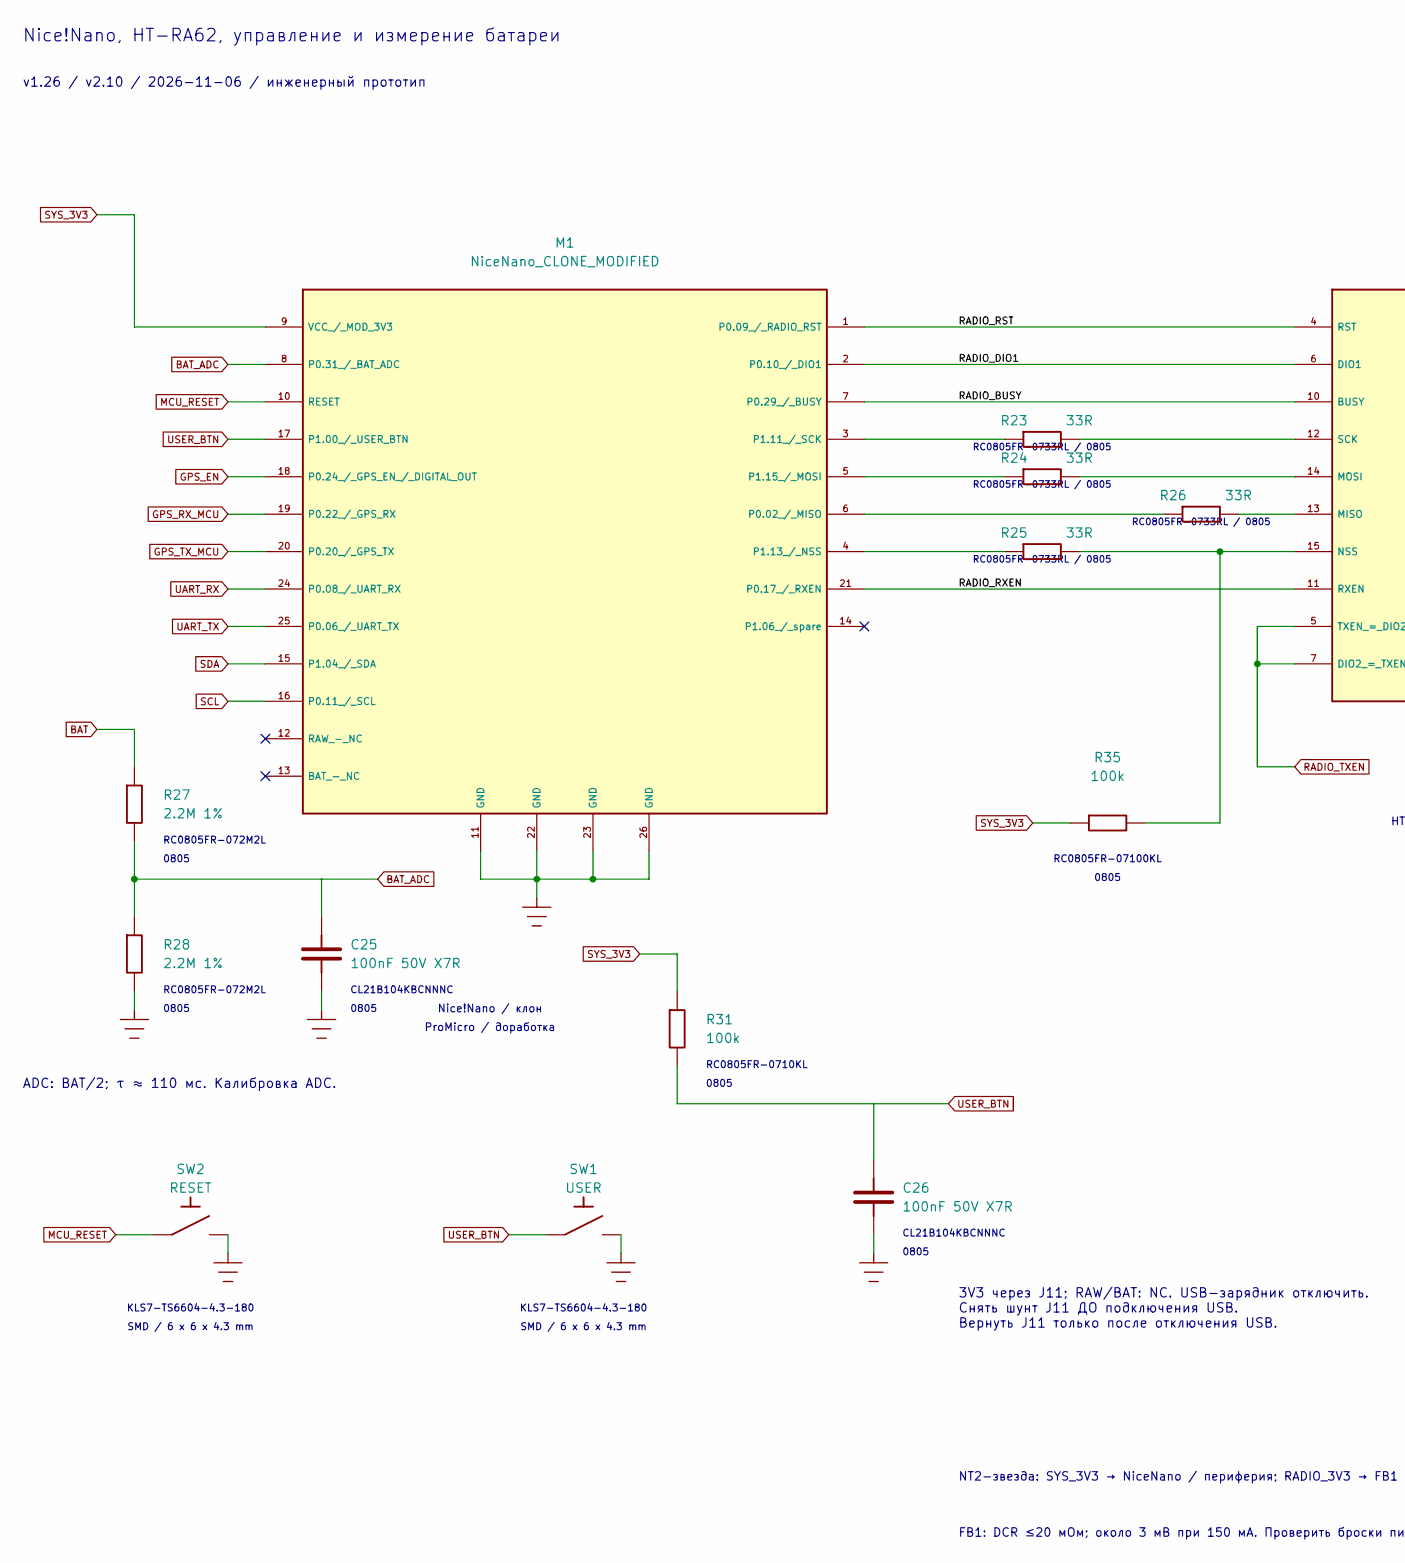
[picture p72: schematic Modules.kicad_sch, part in row 1, column 1]


Parts:
C21: 10uF 16V X7R; C_0805_2012Metric; MPN CL21B106KOQNNNE
C22, C24, C25, C26: 100nF 50V X7R; C_0805_2012Metric; MPN CL21B104KBCNNNC
C23: 22uF 25V X5R; C_0805_2012Metric; MPN CL21A226MAQNNNE
FB1: 60R@100MHz / 3A; Ferrite_Murata_BLM21PG; MPN BLM21PG600SN1D
FL1: S869M000S003; SAW_AEL_DCC6C_S869M000S003; MPN S869M000S003
J13: SMA 50Ohm; SMA_KLS1_SMA002_B_Horizontal; MPN L-KLS1-SMA002-B
M1: NiceNano_CLONE_MODIFIED; NiceNano_13x2_Socket; MPN User supplied NiceNano clone
M2: HT-RA62; HT_RA62; MPN HT-RA62 band variant TBD
NT1: Cu link / cut for FL1; RF_Cut_Link_0p6; MPN PCB copper / not purchased
R23, R24, R25, R26: 33R; R_0805_2012Metric; MPN RC0805FR-0733RL
R27, R28: 2.2M 1%; R_0805_2012Metric; MPN RC0805FR-072M2L
R31, R35: 100k; R_0805_2012Metric; MPN RC0805FR-07100KL
SW1: USER; SW_Push_KLS7_TS6604_4_3_180; MPN KLS7-TS6604-4.3-180
SW2: RESET; SW_Push_KLS7_TS6604_4_3_180; MPN KLS7-TS6604-4.3-180

Connections:
ANT_RF: FL1.2 (IN), M2.1 (ANT), NT1.1
ANT_SMA: FL1.5 (OUT), J13.1 (RF), NT1.2
BAT: R27.1
BAT_ADC: C25.1, M1.8 (P0.31_/_BAT_ADC), R27.2, R28.1
GND: C21.2, C22.2, C23.2, C24.2, C25.2, C26.2, FL1.1 (GND), FL1.3 (GND), FL1.4 (GND), FL1.6 (GND), J13.2 (SHIELD), M1.11 (GND), M1.22 (GND), M1.23 (GND), M1.26 (GND), M2.2 (GND), M2.9 (GND), M2.16 (GND), R28.2, SW1.2, SW2.2
GPS_EN: M1.18 (P0.24_/_GPS_EN_/_DIGITAL_OUT)
GPS_RX_MCU: M1.19 (P0.22_/_GPS_RX)
GPS_TX_MCU: M1.20 (P0.20_/_GPS_TX)
MCU_RESET: M1.10 (RESET), SW2.1
unnamed: M1.3 (P1.11_/_SCK), R23.1
unnamed: M1.4 (P1.13_/_NSS), R25.1
unnamed: M1.5 (P1.15_/_MOSI), R24.1
unnamed: M1.6 (P0.02_/_MISO), R26.2
unnamed: M2.12 (SCK), R23.2
unnamed: M2.13 (MISO), R26.1
unnamed: M2.14 (MOSI), R24.2
unnamed: M2.15 (NSS), R25.2, R35.2
RADIO_3V3: FB1.1
RADIO_BUSY: M1.7 (P0.29_/_BUSY), M2.10 (BUSY)
RADIO_DIO1: M1.2 (P0.10_/_DIO1), M2.6 (DIO1)
RADIO_LOCAL_3V3: C23.1, C24.1, FB1.2, M2.3 (3V3)
RADIO_RST: M1.1 (P0.09_/_RADIO_RST), M2.4 (RST)
RADIO_RXEN: M1.21 (P0.17_/_RXEN), M2.11 (RXEN)
RADIO_TXEN: M2.5 (TXEN_=_DIO2), M2.7 (DIO2_=_TXEN)
SCL: M1.16 (P0.11_/_SCL)
SDA: M1.15 (P1.04_/_SDA)
SYS_3V3: C21.1, C22.1, M1.9 (VCC_/_MOD_3V3), R31.1, R35.1
UART_RX: M1.24 (P0.08_/_UART_RX)
UART_TX: M1.25 (P0.06_/_UART_TX)
USER_BTN: C26.1, M1.17 (P1.00_/_USER_BTN), R31.2, SW1.1

Notes on the sheet:
FB1: DCR ≤20 мОм; около 3 мВ при 150 мА. Проверить броски питания при TX осциллографом.
HT-RA62: R1 = 0 Ом (ANT); R2 снять (IPEX). R1/R2 здесь — резисторы внутри модуля. Подключать антенну только к J13.
SMA / угловой / PTH
FL1 — опция 868–870 МГц, TX ≤ +13 dBm. До установки разрезать медь NT1 под FL1. Без FL1 оставить NT1 целой.
KLS7-TS6604-4.3-180
BLM21PG600SN1D
0805
RC0805FR-0733RL / 0805
SMD / 6 x 6 x 4.3 mm
module16x17 mm, P2.0
S869M000S003 / опция
CL21B104KBCNNNC
CL21B106KOQNNNE
SPI: 33 Ом у драйверов. ANT: J13 / SMA, 50 Ом. TXEN → MODE и watchdog. P1.06 свободен. BUSY=P0.29; GPS_EN=P0.24. GPS_EN=HIGH: питание GPS включено.
DCC6C / 3 x 3 x 1.3 mm
3V3 через J11; RAW/BAT: NC. USB-зарядник отключить. Снять шунт J11 ДО подключения USB. Вернуть J11 только после отключения USB.
L-KLS1-SMA002-B
ADC: BAT/2; τ ≈ 110 мс. Калибровка ADC.
Nice!Nano, HT-RA62, управление и измерение батареи
v1.26 / v2.10 / 2026-11-06 / инженерный прототип
CL21A226MAQNNNE
RC0805FR-072M2L
HT-RA62 / диапазон выбрать
NT2-звезда: SYS_3V3 → NiceNano / периферия; RADIO_3V3 → FB1 → RADIO_LOCAL_3V3.
RC0805FR-0710KL
Nice!Nano / клон
RC0805FR-07100KL
ProMicro / доработка
0805 / 2 x 1.25 mm
