Alksndr55/mesh-repeater/shared/schematic/RTC_IO.kicad_sch

## KiCad design shared/schematic/RTC_IO.kicad_sch (2026-11-06)

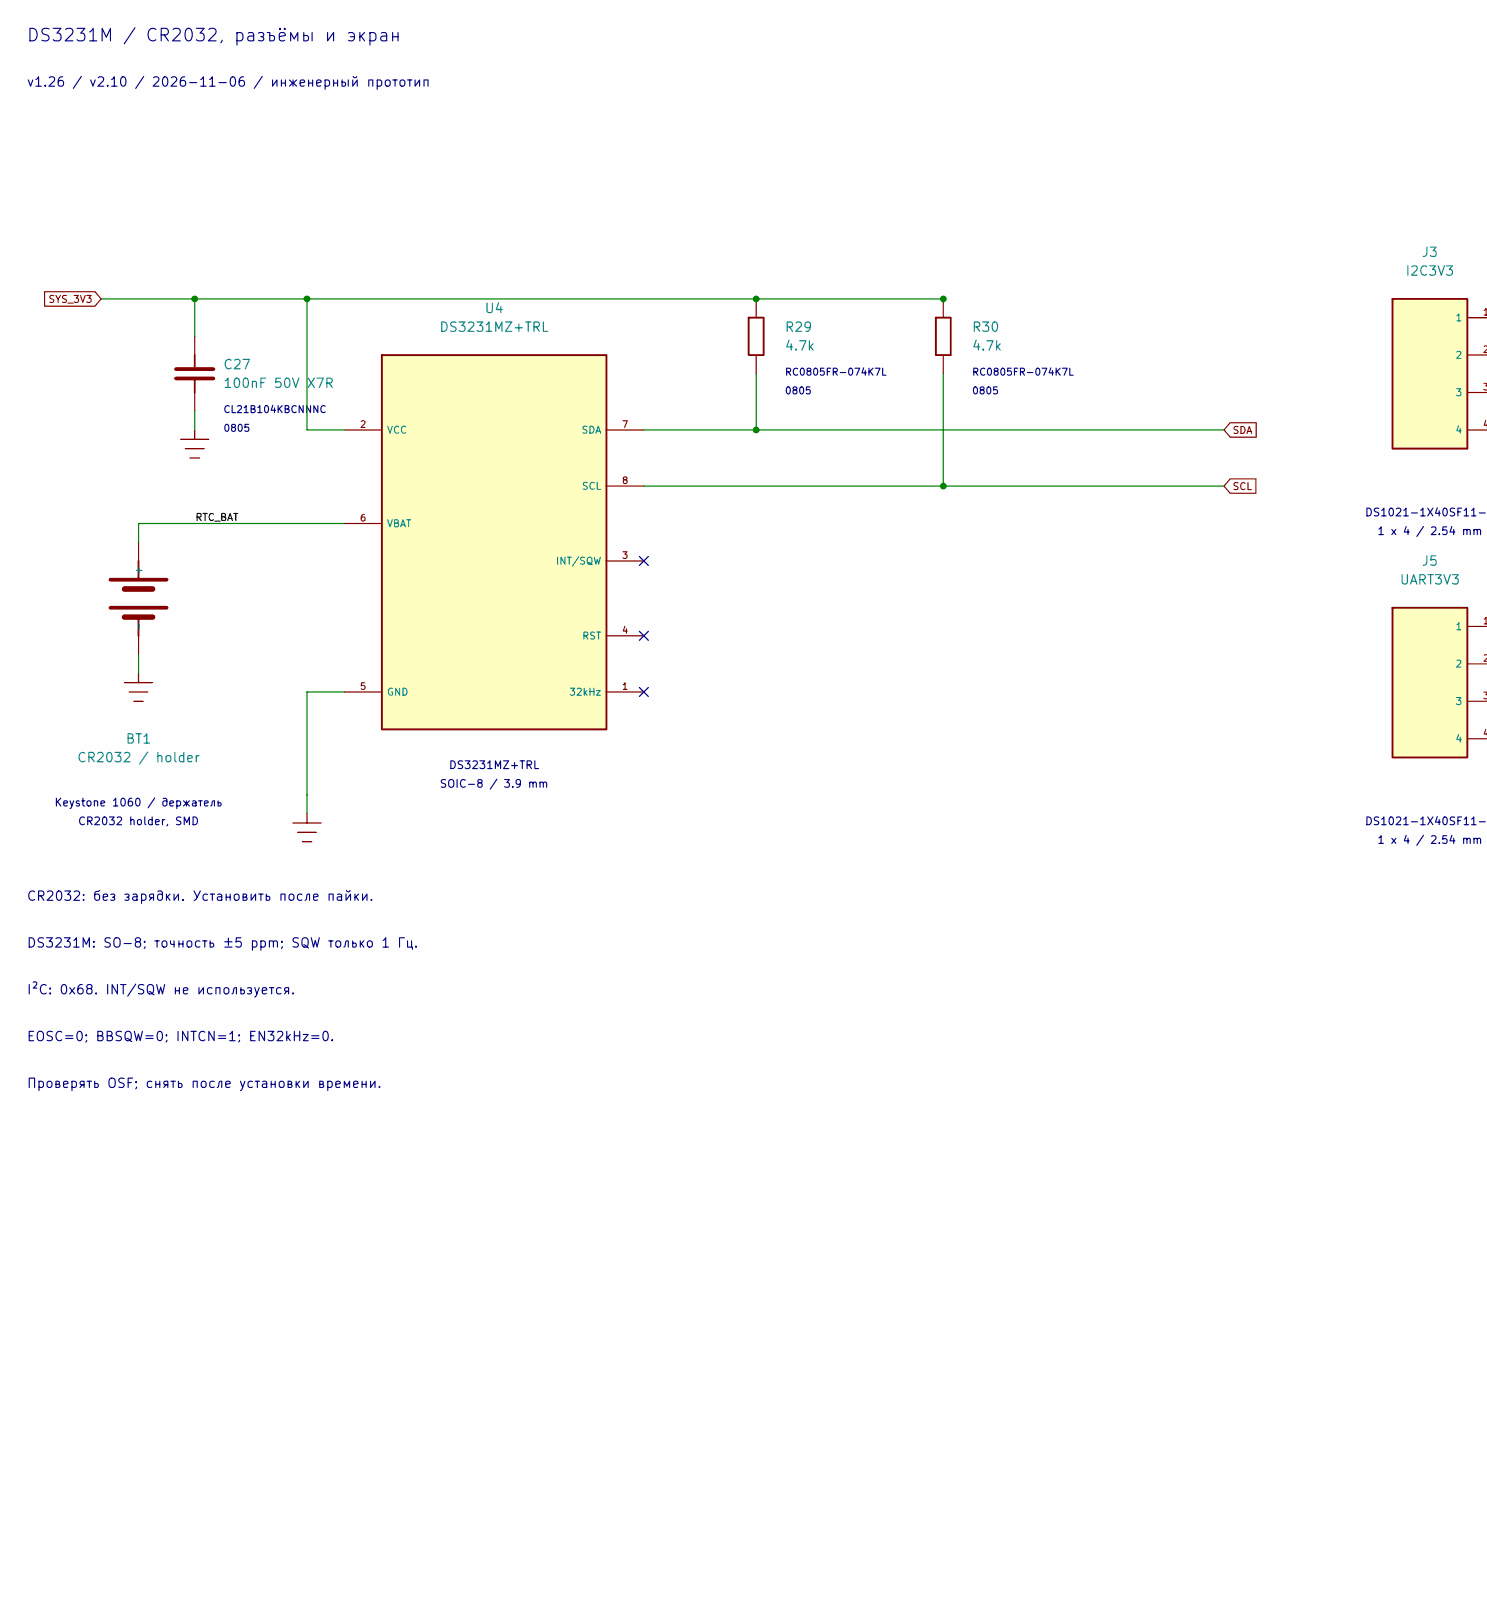
[picture p73: schematic RTC_IO.kicad_sch, part in row 1, column 1]

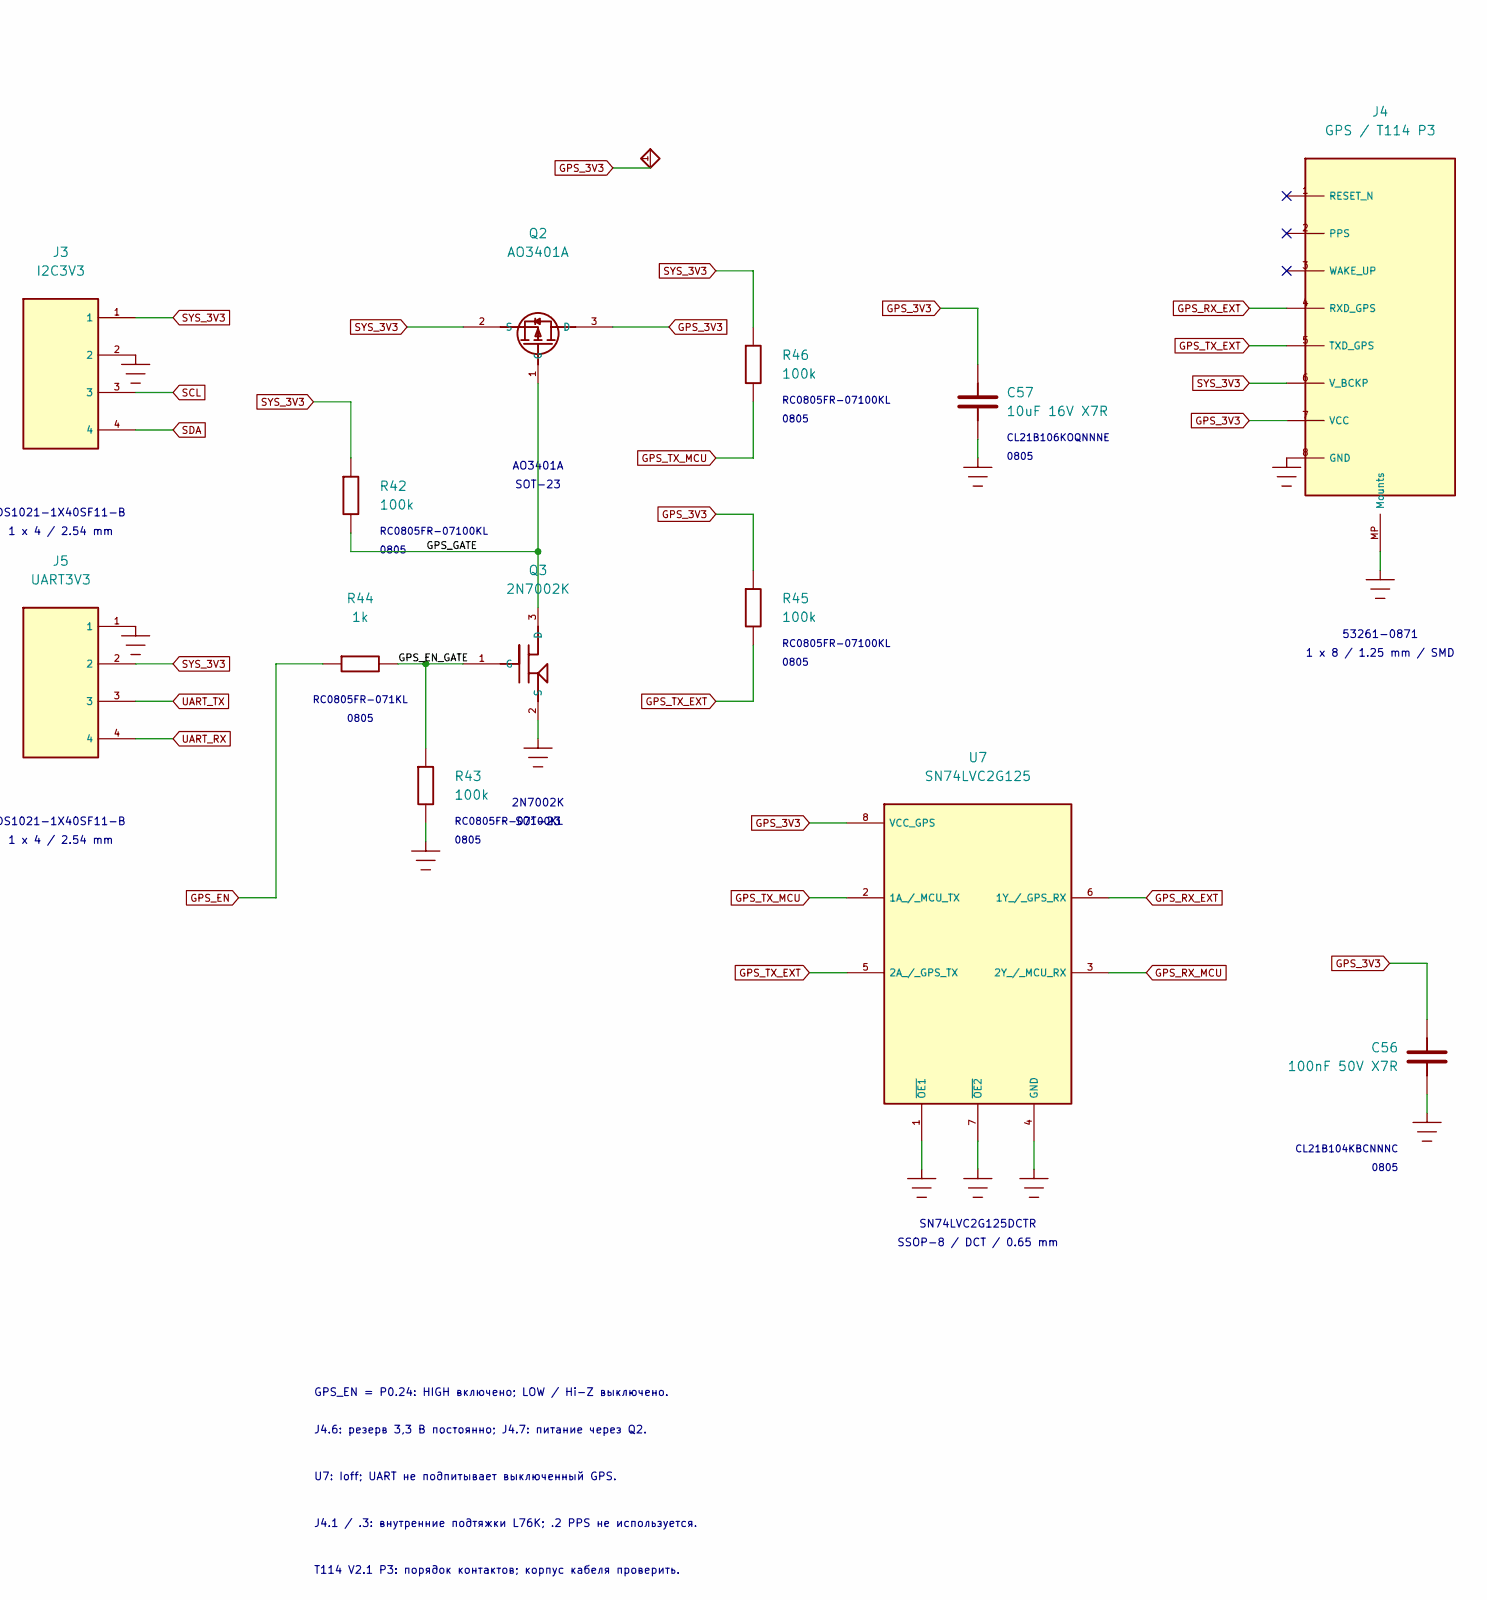
[picture p74: schematic RTC_IO.kicad_sch, part in row 1, column 2]

Parts:
BT1: CR2032 / holder; BatteryHolder_Keystone_1060_1x2032; MPN 1060; LCSC C5370859
C27, C56: 100nF 50V X7R; C_0805_2012Metric; MPN CL21B104KBCNNNC
C57: 10uF 16V X7R; C_0805_2012Metric; MPN CL21B106KOQNNNE
J3: I2C3V3; PinHeader_1x04_P2.54mm_Vertical; MPN DS1021-1X40SF11-B
J4: GPS / T114 P3; Molex_PicoBlade_53261-0871_1x08-1MP_P1.25mm_Horizontal; MPN 53261-0871
J5: UART3V3; PinHeader_1x04_P2.54mm_Vertical; MPN DS1021-1X40SF11-B
Q2: AO3401A; SOT-23; MPN AO3401A
Q3: 2N7002K; SOT-23; MPN 2N7002K
R29, R30: 4.7k; R_0805_2012Metric; MPN RC0805FR-074K7L
R42, R43, R45, R46: 100k; R_0805_2012Metric; MPN RC0805FR-07100KL
R44: 1k; R_0805_2012Metric; MPN RC0805FR-071KL
U4: DS3231MZ+TRL; SOIC-8_3.9x4.9mm_P1.27mm; MPN DS3231MZ+TRL
U7: SN74LVC2G125; TI_DCT0008A; MPN SN74LVC2G125DCTR

Connections:
GND: BT1.2 (-), C27.2, C56.2, C57.2, J3.2, J4.8 (GND), J4.MP (Mounts), J5.1, Q3.2 (S), R43.2, U4.5 (GND), U7.1 (~OE1), U7.4 (GND), U7.7 (~OE2)
GPS_3V3: C56.1, C57.1, J4.7 (VCC), Q2.3 (D), R45.1, U7.8 (VCC_GPS)
GPS_EN: R44.1
GPS_EN_GATE: Q3.1 (G), R43.1, R44.2
GPS_GATE: Q2.1 (G), Q3.3 (D), R42.2
GPS_RX_EXT: J4.4 (RXD_GPS), U7.6 (1Y_/_GPS_RX)
GPS_RX_MCU: U7.3 (2Y_/_MCU_RX)
GPS_TX_EXT: J4.5 (TXD_GPS), R45.2, U7.5 (2A_/_GPS_TX)
GPS_TX_MCU: R46.2, U7.2 (1A_/_MCU_TX)
RTC_BAT: BT1.1 (+), U4.6 (VBAT)
SCL: J3.3, R30.2, U4.8 (SCL)
SDA: J3.4, R29.2, U4.7 (SDA)
SYS_3V3: C27.1, J3.1, J4.6 (V_BCKP), J5.2, Q2.2 (S), R29.1, R30.1, R42.1, R46.1, U4.2 (VCC)
UART_RX: J5.4
UART_TX: J5.3

Notes on the sheet:
Проверять OSF; снять после установки времени.
J4.6: резерв 3,3 В постоянно; J4.7: питание через Q2.
SOT-23
T114 V2.1 P3: порядок контактов; корпус кабеля проверить.
U7: Ioff; UART не подпитывает выключенный GPS.
AO3401A
0805
1 x 4 / 2.54 mm
CL21B104KBCNNNC
RC0805FR-07100KL
DS3231M / CR2032, разъёмы и экран
v1.26 / v2.10 / 2026-11-06 / инженерный прототип
CR2032: без зарядки. Установить после пайки.
RC0805FR-074K7L
J4.1 / .3: внутренние подтяжки L76K; .2 PPS не используется.
1 x 8 / 1.25 mm / SMD
Keystone 1060 / держатель
CR2032 holder, SMD
DS1021-1X40SF11-B
DS3231M: SO-8; точность ±5 ppm; SQW только 1 Гц.
SSOP-8 / DCT / 0.65 mm
SN74LVC2G125DCTR
EOSC=0; BBSQW=0; INTCN=1; EN32kHz=0.
53261-0871
GPS_EN = P0.24: HIGH включено; LOW / Hi-Z выключено.
RC0805FR-071KL
CL21B106KOQNNNE
2N7002K
I²C: 0x68. INT/SQW не используется.
DS3231MZ+TRL
SOIC-8 / 3.9 mm
