Alksndr55/mesh-repeater/shared/schematic/Thermal.kicad_sch

## KiCad design shared/schematic/Thermal.kicad_sch (2026-11-06)

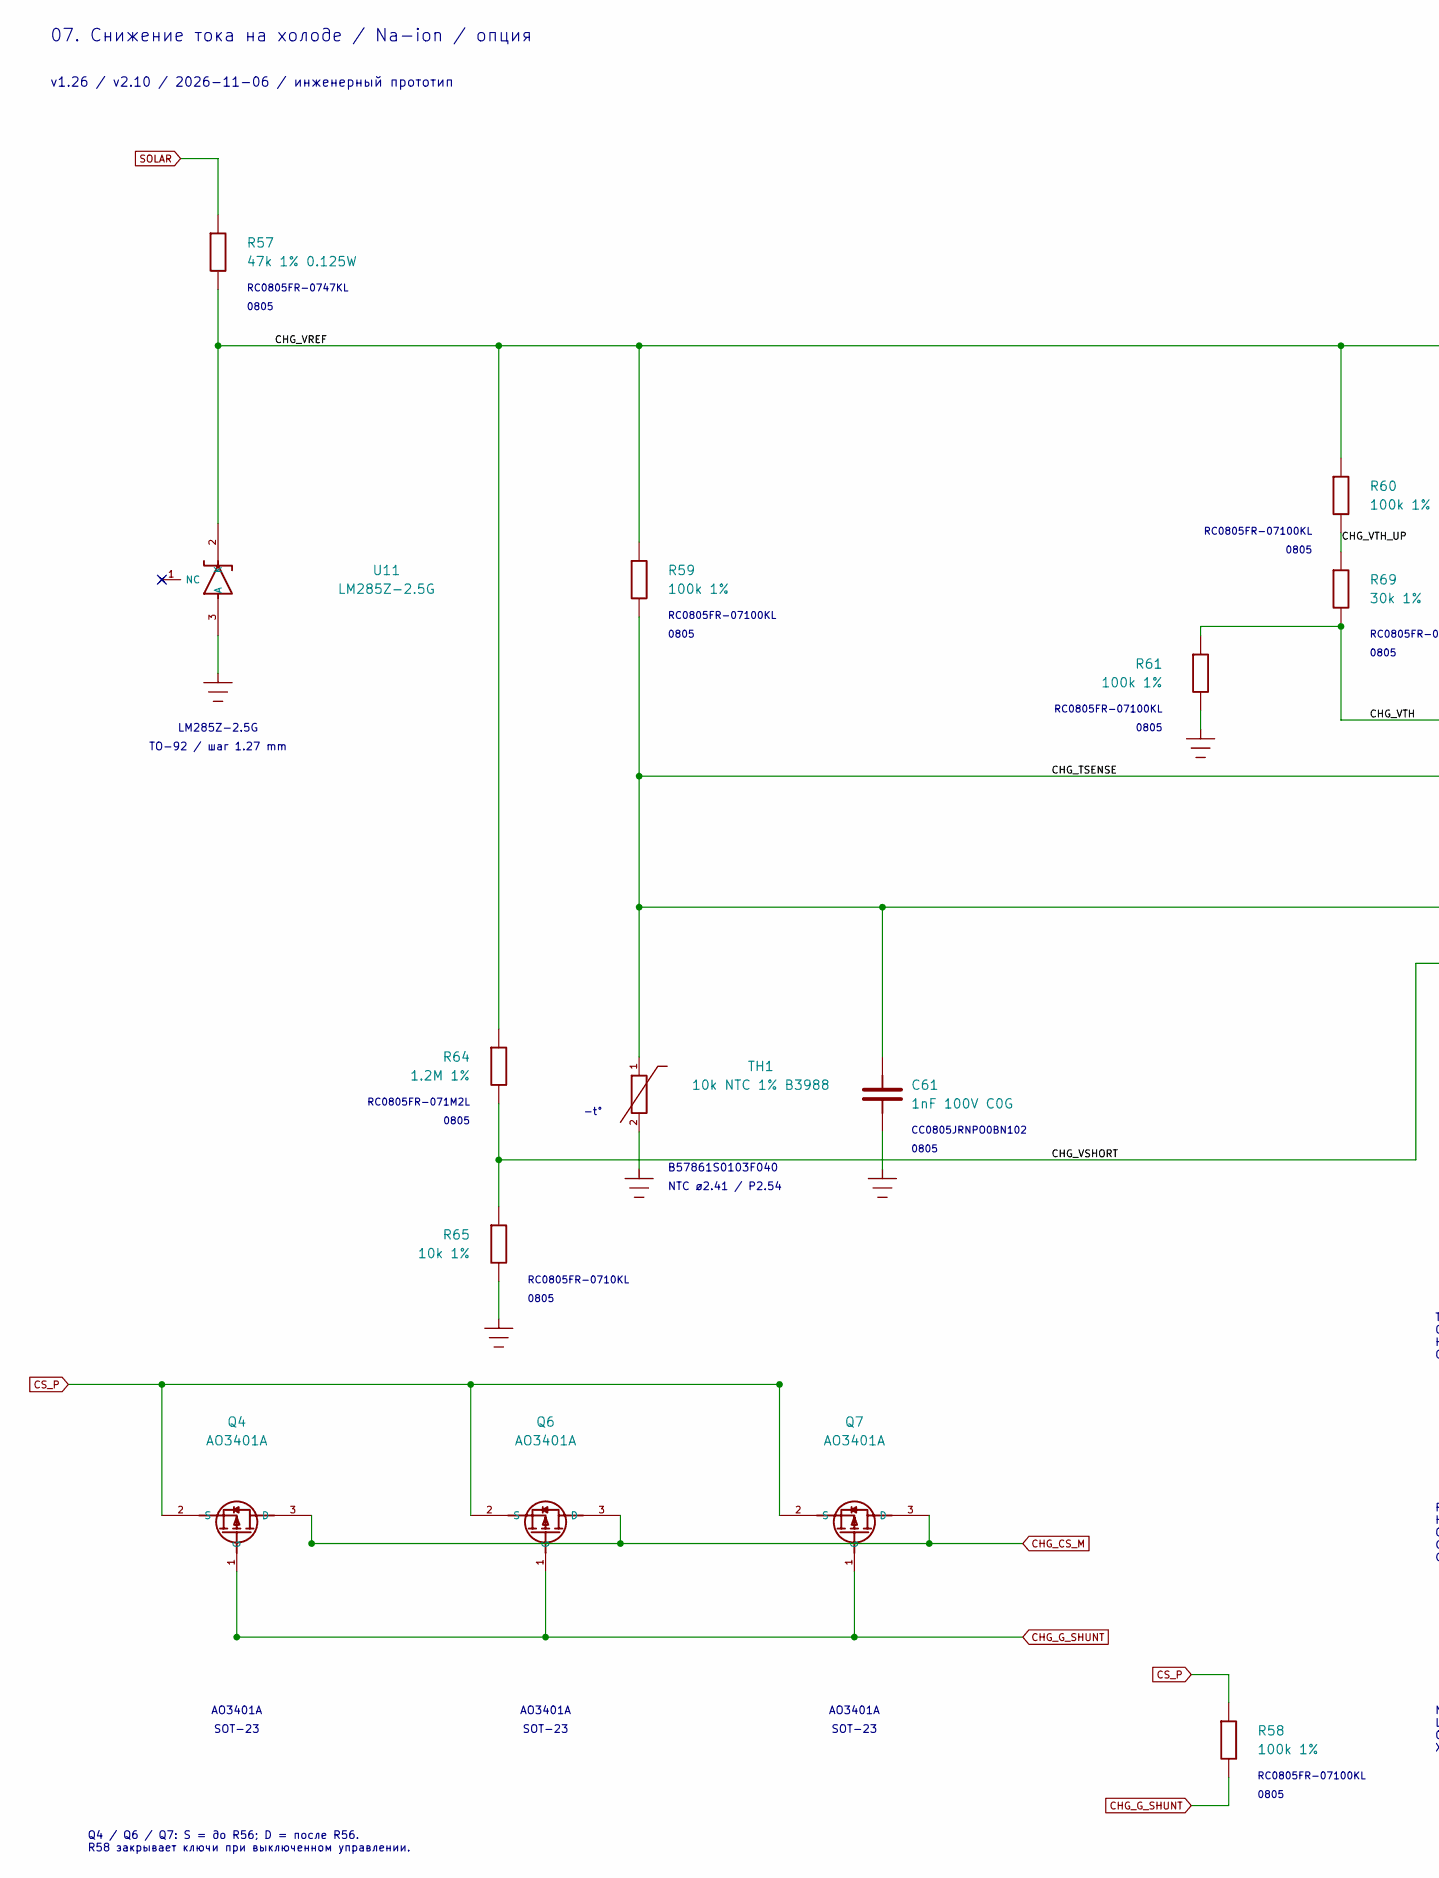
[picture p75: schematic Thermal.kicad_sch, part in row 1, column 1]


Parts:
C60, C62: 100nF 50V X7R; C_0805_2012Metric; MPN CL21B104KBCNNNC
C61: 1nF 100V C0G; C_0805_2012Metric; MPN CC0805JRNPO0BN102
Q4, Q6, Q7: AO3401A; SOT-23; MPN AO3401A
Q5: BSS138; SOT-23; MPN BSS138
R57: 47k 1% 0.125W; R_0805_2012Metric; MPN RC0805FR-0747KL
R58, R59, R60, R61, R63: 100k 1%; R_0805_2012Metric; MPN RC0805FR-07100KL
R62, R67: 1M 1%; R_0805_2012Metric; MPN RC0805FR-071ML
R64: 1.2M 1%; R_0805_2012Metric; MPN RC0805FR-071M2L
R65: 10k 1%; R_0805_2012Metric; MPN RC0805FR-0710KL
R66, R68: 1k 1%; R_0805_2012Metric; MPN RC0805FR-071KL
R69: 30k 1%; R_0805_2012Metric; MPN RC0805FR-0730KL
R70: 150k 1%; R_0805_2012Metric; MPN RC0805FR-07150KL
TH1: 10k NTC 1% B3988; NTC_TDK_B57861S_Onboard_or_Remote_P2.54mm; MPN B57861S0103F040
U10: LM393XK; SOIC-8_3.9x4.9mm_P1.27mm; MPN LM393XK
U11: LM285Z-2.5G; TO-92_Inline; MPN LM285Z-2.5G

Connections:
CHG_CS_M: Q4.3 (D), Q6.3 (D), Q7.3 (D)
CHG_G_ENABLE: Q5.1 (G), R66.2, R67.1
CHG_G_SHUNT: Q4.1 (G), Q6.1 (G), Q7.1 (G), R58.2, R68.1
CHG_HYST_MID: R62.2, R70.1
CHG_PULLDOWN: Q5.3 (D), R68.2
CHG_TSENSE: C61.1, R59.2, TH1.1, U10.2 (-_A), U10.5 (+_B)
CHG_VREF: R57.2, R59.1, R60.1, R63.1, R64.1, U11.2 (K)
CHG_VSHORT: R64.2, R65.1, U10.6 (-_B)
CHG_VTH: R61.1, R69.2, R70.2, U10.3 (+_A)
CHG_VTH_UP: R60.2, R69.1
CHG_WARM: C62.1, R62.1, R63.2, R66.1, U10.1 (OUT_A), U10.7 (OUT_B)
CS_P: Q4.2 (S), Q6.2 (S), Q7.2 (S), R58.1
GND: C60.2, C61.2, C62.2, Q5.2 (S), R61.2, R65.2, R67.2, TH1.2, U10.4 (GND), U11.3 (A)
SOLAR: C60.1, R57.1, U10.8 (VCC)

Notes on the sheet:
R60 + R69 = 130k; R62 + R70 = 1,15M. Номинальные пороги: холод −17,4 °C; тепло −14,5 °C. OUT A и OUT B — соединённые открытые коллекторы. CHG_WARM высокий: Q5 включён, R56 обойдён. CHG_WARM низкий: Q5 выключен, R58 закрывает Q4/Q6/Q7.
Q4 / Q6 / Q7: S = до R56; D = после R56. R58 закрывает ключи при выключенном управлении.
SOT-23
RC0805FR-0730KL
Na-ion с опцией: установить весь узел, R56 = 1,8 Ом. LTO / без опции: R56 = 0 Ом, остальные 24 позиции не ставить. Основной R1 = 0,28 Ом остаётся во всех вариантах. Холод ≈ 96 мА; тепло ≈ 665 мА (зависит от RDS(on)).
CC0805JRNPO0BN102
0805
NTC ø2.41 / P2.54
07. Снижение тока на холоде / Na-ion / опция
RC0805FR-07100KL
RC0805FR-071KL
RC0805FR-071ML
AO3401A
TH1: B57861S0103F040; 10k, B25/100 = 3988 K, R/T 8016. Один NTC: на плате либо на проводах у аккумулятора. На плате измеряется температура под экраном. Обрыв или КЗ NTC → холодный ток.
LM393XK
RC0805FR-0710KL
BSS138
-t°
RC0805FR-07150KL
v1.26 / v2.10 / 2026-11-06 / инженерный прототип
RC0805FR-071M2L
B57861S0103F040
RC0805FR-0747KL
SOIC-8 / 3.9 mm
TO-92 / шаг 1.27 mm
CC0805KKX7R0BB104
LM285Z-2.5G
