Alksndr55/mesh-repeater/shared/schematic/Watchdog.kicad_sch

## KiCad design shared/schematic/Watchdog.kicad_sch (2026-11-06)

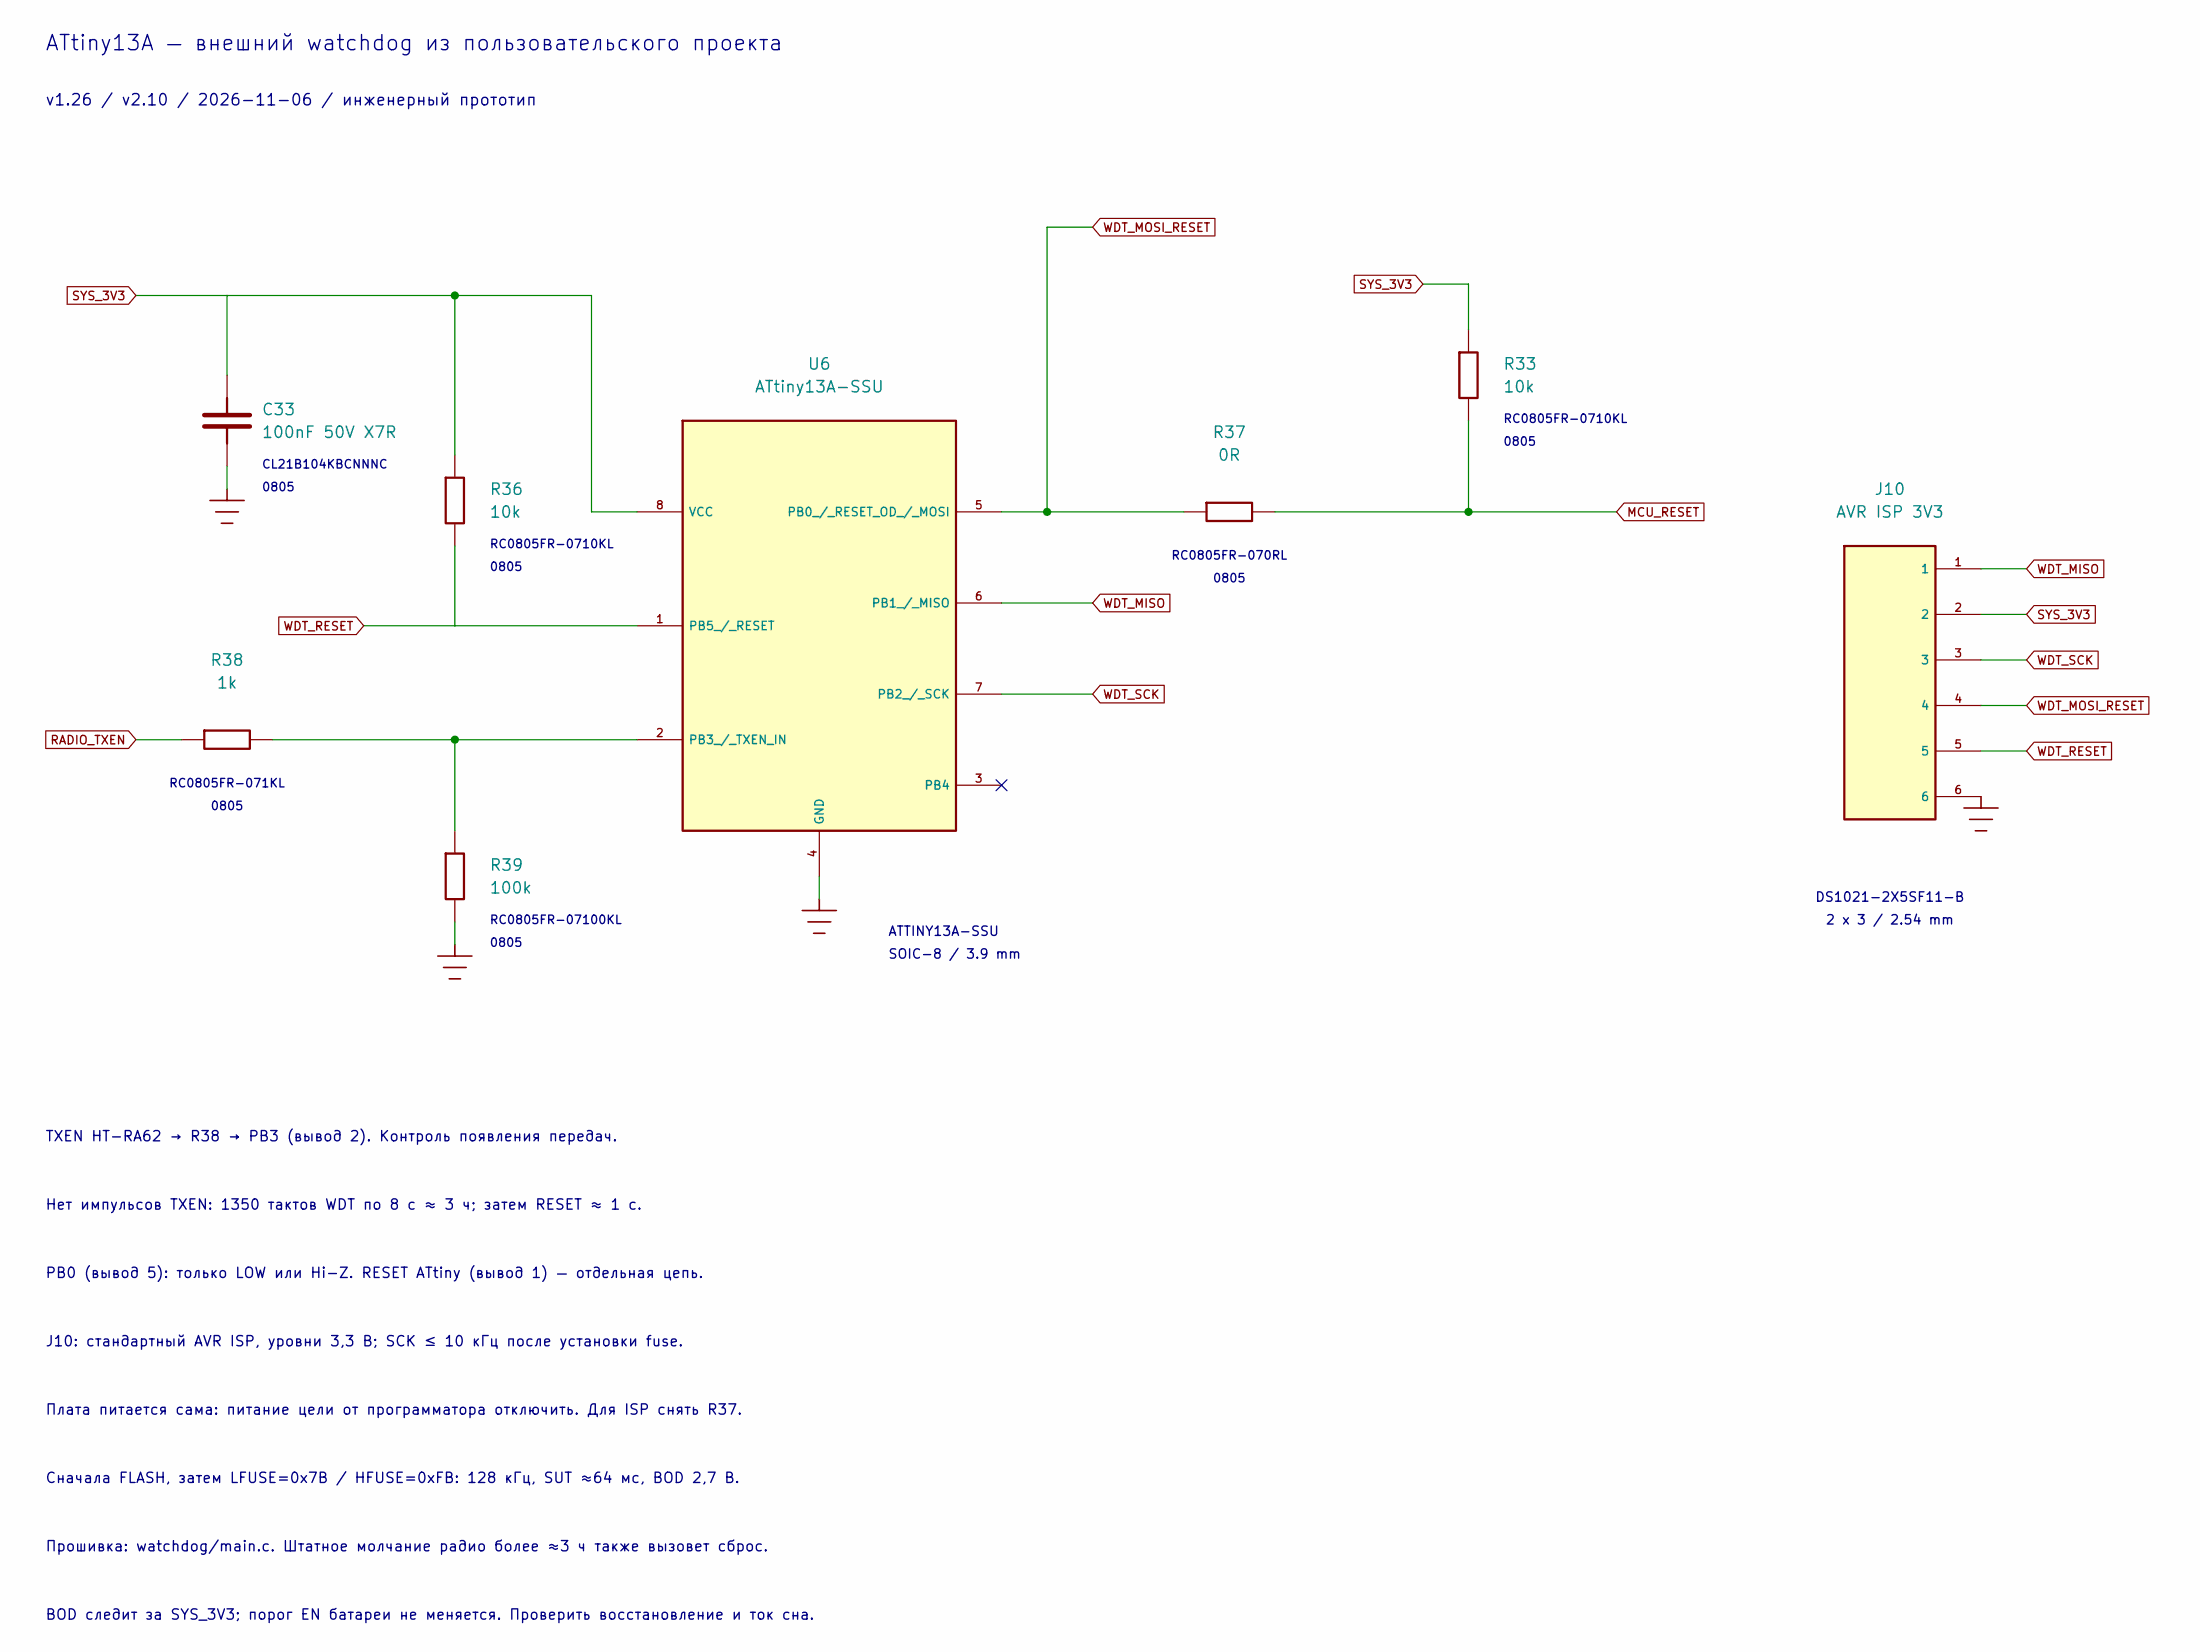
[picture p76: schematic Watchdog.kicad_sch]

Parts:
C33: 100nF 50V X7R; C_0805_2012Metric; MPN CL21B104KBCNNNC
J10: AVR ISP 3V3; PinHeader_2x03_P2.54mm_Vertical; MPN DS1021-2X5SF11-B
R33, R36: 10k; R_0805_2012Metric; MPN RC0805FR-0710KL
R37: 0R; R_0805_2012Metric; MPN RC0805FR-070RL
R38: 1k; R_0805_2012Metric; MPN RC0805FR-071KL
R39: 100k; R_0805_2012Metric; MPN RC0805FR-07100KL
U6: ATtiny13A-SSU; SOIC-8_3.9x4.9mm_P1.27mm; MPN ATTINY13A-SSU

Connections:
GND: C33.2, J10.6, R39.2, U6.4 (GND)
MCU_RESET: R33.2, R37.2
unnamed: R38.2, R39.1, U6.2 (PB3_/_TXEN_IN)
RADIO_TXEN: R38.1
SYS_3V3: C33.1, J10.2, R33.1, R36.1, U6.8 (VCC)
WDT_MISO: J10.1, U6.6 (PB1_/_MISO)
WDT_MOSI_RESET: J10.4, R37.1, U6.5 (PB0_/_RESET_OD_/_MOSI)
WDT_RESET: J10.5, R36.2, U6.1 (PB5_/_RESET)
WDT_SCK: J10.3, U6.7 (PB2_/_SCK)

Notes on the sheet:
PB0 (вывод 5): только LOW или Hi-Z. RESET ATtiny (вывод 1) — отдельная цепь.
ATtiny13A — внешний watchdog из пользовательского проекта
0805
RC0805FR-07100KL
Плата питается сама: питание цели от программатора отключить. Для ISP снять R37.
RC0805FR-070RL
SOIC-8 / 3.9 mm
TXEN HT-RA62 → R38 → PB3 (вывод 2). Контроль появления передач.
ATTINY13A-SSU
J10: стандартный AVR ISP, уровни 3,3 В; SCK ≤ 10 кГц после установки fuse.
DS1021-2X5SF11-B
BOD следит за SYS_3V3; порог EN батареи не меняется. Проверить восстановление и ток сна.
CL21B104KBCNNNC
RC0805FR-071KL
RC0805FR-0710KL
Сначала FLASH, затем LFUSE=0x7B / HFUSE=0xFB: 128 кГц, SUT ≈64 мс, BOD 2,7 В.
v1.26 / v2.10 / 2026-11-06 / инженерный прототип
2 x 3 / 2.54 mm
Прошивка: watchdog/main.c. Штатное молчание радио более ≈3 ч также вызовет сброс.
Нет импульсов TXEN: 1350 тактов WDT по 8 с ≈ 3 ч; затем RESET ≈ 1 с.
