Alksndr55/mesh-repeater/(commit log)

2026-10-10 Publish Mesh Repeater S4.12: editable KiCad project, 3D assets, BOM and audit proofs
2026-10-11 Publish Mesh Repeater S4.16: routing fixes, COLD option and readable board labels
    Update the editable KiCad project, seven-page schematic, portable footprints and 3D models, assembly variants, BOM, previews and independent CAD proofs. Preserve FakeTec GPIO compatibility. Manufacturing release remains paused.
2026-10-18 Publish S4.21 PCB and validated Rezonit manufacturing package
    Update the public project to the accepted single-board S4.21 design, keeping
    the user's manual routing improvements and removing SH1 and TP6.
    Include the full editable KiCad project and local assets, three assembly BOM
    variants, current assembly notes, eight-page schematic PDF, board views and
    a clean nine-file Gerber/Excellon ZIP for Rezonit.
    Validation: layout 29/29, power 14/14, CAM 59/59, publication integrity 18/18.
    The committed native board and manufacturing ZIP match the verified byte
    hashes. Preserve the existing licensing notices and watchdog source.
2026-10-18 License original contributions under CC BY-NC-SA 4.0
    Permit paid PCB fabrication for personal noncommercial assembly. Require prior written permission for commercial production and sales of original contributions; preserve third-party licenses and CAD/CAM bytes.
2026-10-24 Release v1.22: unified circuit and verified portable KiCad sources
2026-11-06 Release v1.26: assembly improvements, standardized parts and portable NexusBV
